psas/lv3.0-recovery/README.md

# lv3_recovery
Recovery system design and analysis.
