psas/lv3.0-recovery/LV3.1/RecoveryBoard/Recovery Board Review 1-12-2020 Notes.docx

- Drogue is nose coming off, main deploy main parachute
- Schematic symbol should always be rectangle to match the data sheet.
  - Change to more readable symbol
- Change capacitor to EU symbol (two plates), and change size
  - 0603 are big enough to use with tweezers
  - 0805 big enough for 10 uF
- Change 0603 for resistors as well. 2A at the most due to the P = I^2 *R
- Changed to double up leads for the battery to have two positives and two negatives.
- Absolute maximum input voltage for voltage divider into STM32F0 analog calculation.
- Change N-Channel MOSFET to the ground to achieve a positive GS difference
- Add connection called armed from outside world need new 7 pin.
- PullUp ~ACOK to 3.3V to check if charger is on umbilical power.
- Flip Diode Symbol in the optoisolator
- For a power supply, add a bypass cap at around 100nF for each power pin
- Add button and add ACOK.
