psas/lv3.0-recovery/Useful_Misc/Recovery_Patch.pdf

12/27/2018 | recoveryPatch.svg

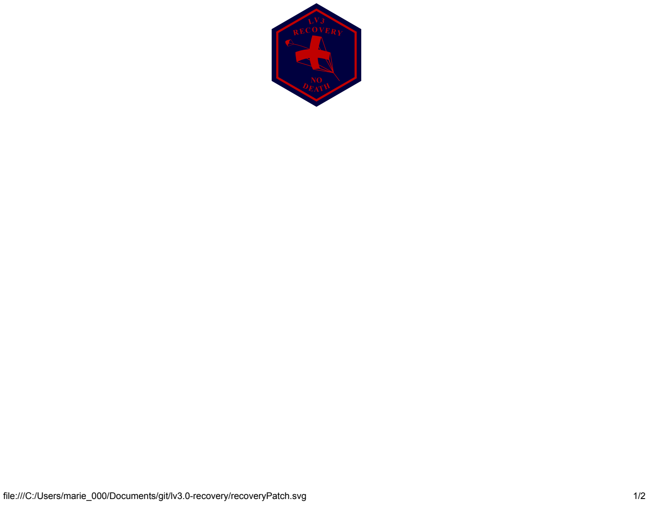
[picture p16: figure]
file:///C:/Users/marie_000/Documents/git/lv3.0-recovery/recoveryPatch.svg; LV3 RECOVERY; NO DEATH
