psas/lv3.0-recovery/Control_System/bldc-tool/res/refresh.png

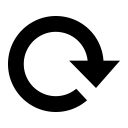
Control_System/bldc-tool/res/refresh.png
