psas/lv3.0-recovery/Initial_Designs/attachment_plate_design.jpg

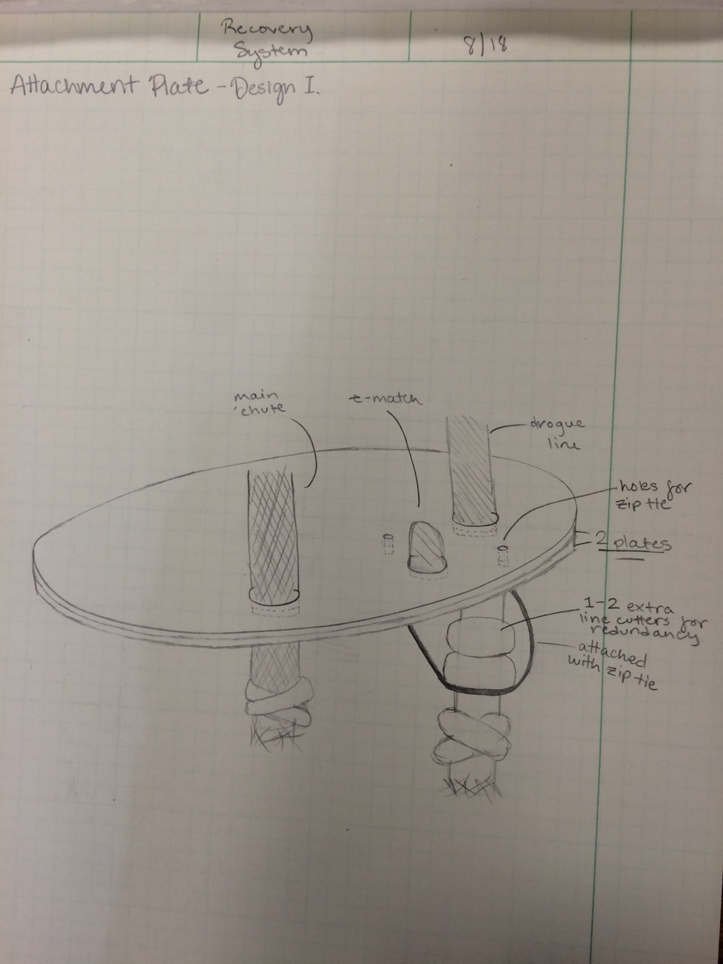
Initial_Designs/attachment_plate_design.jpg
