psas/lv3.0-recovery/Initial_Designs/initial_idea_given_info.jpg

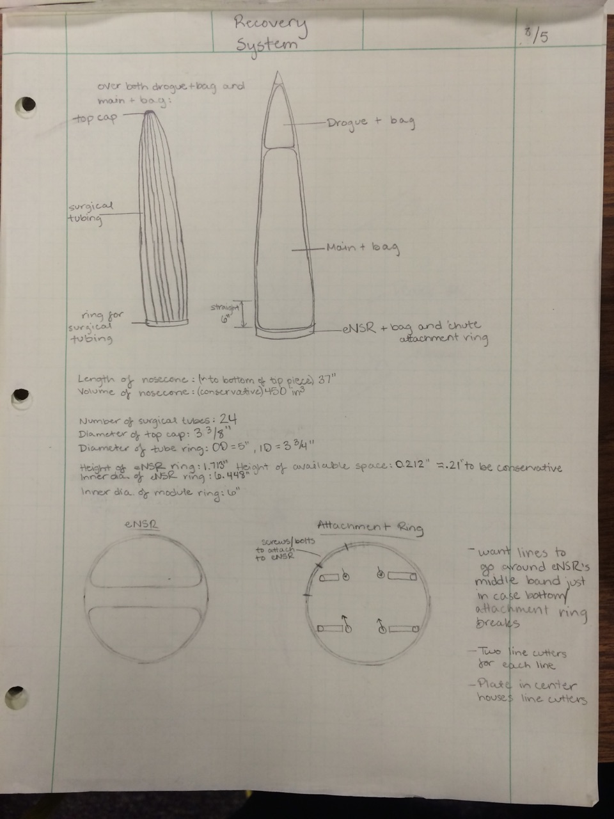
Initial_Designs/initial_idea_given_info.jpg
