psas/lv3.0-recovery/Initial_Designs/main_900.jpg

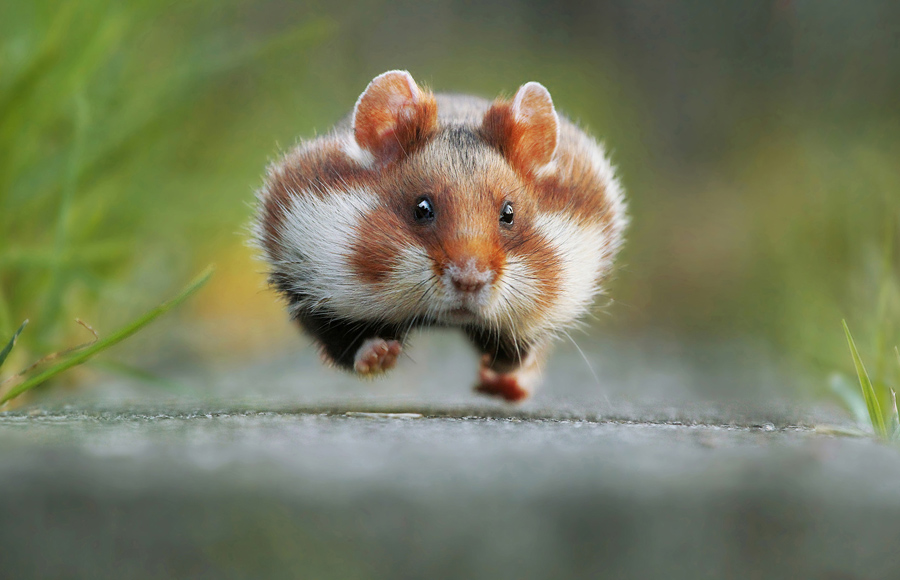
Initial_Designs/main_900.jpg
