psas/lv3.0-recovery/Line_Cutters/LV2c_Line_Cutters/LV2cLineCutters/PlugLineCutter-v2c.png

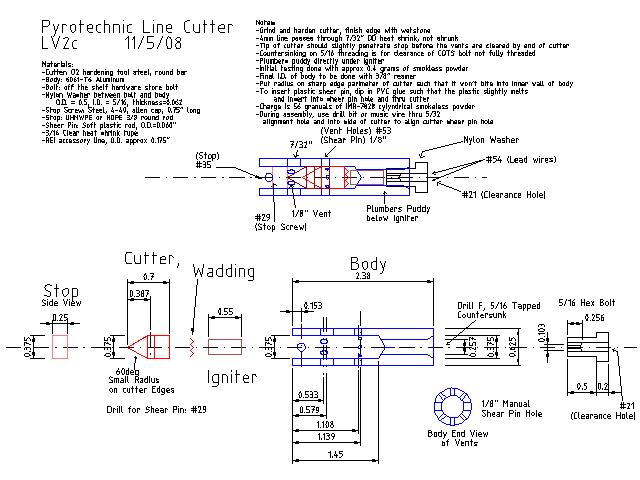
Line_Cutters/LV2c_Line_Cutters/LV2cLineCutters/PlugLineCutter-v2c.png
