psas/lv3.0-recovery/LV3.1/cad/Brainstorming/MH_Concepts/DCR_Concept1/Socket Wrench Plunger.png

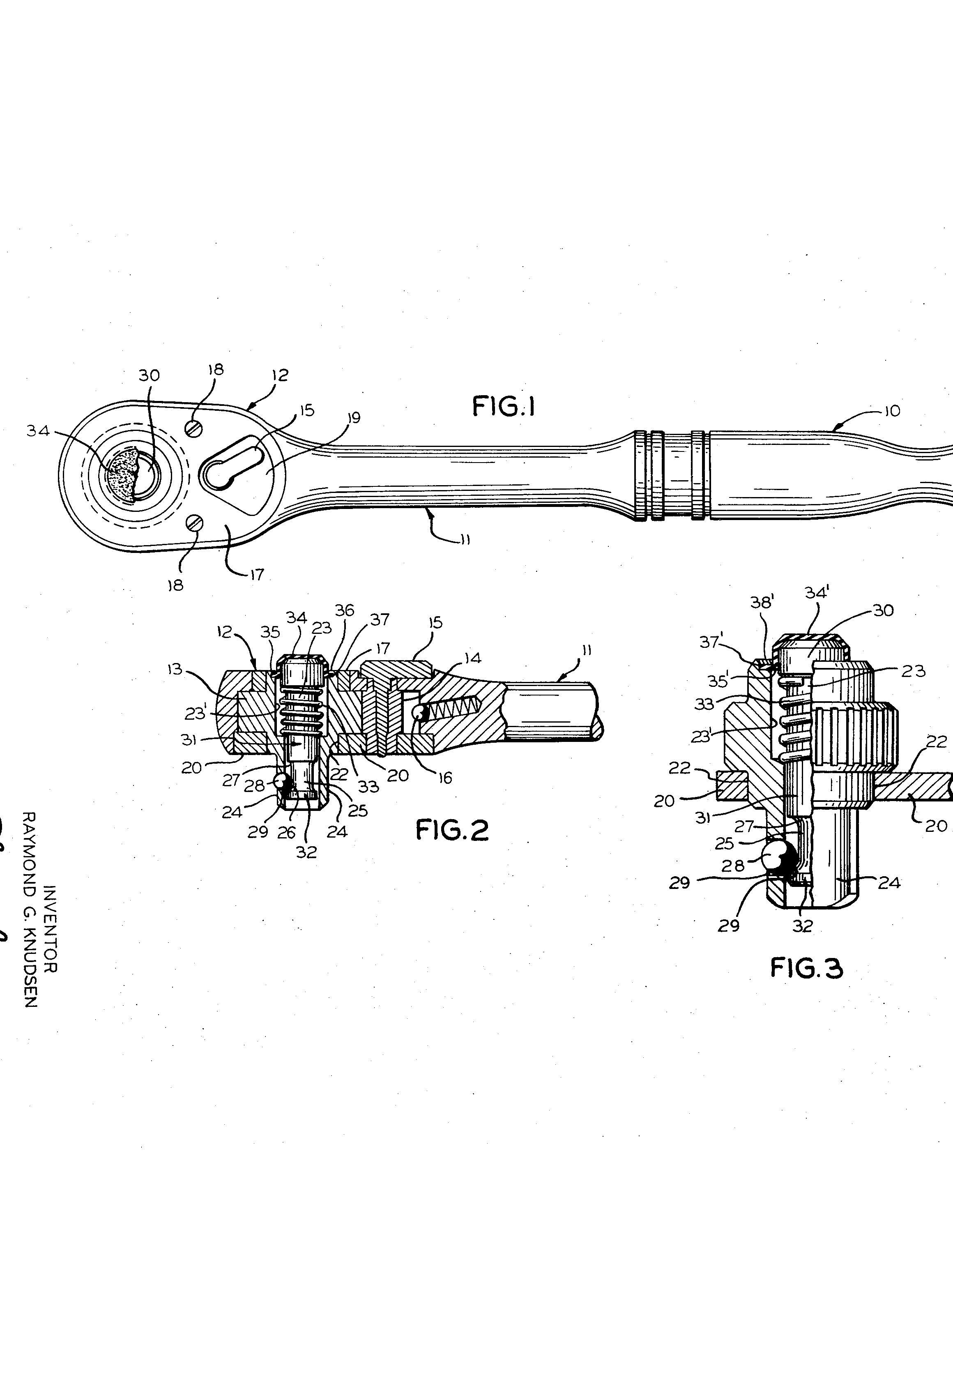
LV3.1/cad/Brainstorming/MH_Concepts/DCR_Concept1/Socket Wrench Plunger.png
