psas/lv3.0-recovery/LV3.1/DCR/Properties_tubular_webbing.png

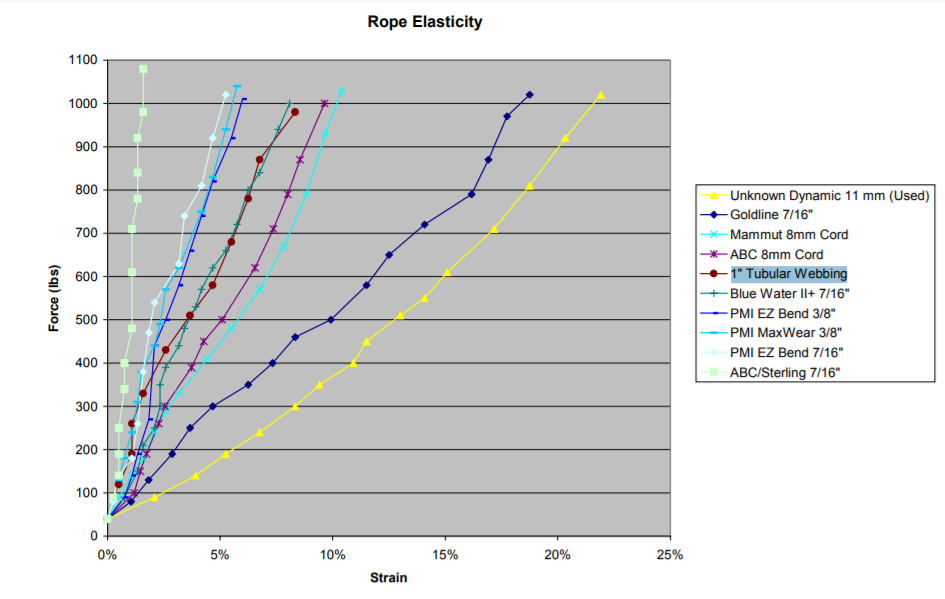
LV3.1/DCR/Properties_tubular_webbing.png
