psas/lv3.0-recovery/LV3.1/RecoveryBoard/eagle/RecoveryBoardRev1.0.png

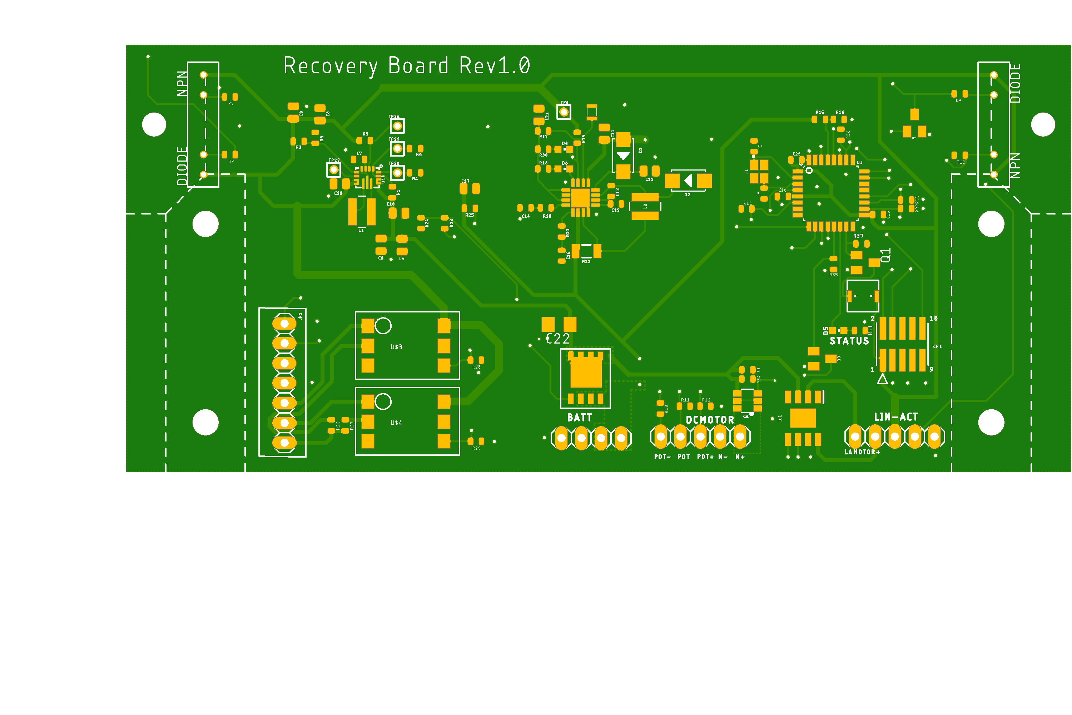
LV3.1/RecoveryBoard/eagle/RecoveryBoardRev1.0.png
