psas/lv3.0-recovery/LV3.1/RecoveryBoard/FirmWare/Recovery Board State Diagram-01.jpg

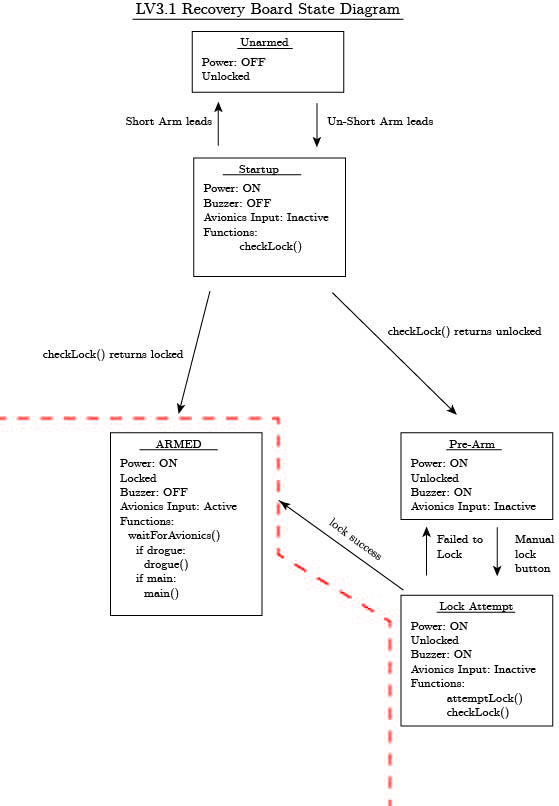
LV3.1/RecoveryBoard/FirmWare/Recovery Board State Diagram-01.jpg
