psas/lv3.0-recovery/Useful_Misc/PSAS_nosecone_volume_conservative.JPG

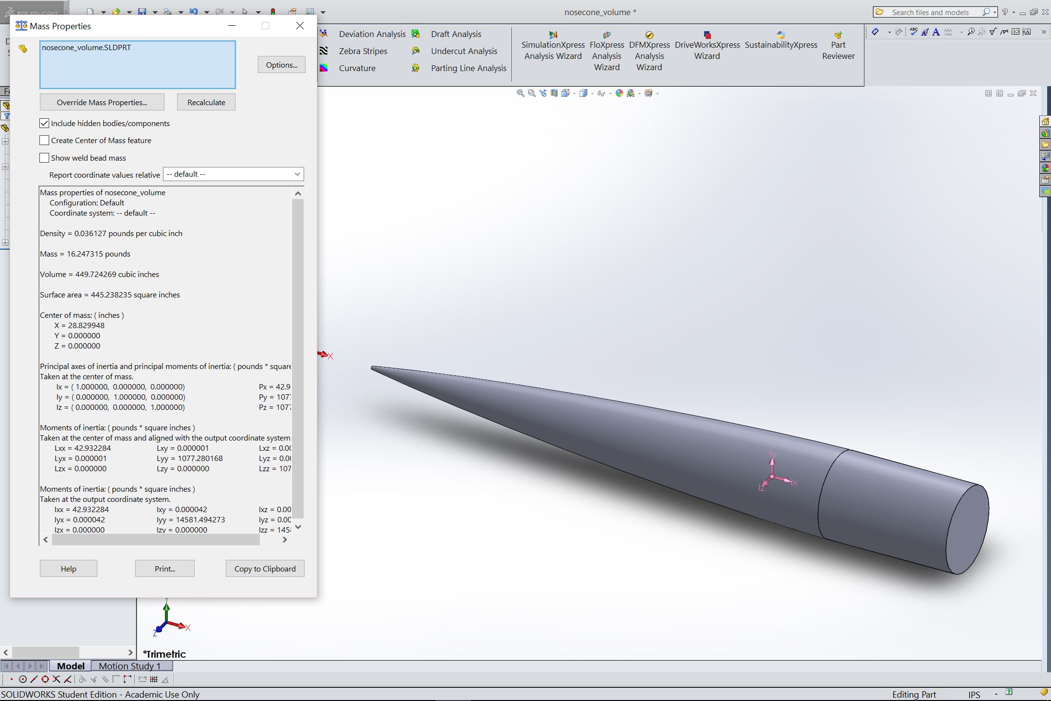
Useful_Misc/PSAS_nosecone_volume_conservative.JPG
