psas/lv3.0-recovery/LV3.1/RecoveryBoard/RecoveryBoard-BOM.xlsx

Qty | Value | Device | Package | Parts | Description | DIS | DPN | MFR | MPN
1 | 1.5uH | IHLP2020CZER1R5M11 | IHLP2020CZER1R5M11 | L1 |  | Digi-Key | 541-1235-1-ND | Vishay Dale | IHLP2020CZER1R5M11
1 |  | PINHD-1X3 | 1X03 | JP3 | PIN HEADER
1 |  | PINHD-1X4 | 1X04 | JP1 | PIN HEADER
1 |  | PINHD-1X7 | 1X07 | JP2 | PIN HEADER
1 | 1.69k | R-US_0603-C-NOSILK | .0603-C-NOSILK | R13 | RESISTOR, American symbol | Digi-Key | P1.69KHCT-ND | Panasonic | ERJ-3EKF1691V
1 | 100k | R-US_0603-C-NOSILK | .0603-C-NOSILK | R5 | RESISTOR, American symbol | Digi-Key | YAG1235CT-ND | Yageo | RT0603BRD07100KL
1 | 100m | R-US_1206-C | 1206-C | R22 | RESISTOR, American symbol | Digi-Key | CSR1206FTR100CT-ND | StackPole Electronics Inc | CSR1206FTR100
1 | 100n | C-EU0603-C-NOSILK | .0603-C-NOSILK | C7 | CAPACITOR, European symbol | Digi-Key | 1276-1258-6-ND | Samsung | CL10F104ZO8NNNC
1 | 100n | C-EU0603-C-NOSILK | .0603-C-NOSILK | C22 | CAPACITOR, European symbol | Digi-Key | 1276-1258-6-ND | Samsung | CL10F104ZO8NNNC
1 | 10u | C-EU0805-C-NOSILK | .0805-C-NOSILK | C5 | CAPACITOR, European symbol | Digi-Key | 399-4925-6-ND | KEMET | C0805C106K8PACTU
1 | 150k | R-US_0603-C-NOSILK | .0603-C-NOSILK | R3 | RESISTOR, American symbol | Digi-Key | A129714CT-ND | TE Connectivity Passive Product | CRGCQ0603F150K
1 | 2.2n | C-EU0603-C-NOSILK | .0603-C-NOSILK | C16 | CAPACITOR, European symbol | Digi-Key | 399-17586-1-ND | KEMET | C0603C222K5RAC7411
1 | 2.4k | R-US_0603-C-NOSILK | .0603-C-NOSILK | R20 | RESISTOR, American symbol | Digi-Key | P20013CT-ND | Panasonic | ERJ-PB3B2401V
1 | 22u | C-EU0805-C-NOSILK | .0805-C-NOSILK | C8 | CAPACITOR, European symbol | Digi-Key | 399-4696-2-ND | KEMET | C0805C226M9PACTU
1 | 22uF | C-EU0805-C-NOSILK | .0805-C-NOSILK | C17 | CAPACITOR, European symbol | Digi-Key | 399-4696-2-ND | KEMET | C0805C226M9PACTU
1 | 26.4k | R-US_0603-C-NOSILK | .0603-C-NOSILK | R15 | RESISTOR, American symbol | Digi-Key | 311-2092-1-ND | Yageo | RT0603DRE0726K4L
1 | 3.3k | R-US_0603-C-NOSILK | .0603-C-NOSILK | R14 | RESISTOR, American symbol | Digi-Key | A130094CT-ND | TE Connectivity Passive Product | CRGCQ0603J3K3
1 | 4.7uH | IHLP2020BZER4R7M11 | IHLP2020BZER4R7M11 | L2 |  | Digi-Key | 541-1222-1-ND | Vishay Dale | IHLP2020BZER4R7M11
1 | 470k | R-US_0805-C-NOSILK | .0805-C-NOSILK | R2 | RESISTOR, American symbol | Digi-Key | RHM470KBUCT-ND | Rohm SemiConductor | LTR10EZPJ474
1 | 750 | R-US_0603-C-NOSILK | .0603-C-NOSILK | R21 | RESISTOR, American symbol | Digi-Key | RHM750DCT-ND | Rohm SemiConductor | ESR03EZPJ751
1 | BD62120AEFJ-E2 | BD62120AEFJ-E2 | SOIC127P600X100-9N | U2 | ROHM BD62120AEFJ-E2 Motor Driver IC 8-Pin, HTSOP-J | Digi-Key | BD62120AEFJ-E2CT-ND | Rohm SemiConductor | BD62120AEFJ-E2
1 | ECS-160-10-36Q-ES-TR | ECS-160-10-36Q-ES-TR | XTAL_ECS-160-10-36Q-ES-TR | Y1 | The ECX-2236Q is a miniature SMD Crystal with a 2.5 x 2.0 mm | Digi-Key | XC2181CT-ND | ECS Inc. | ECS-160-10-36Q-ES-TR
1 | FTSH-105-XX-X-DV-K | FTSH-105-XX-X-DV-K | CON10_2X5_DUK_FTSH | CM1 | JTAG Connector | Digi-Key | SAM13164CT-ND | Samtec Inc. | FTSH-105-01-L-DV-K-P-TR
1 | MOSFET-PCH-SOT23-6 | MOSFET-PCH-SOT23-6 | SOT23-6 | Q6 | P channel MOSFET in an SOT23-6 | Digi-Key | 497-15521-2-ND | STMicroelectronics | STT4P3LLH6
1 | MP26123DR-LF-Z | MP26123DR-LF-Z | MP26123DR-LF-Z | U$5 | LiPo Charger | Digi-Key | 1589-1609-1-ND | Monolithic Power Systems Inc. | MP26123DR-LF-Z
1 | NHQ103B375T10 | NHQ103B375T10 | NHQ103B375T10 | U$6 | Thermistor | Digi-Key | 235-1109-1-ND | Amphenol Advanced Sensors | NHQ103B375T10
1 | SI7465DP | SI7465DP | SI7465DP | U$8 | Power MOSFET PCh | Digi-Key | SI7465DP-T1-E3CT-ND | Vishay Siliconix | SI7465DP-T1-E3
1 | SML-D12U1WT86 | LEDCHIPLED_0603 | CHIPLED_0603 | D5 | LED | Digi-key | SML-D12U1WT86CT-ND | Rohm SemiConductor | SML-D12U1WT86
1 | SMT-0440-S-R | SMT-0440-S-R | SMT-0440-S-R | U$7 | Buzzer | Digi-Key | 668-1488-1-ND | PUI Audio Inc. | SMT-0440-S-R
1 | STM32F042K6 | STM32F042K6 | QFP32-7X7 | U1 | MCU | Digi-Key | 497-14647-ND | STMicroelectronics | STM32F042K6T6
1 | TPS63070 | TPS63070X | TPS63070X | U10 | TPS63070 2-V to 16-V Buck-Boost Converter With 3.6-A Switch Current | Digi-Key | 296-TPS630702RNMTCT-ND | Texas Instruments | TPS630702RNMT
2 |  | PINHD-1X5 | 1X05 | J1, J2 | PIN HEADER
2 | 1N4007 | DIODE-SCHOTTKY-(DO-214AC) | DO-214AC | D1, D2 | 304010013 | Digi-Key | S1M-FDITR-ND | Diodes Incorporated | S1M-13-F
2 | 20p | C-EU0603-C-NOSILK | .0603-C-NOSILK | C3, C4 | CAPACITOR, European symbol | Digi-Key | 399-8033-2-ND | KEMET | C0805C200J5GACTU
2 | 22u | C-EU0805-C-NOSILK | .0805-C-NOSILK | C9, C28 | CAPACITOR, European symbol | Digi-Key | 399-4696-2-ND | KEMET | C0805C226M9PACTU
2 | 442 | R-US_0603-C-NOSILK | .0603-C-NOSILK | R8, R9 | RESISTOR, American symbol | Digi-Key | 311-442HRCT-ND | Yageo | RC0603FR-07442RL
2 | 51.1 | R-US_0603-C-NOSILK | .0603-C-NOSILK | R26, R27 | RESISTOR, American symbol | Digi-Key | 311-51.1HRTR-ND | Yageo | RC0603FR-0751R1L
2 | BPR-301 | BPR-301 | BPR-301 | Q4, Q5 | Phototransistors | Digi-Key | BPR-301-ND | American Bright Optoelectronics Corporation | BPR-301
2 | H11F1SR2M | H11F1SR2M | H11F1SR2M | U$3, U$4 | OptoIsolators | Digi-Key | H11F1SR2MCT-ND | ON Semiconductor | H11F1SR2M
1 | NP | R-US_0603-C-NOSILK | .0603-C-NOSILK | R6 | RESISTOR, American symbol
2 | SML-D12U1WT86 | LEDCHIPLED_0603 | CHIPLED_0603 | D3, D6 | LED | Digi-Key | SML-D12U1WT86CT-ND | Rohm SemiConductor | SML-D12U1WT86
3 | 10k | R-US_0603-C-NOSILK | .0603-C-NOSILK | R1, R4, R16 | RESISTOR, American symbol | Digi-Key | 311-10KGRCT-ND | Yageo | RC0603JR-0710KL
3 | BSS123 | BSS123 | SOT23 | Q1, Q2, Q3 | N-CHANNEL MOS FET | Digi-Key | BSS123NCT-ND | ON Semiconductor | BSS123
5 | 10u | C-EU0805-C-NOSILK | .0805-C-NOSILK | C6, C10, C11, C12, C21 | CAPACITOR, European symbol | Digi-Key | 399-4925-6-ND | KEMET | C0805C106K8PACTU
7 | 100n | C-EU0603-C-NOSILK | .0603-C-NOSILK | C1, C13, C14, C15, C18, C19, C20 | CAPACITOR, European symbol | Digi-Key | 1276-1258-6-ND | Samsung | CL10F104ZO8NNNC
7 | 1k | R-US_0603-C-NOSILK | .0603-C-NOSILK | R11, R12, R18, R23, R25, R30, R31 | RESISTOR, American symbol | Digi-Key | 311-1.0KGRCT-ND | Yageo | RC0603JR-071KL
9 | TEST-POINT | TEST-POINT | 2MM-TEST-POINT | TP1, TP2, TP3, TP4, TP6, TP26, TP27, TP28, TP29 | Test Points
13 | 10k | R-US_0603-C-NOSILK | .0603-C-NOSILK | R7, R10, R17, R19, R24, R28, R29, R32, R33, R34, R35, R36, R37 | RESISTOR, American symbol | Digi-Key | 311-10KGRCT-ND | Yageo | RC0603JR-0710KL
 | REVISIONS | REV DESCRIPTION
