psas/lv3.0-recovery/LV3.1/cad/AssemblyV3.2/keeper_assy_V3.SLDASM

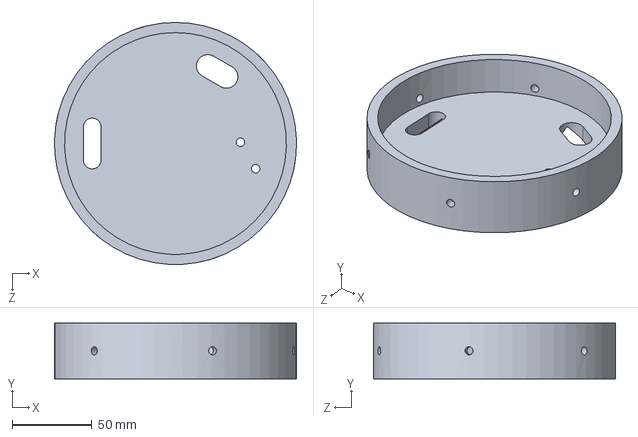
[picture p27: CAD file, 2019-12-07]
LV3.1/cad/AssemblyV3.2/keeper_assy_V3.SLDASM
151.3 x 34.9 x 151.4 mm
