psas/lv3.0-recovery/LV3.1/cad/Base_11_mockup/nose.SLDASM

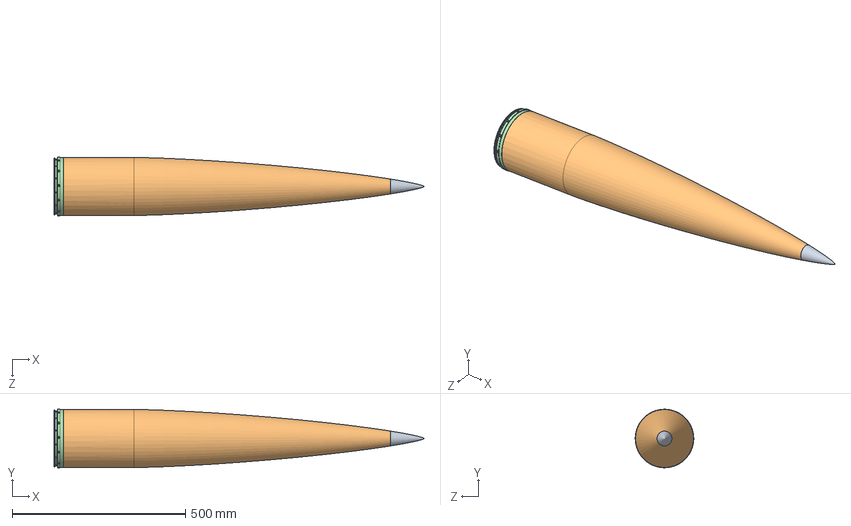
[picture p28: CAD file, 2019-04-27]
LV3.1/cad/Base_11_mockup/nose.SLDASM
1067.2 x 168.9 x 168.9 mm
von_karmon_nose_tip2
noseconeShell
nosePlug2
moduleRing
