psas/lv3.0-recovery/LV3.1/cad/Brainstorming/GG_Concept1/Assem1.SLDASM

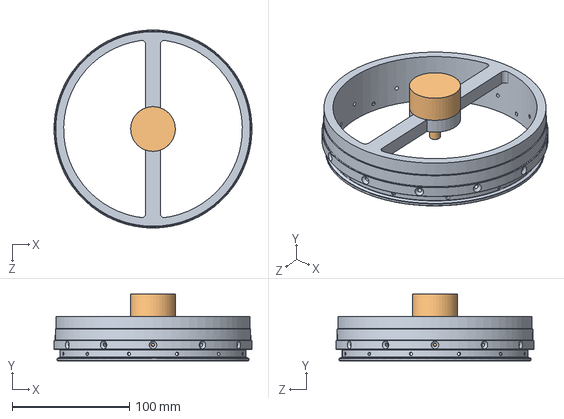
[picture p29: CAD file, 2019-02-19]
LV3.1/cad/Brainstorming/GG_Concept1/Assem1.SLDASM
168.9 x 56.7 x 168.9 mm
Concept_Upper
pretend_motor
