psas/lv3.0-recovery/LV3.1/cad/Brainstorming/GG_Concept2/Concept_Assem_2.SLDASM

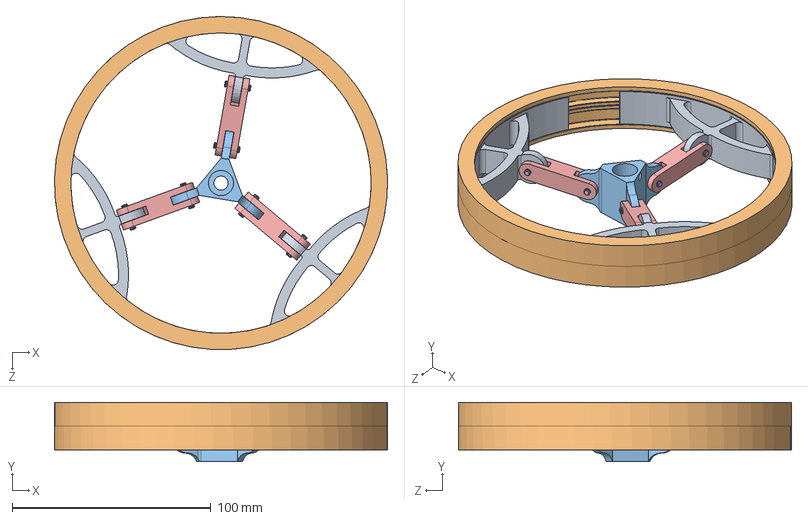
[picture p30: CAD file, 2019-02-19]
LV3.1/cad/Brainstorming/GG_Concept2/Concept_Assem_2.SLDASM
167.6 x 29.9 x 167.6 mm
Clamp_Ring_Concept x 3
Ring_Concept x 2
Carriage
Bearing_RMA x 6
Linkage x 3
Dowell_Pin_1 x 6
