psas/lv3.0-recovery/LV3.1/cad/Brainstorming/GW_Concepts/proto_assemb.SLDASM

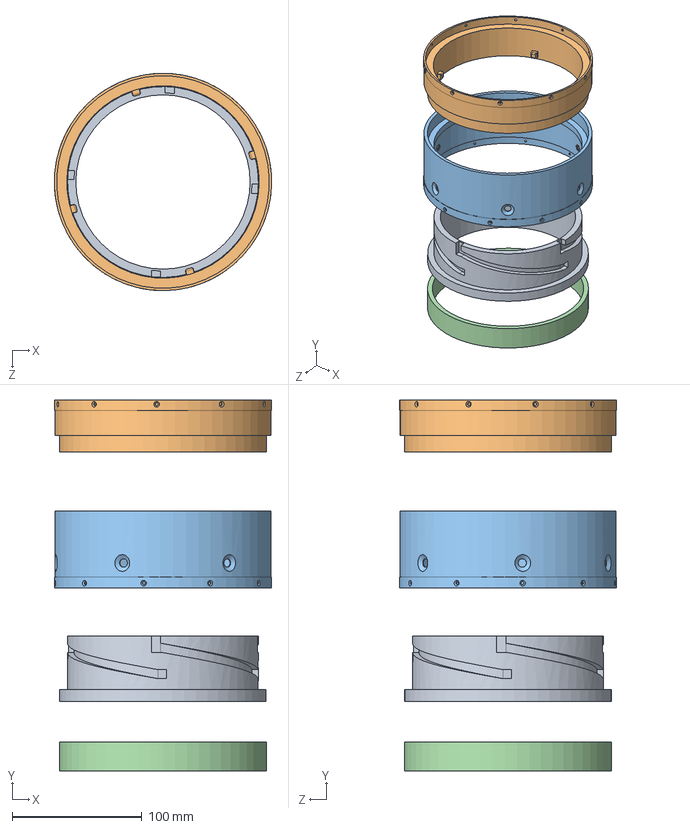
[picture p31: CAD file, 2019-04-04]
LV3.1/cad/Brainstorming/GW_Concepts/proto_assemb.SLDASM
167.6 x 286.1 x 167.6 mm
twist_coupling
Bottom_ring
Top_ring
kepper ring
