psas/lv3.0-recovery/LV3.1/cad/Brainstorming/ST_CAP/ST_CAP_ASSEMBLY.SLDASM

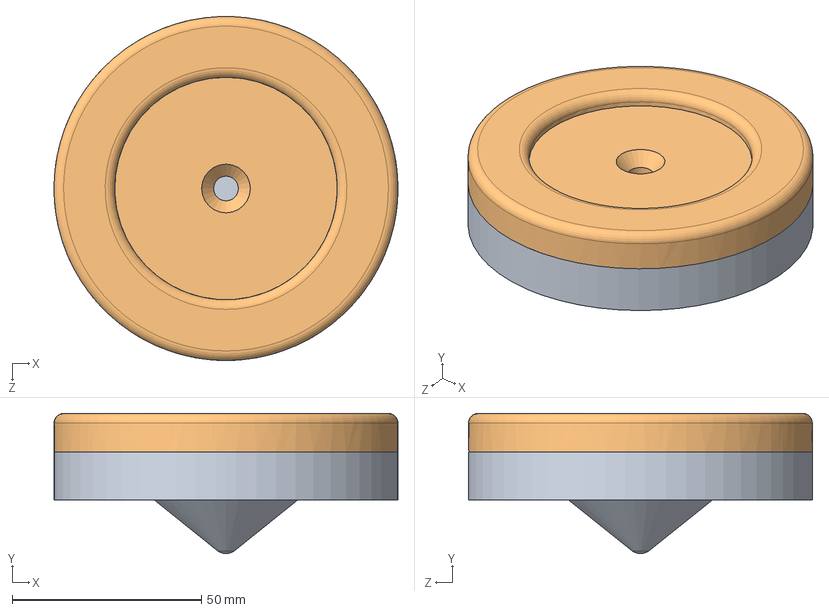
[picture p32: CAD file, 2019-05-19]
LV3.1/cad/Brainstorming/ST_CAP/ST_CAP_ASSEMBLY.SLDASM
90.9 x 37.0 x 90.9 mm
ST_Bottom
ST_Cap
