psas/lv3.0-recovery/LV3.1/cad/Parachute_Cups/ERS_Parachute_System/Cylinder_Chute_Main^ERS_v3.0.SLDPRT

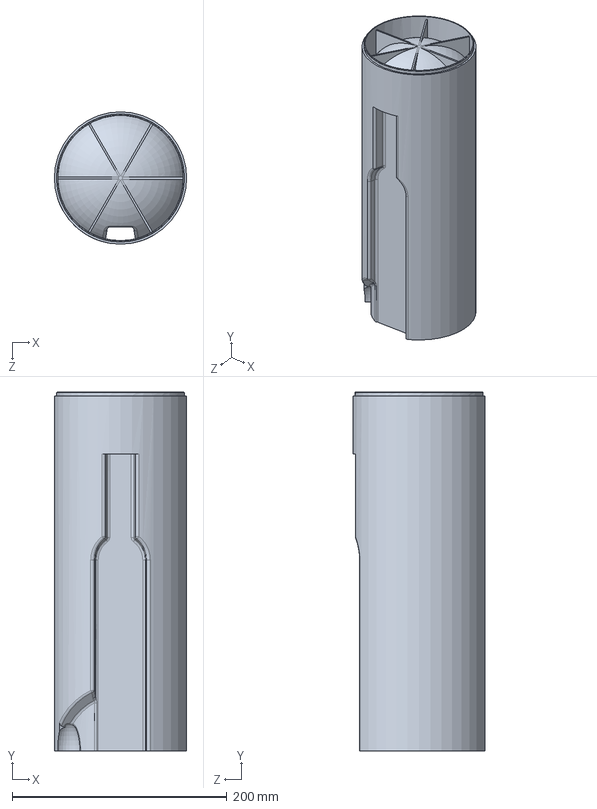
[picture p33: CAD file, 2019-08-06]
LV3.1/cad/Parachute_Cups/ERS_Parachute_System/Cylinder_Chute_Main^ERS_v3.0.SLDPRT
123.2 x 334.0 x 123.2 mm
