psas/lv3.0-recovery/LV3.1/cad/AssemblyV3.2/Assem3.2rev1.SLDASM

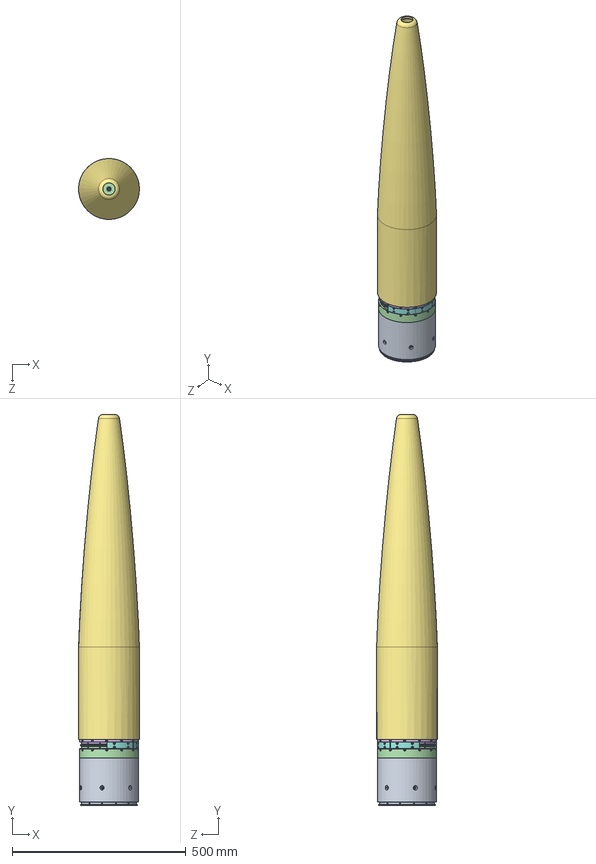
[picture p34: CAD file, 2019-12-07]
LV3.1/cad/AssemblyV3.2/Assem3.2rev1.SLDASM
175.3 x 1124.8 x 175.1 mm
keeper_ring_V3
clampArc x 3
battery
H3860S_NO3_Ring
H3880S_NO4_Ring
webbing_small_V1
yellow_cord_V1.1
nylon_loop_V1
webbing_grommet_V1
grommet_V1
yellow_cord_guide x 2
H3840B_NO2_Ring
yellow_cord_short
yellow_twist
MotorHousingClamshellrev1
MotorHousingMain_rev1
BLDC_Gear_Motor_100rpm
PIZZA_v4.2
twist_coupling_V4_skirt_teeth
pcb
sensor x 2
2662N400_PLASTIC GEAR - 20 DEGREE PRESSURE ANGLE
