psas/lv3.0-recovery/LV3.1/cad/Base_11_mockup/Current_NCSR.SLDASM

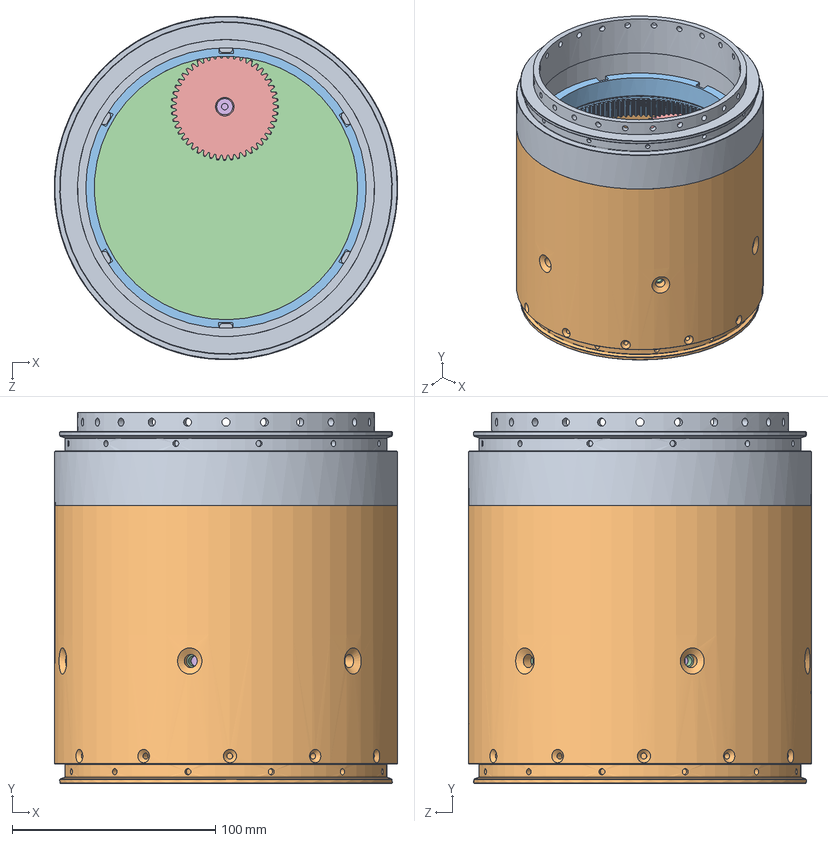
[picture p35: CAD file, 2019-04-05]
LV3.1/cad/Base_11_mockup/Current_NCSR.SLDASM
168.9 x 182.5 x 168.9 mm
Bottom_ring
Top_ring
twist_coupling
kepper ring
7880K450_HT-LOAD MTL GEAR--20 DEG PRESSURE ANGLE
Motor1_small
