psas/lv3.0-recovery/LV3.1/cad/Brainstorming/GG_Concept1/Concept_Ring.SLDASM

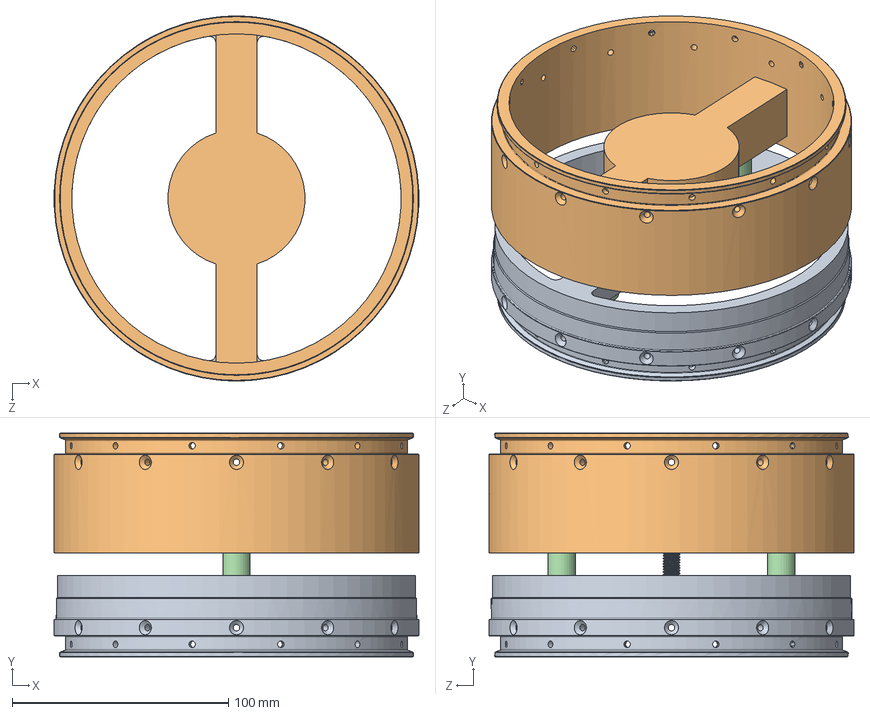
[picture p36: CAD file, 2019-02-19]
LV3.1/cad/Brainstorming/GG_Concept1/Concept_Ring.SLDASM
168.9 x 103.5 x 168.9 mm
Concept_Upper
Concept_Lower
pretend_motor
Alignment_Pins x 2
