psas/lv3.0-recovery/LV3.1/cad/Brainstorming/GG_WIP/Upper_Ring_Carriage_Clamps.SLDASM

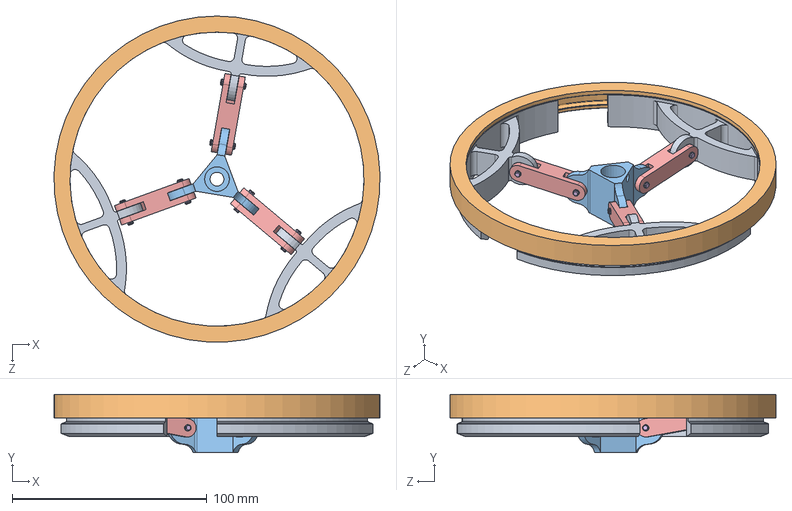
[picture p37: CAD file, 2019-02-19]
LV3.1/cad/Brainstorming/GG_WIP/Upper_Ring_Carriage_Clamps.SLDASM
167.6 x 29.9 x 167.5 mm
Clamp_Ring_Concept x 3
Ring_Concept
Carriage
Bearing_RMA x 6
Linkage x 3
Dowell_Pin_1 x 6
