psas/lv3.0-recovery/LV3.1/cad/Brainstorming/MH_Concepts/DCR_Concept2/Thesis1_assy.SLDASM

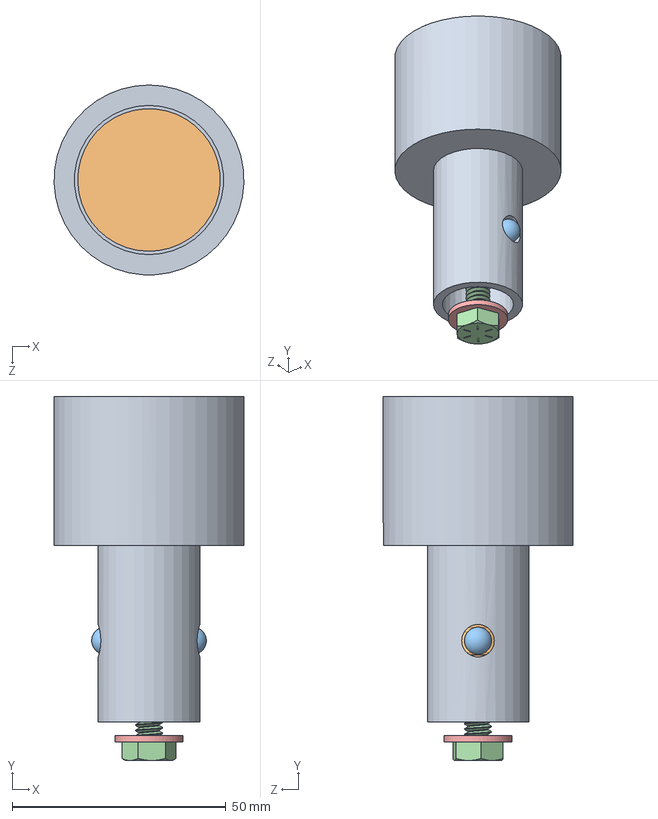
[picture p38: CAD file, 2019-02-26]
LV3.1/cad/Brainstorming/MH_Concepts/DCR_Concept2/Thesis1_assy.SLDASM
44.4 x 85.2 x 44.5 mm
Thesis1_housing
Thesis1_plunger
ball_bearing_.25 x 2
92620A540_HIGH-STRENGTH GRADE 8 STEEL CAP SCREW
92141A029_TYPE 18-8 STAINLESS STEEL FLAT WASHER
