psas/lv3.0-recovery/LV3.1/cad/Brainstorming/MH_Concepts/SMA_Protos/Proto1.SLDASM

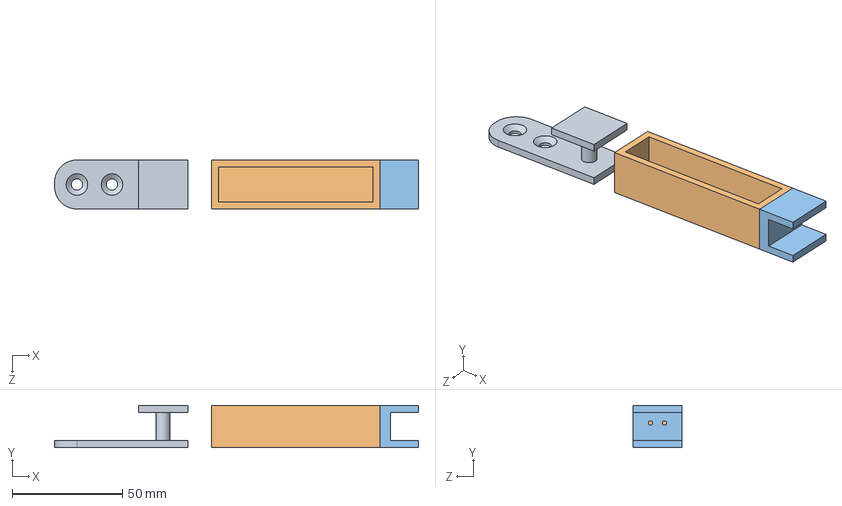
[picture p39: CAD file, 2019-02-19]
LV3.1/cad/Brainstorming/MH_Concepts/SMA_Protos/Proto1.SLDASM
164.8 x 19.1 x 22.2 mm
Proto1_anchor
Proto1_base
Proto1_clip
