psas/lv3.0-recovery/LV3.1/cad/circuitboard/pcbassy.SLDASM

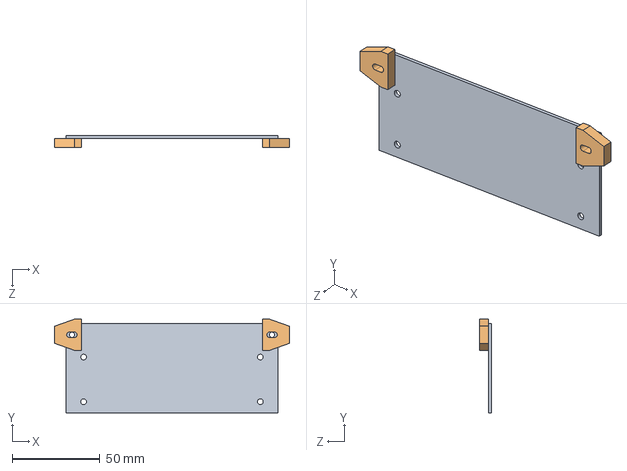
[picture p40: CAD file, 2019-12-07]
LV3.1/cad/circuitboard/pcbassy.SLDASM
133.7 x 53.4 x 6.60 mm
pcb
sensor x 2
