psas/lv3.0-recovery/LV3.1/cad/for3dprinting/STEPfiles/MotorHousingMain.STEP

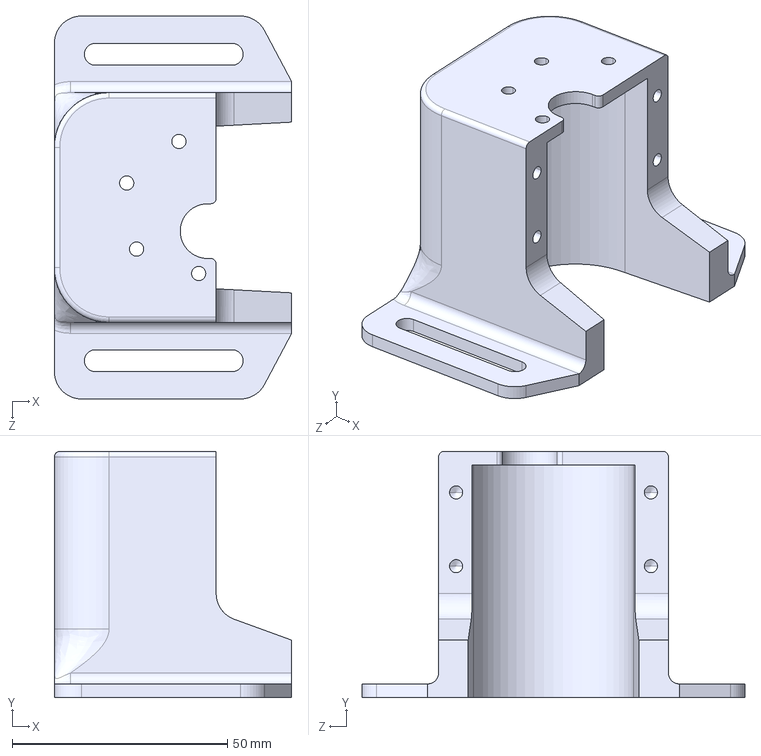
[picture p41: CAD file, 2019-11-19]
LV3.1/cad/for3dprinting/STEPfiles/MotorHousingMain.STEP
55.1 x 57.1 x 88.9 mm
