psas/lv3.0-recovery/LV3.1/cad/Brainstorming/GG_WIP/Complete_Assembly.SLDASM

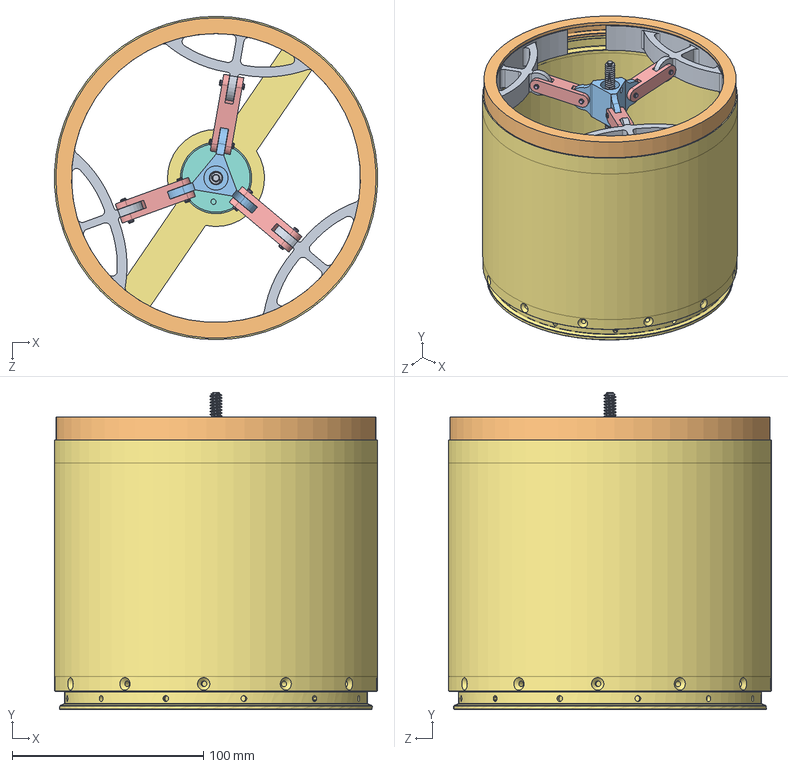
[picture p42: CAD file, 2019-02-19]
LV3.1/cad/Brainstorming/GG_WIP/Complete_Assembly.SLDASM
169.0 x 166.0 x 169.2 mm
Clamp_Ring_Concept x 3
Carriage
Bearing_RMA x 6
Linkage x 3
Dowell_Pin_1 x 6
Lower_Ring
Motor1_small
ACME_Screw
0.125_0.5_Coupler
97705A142 x 2
