psas/lv3.0-recovery/LV3.1/cad/Brainstorming/GW_Concepts/proto for capstone.SLDASM

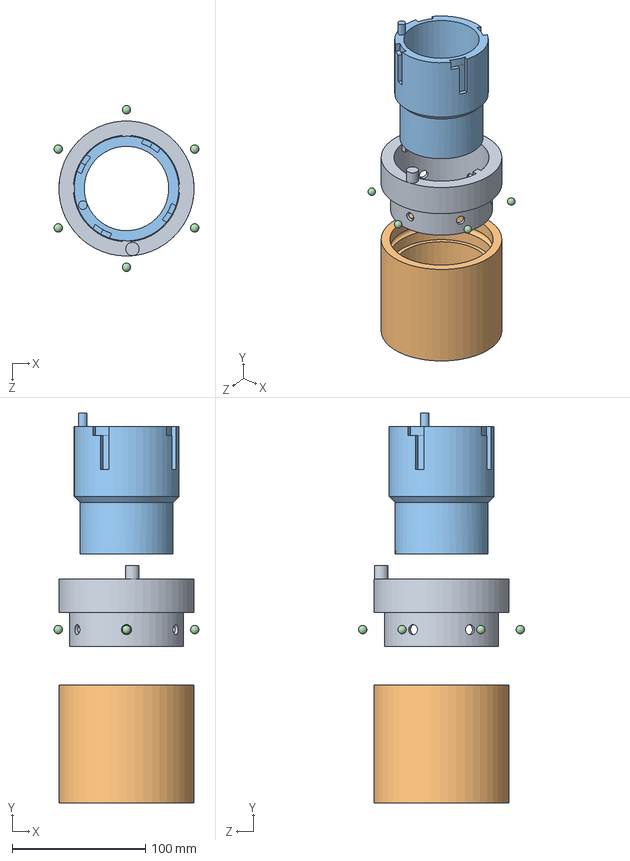
[picture p43: CAD file, 2019-04-04]
LV3.1/cad/Brainstorming/GW_Concepts/proto for capstone.SLDASM
109.0 x 293.2 x 124.8 mm
inner ring Rocket Shute deployment
outer ring rocket shute deployment
keeper ring2
ball baring x 6
