psas/lv3.0-recovery/LV3.1/cad/Brainstorming/MH_Concepts/DCR_Concept1/Thesis0_assy.SLDASM

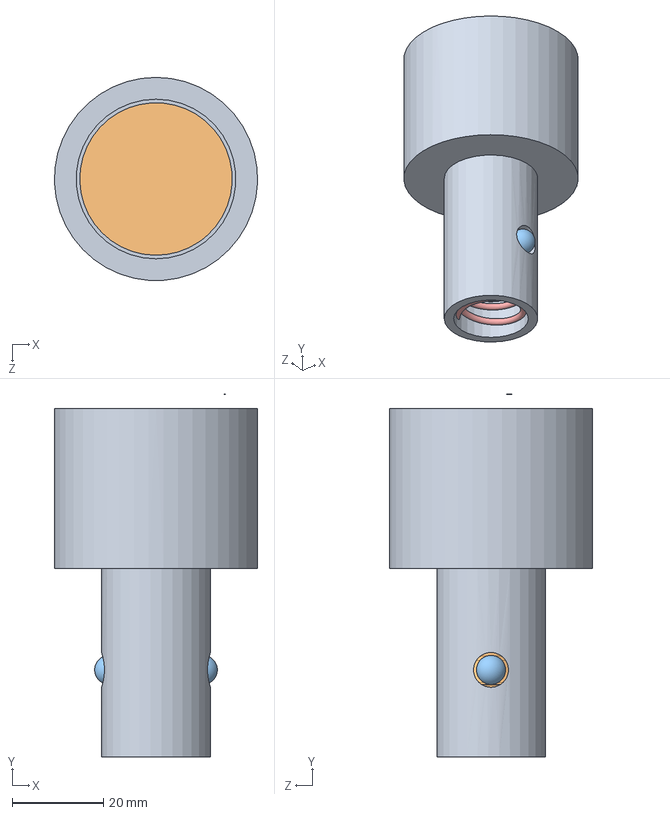
[picture p44: CAD file, 2019-03-17]
LV3.1/cad/Brainstorming/MH_Concepts/DCR_Concept1/Thesis0_assy.SLDASM
44.4 x 79.4 x 44.5 mm
Thesis1_housing
Thesis1_plunger
ball_bearing_.25 x 2
9657K528_COMPRESSION SPRING
9434K154_MUSIC-WIRE STEEL COMPRESSION SPRINGS
