psas/lv3.0-recovery/LV3.1/cad/NCR_V3/NCS_V3.SLDASM

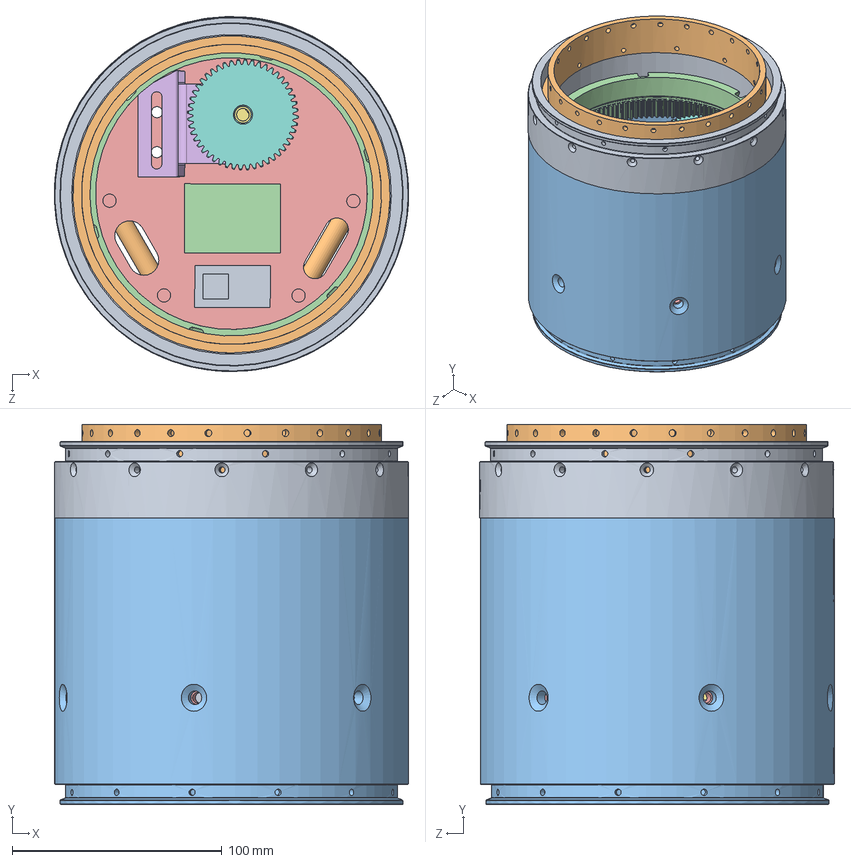
[picture p45: CAD file, 2019-05-19]
LV3.1/cad/NCR_V3/NCS_V3.SLDASM
168.9 x 181.2 x 169.3 mm
upper_ring_V3
lower_ring_V3
twist_coupling_V3
keeper_ring_V3
motor_bracket_sheetmetal_V3
BLDC_Gear_Motor_100rpm
7880K450_HT-LOAD MTL GEAR--20 DEG PRESSURE ANGLE
Linear_actuator
anchor_rod x 2
battery
electronics
pan cross head_ai x 4
