psas/lv3.0-recovery/LV3.1/cad/Parachute_Cups/ERS_Parachute_System/Assem_Parachute_Cups.SLDASM

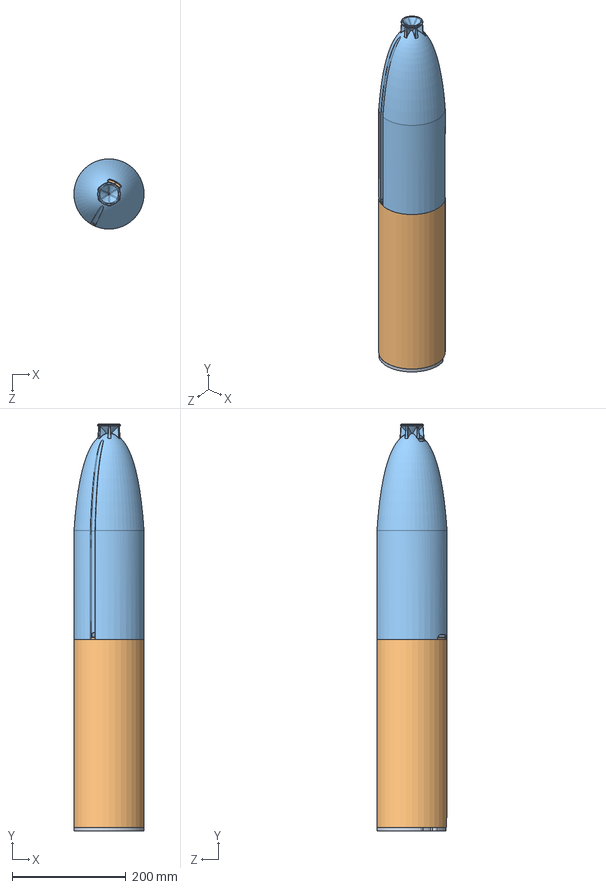
[picture p46: CAD file, 2019-08-06]
LV3.1/cad/Parachute_Cups/ERS_Parachute_System/Assem_Parachute_Cups.SLDASM
123.2 x 714.4 x 123.2 mm
PIZZA_v4.0
Cylinder_Chute_Main^ERS_v3.0
Cup_Chute_Drogue^ERS_v3.0
