psas/lv3.0-recovery/LV3.1/cad/AssemblyV3.2/Assem3.2.SLDASM

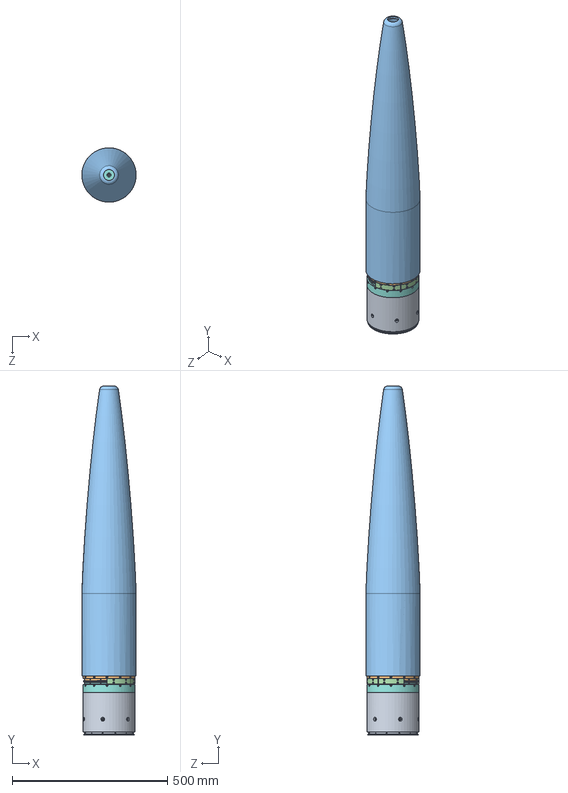
[picture p47: CAD file, 2019-12-06]
LV3.1/cad/AssemblyV3.2/Assem3.2.SLDASM
175.3 x 1124.8 x 175.1 mm
keeper_ring_V3
motor_bracket_sheetmetal_V3
BLDC_Gear_Motor_100rpm
7880K450_HT-LOAD MTL GEAR--20 DEG PRESSURE ANGLE
Linear_actuator
upper_ring_V3
clampArc x 3
battery
LinAct_Bracket_Back
LinAct_Bracket_Front
H3860S_NO3_Ring
H3880S_NO4_Ring
webbing_small_V1
yellow_cord_V1.1
nylon_loop_V1
webbing_grommet_V1
grommet_V1
yellow_cord_guide x 2
H3840B_NO2_Ring
ShockCordMain
yellow_cord_short
yellow_twist
