psas/lv3.0-recovery/LV3.1/cad/Base_11_mockup/Base11_NCSR.SLDASM

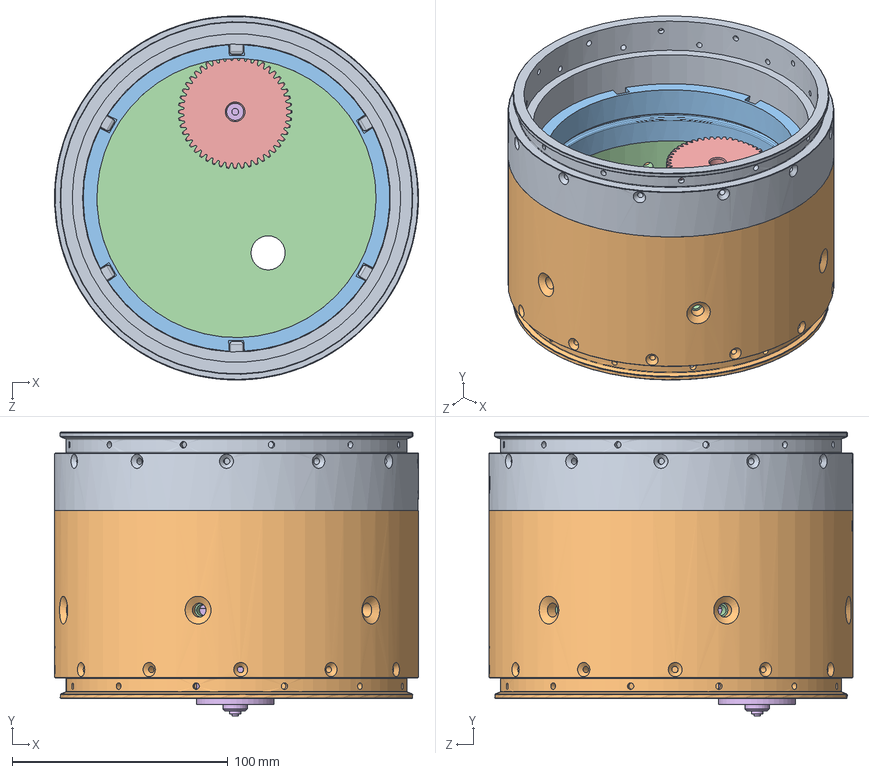
[picture p48: CAD file, 2019-04-05]
LV3.1/cad/Base_11_mockup/Base11_NCSR.SLDASM
168.9 x 131.6 x 168.9 mm
Bottom_ring
Top_ring
twist_coupling
kepper ring - Base 11
7880K450_HT-LOAD MTL GEAR--20 DEG PRESSURE ANGLE
Motor1_small
