psas/lv3.0-recovery/LV3.1/cad/Brainstorming/MH_Concepts/DCR_Concept5/Thesis4_assy.1.SLDASM

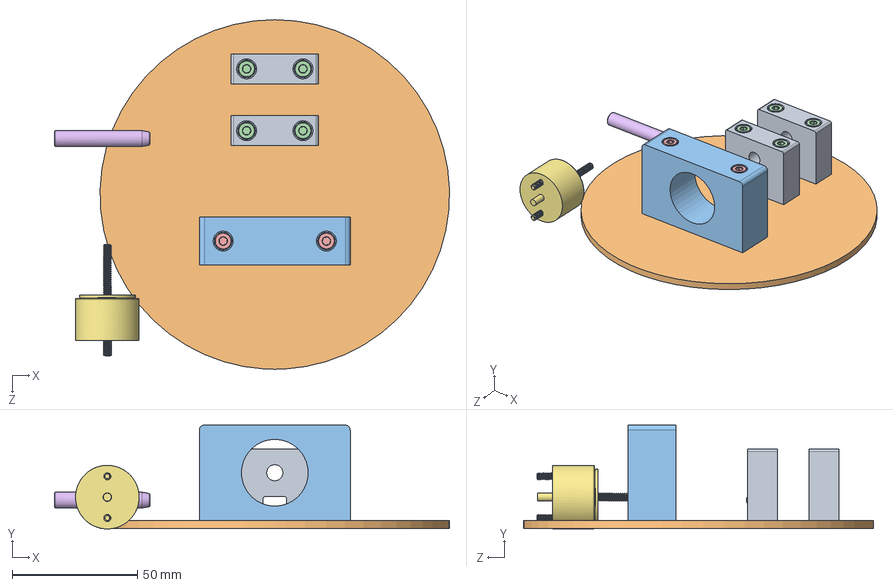
[picture p49: CAD file, 2019-02-26]
LV3.1/cad/Brainstorming/MH_Concepts/DCR_Concept5/Thesis4_assy.1.SLDASM
157.8 x 41.5 x 139.7 mm
Thesis4_pin_block.1 x 2
Thesis4_base_plate
Thesis4_solenoid_housing.1
91292A122_TYPE 18-8 SS SOCKET HEAD CAP SCREW x 4
91292A130_TYPE 18-8 SS SOCKET HEAD CAP SCREW x 2
97175A318_STANDARD PULL-OUT DOWEL PIN
6873K110_COMPACT LINEAR SOLENOID
