psas/lv3.0-recovery/LV3.1/cad/Brainstorming/GG_WIP/Lower_Ring_REF_Assem.SLDASM

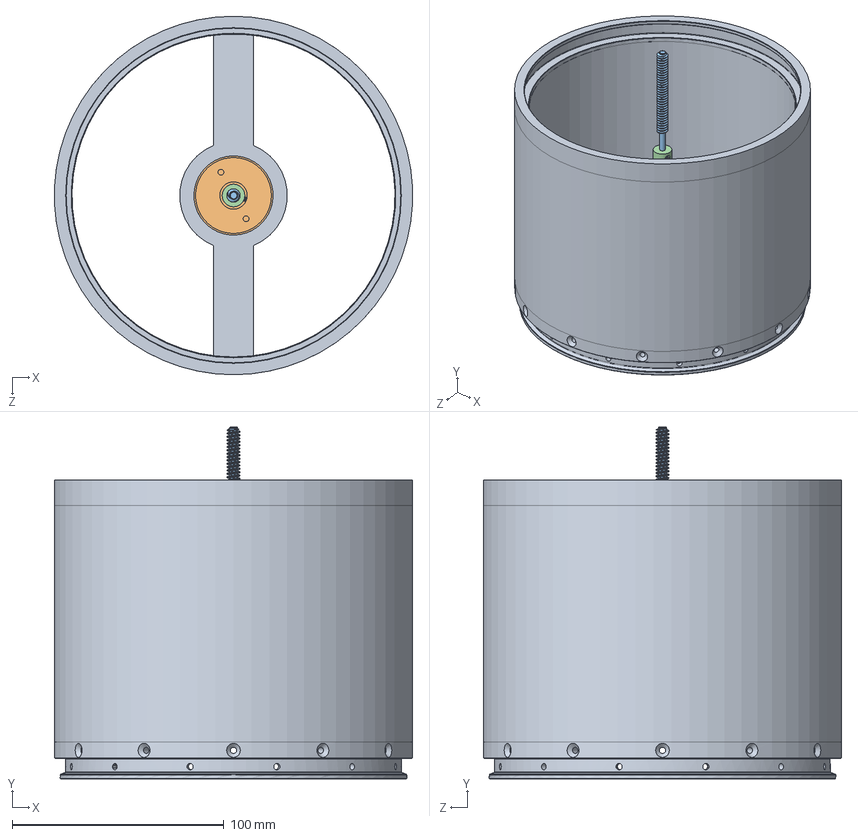
[picture p50: CAD file, 2019-02-19]
LV3.1/cad/Brainstorming/GG_WIP/Lower_Ring_REF_Assem.SLDASM
168.9 x 166.0 x 169.2 mm
Lower_Ring
Motor1_small
ACME_Screw
0.125_0.5_Coupler
97705A142 x 2
