psas/lv3.0-recovery/LV3.1/cad/Brainstorming/MH_Concepts/DCR_Concept3/Thesis2_assy.SLDASM

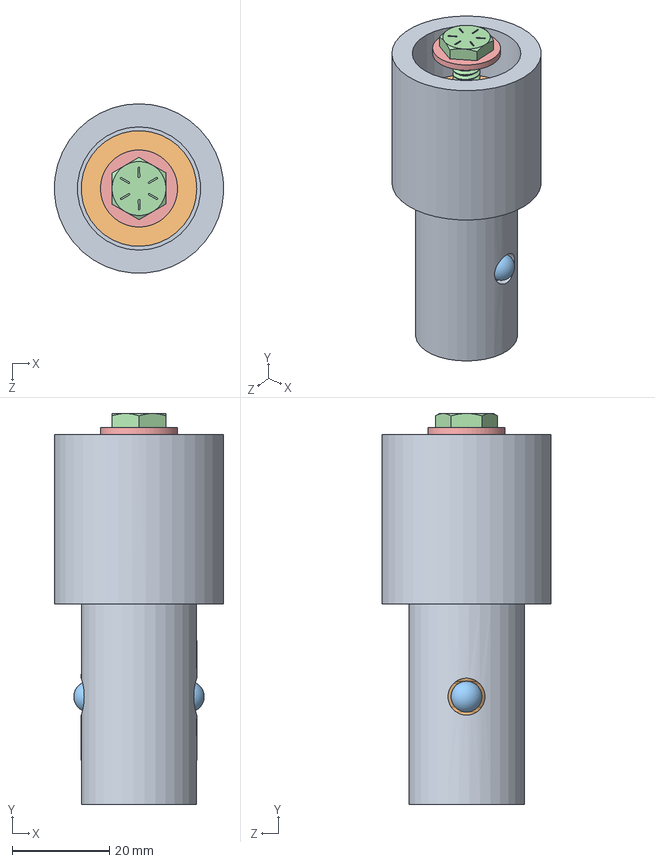
[picture p51: CAD file, 2019-02-26]
LV3.1/cad/Brainstorming/MH_Concepts/DCR_Concept3/Thesis2_assy.SLDASM
34.9 x 80.6 x 34.9 mm
Thesis2_housing
Thesis2_plunger
ball_bearing_.25 x 2
92620A540_HIGH-STRENGTH GRADE 8 STEEL CAP SCREW
92141A029_TYPE 18-8 STAINLESS STEEL FLAT WASHER
