psas/lv3.0-recovery/LV3.1/cad/for3dprinting/MotorHousingMain_rev1.SLDPRT

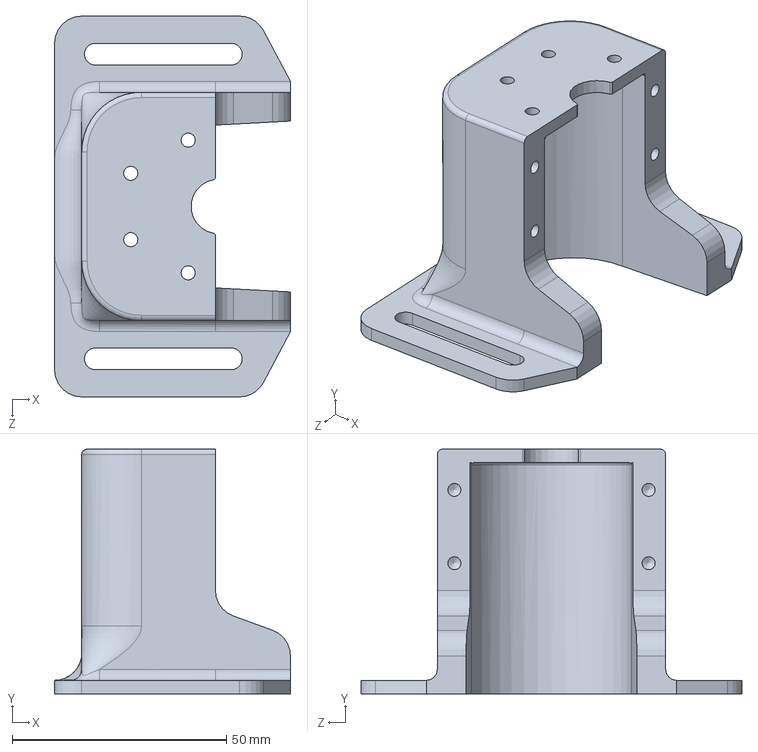
[picture p52: CAD file, 2019-12-06]
LV3.1/cad/for3dprinting/MotorHousingMain_rev1.SLDPRT
55.1 x 57.1 x 88.9 mm
