psas/lv3.0-recovery/LV3.1/cad/Parachute_Cups/Cylinder_Chute_Main^eNSR_v2.2.SLDPRT

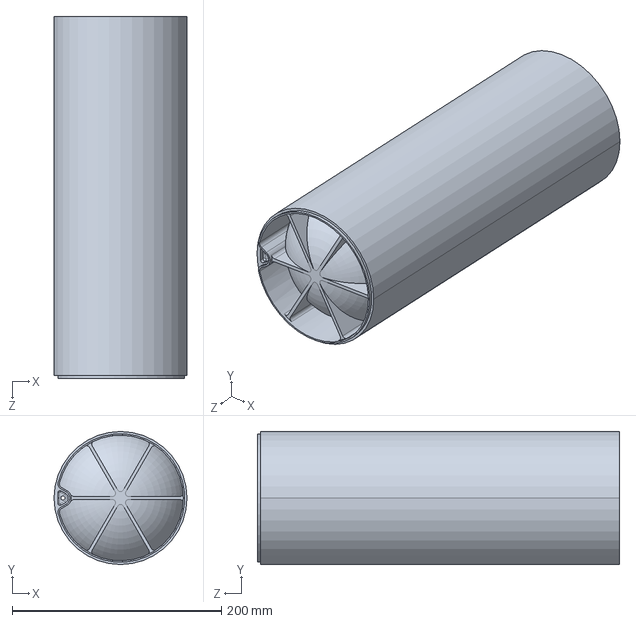
[picture p53: CAD file, 2019-02-19]
LV3.1/cad/Parachute_Cups/Cylinder_Chute_Main^eNSR_v2.2.SLDPRT
127.0 x 127.0 x 345.9 mm
