psas/lv3.0-recovery/LV3.1/cad/Brainstorming/MH_Concepts/DCR_Concept5/Thesis4_assy.SLDASM

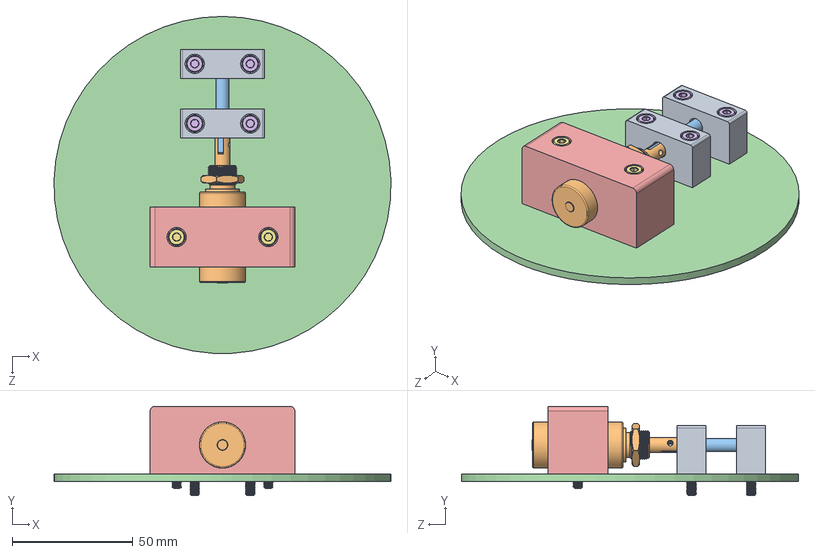
[picture p54: CAD file, 2019-02-26]
LV3.1/cad/Brainstorming/MH_Concepts/DCR_Concept5/Thesis4_assy.SLDASM
139.6 x 37.0 x 139.7 mm
Thesis4_pin_block x 2
69905K110_SEALED LINEAR SOLENOID
98381A035_pin_modified
Thesis4_base_plate
Thesis4_solenoid_housing
91292A122_TYPE 18-8 SS SOCKET HEAD CAP SCREW x 4
91292A130_TYPE 18-8 SS SOCKET HEAD CAP SCREW x 2
