psas/lv3.0-recovery/LV3.1/Nose_cone/Nose_cone_whole.SLDPRT

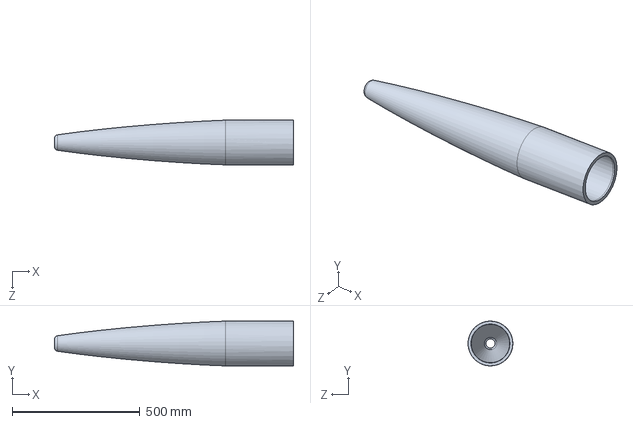
[picture p55: CAD file, 2019-02-26]
LV3.1/Nose_cone/Nose_cone_whole.SLDPRT
934.4 x 175.3 x 175.0 mm
