psas/lv3.0-recovery/LV3.1/cad/Base_11_mockup/main_chute.SLDPRT

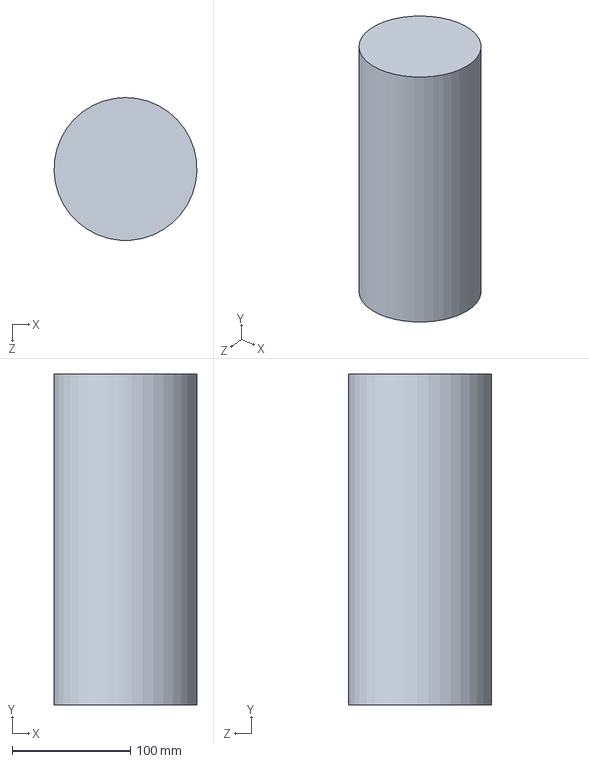
[picture p56: CAD file, 2019-04-02]
LV3.1/cad/Base_11_mockup/main_chute.SLDPRT
120.6 x 279.4 x 120.7 mm
