psas/lv3.0-recovery/LV3.1/cad/Brainstorming/GG_Full_Mockup/keeper_assy_V3.SLDASM

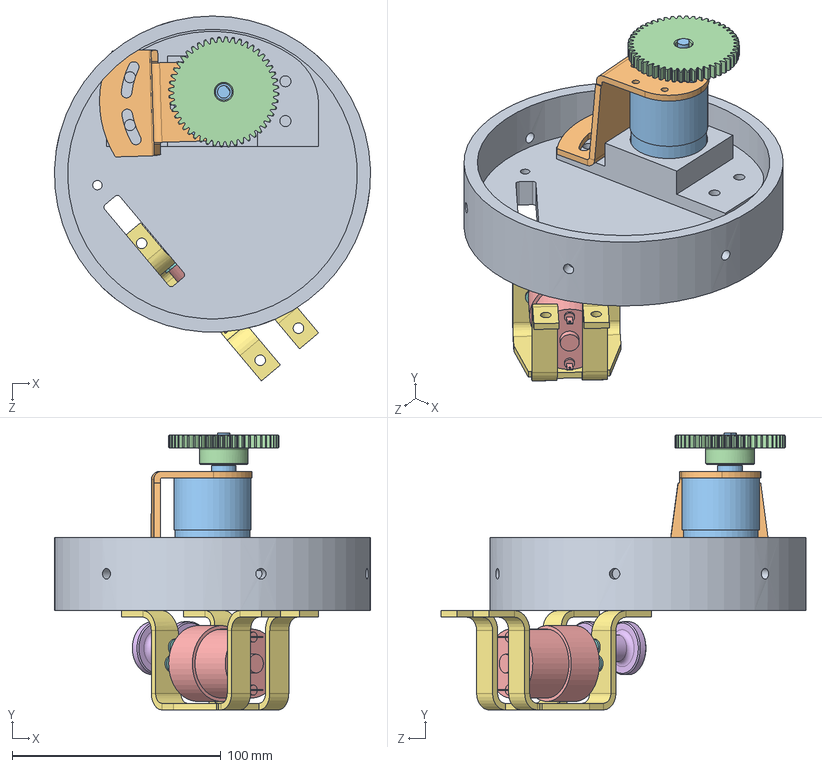
[picture p57: CAD file, 2019-04-28]
LV3.1/cad/Brainstorming/GG_Full_Mockup/keeper_assy_V3.SLDASM
151.3 x 132.6 x 174.7 mm
keeper_ring_V3
motor_bracket_sheetmetal_V3
BLDC_Gear_Motor_100rpm
7880K450_HT-LOAD MTL GEAR--20 DEG PRESSURE ANGLE
ROB-12310
spindle_small
motor_brkt
95610A330_NYLON FLAT WASHER x 4
motor_housing
