psas/lv3.0-recovery/LV3.1/cad/for3dprinting/Motor Housing Assembly.SLDASM

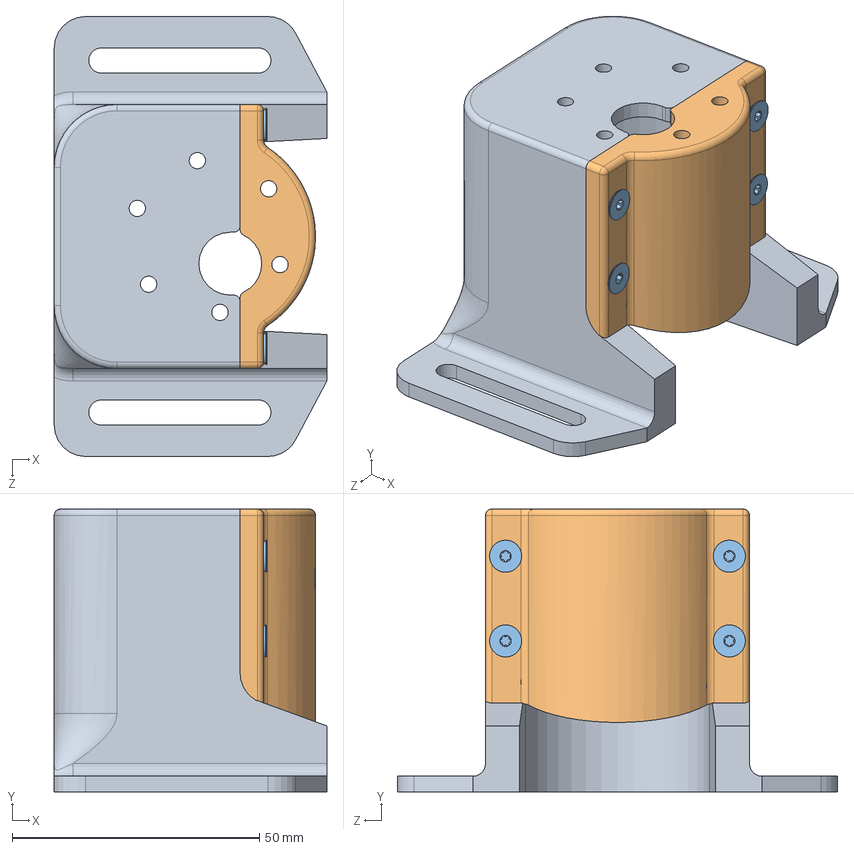
[picture p58: CAD file, 2019-11-19]
LV3.1/cad/for3dprinting/Motor Housing Assembly.SLDASM
55.1 x 57.2 x 88.9 mm
MotorHousingMain
MotorHousingClamshell
94414A108_ALLOY STL TORX DRIVE FLAT-HEAD SCKT CAP SCREW x 4
