psas/lv3.0-recovery/LV3.1/cad/AssemblyV3.2/grommet_assy.SLDASM

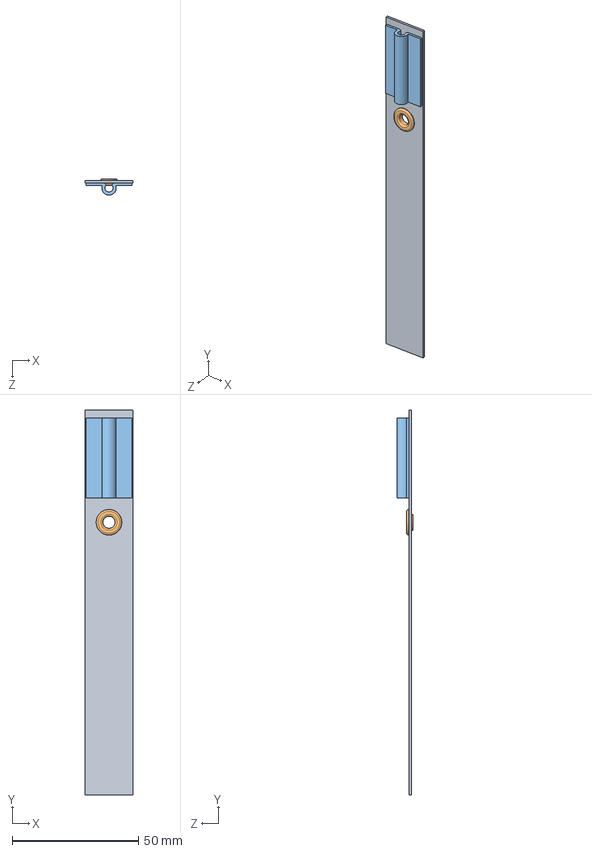
[picture p59: CAD file, 2019-12-06]
LV3.1/cad/AssemblyV3.2/grommet_assy.SLDASM
19.1 x 152.4 x 6.48 mm
webbing_grommet_V1
grommet_V1
yellow_cord_guide
