psas/lv3.0-recovery/LV3.1/cad/Brainstorming/MH_Concepts/DCR_Concept1/Thesis3_assy.SLDASM

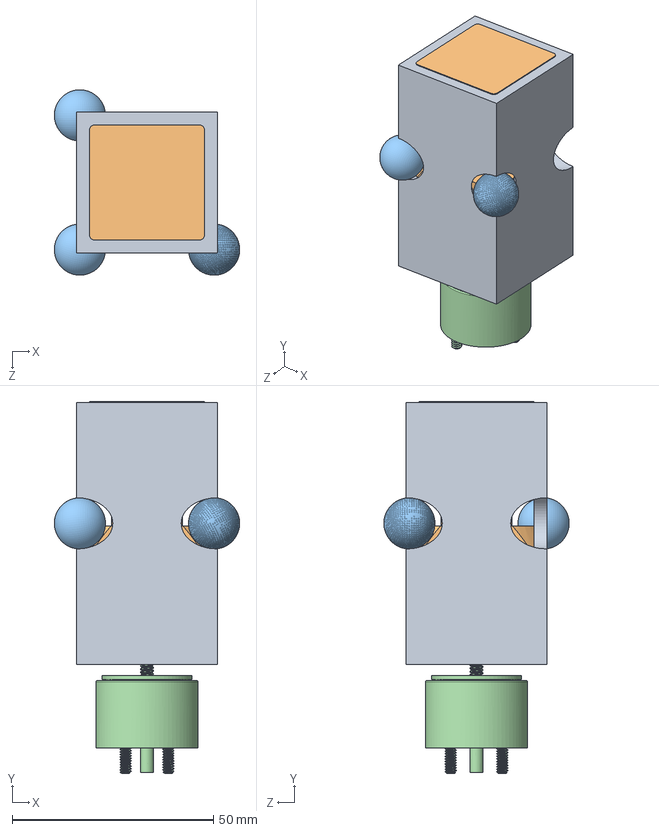
[picture p60: CAD file, 2019-02-26]
LV3.1/cad/Brainstorming/MH_Concepts/DCR_Concept1/Thesis3_assy.SLDASM
46.0 x 92.3 x 46.0 mm
Thesis3_housing
Thesis3_plunger
ball_bearing_.5 x 4
6873K110_COMPACT LINEAR SOLENOID
