psas/lv3.0-recovery/LV3.1/cad/NCR_V3/keeper_assy_V3.SLDASM

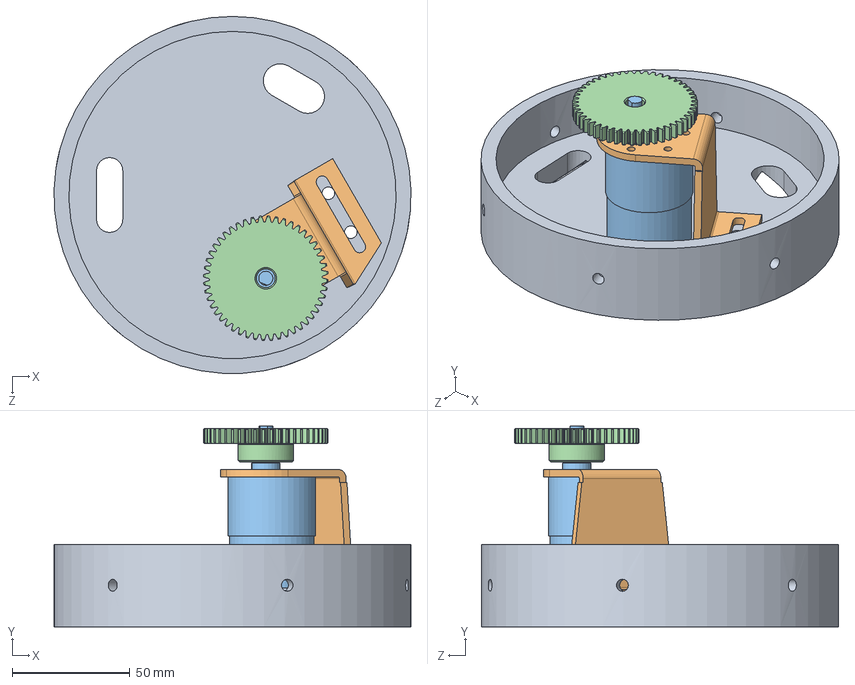
[picture p61: CAD file, 2019-05-19]
LV3.1/cad/NCR_V3/keeper_assy_V3.SLDASM
151.3 x 85.0 x 151.4 mm
keeper_ring_V3
motor_bracket_sheetmetal_V3
BLDC_Gear_Motor_100rpm
7880K450_HT-LOAD MTL GEAR--20 DEG PRESSURE ANGLE
