psas/lv3.0-recovery/LV3.1/cad/Sys_architecture.SLDASM

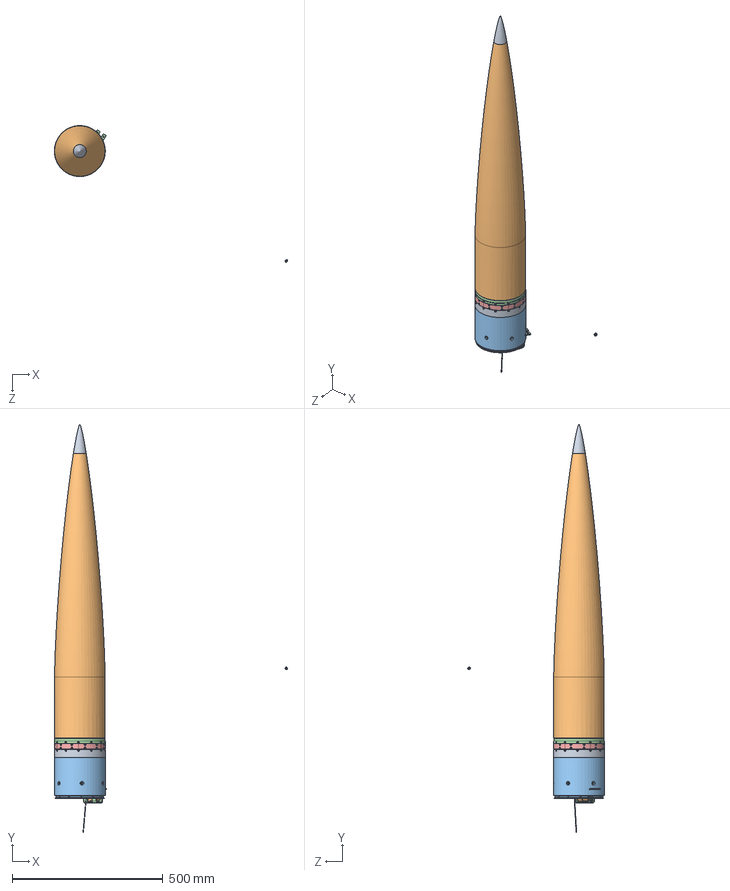
[picture p62: CAD file, 2019-04-16]
LV3.1/cad/Sys_architecture.SLDASM
773.4 x 1352.5 x 453.5 mm
twist_coupling_V3
keeper_ring_V3
motor_bracket_sheetmetal_V3
BLDC_Gear_Motor_100rpm
7880K450_HT-LOAD MTL GEAR--20 DEG PRESSURE ANGLE
motor_housing
ROB-12310
spindle_small
motor_brkt
95610A330_NYLON FLAT WASHER x 4
No.3_ring
No.4_ring
No.10_ring
Webbing_mid
Webbing_main
Webbing_top
grommet
yellow_cord
grommet_webbing
nylon_loop.1
main_chute_webbing
von_karmon_nose_tip2
noseconeShell
nosePlug2
moduleRing
clampArc x 6
Cup_Chute_Drogue^eNSR_v2.2
Cylinder_Chute_Main^eNSR_v2.2
8891T790_316 STAINLESS STEEL EYEBOLT
pizza_table.2
