psas/lv3.0-recovery/LV3.1/cad/Brainstorming/GW_Concepts/full_size_proto.SLDASM

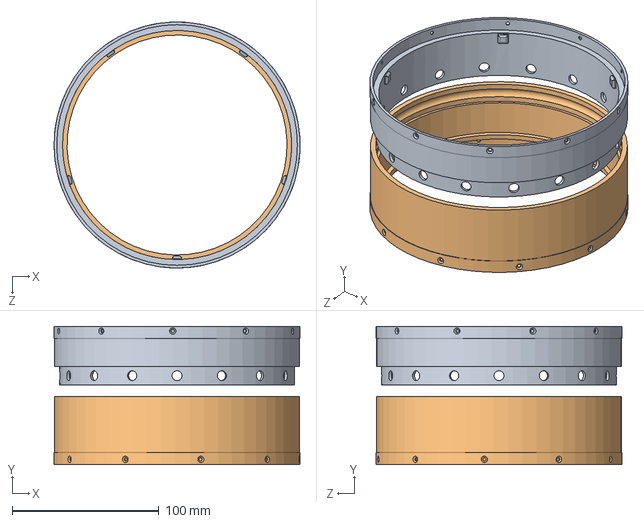
[picture p63: CAD file, 2019-04-04]
LV3.1/cad/Brainstorming/GW_Concepts/full_size_proto.SLDASM
167.6 x 94.3 x 167.6 mm
inner_ring_rsd2
outer_ring_rsd2
