psas/lv3.0-recovery/LV3.1/cad/Base_11_mockup/main_chute_webbing.SLDPRT

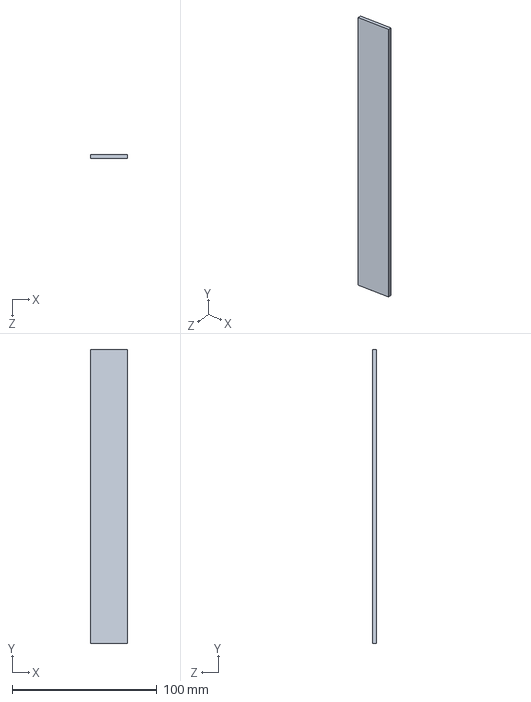
[picture p64: CAD file, 2019-03-17]
LV3.1/cad/Base_11_mockup/main_chute_webbing.SLDPRT
25.4 x 203.2 x 2.54 mm
