psas/lv3.0-recovery/LV3.1/cad/NCR_V3/upper_ring_assy.SLDASM

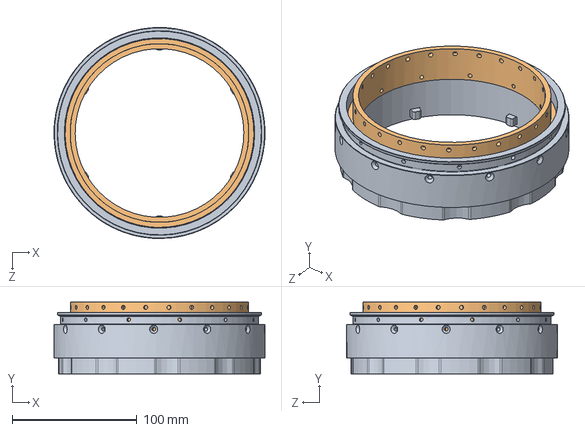
[picture p65: CAD file, 2019-04-27]
LV3.1/cad/NCR_V3/upper_ring_assy.SLDASM
168.9 x 57.2 x 168.9 mm
upper_ring_V3
tube_ring_V3
