psas/lv3.0-recovery/LV3.1/cad/DCR_V2/DCR_V1/webbing_main_V1.SLDPRT

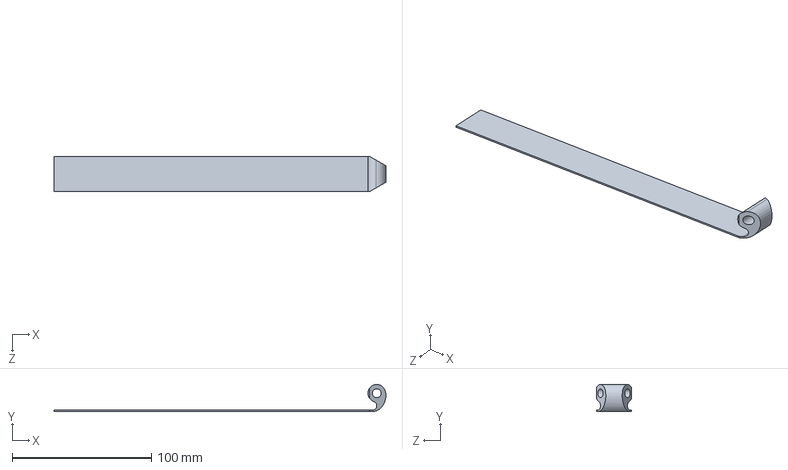
[picture p66: CAD file, 2019-04-27]
LV3.1/cad/DCR_V2/DCR_V1/webbing_main_V1.SLDPRT
238.4 x 19.5 x 25.4 mm
