psas/lv3.0-recovery/LV3.1/cad/Brainstorming/GG_Full_Mockup/motor_assy.SLDASM

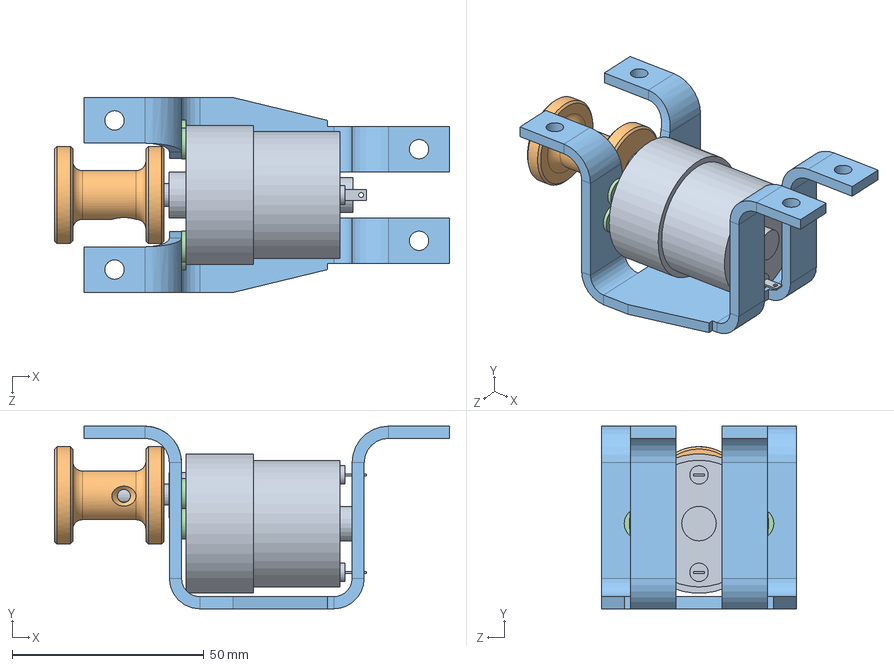
[picture p67: CAD file, 2019-04-28]
LV3.1/cad/Brainstorming/GG_Full_Mockup/motor_assy.SLDASM
103.0 x 47.6 x 50.8 mm
ROB-12310
spindle_small
motor_brkt
95610A330_NYLON FLAT WASHER x 4
