psas/lv3.0-recovery/LV3.1/cad/Brainstorming/GG_Full_Mockup/ST_CAP_ASSEM.SLDASM

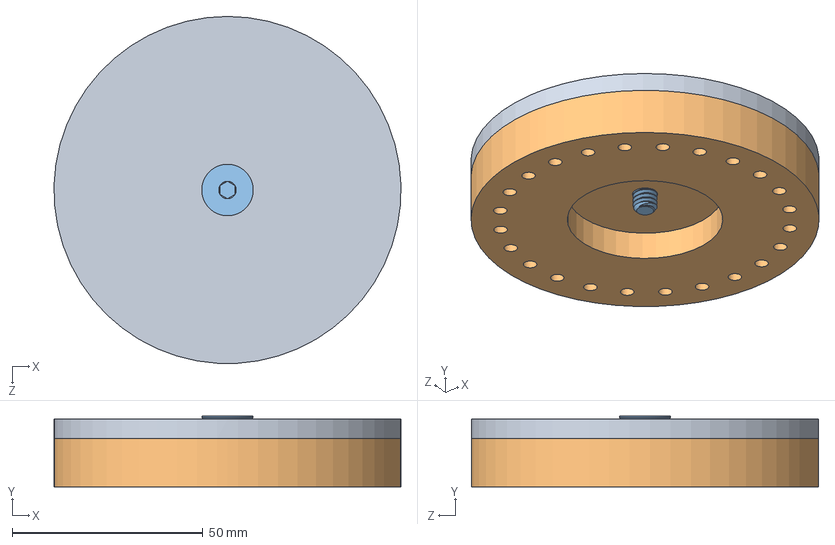
[picture p68: CAD file, 2019-04-28]
LV3.1/cad/Brainstorming/GG_Full_Mockup/ST_CAP_ASSEM.SLDASM
90.9 x 18.5 x 90.9 mm
ST_Cap
ST_Bottom
91263A556_ZINC-PLATED ALLOY STEEL FLAT-HEAD CAP SCREW
