psas/lv3.0-recovery/LV3.1/cad/Brainstorming/MH_Concepts/DCR_Concept1/Proto_spring_assy.SLDASM

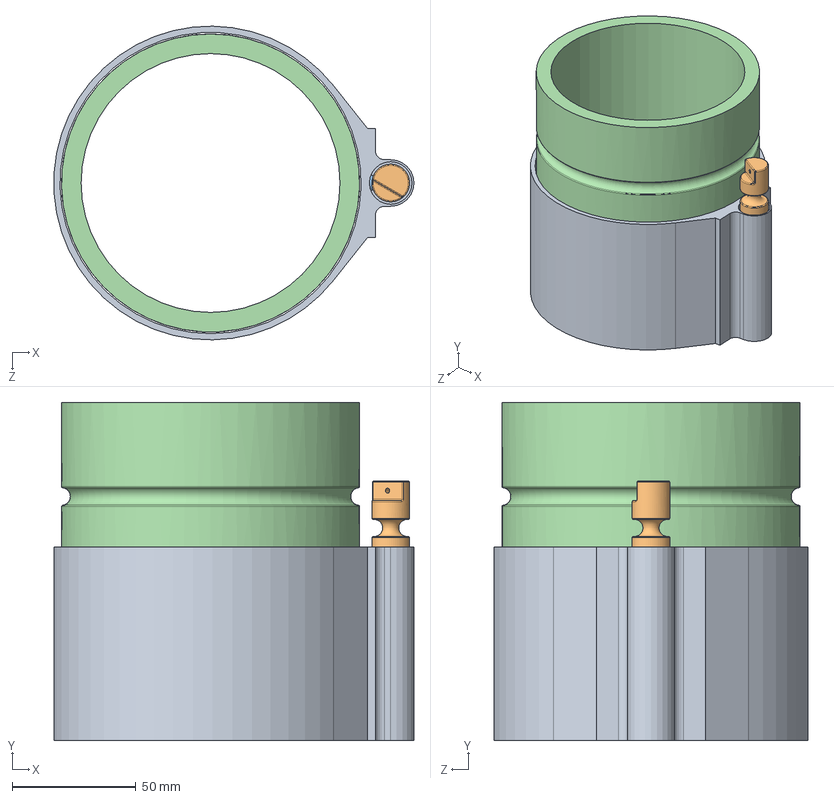
[picture p69: CAD file, 2019-02-19]
LV3.1/cad/Brainstorming/MH_Concepts/DCR_Concept1/Proto_spring_assy.SLDASM
145.7 x 136.9 x 127.0 mm
Proto_spring_chamber
Proto_spring_plunger
ball_bearing_.25
Proto_spring_inring
