psas/lv3.0-recovery/LV3.1/cad/Brainstorming/MH_Concepts/DCR_Concept1/Proto_spring_tube_ring.SLDASM

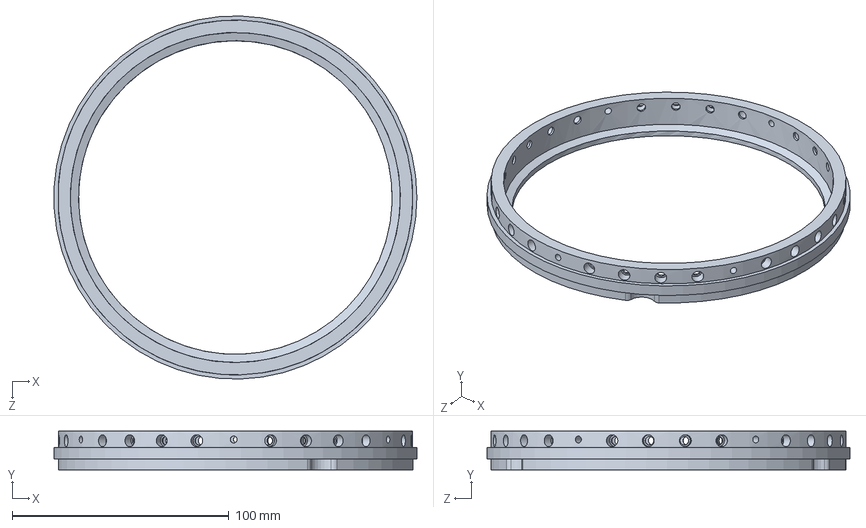
[picture p70: CAD file, 2019-02-19]
LV3.1/cad/Brainstorming/MH_Concepts/DCR_Concept1/Proto_spring_tube_ring.SLDASM
167.5 x 17.8 x 167.6 mm
