psas/lv3.0-recovery/LV3.1/cad/AssemblyV3.2/ShockCordMain.SLDPRT

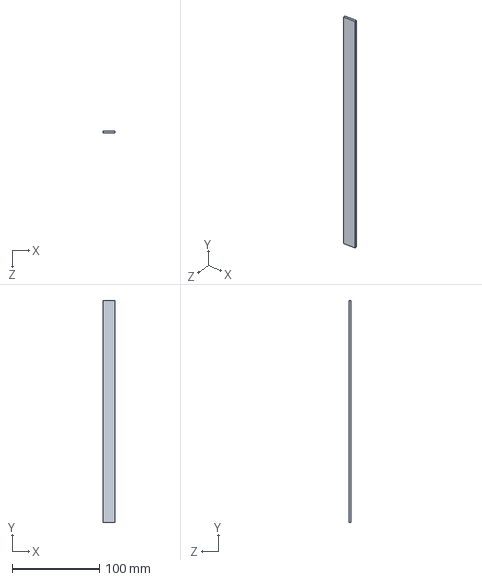
[picture p71: CAD file, 2019-12-06]
LV3.1/cad/AssemblyV3.2/ShockCordMain.SLDPRT
14.3 x 254.0 x 2.54 mm
