psas/lv3.0-recovery/LV3.1/cad/AssemblyV3.2/motorassy.SLDASM

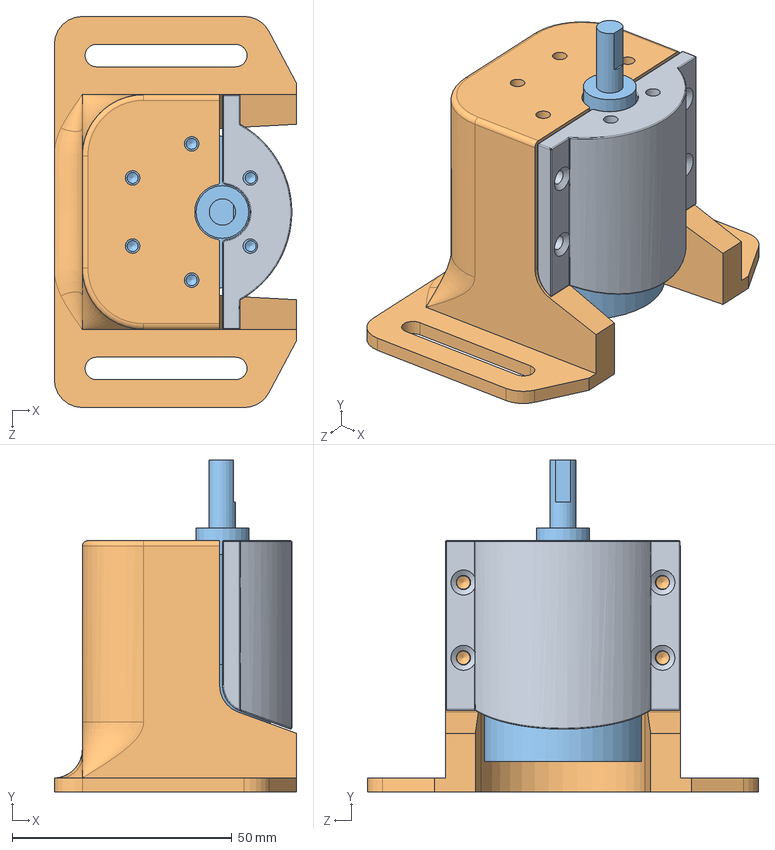
[picture p72: CAD file, 2019-12-06]
LV3.1/cad/AssemblyV3.2/motorassy.SLDASM
55.1 x 75.5 x 88.9 mm
MotorHousingClamshellrev1
MotorHousingMain_rev1
BLDC_Gear_Motor_100rpm
