psas/lv3.0-recovery/LV3.1/cad/AssemblyV3.2/3-ring_assy_V1.SLDASM

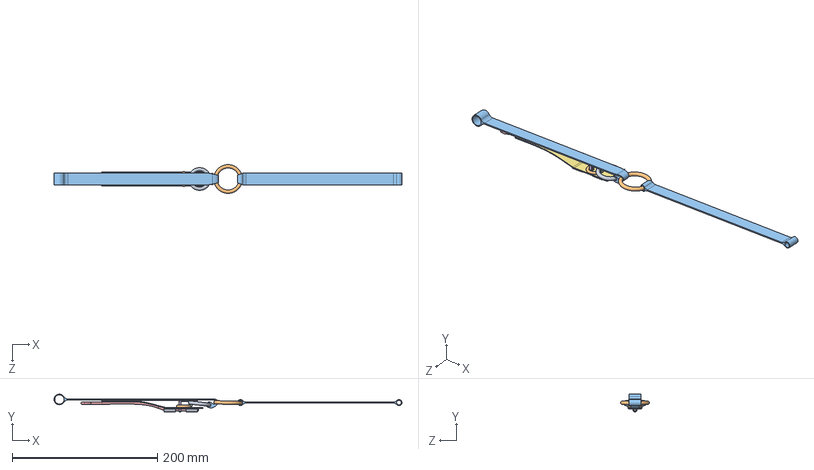
[picture p73: CAD file, 2019-12-06]
LV3.1/cad/AssemblyV3.2/3-ring_assy_V1.SLDASM
479.5 x 24.5 x 39.7 mm
H3860S_NO3_Ring
H3880S_NO4_Ring
webbing_base_V1
webbing_small_V1
yellow_cord_V1.1
nylon_loop_V1
webbing_grommet_V1
grommet_V1
yellow_cord_guide x 2
H3840B_NO2_Ring
webbing_top_V1
