psas/lv3.0-recovery/LV3.1/cad/AssemblyV3.2/Cylinder_Chute_Main^ERS_v1.0.SLDPRT

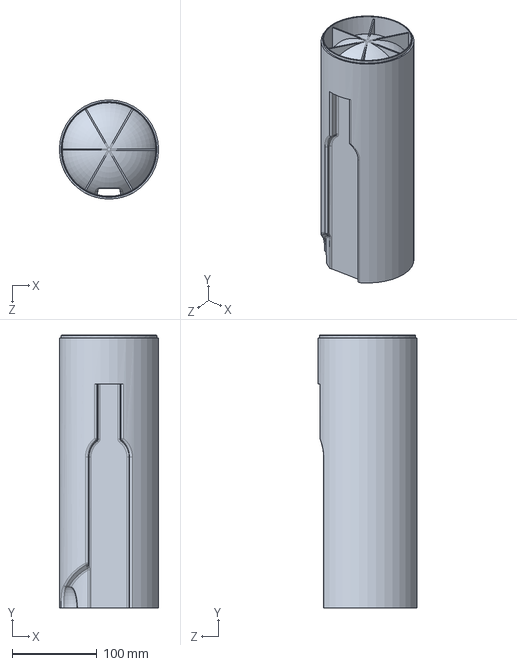
[picture p74: CAD file, 2019-06-13]
LV3.1/cad/AssemblyV3.2/Cylinder_Chute_Main^ERS_v1.0.SLDPRT
116.8 x 321.3 x 116.8 mm
