psas/lv3.0-recovery/eNSR_Cap/eNSR_cap.3.STEP

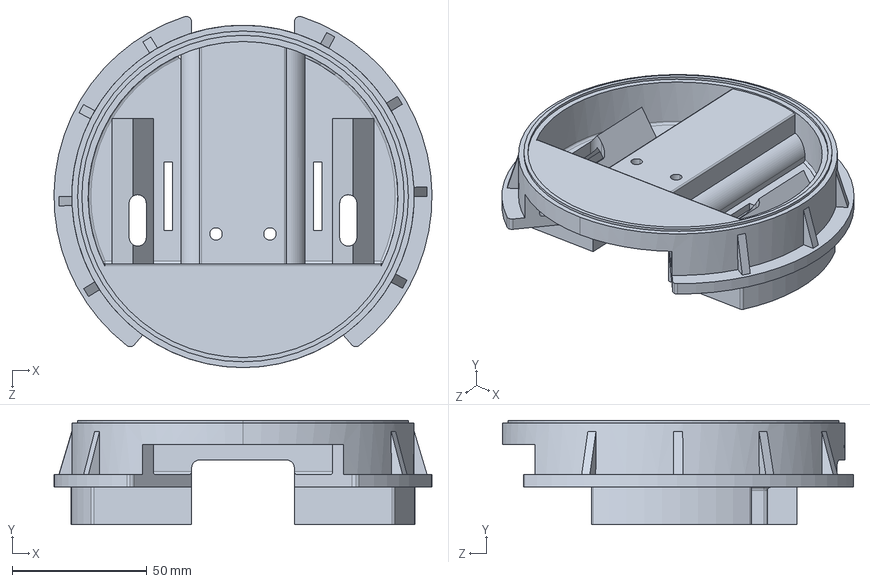
[picture p75: CAD file, 2018-12-27]
eNSR_Cap/eNSR_cap.3.STEP
140.2 x 38.7 x 130.3 mm
