psas/lv3.0-recovery/Initial_Designs/Ring_lv3.0-recovery.STEP

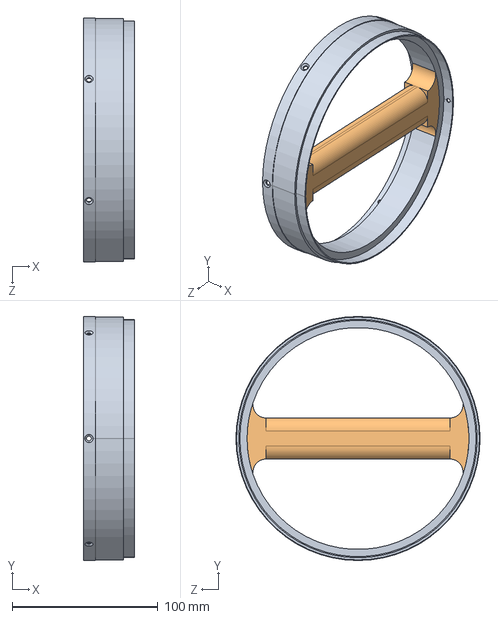
[picture p76: CAD file, 2016-09-07]
Initial_Designs/Ring_lv3.0-recovery.STEP
35.1 x 167.6 x 167.6 mm
