psas/lv3.0-recovery/Line_Cutters/Line_Cutter.SLDPRT

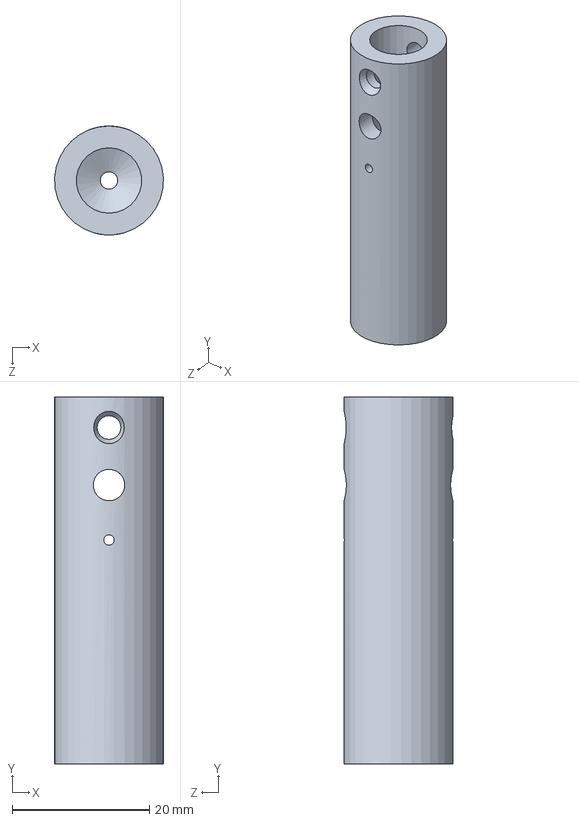
[picture p77: CAD file, 2017-06-17]
Line_Cutters/Line_Cutter.SLDPRT
15.9 x 53.5 x 15.9 mm
