psas/lv3.0-recovery/Line_Cutters/LV2c_Line_Cutters/LV2cLineCutters/LineCutterSheildPlate_Lv2c.dxf

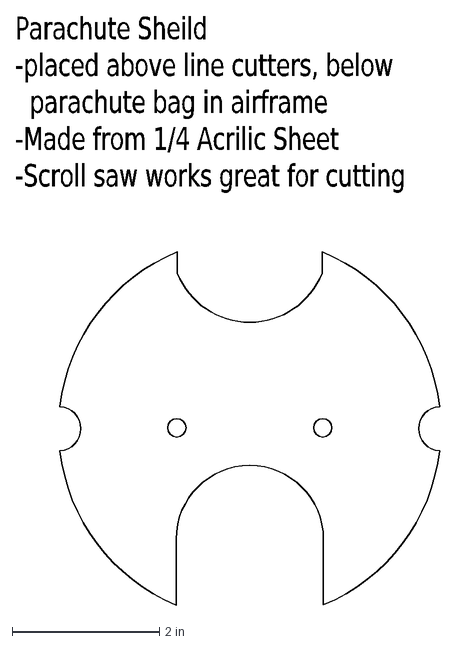
[picture p78: CAD file, 2018-12-27]
Line_Cutters/LV2c_Line_Cutters/LV2cLineCutters/LineCutterSheildPlate_Lv2c.dxf
Parachute\~Sheild -placed\~above\~line\~cutters,\~below \~\~parachute\~bag\~in\~airframe -Made\~from\~1/4\~Acrilic\~Sheet -Scroll\~saw\~works\~great\~for\~cutti
