psas/lv3.0-recovery/LV3.1/cad/Brainstorming/GG_WIP/Motor1_small.SLDPRT

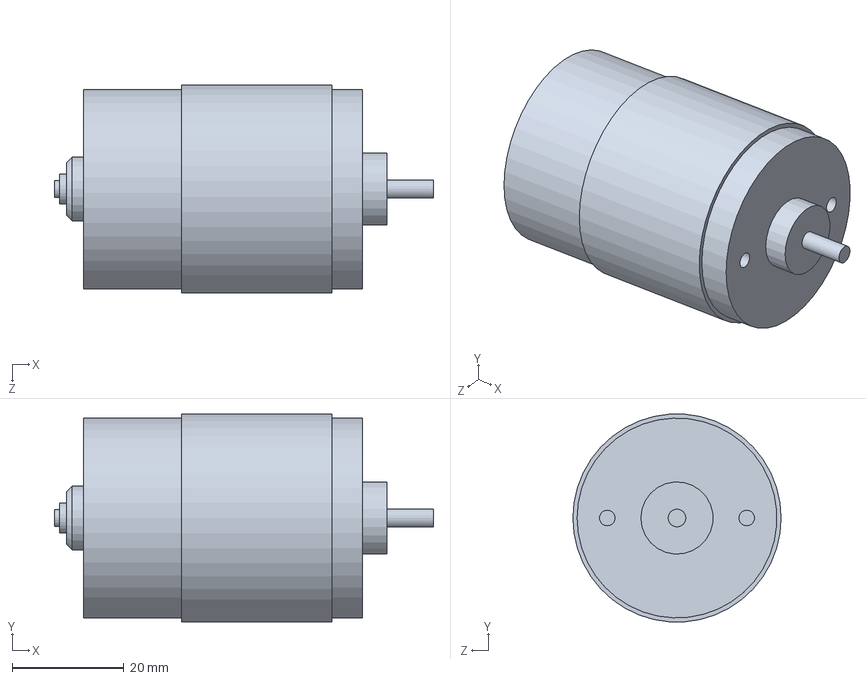
[picture p79: CAD file, 2019-03-18]
LV3.1/cad/Brainstorming/GG_WIP/Motor1_small.SLDPRT
67.9 x 37.2 x 37.3 mm
