psas/lv3.0-recovery/LV3.1/cad/Brainstorming/MH_Concepts/DCR_Concept1/products/12147/source_solidworks/ROB-12147.SLDPRT

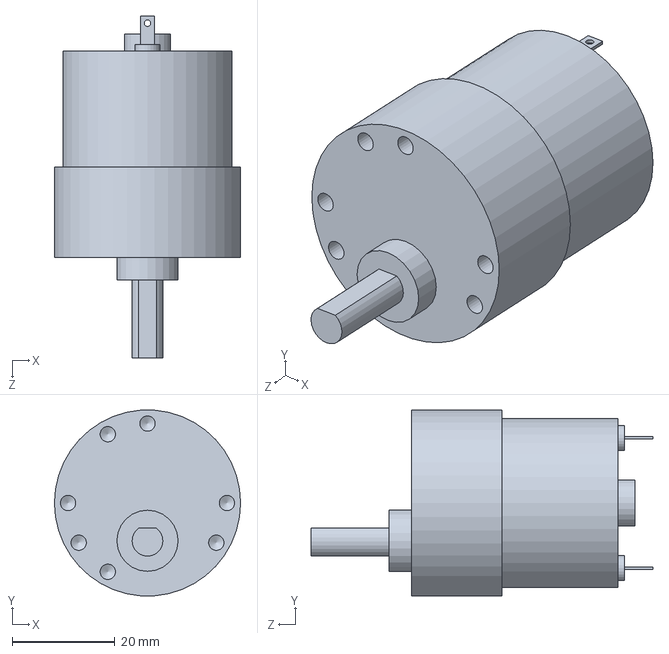
[picture p80: CAD file, 2019-02-27]
LV3.1/cad/Brainstorming/MH_Concepts/DCR_Concept1/products/12147/source_solidworks/ROB-12147.SLDPRT
36.3 x 36.2 x 66.7 mm
