psas/lv3.0-recovery/LV3.1/cad/Brainstorming/MH_Concepts/DCR_Concept2/Thesis1_housing.STEP

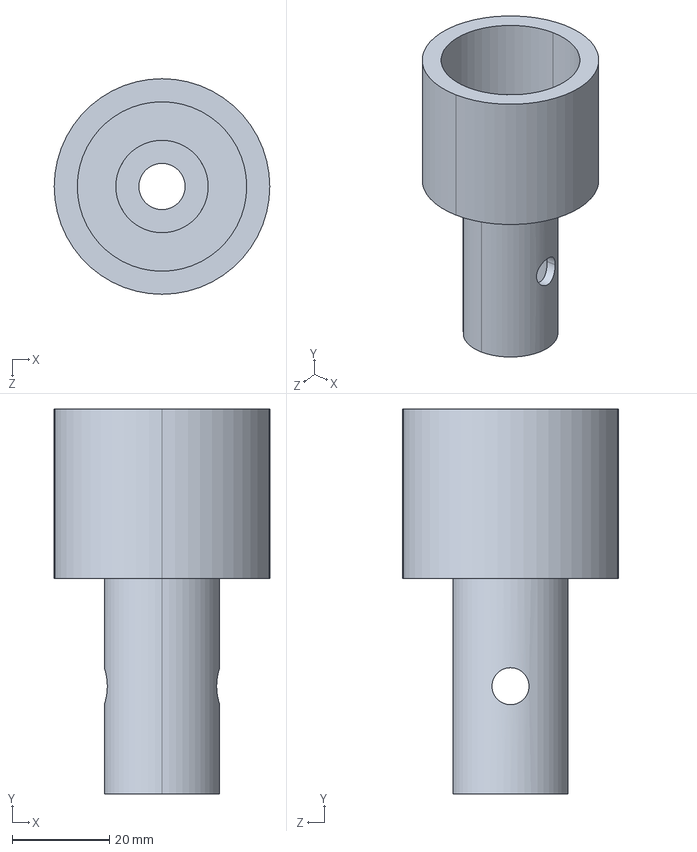
[picture p81: CAD file, 2019-12-06]
LV3.1/cad/Brainstorming/MH_Concepts/DCR_Concept2/Thesis1_housing.STEP
44.4 x 79.4 x 44.4 mm
