psas/lv3.0-recovery/LV3.1/cad/Brainstorming/MH_Concepts/DCR_Concept3/Thesis2_plungerFEall.IGS

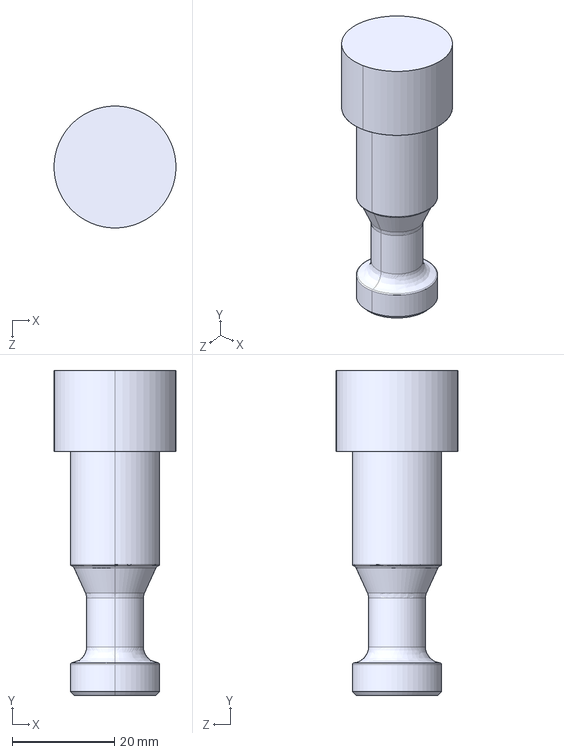
[picture p82: CAD file, 2019-12-06]
LV3.1/cad/Brainstorming/MH_Concepts/DCR_Concept3/Thesis2_plungerFEall.IGS
23.8 x 63.5 x 23.8 mm
