psas/lv3.0-recovery/LV3.1/cad/Brainstorming/MH_Concepts/DCR_Concept5/Thesis4_pin_block.1.SLDPRT

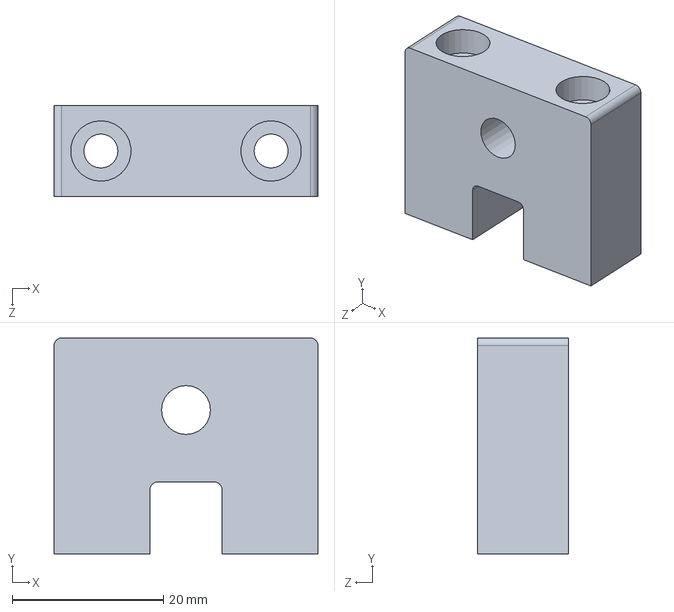
[picture p83: CAD file, 2019-02-26]
LV3.1/cad/Brainstorming/MH_Concepts/DCR_Concept5/Thesis4_pin_block.1.SLDPRT
34.9 x 28.6 x 12.0 mm
