psas/lv3.0-recovery/LV3.1/cad/Brainstorming/MH_Concepts/SMA_Protos/Proto1_clip.SLDPRT

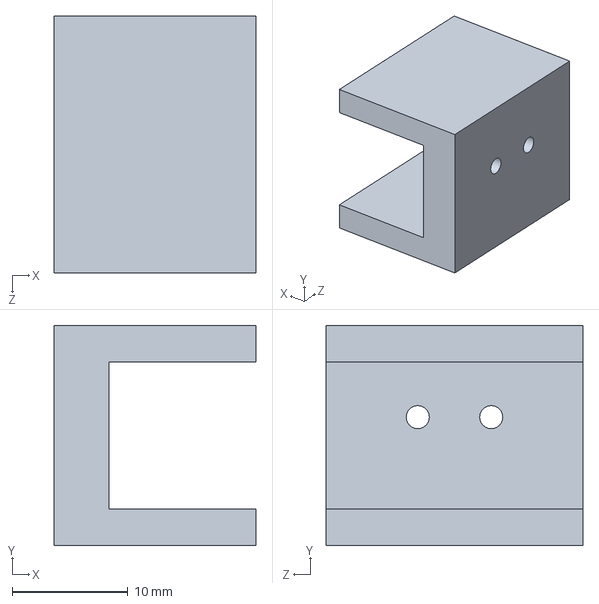
[picture p84: CAD file, 2019-02-19]
LV3.1/cad/Brainstorming/MH_Concepts/SMA_Protos/Proto1_clip.SLDPRT
17.5 x 19.1 x 22.2 mm
