psas/lv3.0-recovery/LV3.1/cad/Brainstorming/ST_Cap.SLDPRT

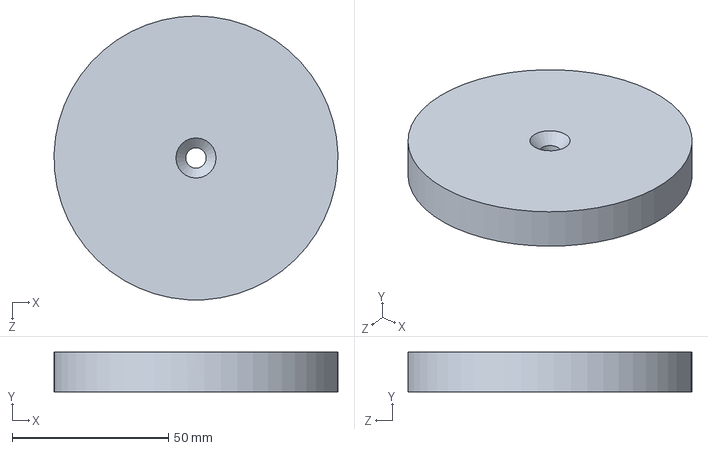
[picture p85: CAD file, 2019-04-28]
LV3.1/cad/Brainstorming/ST_Cap.SLDPRT
90.9 x 12.7 x 90.9 mm
