psas/lv3.0-recovery/LV3.1/cad/circuitboard/erspcb.DXF

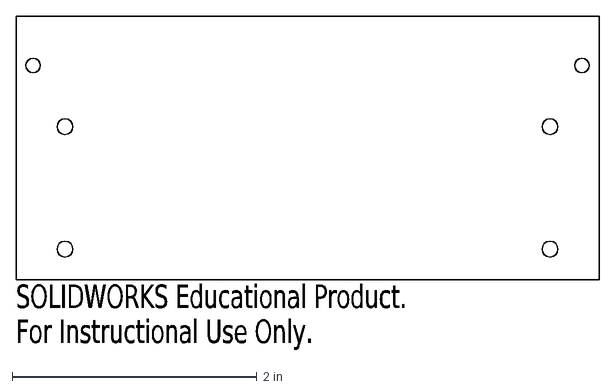
[picture p86: CAD file, 2020-01-15]
LV3.1/cad/circuitboard/erspcb.DXF
SOLIDWORKS Educational Product.
For Instructional Use Only.
