psas/lv3.0-recovery/LV3.1/cad/for3dprinting/LinAct_Bracket_Back_rev1.SLDPRT

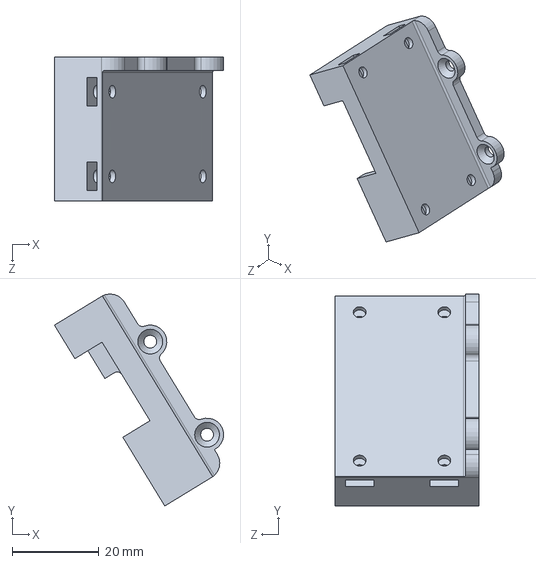
[picture p87: CAD file, 2019-12-07]
LV3.1/cad/for3dprinting/LinAct_Bracket_Back_rev1.SLDPRT
38.9 x 48.7 x 33.0 mm
