psas/lv3.0-recovery/LV3.1/cad/for3dprinting/STEPfiles/PIZZA_v4.1.STEP

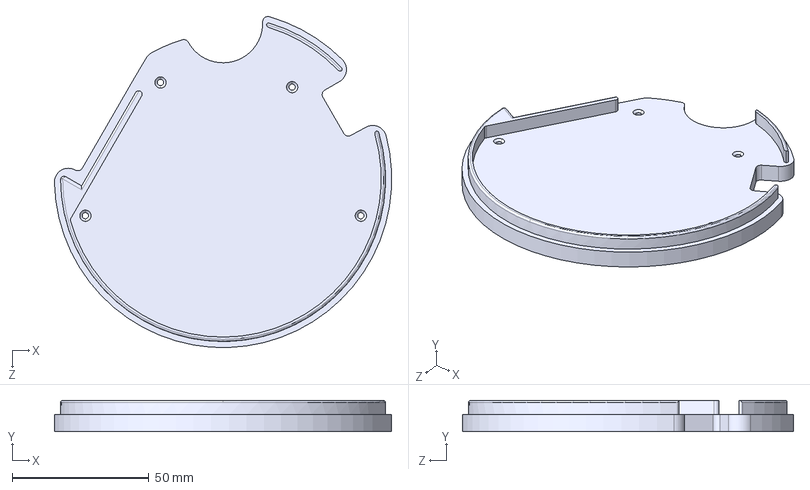
[picture p88: CAD file, 2019-11-19]
LV3.1/cad/for3dprinting/STEPfiles/PIZZA_v4.1.STEP
123.1 x 11.4 x 120.9 mm
