psas/lv3.0-recovery/LV3.1/cad/formachining/MotorGear-rev2.SLDPRT

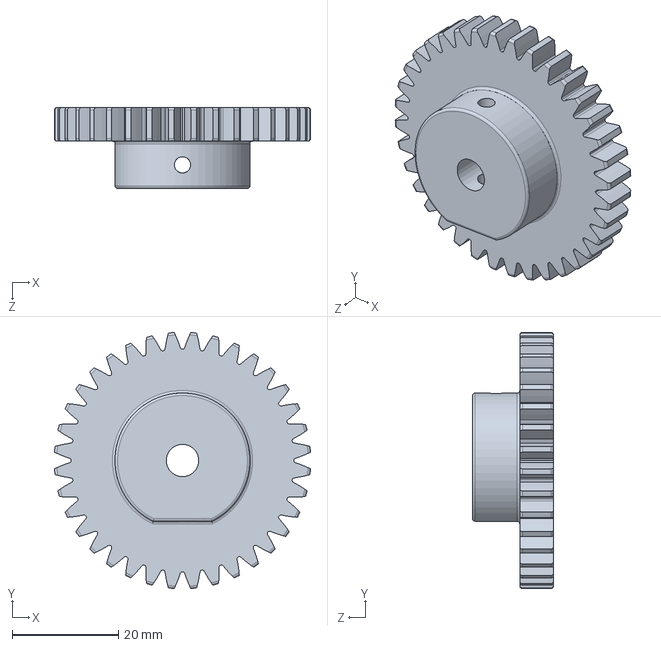
[picture p89: CAD file, 2019-12-06]
LV3.1/cad/formachining/MotorGear-rev2.SLDPRT
48.2 x 48.2 x 15.2 mm
