psas/lv3.0-recovery/LV3.1/cad/NCR_V3/electronics.SLDPRT

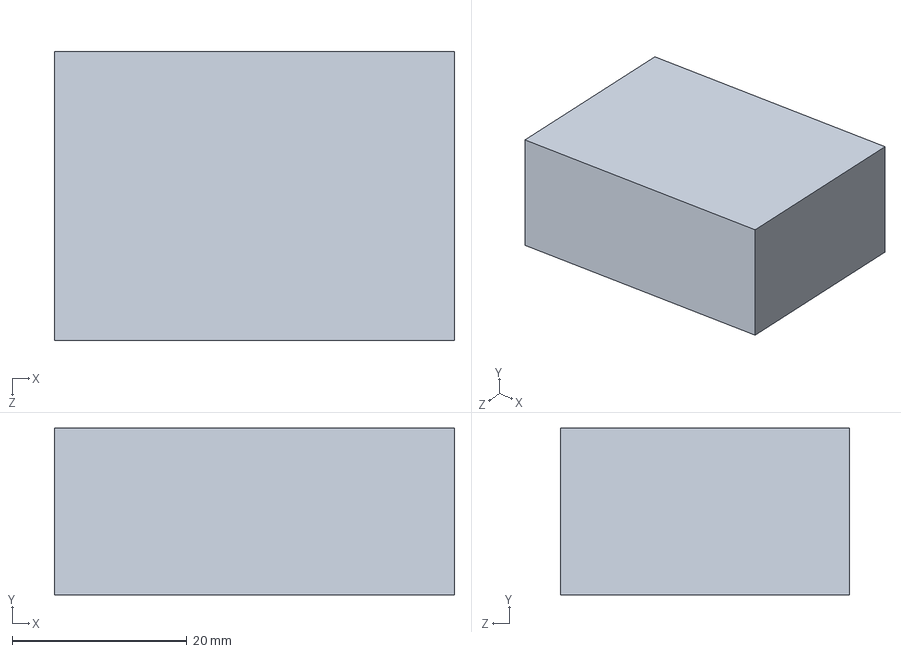
[picture p90: CAD file, 2019-05-19]
LV3.1/cad/NCR_V3/electronics.SLDPRT
45.7 x 19.1 x 33.0 mm
