psas/lv3.0-recovery/LV3.1/cad/Parachute_Cups/pizza_table.2.SLDPRT

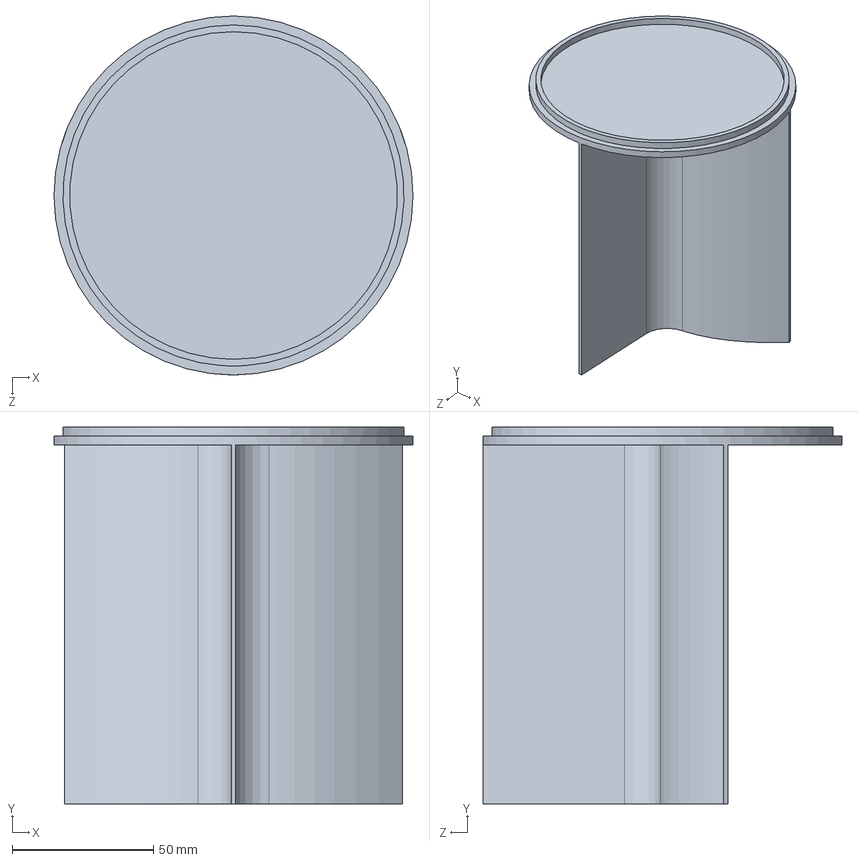
[picture p91: CAD file, 2019-04-16]
LV3.1/cad/Parachute_Cups/pizza_table.2.SLDPRT
127.0 x 133.4 x 127.0 mm
