psas/lv3.0-recovery/LV3.1/cad/twist_coupling_V4.STEP

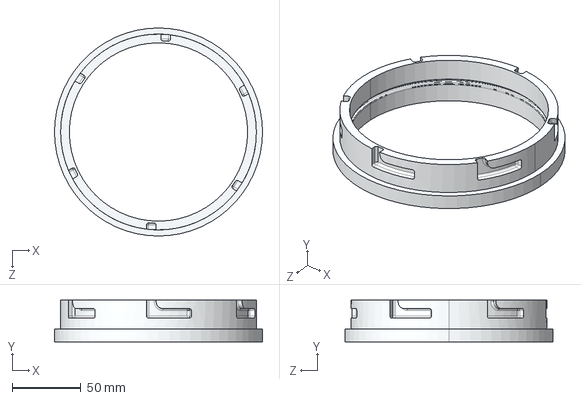
[picture p92: CAD file, 2019-12-06]
LV3.1/cad/twist_coupling_V4.STEP
151.1 x 30.5 x 151.1 mm
