psas/lv3.0-recovery/LV3.1/Current_Ring/Bottom_ring_2.SLDPRT

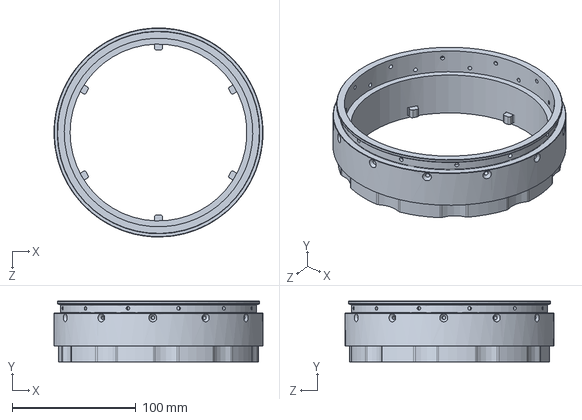
[picture p93: CAD file, 2019-04-05]
LV3.1/Current_Ring/Bottom_ring_2.SLDPRT
168.9 x 49.1 x 168.9 mm
