psas/lv3.0-recovery/LV3.1/Nose_cone/Nose_cone_top.1.SLDPRT

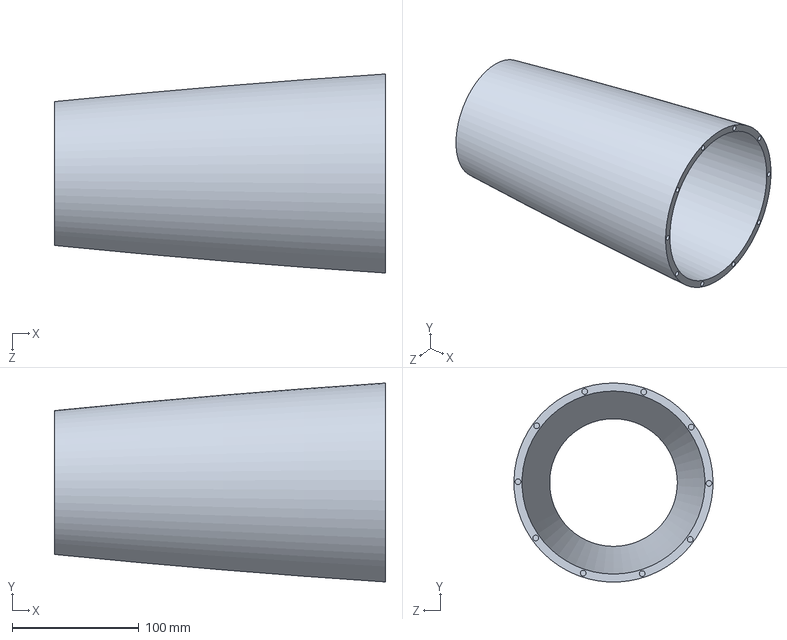
[picture p94: CAD file, 2019-02-26]
LV3.1/Nose_cone/Nose_cone_top.1.SLDPRT
261.3 x 157.1 x 157.1 mm
