psas/lv3.0-recovery/LV3.1/prototype_cad_lv3.1/GW_Concept2/Top_ring.STEP

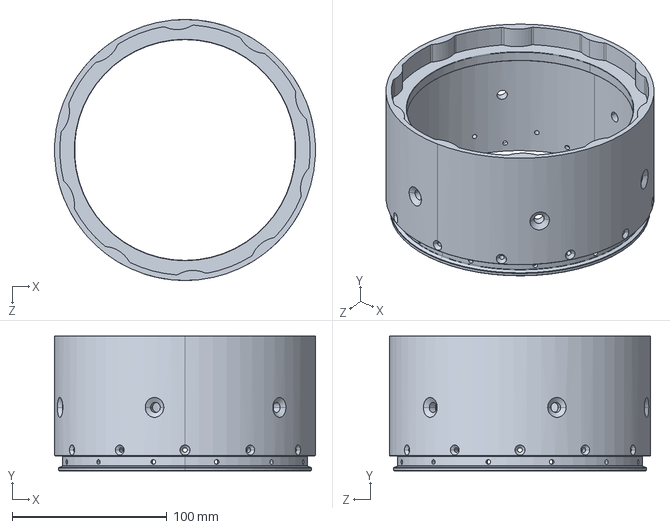
[picture p95: CAD file, 2019-04-04]
LV3.1/prototype_cad_lv3.1/GW_Concept2/Top_ring.STEP
168.9 x 87.2 x 168.9 mm
