psas/lv3.0-recovery/Spring_Ring/Spring_Ring_r7.stp

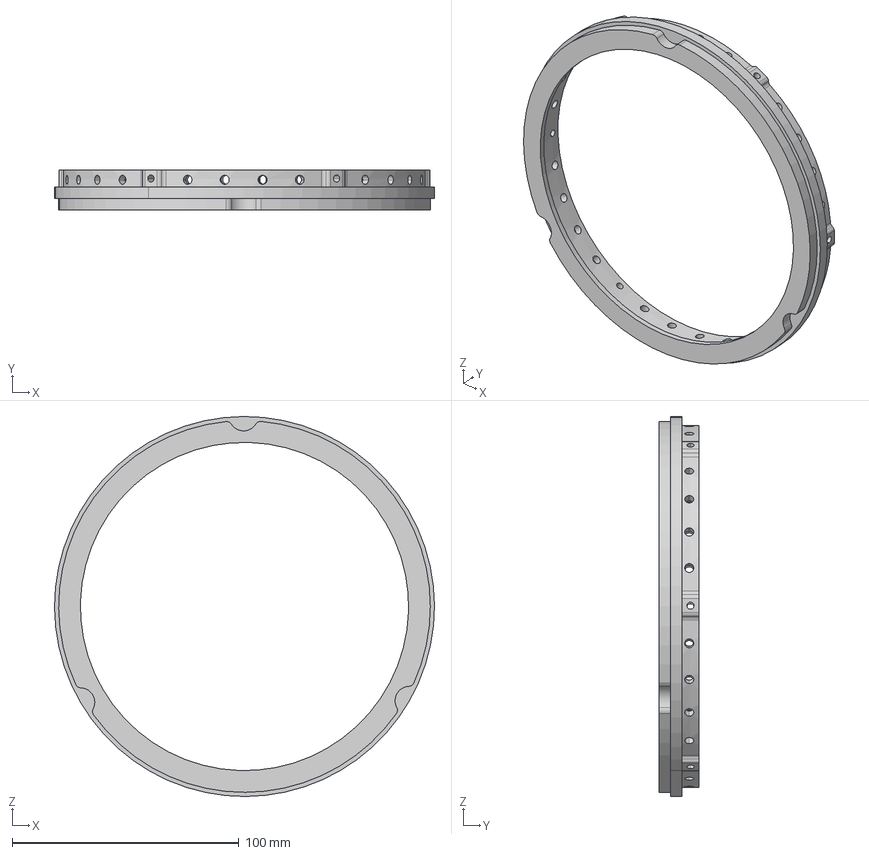
[picture p96: CAD file, 2018-12-27]
Spring_Ring/Spring_Ring_r7.stp
167.6 x 17.8 x 167.6 mm
