psas/lv3.0-recovery/Line_Cutters/LV2c_Line_Cutters/LV2cLineCutters/PlugLineCutter-v2c.dxf

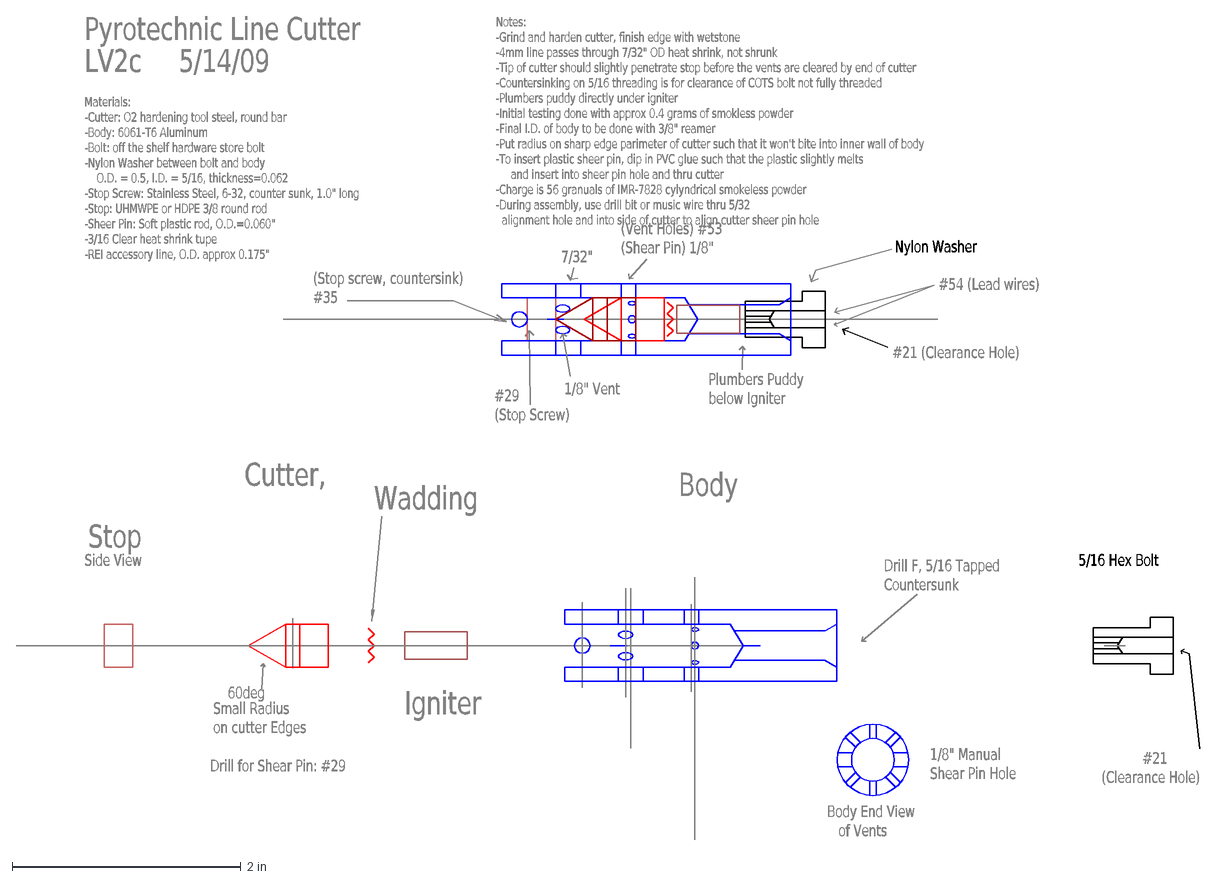
[picture p97: CAD file, 2018-12-27]
Line_Cutters/LV2c_Line_Cutters/LV2cLineCutters/PlugLineCutter-v2c.dxf
Pyrotechnic\~Line\~Cutter
\~\~\~\~\~\~\~\~\~\~\~#21 (Clearance\~Hole)
Stop
Wadding
Igniter
5/16\~Hex\~Bolt
Drill\~F,\~5/16\~Tapped Countersunk
Side\~View
Body\~End\~View\~ \~\~\~of\~Vents
60deg
Nylon\~Washer
Plumbers\~Puddy below\~Igniter
#29 (Stop\~Screw)
#21\~(Clearance\~Hole)
#54\~(Lead\~wires)
7/32"
Notes: -Grind\~and\~harden\~cutter,\~finish\~edge\~with\~wetstone -4mm\~line\~passes\~through\~7/32"\~OD\~heat\~shrink,\~not\~shrunk -Tip\~of\~cutter\~should\~s
Small\~Radius on\~cutter\~Edges
Cutter,
Body
1/8"\~Manual Shear\~Pin\~Hole
(Vent\~Holes)\~#53 (Shear\~Pin)\~1/8"
1/8"\~Vent
Drill\~for\~Shear\~Pin:\~#29
(Stop\~screw,\~countersink) #35
Materials: -Cutter:\~O2\~hardening\~tool\~steel,\~round\~bar -Body:\~6061-T6\~Aluminum -Bolt:\~off\~the\~shelf\~hardware\~store\~bolt -Nylon\~Washer\~between\~b
LV2c\~\~\~\~\~5/14/09
