psas/lv3.0-recovery/LV3.1/cad/Brainstorming/GG_Full_Mockup/BLDC_Gear_Motor_100rpm.SLDPRT

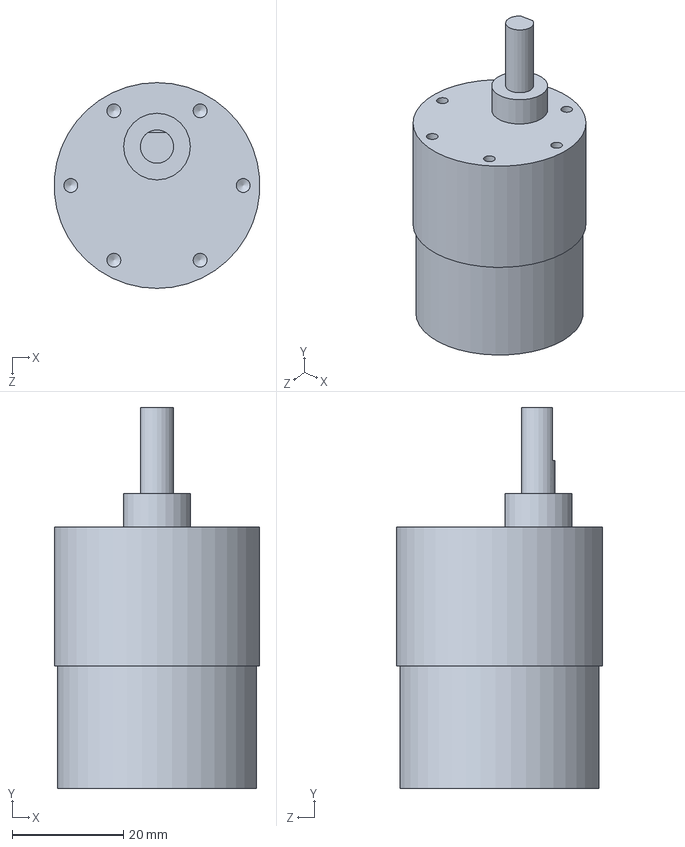
[picture p98: CAD file, 2019-04-28]
LV3.1/cad/Brainstorming/GG_Full_Mockup/BLDC_Gear_Motor_100rpm.SLDPRT
36.9 x 68.5 x 37.0 mm
