psas/lv3.0-recovery/LV3.1/cad/Brainstorming/GW_Concepts/keeper ring2.SLDPRT

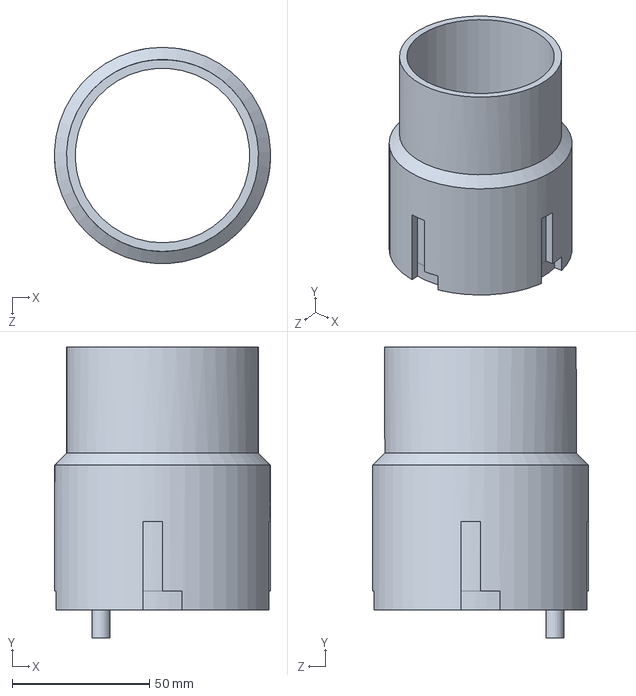
[picture p99: CAD file, 2019-04-04]
LV3.1/cad/Brainstorming/GW_Concepts/keeper ring2.SLDPRT
78.7 x 105.9 x 78.7 mm
