psas/lv3.0-recovery/LV3.1/cad/Brainstorming/MH_Concepts/DCR_Concept5/Thesis4_base_plate.SLDPRT

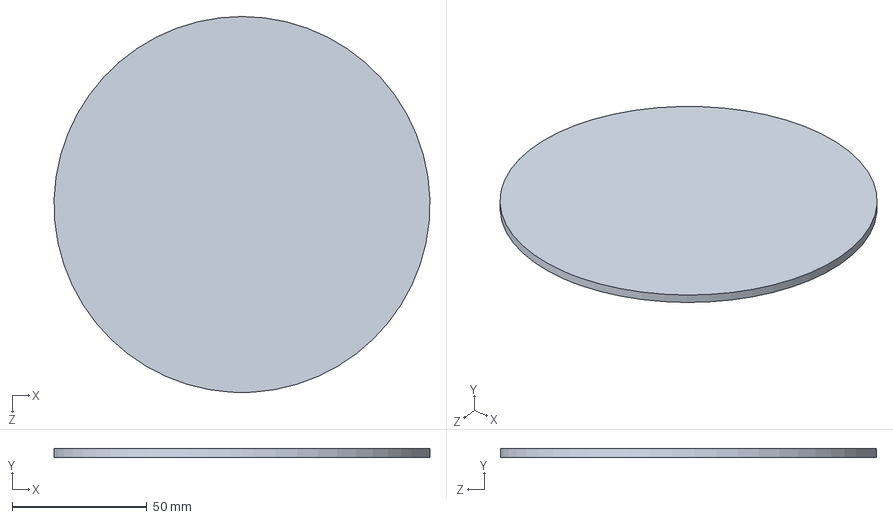
[picture p100: CAD file, 2019-02-26]
LV3.1/cad/Brainstorming/MH_Concepts/DCR_Concept5/Thesis4_base_plate.SLDPRT
139.6 x 3.17 x 139.7 mm
