psas/lv3.0-recovery/LV3.1/cad/Brainstorming/ST_CAP/ST_Cap.SLDPRT

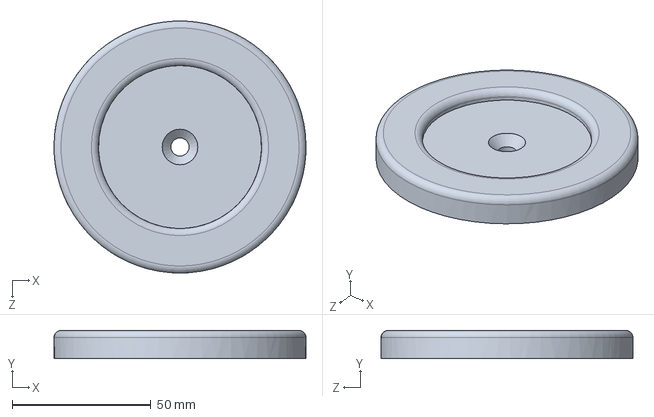
[picture p102: CAD file, 2019-05-19]
LV3.1/cad/Brainstorming/ST_CAP/ST_Cap.SLDPRT
90.9 x 10.2 x 90.9 mm
