psas/lv3.0-recovery/LV3.1/cad/for3dprinting/LinAct_Bracket_Front_rev1.SLDPRT

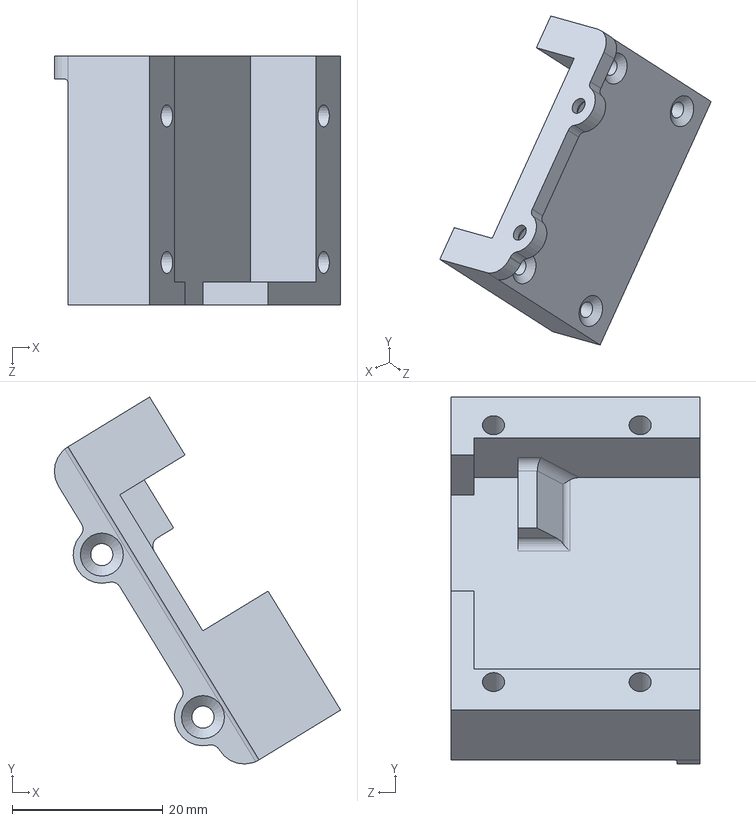
[picture p103: CAD file, 2019-12-07]
LV3.1/cad/for3dprinting/LinAct_Bracket_Front_rev1.SLDPRT
38.0 x 48.7 x 33.0 mm
