psas/lv3.0-recovery/LV3.1/cad/NCR_V3/Linear_actuator.SLDPRT

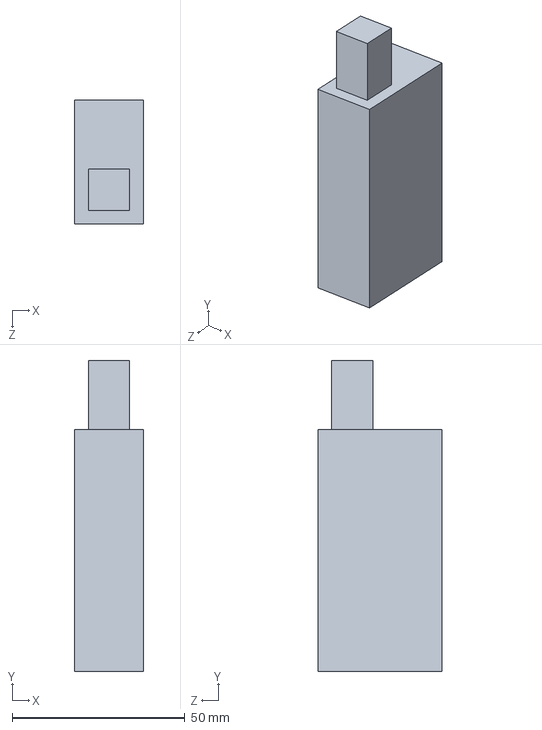
[picture p104: CAD file, 2019-05-19]
LV3.1/cad/NCR_V3/Linear_actuator.SLDPRT
20.0 x 90.0 x 36.0 mm
