psas/lv3.0-recovery/LV3.1/cad/Parachute_Cups/ERS_Parachute_System/Cup_Chute_Drogue^ERS_v3.0.SLDPRT

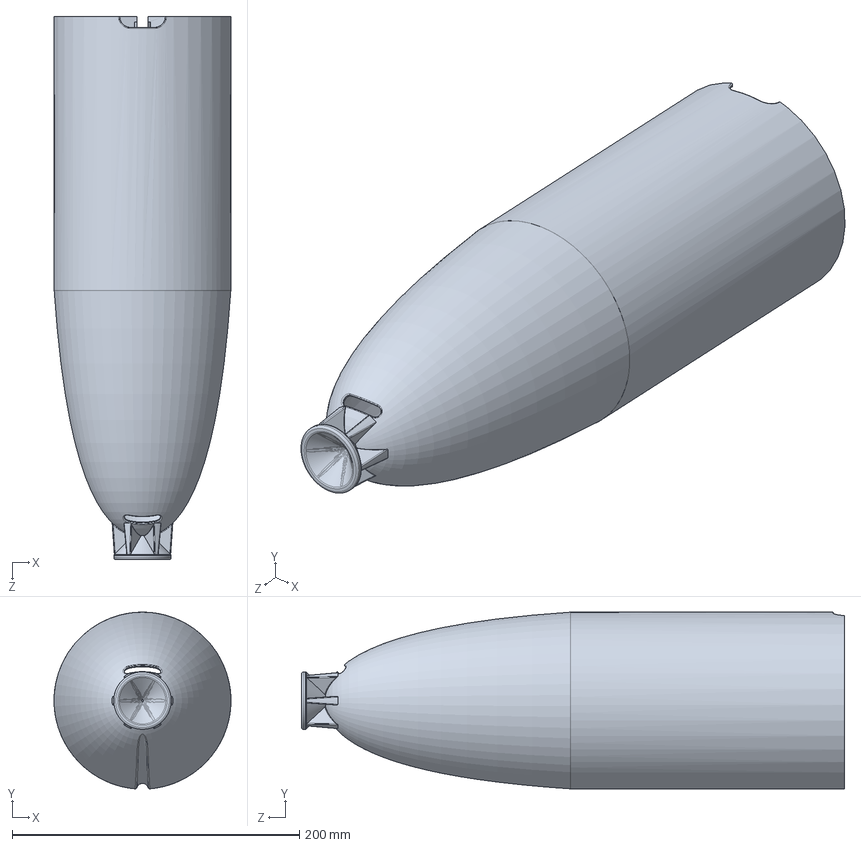
[picture p105: CAD file, 2019-08-06]
LV3.1/cad/Parachute_Cups/ERS_Parachute_System/Cup_Chute_Drogue^ERS_v3.0.SLDPRT
123.1 x 123.0 x 377.8 mm
