psas/lv3.0-recovery/LV3.1/cad/Parachute_Cups/pizza_table.1.SLDPRT

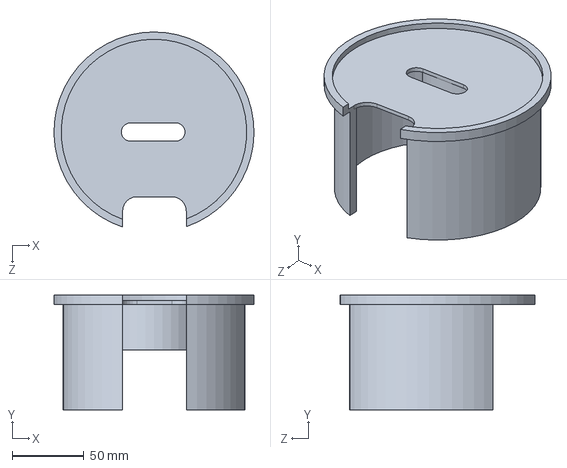
[picture p106: CAD file, 2019-04-16]
LV3.1/cad/Parachute_Cups/pizza_table.1.SLDPRT
139.7 x 80.0 x 136.2 mm
