psas/lv3.0-recovery/LV3.1/cad/twist_coupling_V3_skirt.SLDPRT

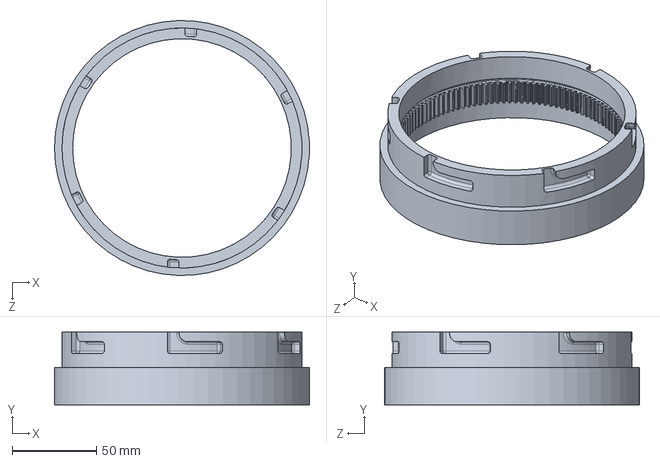
[picture p107: CAD file, 2019-11-09]
LV3.1/cad/twist_coupling_V3_skirt.SLDPRT
151.1 x 43.2 x 151.1 mm
