psas/lv3.0-recovery/LV3.1/Current_Ring/Bottom_ring.SLDPRT

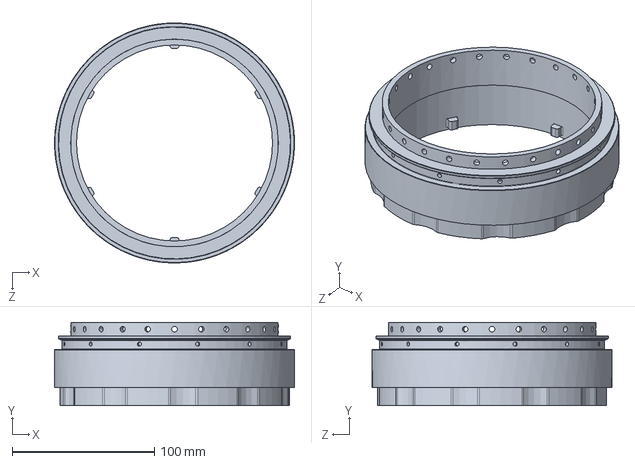
[picture p108: CAD file, 2019-04-05]
LV3.1/Current_Ring/Bottom_ring.SLDPRT
168.9 x 58.6 x 168.9 mm
