psas/lv3.0-recovery/LV3.1/Nose_cone/Nose_cone_top.SLDPRT

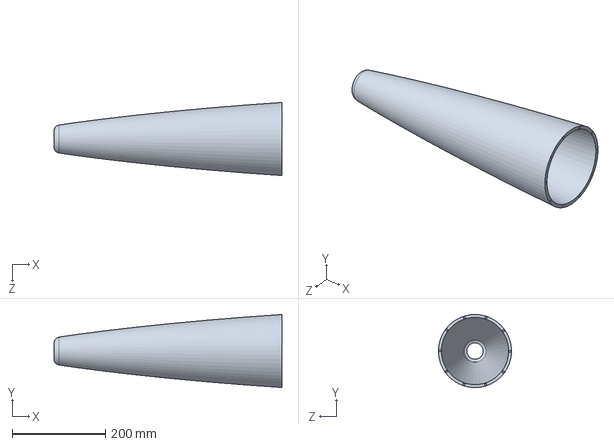
[picture p109: CAD file, 2019-02-26]
LV3.1/Nose_cone/Nose_cone_top.SLDPRT
489.9 x 157.0 x 157.1 mm
