psas/lv3.0-recovery/LV3.1/cad/Brainstorming/GG_Concept1/Concept_Upper.SLDPRT

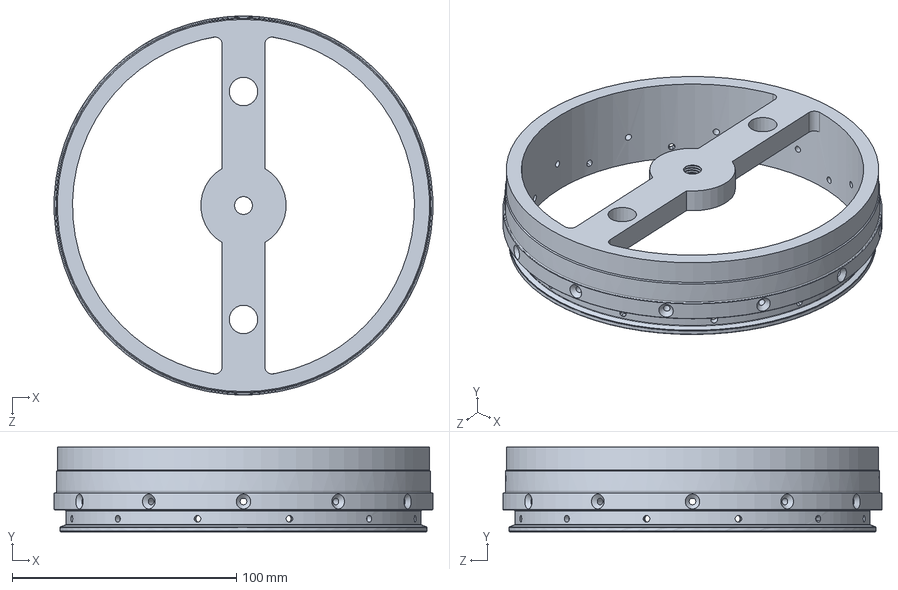
[picture p110: CAD file, 2019-02-19]
LV3.1/cad/Brainstorming/GG_Concept1/Concept_Upper.SLDPRT
168.9 x 37.7 x 168.9 mm
