psas/lv3.0-recovery/LV3.1/cad/Brainstorming/GG_Concept2/Linkage.sldprt

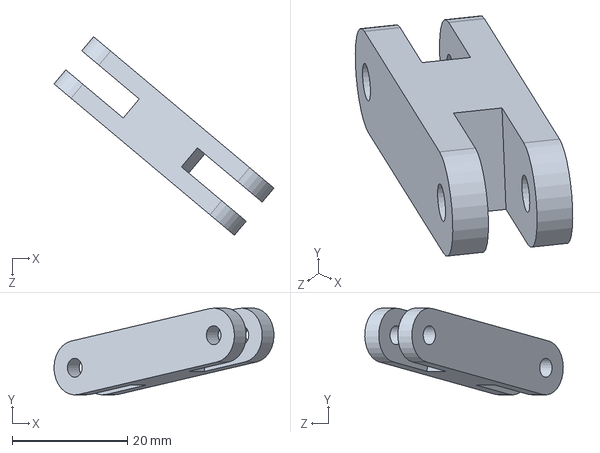
[picture p111: CAD file, 2019-02-19]
LV3.1/cad/Brainstorming/GG_Concept2/Linkage.sldprt
38.1 x 15.0 x 34.4 mm
