psas/lv3.0-recovery/LV3.1/cad/Brainstorming/GG_Full_Mockup/clampArc.SLDPRT

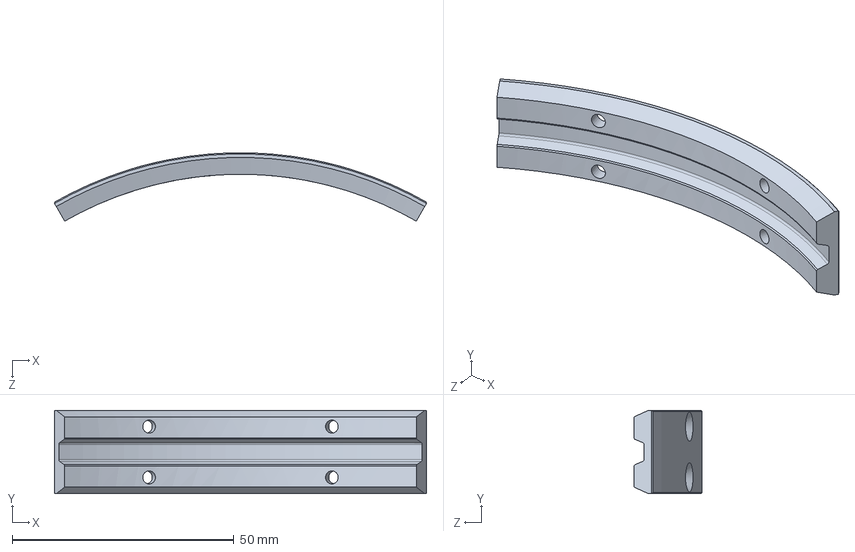
[picture p112: CAD file, 2019-04-28]
LV3.1/cad/Brainstorming/GG_Full_Mockup/clampArc.SLDPRT
83.9 x 18.8 x 15.4 mm
