psas/lv3.0-recovery/LV3.1/cad/Brainstorming/MH_Concepts/DCR_Concept2/Thesis1_plunger.SLDPRT

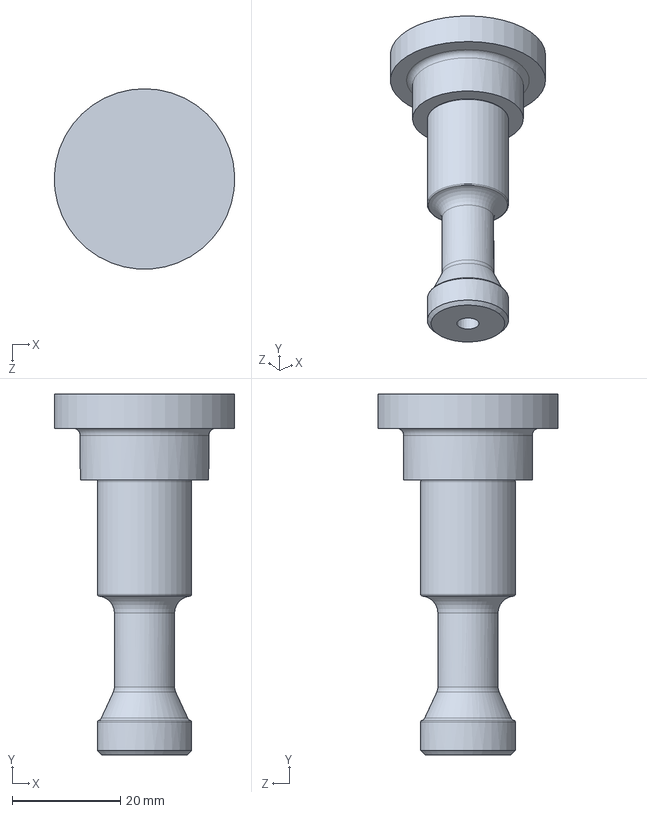
[picture p113: CAD file, 2019-02-26]
LV3.1/cad/Brainstorming/MH_Concepts/DCR_Concept2/Thesis1_plunger.SLDPRT
33.3 x 66.7 x 33.3 mm
