psas/lv3.0-recovery/LV3.1/cad/Brainstorming/MH_Concepts/DCR_Concept5/Thesis4_solenoid_housing.SLDPRT

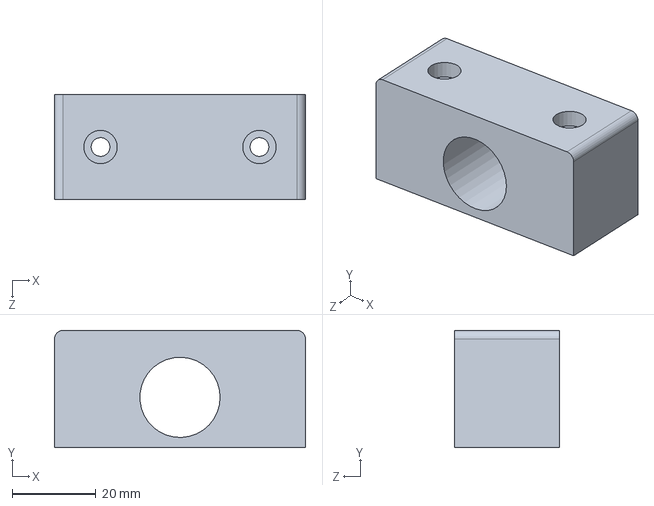
[picture p114: CAD file, 2019-02-26]
LV3.1/cad/Brainstorming/MH_Concepts/DCR_Concept5/Thesis4_solenoid_housing.SLDPRT
60.0 x 28.0 x 25.0 mm
