psas/lv3.0-recovery/LV3.1/cad/Brainstorming/MH_Concepts/SMA_Protos/Proto1_base.SLDPRT

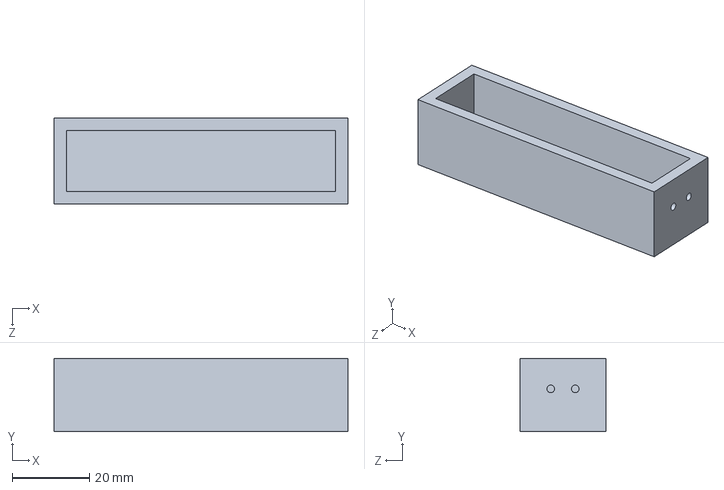
[picture p115: CAD file, 2019-02-19]
LV3.1/cad/Brainstorming/MH_Concepts/SMA_Protos/Proto1_base.SLDPRT
76.2 x 19.1 x 22.2 mm
