psas/lv3.0-recovery/LV3.1/cad/Brainstorming/ST_CAP/ST_Bottom.SLDPRT

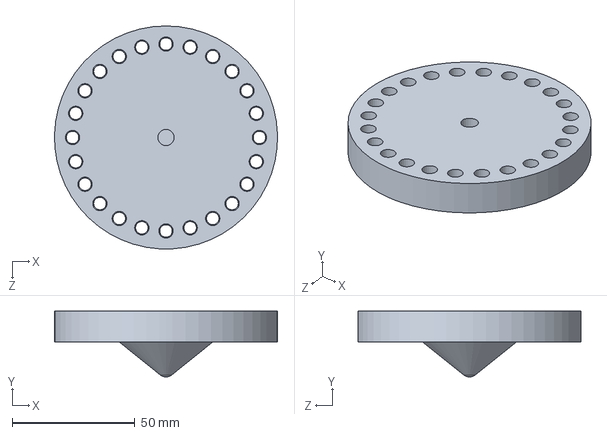
[picture p116: CAD file, 2019-05-19]
LV3.1/cad/Brainstorming/ST_CAP/ST_Bottom.SLDPRT
90.9 x 26.9 x 90.9 mm
