psas/lv3.0-recovery/LV3.1/cad/circuitboard/pcb.SLDPRT

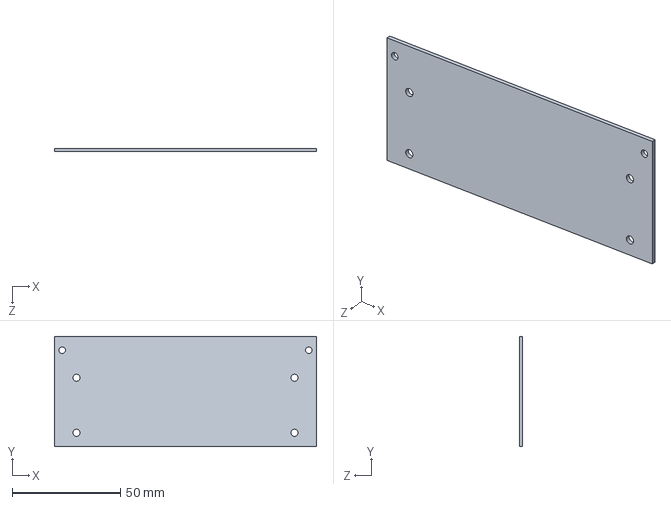
[picture p117: CAD file, 2019-12-06]
LV3.1/cad/circuitboard/pcb.SLDPRT
120.9 x 50.8 x 1.60 mm
