psas/lv3.0-recovery/LV3.1/cad/for3dprinting/PIZZA_v4.2.SLDPRT

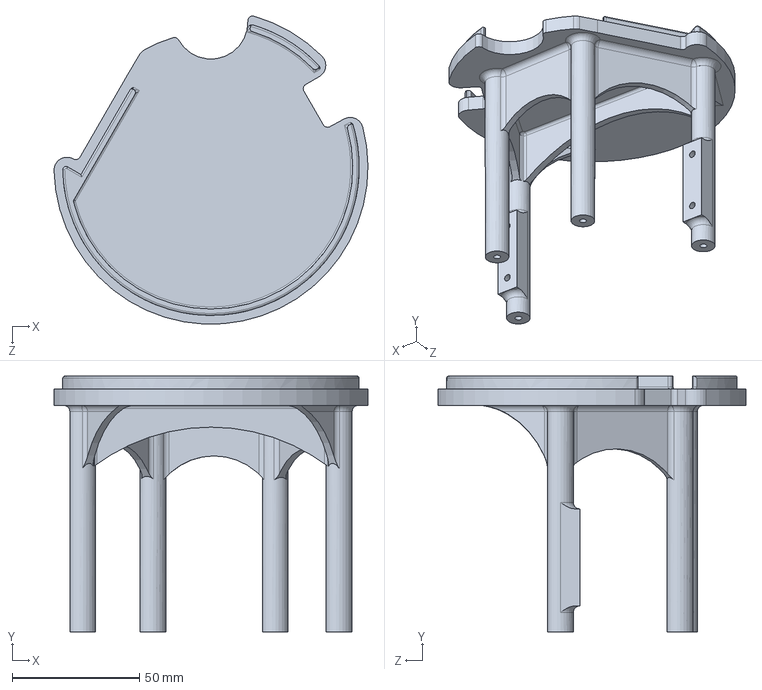
[picture p118: CAD file, 2019-12-06]
LV3.1/cad/for3dprinting/PIZZA_v4.2.SLDPRT
123.2 x 100.3 x 120.8 mm
