psas/lv3.0-recovery/LV3.1/cad/for3dprinting/STEPfiles/spacerRing.STEP

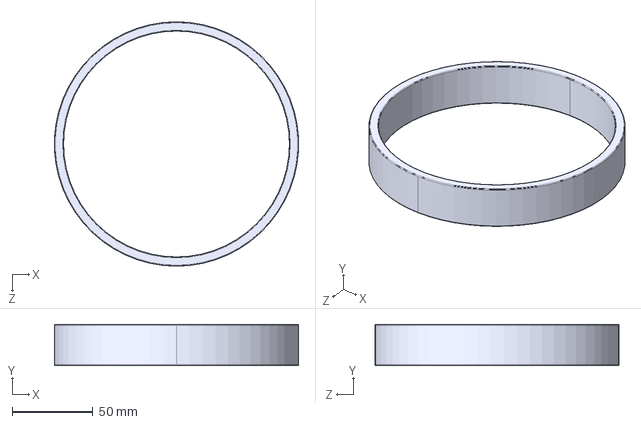
[picture p119: CAD file, 2019-11-19]
LV3.1/cad/for3dprinting/STEPfiles/spacerRing.STEP
150.9 x 25.4 x 151.1 mm
