psas/lv3.0-recovery/LV3.1/cad/Parachute_Cups/pizza_table.SLDPRT

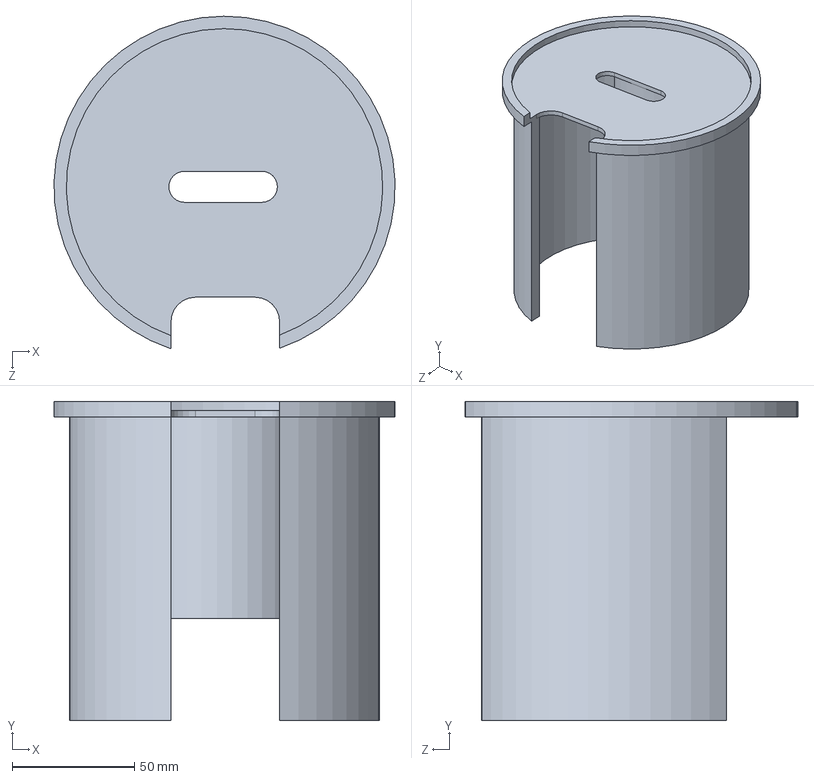
[picture p120: CAD file, 2019-04-12]
LV3.1/cad/Parachute_Cups/pizza_table.SLDPRT
139.6 x 130.8 x 136.2 mm
