psas/lv3.0-recovery/LV3.1/Nose_cone/Nose_cone_bot.SLDPRT

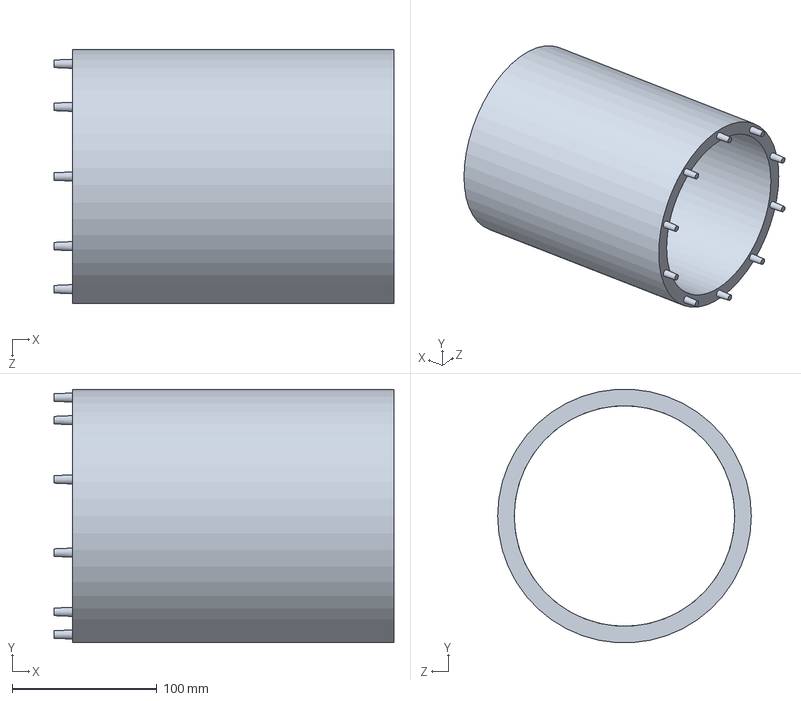
[picture p121: CAD file, 2019-02-26]
LV3.1/Nose_cone/Nose_cone_bot.SLDPRT
234.9 x 174.9 x 175.3 mm
