psas/lv3.0-recovery/LV3.1/cad/Brainstorming/GG_Concept1/pretend_motor.SLDPRT

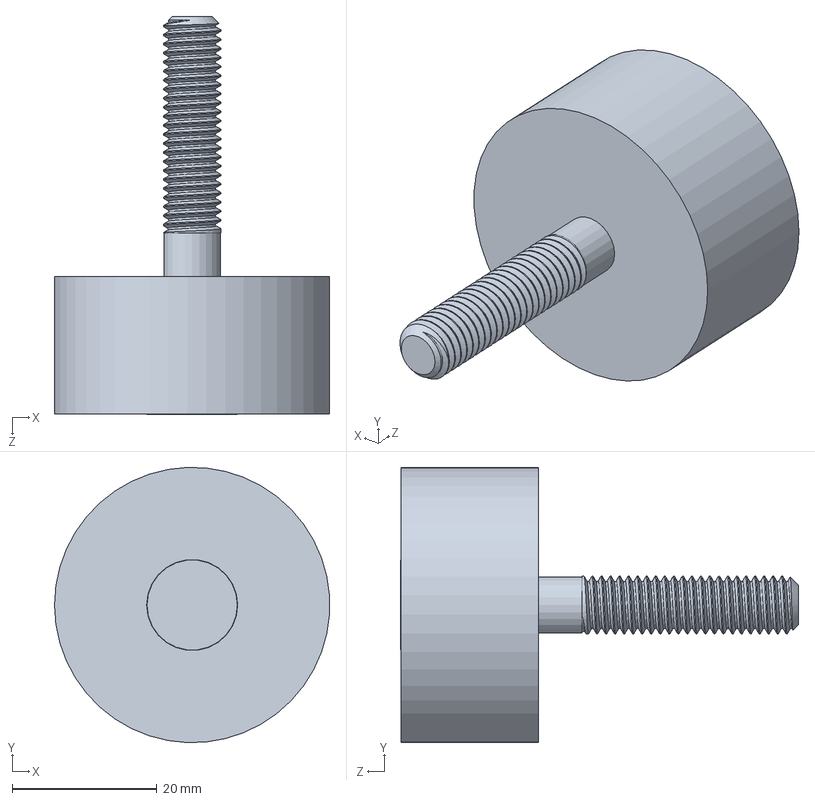
[picture p122: CAD file, 2019-02-19]
LV3.1/cad/Brainstorming/GG_Concept1/pretend_motor.SLDPRT
38.1 x 38.1 x 55.1 mm
