psas/lv3.0-recovery/LV3.1/cad/Brainstorming/GG_Concept2/Ring_Concept.SLDPRT

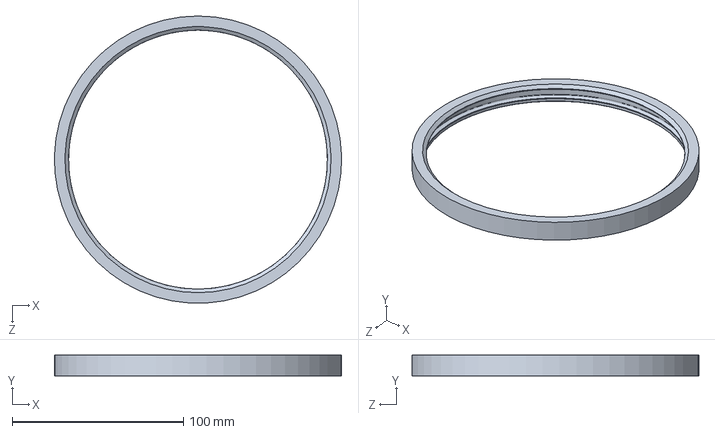
[picture p123: CAD file, 2019-02-19]
LV3.1/cad/Brainstorming/GG_Concept2/Ring_Concept.SLDPRT
167.6 x 12.0 x 167.5 mm
