psas/lv3.0-recovery/LV3.1/cad/Brainstorming/GG_Full_Mockup/nosePlug2.sldprt

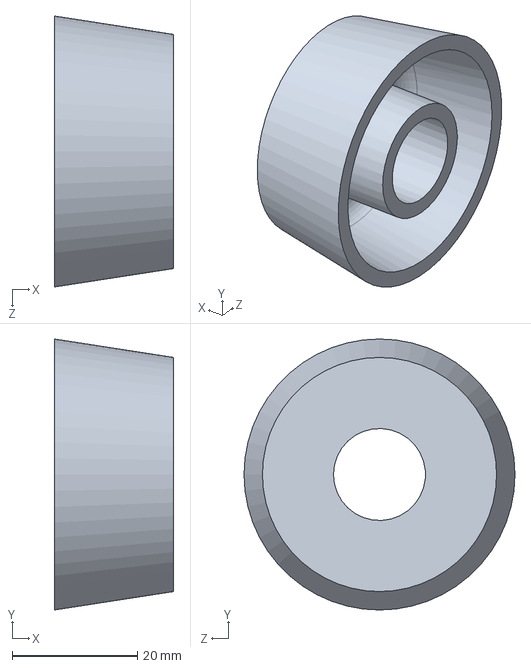
[picture p124: CAD file, 2019-04-28]
LV3.1/cad/Brainstorming/GG_Full_Mockup/nosePlug2.sldprt
19.1 x 43.3 x 43.3 mm
