psas/lv3.0-recovery/LV3.1/cad/Brainstorming/GG_WIP/Lower_Ring.SLDPRT

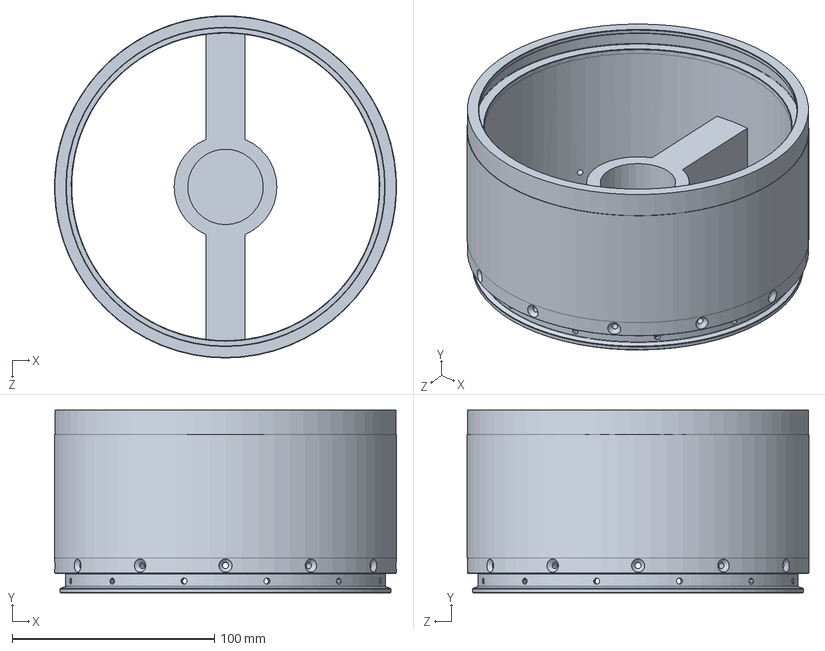
[picture p125: CAD file, 2019-02-19]
LV3.1/cad/Brainstorming/GG_WIP/Lower_Ring.SLDPRT
169.1 x 90.3 x 169.1 mm
