psas/lv3.0-recovery/LV3.1/cad/Brainstorming/GW_Concepts/inner ring Rocket Shute deployment.SLDPRT

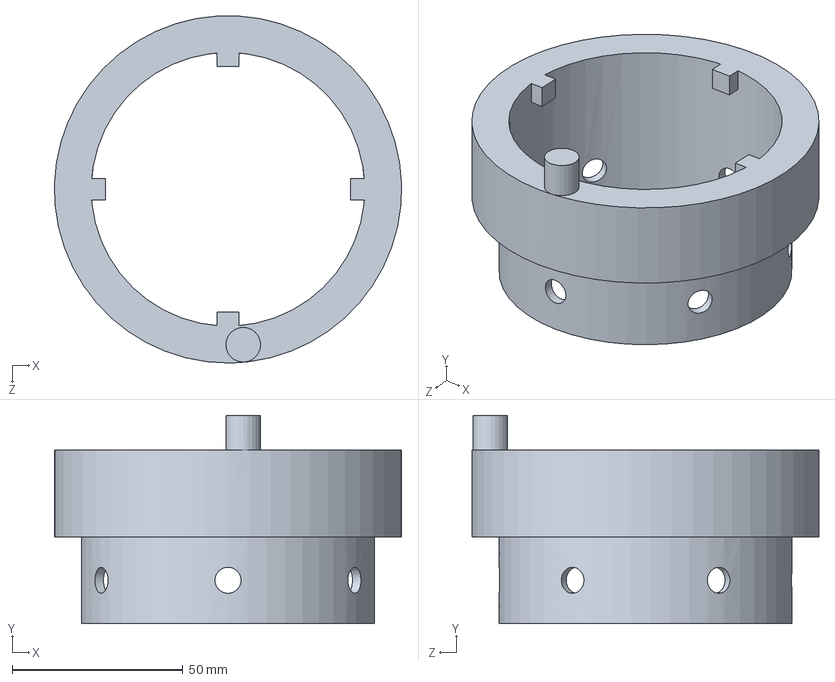
[picture p126: CAD file, 2019-04-04]
LV3.1/cad/Brainstorming/GW_Concepts/inner ring Rocket Shute deployment.SLDPRT
101.6 x 61.0 x 101.5 mm
