psas/lv3.0-recovery/LV3.1/cad/Brainstorming/MH_Concepts/DCR_Concept2/Thesis1_sleeve.SLDPRT

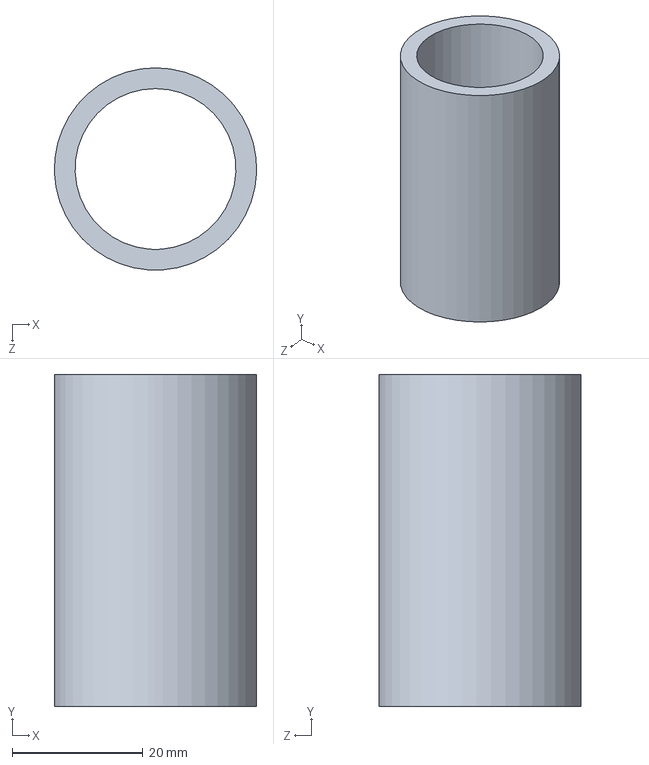
[picture p127: CAD file, 2019-02-19]
LV3.1/cad/Brainstorming/MH_Concepts/DCR_Concept2/Thesis1_sleeve.SLDPRT
30.9 x 50.8 x 31.0 mm
