psas/lv3.0-recovery/LV3.1/cad/circuitboard/sensor.SLDPRT

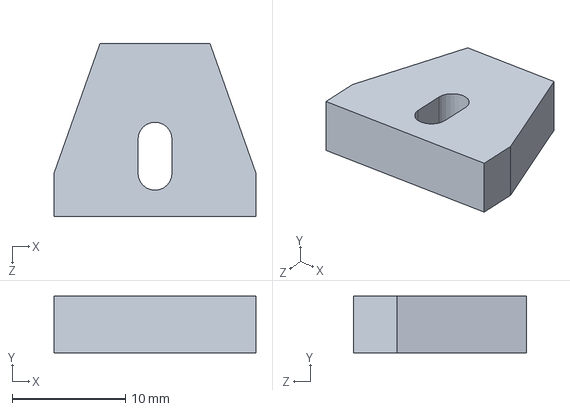
[picture p129: CAD file, 2019-12-06]
LV3.1/cad/circuitboard/sensor.SLDPRT
17.8 x 5.00 x 15.2 mm
