psas/lv3.0-recovery/LV3.1/cad/for3dprinting/MotorHousingClamshellrev1.SLDPRT

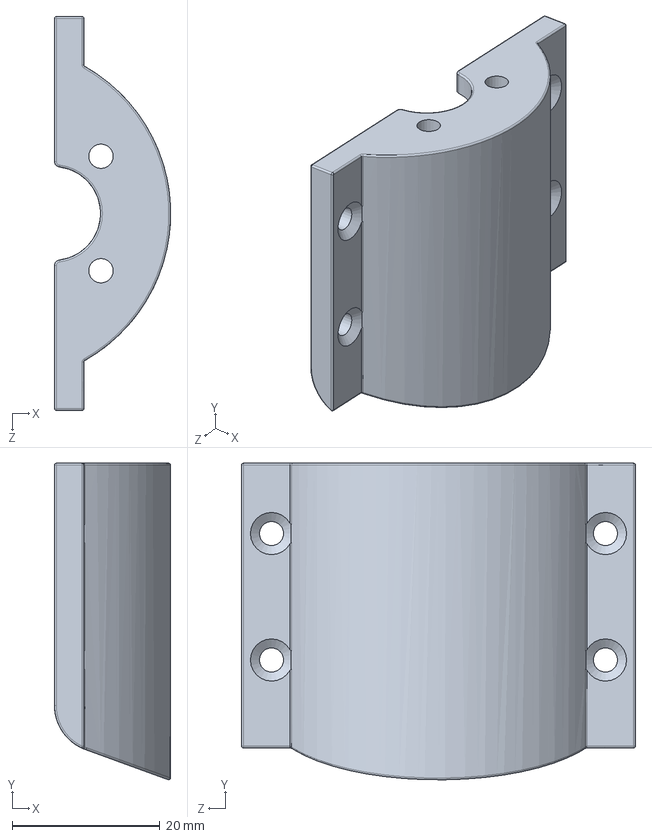
[picture p130: CAD file, 2019-12-06]
LV3.1/cad/for3dprinting/MotorHousingClamshellrev1.SLDPRT
15.7 x 42.9 x 53.3 mm
