psas/lv3.0-recovery/LV3.1/cad/for3dprinting/STEPfiles/MotorHousingClamshell.STEP

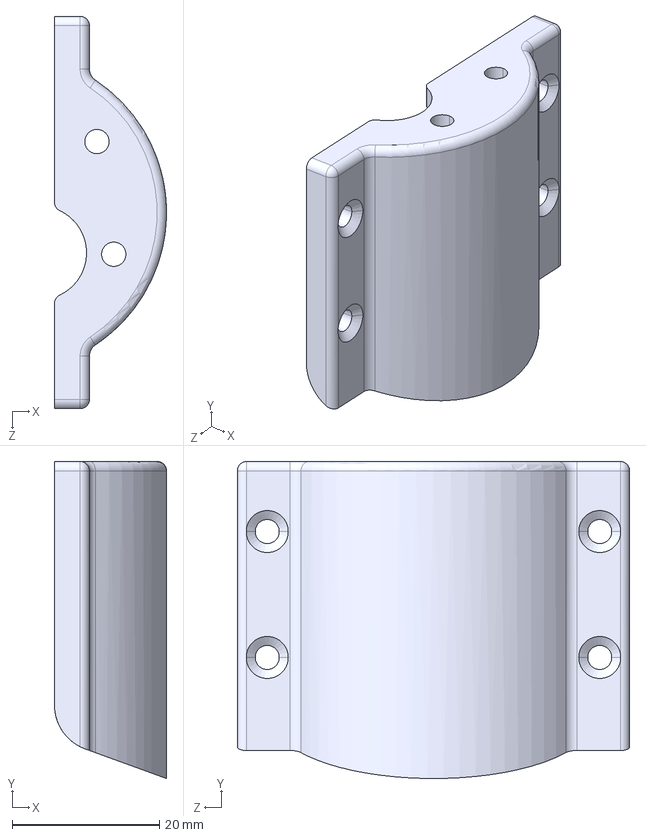
[picture p131: CAD file, 2019-11-19]
LV3.1/cad/for3dprinting/STEPfiles/MotorHousingClamshell.STEP
15.2 x 43.1 x 53.3 mm
