psas/lv3.0-recovery/LV3.1/cad/formachining/standoff_withmount.STEP

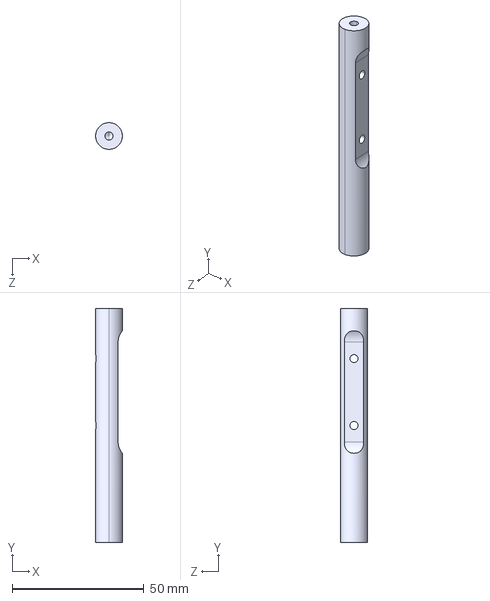
[picture p132: CAD file, 2019-11-11]
LV3.1/cad/formachining/standoff_withmount.STEP
10.2 x 88.9 x 10.2 mm
