psas/lv3.0-recovery/LV3.1/cad/NCR_V3/motor_bracket_sheetmetal_V3.SLDPRT

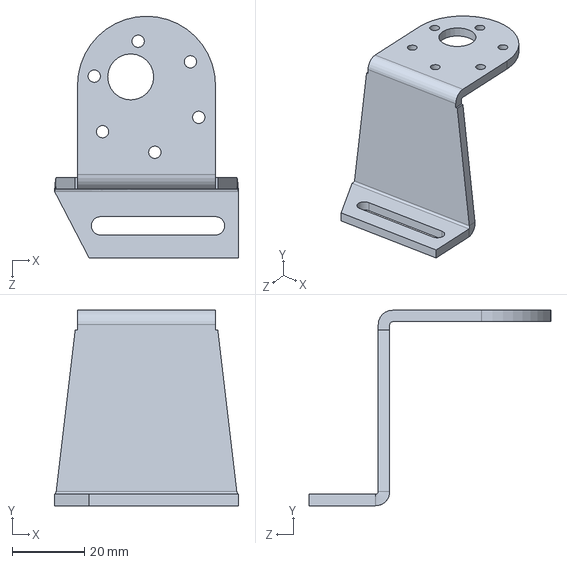
[picture p133: CAD file, 2019-05-19]
LV3.1/cad/NCR_V3/motor_bracket_sheetmetal_V3.SLDPRT
50.8 x 54.0 x 66.7 mm
