psas/lv3.0-recovery/LV3.1/cad/Parachute_Cups/Cup_Chute_Drogue^eNSR_v2.2.SLDPRT

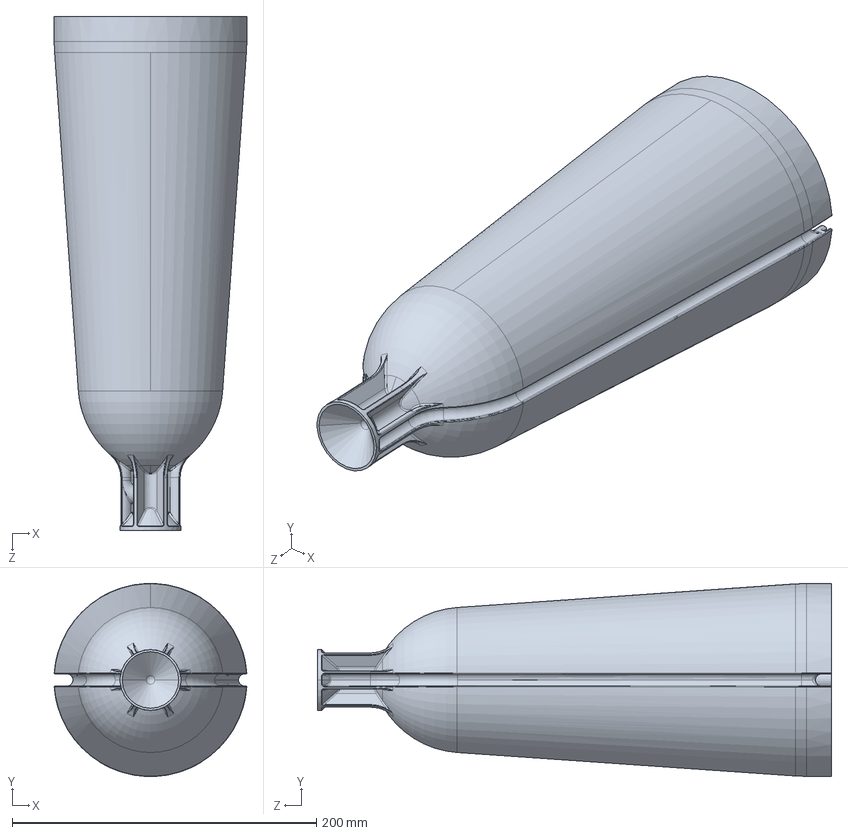
[picture p134: CAD file, 2019-04-02]
LV3.1/cad/Parachute_Cups/Cup_Chute_Drogue^eNSR_v2.2.SLDPRT
126.7 x 127.0 x 338.0 mm
