psas/lv3.0-recovery/LV3.1/Nose_cone/Nose_cone_mid.SLDPRT

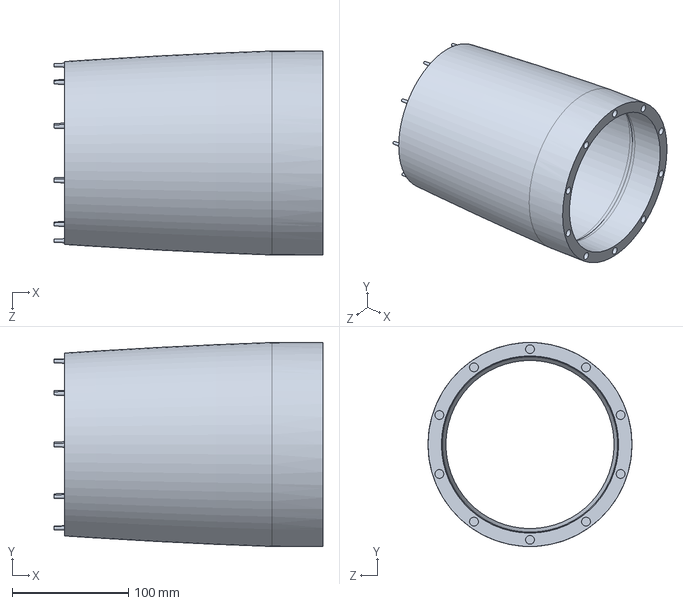
[picture p135: CAD file, 2019-02-26]
LV3.1/Nose_cone/Nose_cone_mid.SLDPRT
231.1 x 175.3 x 175.3 mm
