psas/lv3.0-recovery/LV3.1/cad/AssemblyV3.2/PIZZA_v3.0_split.SLDPRT

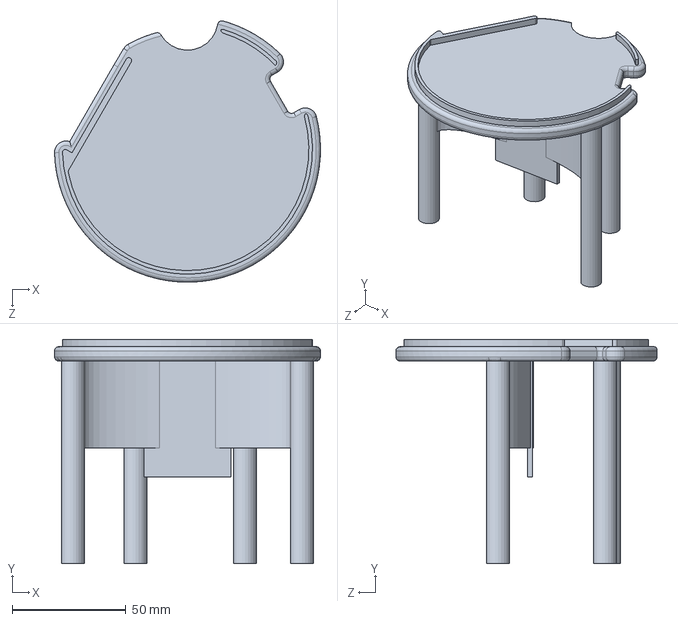
[picture p136: CAD file, 2019-12-06]
LV3.1/cad/AssemblyV3.2/PIZZA_v3.0_split.SLDPRT
116.8 x 98.4 x 114.8 mm
