psas/lv3.0-recovery/LV3.1/cad/Base_11_mockup/kepper ring - Base 11.SLDPRT

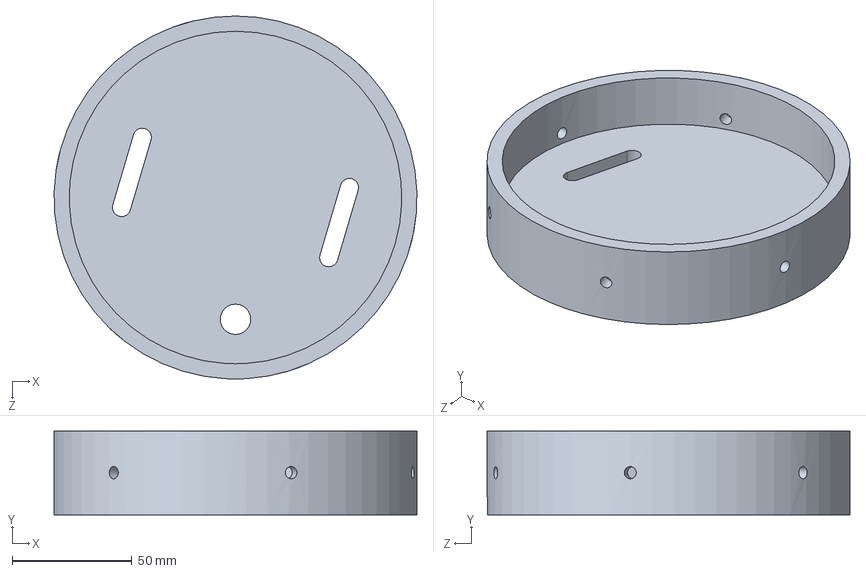
[picture p137: CAD file, 2019-04-02]
LV3.1/cad/Base_11_mockup/kepper ring - Base 11.SLDPRT
151.3 x 34.9 x 151.4 mm
