psas/lv3.0-recovery/LV3.1/cad/Brainstorming/GG_Concept1/Concept_Lower.SLDPRT

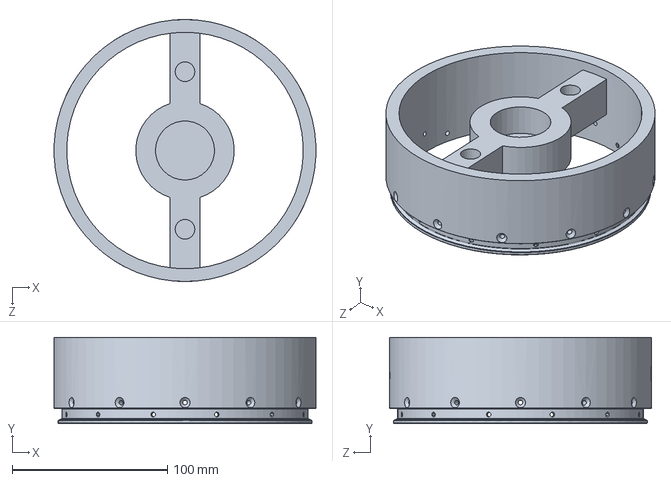
[picture p138: CAD file, 2019-02-19]
LV3.1/cad/Brainstorming/GG_Concept1/Concept_Lower.SLDPRT
168.9 x 55.5 x 168.9 mm
