psas/lv3.0-recovery/LV3.1/cad/Brainstorming/GG_Concept2/Carriage.SLDPRT

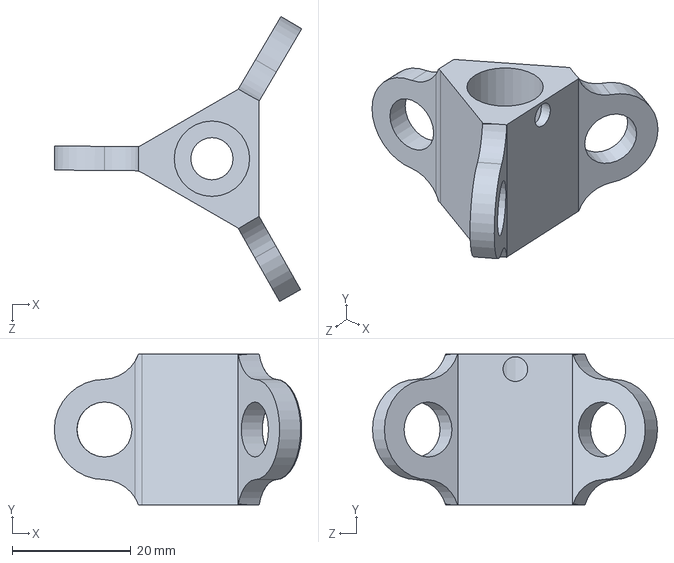
[picture p139: CAD file, 2019-02-19]
LV3.1/cad/Brainstorming/GG_Concept2/Carriage.SLDPRT
41.7 x 25.4 x 48.0 mm
