psas/lv3.0-recovery/LV3.1/cad/Brainstorming/GW_Concepts/ball baring.SLDPRT

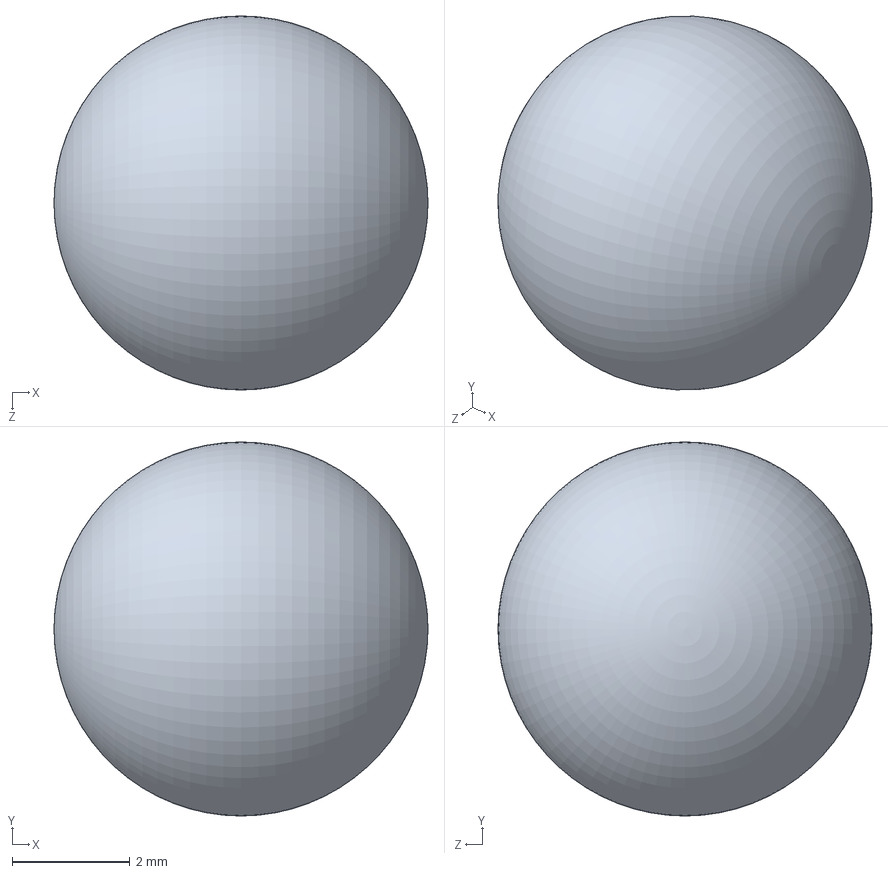
[picture p140: CAD file, 2019-04-04]
LV3.1/cad/Brainstorming/GW_Concepts/ball baring.SLDPRT
6.35 x 6.35 x 6.35 mm
