psas/lv3.0-recovery/LV3.1/cad/Brainstorming/MH_Concepts/DCR_Concept2/Thesis1_plunger_small.SLDPRT

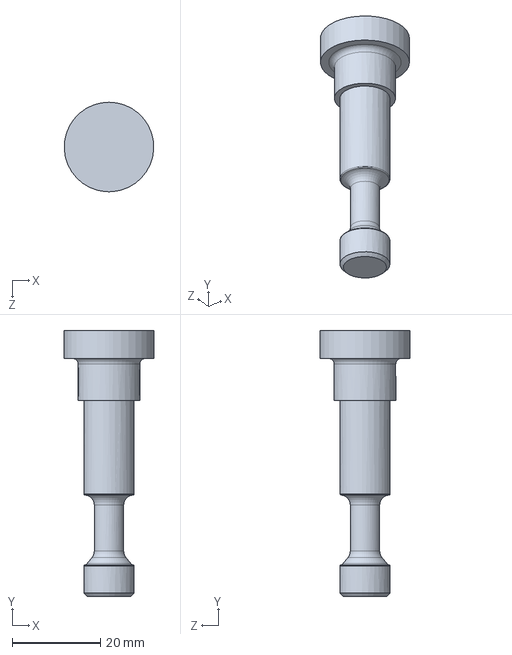
[picture p141: CAD file, 2019-02-19]
LV3.1/cad/Brainstorming/MH_Concepts/DCR_Concept2/Thesis1_plunger_small.SLDPRT
20.3 x 60.3 x 20.3 mm
