psas/lv3.0-recovery/LV3.1/cad/Brainstorming/MH_Concepts/DCR_Concept5/Thesis4_pin_block.SLDPRT

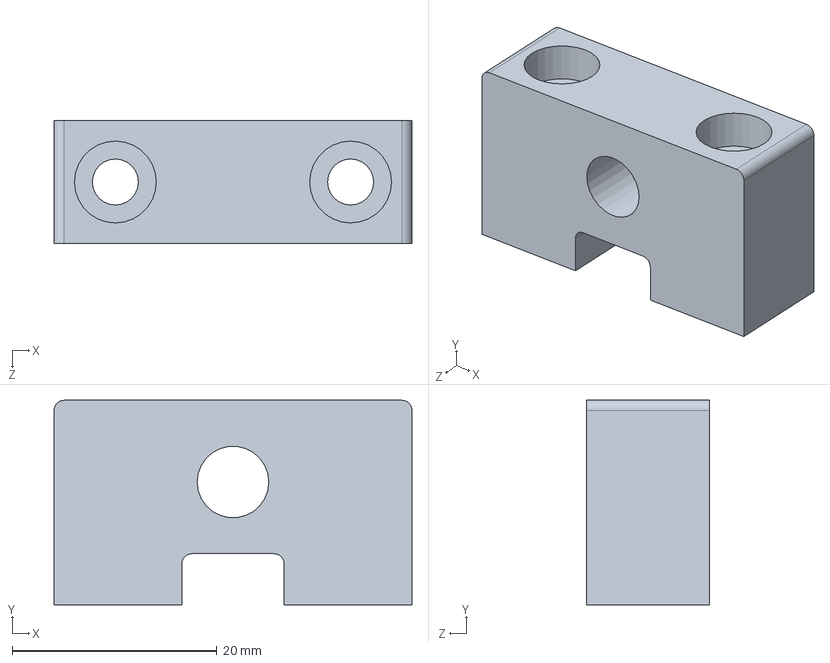
[picture p142: CAD file, 2019-02-26]
LV3.1/cad/Brainstorming/MH_Concepts/DCR_Concept5/Thesis4_pin_block.SLDPRT
35.0 x 20.0 x 12.0 mm
