psas/lv3.0-recovery/LV3.1/cad/formachining/twist_coupling_V4_skirt.STEP

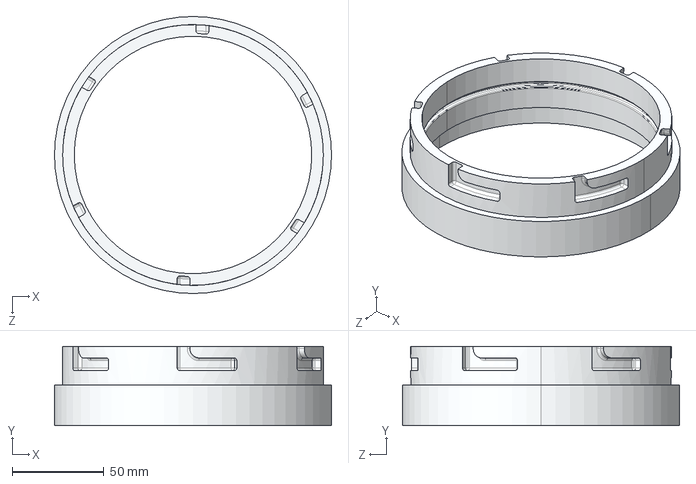
[picture p143: CAD file, 2019-11-11]
LV3.1/cad/formachining/twist_coupling_V4_skirt.STEP
151.1 x 43.2 x 151.1 mm
