psas/lv3.0-recovery/LV3.1/cad/NCR_V3/anchor_rod.SLDPRT

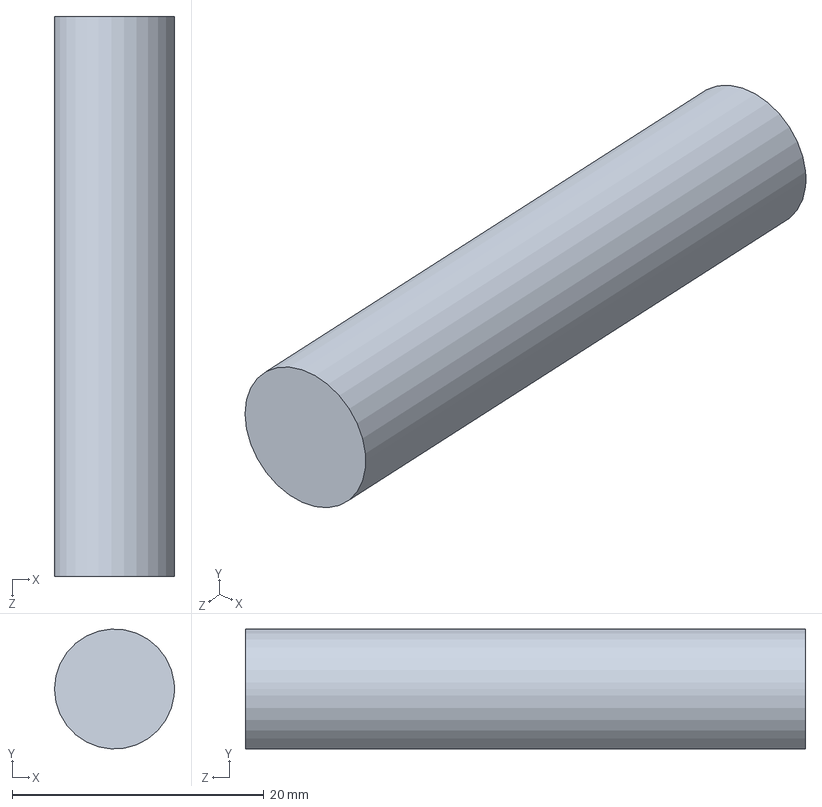
[picture p144: CAD file, 2019-05-19]
LV3.1/cad/NCR_V3/anchor_rod.SLDPRT
9.53 x 9.51 x 44.5 mm
