psas/lv3.0-recovery/LV3.1/Nose_cone/Nose_cone_top.2.SLDPRT

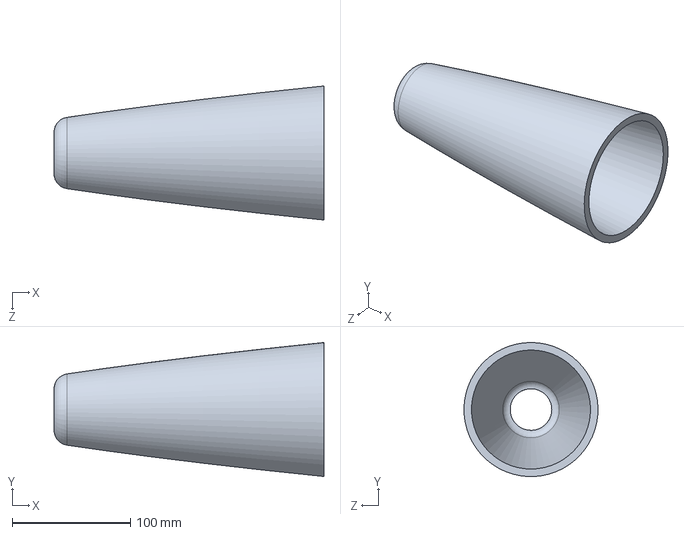
[picture p145: CAD file, 2019-02-26]
LV3.1/Nose_cone/Nose_cone_top.2.SLDPRT
228.6 x 113.5 x 113.5 mm
