psas/lv3.0-recovery/LV3.1/cad/AssemblyV3.2/keeper_ring_V3.SLDPRT

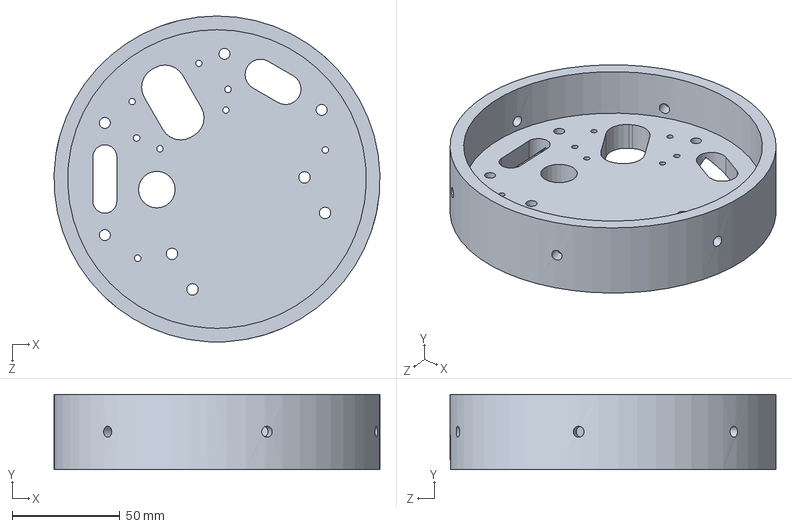
[picture p146: CAD file, 2019-12-06]
LV3.1/cad/AssemblyV3.2/keeper_ring_V3.SLDPRT
151.3 x 34.9 x 151.4 mm
