psas/lv3.0-recovery/LV3.1/cad/Base_11_mockup/drogue_chute.SLDPRT

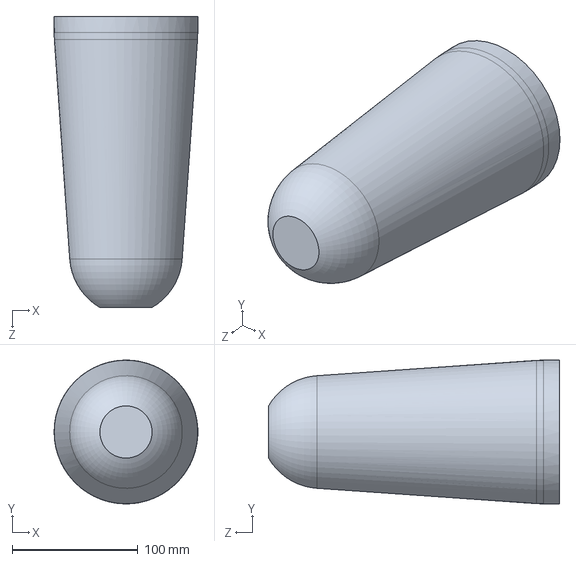
[picture p147: CAD file, 2019-04-02]
LV3.1/cad/Base_11_mockup/drogue_chute.SLDPRT
114.3 x 114.3 x 231.3 mm
