psas/lv3.0-recovery/LV3.1/cad/Brainstorming/GG_Concept1/Alignment_Pins.SLDPRT

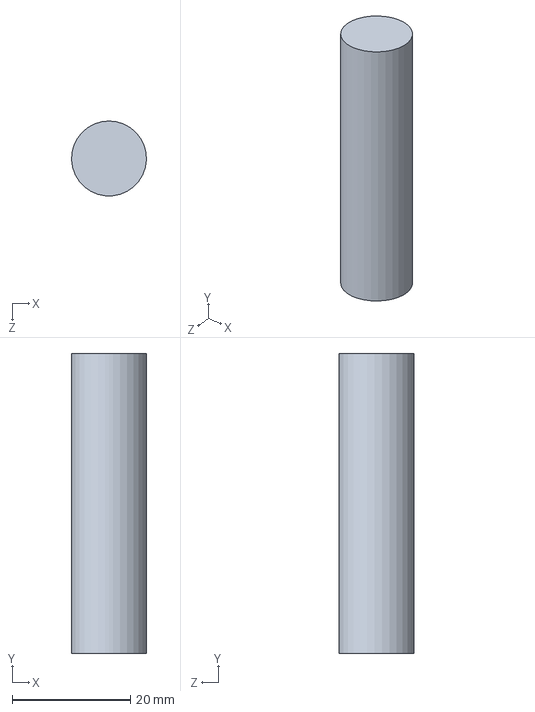
[picture p148: CAD file, 2019-02-19]
LV3.1/cad/Brainstorming/GG_Concept1/Alignment_Pins.SLDPRT
12.7 x 50.8 x 12.7 mm
