psas/lv3.0-recovery/LV3.1/cad/Brainstorming/GG_Concept2/Clamp_Ring_Concept.SLDPRT

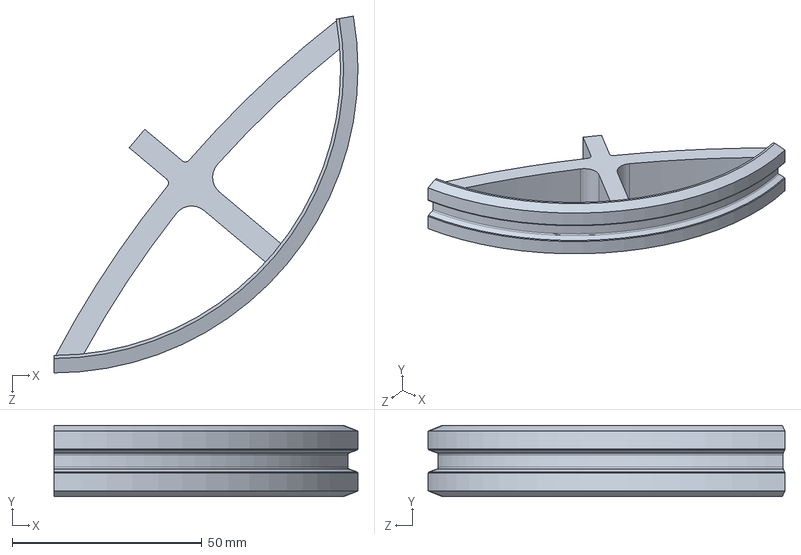
[picture p149: CAD file, 2019-02-19]
LV3.1/cad/Brainstorming/GG_Concept2/Clamp_Ring_Concept.SLDPRT
80.1 x 18.8 x 94.0 mm
