psas/lv3.0-recovery/LV3.1/cad/Brainstorming/GW_Concepts/inner_ring_rsd2.SLDPRT

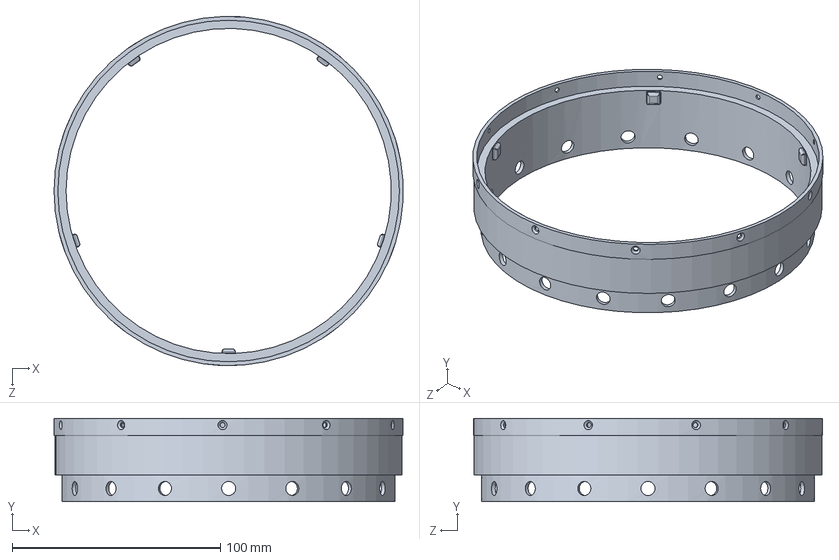
[picture p150: CAD file, 2019-04-04]
LV3.1/cad/Brainstorming/GW_Concepts/inner_ring_rsd2.SLDPRT
167.5 x 40.0 x 167.6 mm
