psas/lv3.0-recovery/LV3.1/cad/Brainstorming/MH_Concepts/DCR_Concept1/Thesis3_plunger.SLDPRT

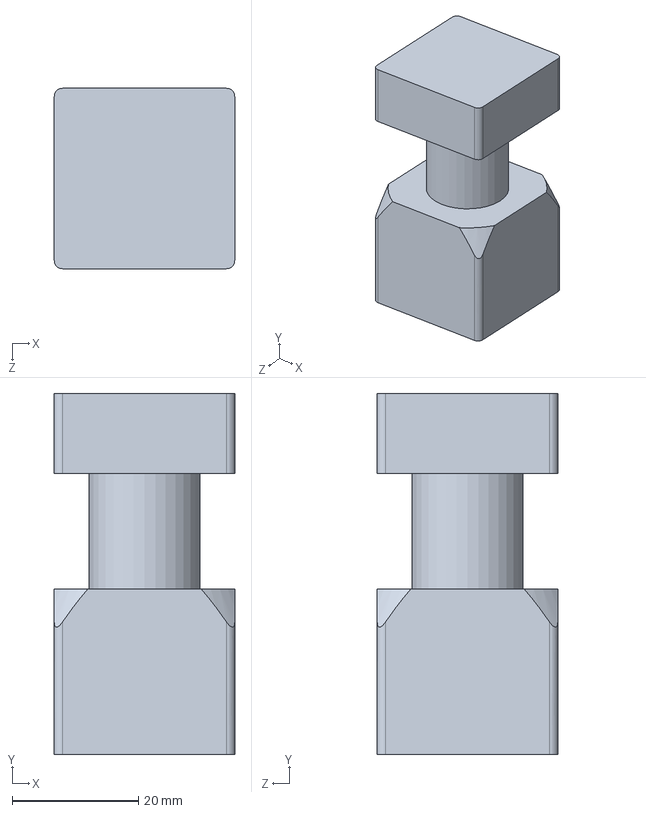
[picture p151: CAD file, 2019-02-26]
LV3.1/cad/Brainstorming/MH_Concepts/DCR_Concept1/Thesis3_plunger.SLDPRT
28.6 x 57.1 x 28.6 mm
