psas/lv3.0-recovery/LV3.1/cad/Brainstorming/MH_Concepts/DCR_Concept2/Thesis1_socket.SLDPRT

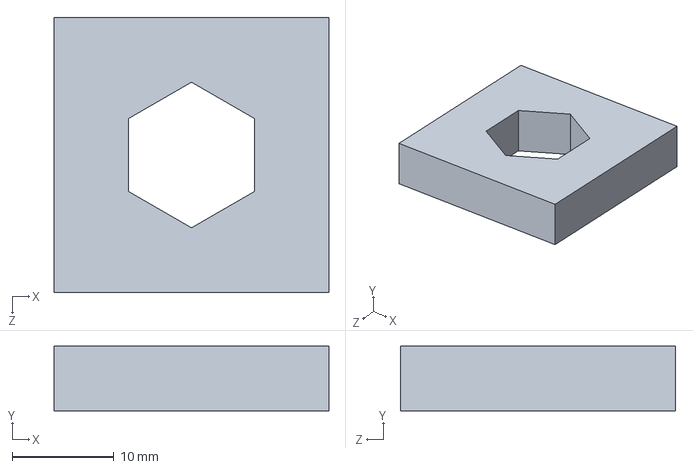
[picture p152: CAD file, 2019-02-19]
LV3.1/cad/Brainstorming/MH_Concepts/DCR_Concept2/Thesis1_socket.SLDPRT
27.0 x 6.35 x 27.0 mm
