psas/lv3.0-recovery/LV3.1/cad/Brainstorming/MH_Concepts/DCR_Concept3/Thesis2_housing.SLDPRT

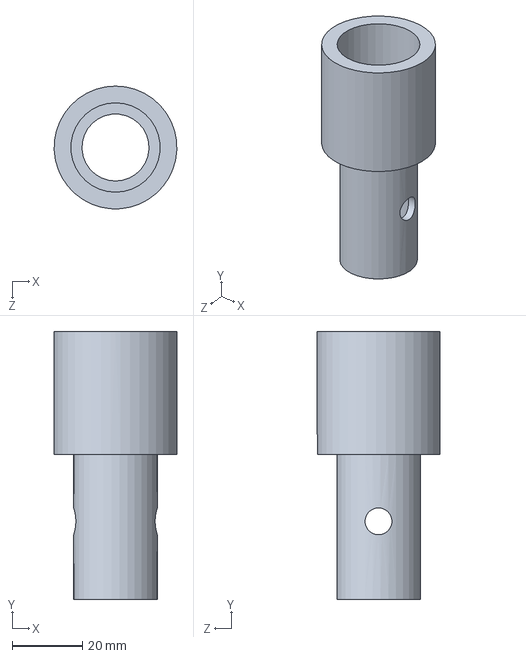
[picture p153: CAD file, 2019-02-19]
LV3.1/cad/Brainstorming/MH_Concepts/DCR_Concept3/Thesis2_housing.SLDPRT
34.9 x 76.2 x 34.9 mm
