psas/lv3.0-recovery/LV3.1/cad/NCR_V3/battery.SLDPRT

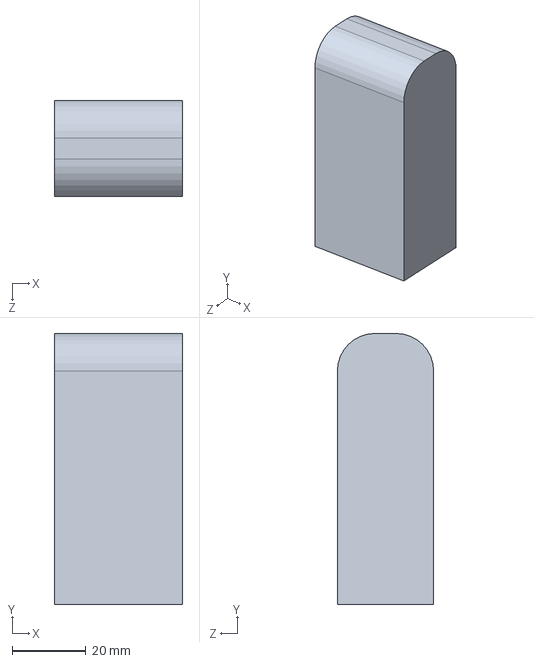
[picture p154: CAD file, 2019-05-19]
LV3.1/cad/NCR_V3/battery.SLDPRT
34.8 x 73.7 x 26.2 mm
