psas/lv3.0-recovery/LV3.1/cad/AssemblyV3.2/grommet_V1.SLDPRT

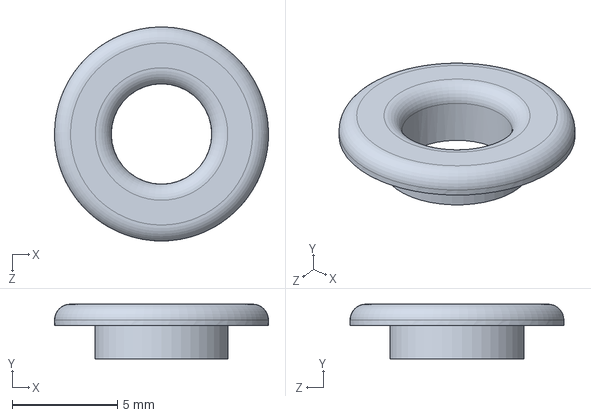
[picture p155: CAD file, 2019-12-06]
LV3.1/cad/AssemblyV3.2/grommet_V1.SLDPRT
10.2 x 2.60 x 10.2 mm
