psas/lv3.0-recovery/LV3.1/cad/Brainstorming/GG_Concept2/Dowell_Pin_1.SLDPRT

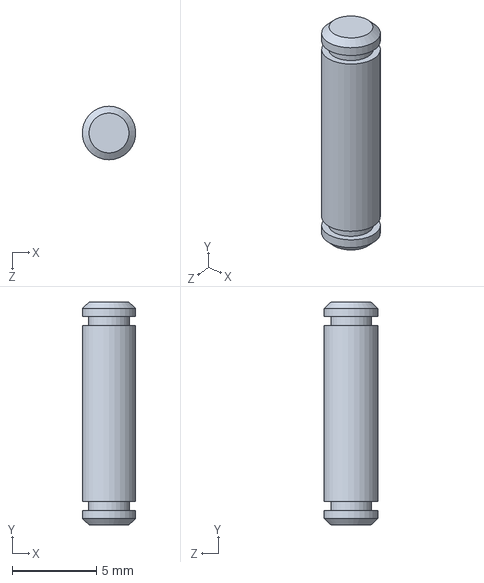
[picture p156: CAD file, 2019-02-19]
LV3.1/cad/Brainstorming/GG_Concept2/Dowell_Pin_1.SLDPRT
3.16 x 13.2 x 3.17 mm
