psas/lv3.0-recovery/LV3.1/cad/Brainstorming/GW_Concepts/outer_ring_rsd2.SLDPRT

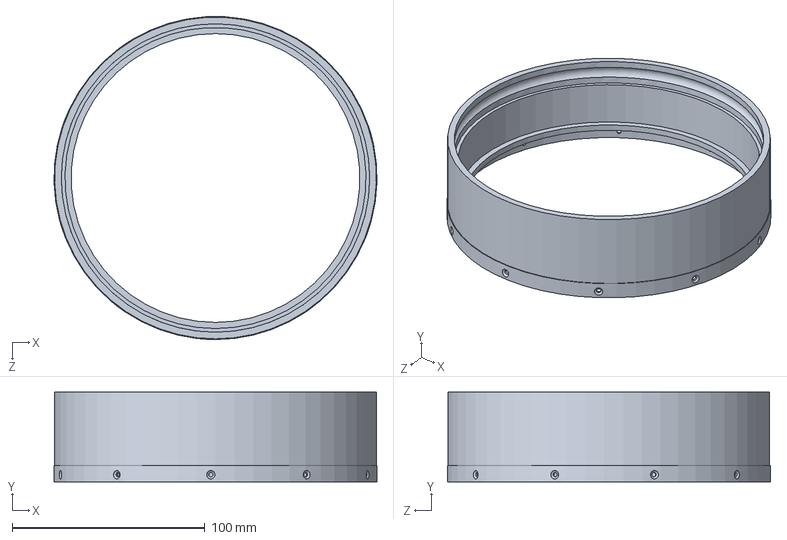
[picture p157: CAD file, 2019-04-04]
LV3.1/cad/Brainstorming/GW_Concepts/outer_ring_rsd2.SLDPRT
167.6 x 46.5 x 167.6 mm
