psas/lv3.0-recovery/(list of files, cad)

Other CAD files:
LV3.1/cad/AssemblyV3.2/Nose_cone_whole.SLDPRT
LV3.1/cad/Brainstorming/GG_Full_Mockup/upper_ring_assy.SLDASM
LV3.1/cad/Brainstorming/GG_Full_Mockup/nose.SLDASM
LV3.1/cad/Brainstorming/GG_Full_Mockup/Cylinder_Chute_Main^eNSR_v2.2.SLDPRT
LV3.1/cad/Brainstorming/GG_Concept2/Ring_Coupling_Geo.SLDPRT
LV3.1/cad/Brainstorming/MH_Concepts/DCR_Concept3/Thesis2_plungerFEwire.IGS
LV3.1/prototype_cad_lv3.1/GW_Concept2/Bottom_ring.STEP
LV3.1/cad/AssemblyV3.2/ST_Cap.SLDPRT
LV3.1/cad/Base_11_mockup/Top_ring.SLDPRT
LV3.1/cad/Brainstorming/MH_Concepts/DCR_Concept3/Thesis2_plungerFE203.STEP
LV3.1/cad/Brainstorming/ST_Top.SLDPRT
LV3.1/Current_Ring/Bottom_ring_1.SLDPRT
LV3.1/cad/Brainstorming/MH_Concepts/DCR_Concept3/Thesis2_plungerFE.STEP
LV3.1/cad/Brainstorming/GG_Full_Mockup/ST_Cap.SLDPRT
LV3.1/cad/for3dprinting/STEPfiles/LinAct_Bracket_Front.STEP
LV3.1/cad/Brainstorming/GG_Full_Mockup/ST_Bottom.SLDPRT
LV3.1/cad/for3dprinting/STEPfiles/standoff_withmount.STEP
LV3.1/cad/formachining/twist_coupling_V4_skirt_teeth.SLDPRT
LV3.1/cad/Brainstorming/MH_Concepts/DCR_Concept3/Thesis2_plunger.SLDPRT
Initial_Designs/Ring_lv3.0-recovery.SLDPRT
Initial_Designs/Ring_lv3.0-recovery_drw.SLDDRW
LV3.1/Current_Ring/Bottom_ring.SLDDRW
LV3.1/Current_Ring/Old/Bottom_ring.SLDPRT
LV3.1/Current_Ring/Top_ring.SLDDRW
LV3.1/Nose_cone/Nose_cone_bot.STL
LV3.1/Nose_cone/Nose_cone_mid.STL
LV3.1/Nose_cone/Nose_cone_top.1.STL
LV3.1/Nose_cone/Nose_cone_top.2.STL
LV3.1/Nose_cone/Nose_cone_top.STL
LV3.1/Nose_cone/Nose_cone_whole.STL
LV3.1/cad/2949T380_316 SS HOIST RING FOR LIFTING.SLDPRT
LV3.1/cad/2994T410_FORGED STL HOIST RING FOR LIFTING.SLDPRT
LV3.1/cad/2994T630_FORGED STL HOIST RING FOR LIFTING.SLDPRT
LV3.1/cad/3014T510_STEEL EYEBOLT WITH SHOULDER - FOR LIFTING.SLDPRT
LV3.1/cad/3014T520_STEEL EYEBOLT WITH SHOULDER - FOR LIFTING.SLDPRT
LV3.1/cad/3026T110_SHACKLE HOIST RING FOR LIFTING.SLDPRT
LV3.1/cad/7691T250_NYLON-COATED EYEBOLT.SLDPRT
LV3.1/cad/7880K450_HT-LOAD MTL GEAR--20 DEG PRESSURE ANGLE.STL
LV3.1/cad/8891T790_316 STAINLESS STEEL EYEBOLT.SLDPRT
LV3.1/cad/94895A827_ZINC YELLOW-CHROMATE PLATED STEEL HEX NUT.SLDPRT
LV3.1/cad/AssemblyV3.2/7880K450_HT-LOAD MTL GEAR--20 DEG PRESSURE ANGLE.SLDPRT
LV3.1/cad/AssemblyV3.2/BLDC_Gear_Motor_100rpm.SLDPRT
LV3.1/cad/AssemblyV3.2/Cup_Chute_Drogue^ERS_v0.2.SLDPRT
LV3.1/cad/AssemblyV3.2/Cup_Chute_Drogue^ERS_v1.0.SLDPRT
LV3.1/cad/AssemblyV3.2/Cup_Chute_Drogue^ERS_v1.0.STL
LV3.1/cad/AssemblyV3.2/Cylinder_Chute_Main^ERS_v0.3.SLDPRT
LV3.1/cad/AssemblyV3.2/Cylinder_Chute_Main^ERS_v1.0.STL
LV3.1/cad/AssemblyV3.2/H3840B_NO2_Ring.SLDPRT
LV3.1/cad/AssemblyV3.2/H3860S_NO3_Ring.SLDPRT
LV3.1/cad/AssemblyV3.2/H3880S_NO4_Ring.SLDPRT
LV3.1/cad/AssemblyV3.2/LinAct_Bracket_Back.SLDPRT
LV3.1/cad/AssemblyV3.2/LinAct_Bracket_Front.SLDPRT
LV3.1/cad/AssemblyV3.2/Linear_actuator.SLDPRT
LV3.1/cad/AssemblyV3.2/PIZZA_v3.0.SLDPRT
LV3.1/cad/AssemblyV3.2/PIZZA_v3.1.SLDPRT
LV3.1/cad/AssemblyV3.2/PIZZA_v3.1.STL
LV3.1/cad/AssemblyV3.2/PIZZA_v4.0.SLDPRT
LV3.1/cad/AssemblyV3.2/PIZZA_v4.0.STL
LV3.1/cad/AssemblyV3.2/PIZZA_v4.1.SLDPRT
LV3.1/cad/AssemblyV3.2/ST_Bottom.SLDPRT
LV3.1/cad/AssemblyV3.2/battery.SLDPRT
LV3.1/cad/AssemblyV3.2/clampArc.SLDPRT
LV3.1/cad/AssemblyV3.2/lower_ring_V3.SLDPRT
LV3.1/cad/AssemblyV3.2/moduleRing_flat.SLDPRT
LV3.1/cad/AssemblyV3.2/motor_bracket_sheetmetal_V3.SLDPRT
LV3.1/cad/AssemblyV3.2/nylon_loop_V1.SLDPRT
LV3.1/cad/AssemblyV3.2/spacerRing.SLDPRT
LV3.1/cad/AssemblyV3.2/tube_ring_V3.SLDPRT
LV3.1/cad/AssemblyV3.2/twist_coupling_V3.SLDPRT
LV3.1/cad/AssemblyV3.2/upper_ring_V3.SLDPRT
LV3.1/cad/AssemblyV3.2/webbing_base_V1.SLDPRT
LV3.1/cad/AssemblyV3.2/webbing_base_V2.SLDPRT
LV3.1/cad/AssemblyV3.2/webbing_grommet_V1.SLDPRT
LV3.1/cad/AssemblyV3.2/webbing_small_V1.SLDPRT
LV3.1/cad/AssemblyV3.2/webbing_top_V1.SLDPRT
LV3.1/cad/AssemblyV3.2/yellow_cord_V1.1.SLDPRT
LV3.1/cad/AssemblyV3.2/yellow_cord_guide.SLDPRT
LV3.1/cad/AssemblyV3.2/yellow_cord_short.SLDPRT
LV3.1/cad/AssemblyV3.2/yellow_twist.SLDPRT
LV3.1/cad/Base_11_mockup/7880K450_HT-LOAD MTL GEAR--20 DEG PRESSURE ANGLE.SLDPRT
LV3.1/cad/Base_11_mockup/Bottom_ring.SLDPRT
LV3.1/cad/Base_11_mockup/Motor1_small.SLDPRT
LV3.1/cad/Base_11_mockup/ST_Ring.SLDPRT
LV3.1/cad/Base_11_mockup/anchor_plate.SLDPRT
LV3.1/cad/Base_11_mockup/kepper ring.SLDPRT
LV3.1/cad/Base_11_mockup/twist_coupling.SLDPRT
LV3.1/cad/Brainstorming/GG_Concept2/Bearing_RMA.SLDPRT
LV3.1/cad/Brainstorming/GG_Full_Mockup/4-40x0.3125_82degCSK_flatHex_91253A107_ALLOY STEEL FLAT-HEAD SOCKET CAP SCREW.SLDPRT
LV3.1/cad/Brainstorming/GG_Full_Mockup/7880K450_HT-LOAD MTL GEAR--20 DEG PRESSURE ANGLE.SLDPRT
LV3.1/cad/Brainstorming/GG_Full_Mockup/90585A358_TYPE 316 SS FLAT-HEAD SOCKET CAP SCREW.SLDPRT
LV3.1/cad/Brainstorming/GG_Full_Mockup/91253A112_ALLOY STEEL FLAT-HEAD SOCKET CAP SCREW.SLDPRT
LV3.1/cad/Brainstorming/GG_Full_Mockup/91263A556_ZINC-PLATED ALLOY STEEL FLAT-HEAD CAP SCREW.SLDPRT
LV3.1/cad/Brainstorming/GG_Full_Mockup/95610A330_NYLON FLAT WASHER.SLDPRT
LV3.1/cad/Brainstorming/GG_Full_Mockup/Cup_Chute_Drogue^eNSR_v2.2.SLDPRT
LV3.1/cad/Brainstorming/GG_Full_Mockup/ROB-12310.SLDPRT
LV3.1/cad/Brainstorming/GG_Full_Mockup/keeper_ring_V3.SLDPRT
LV3.1/cad/Brainstorming/GG_Full_Mockup/lower_ring_V3.SLDPRT
LV3.1/cad/Brainstorming/GG_Full_Mockup/moduleRing.SLDPRT
LV3.1/cad/Brainstorming/GG_Full_Mockup/motor_bracket_sheetmetal_V3.SLDPRT
LV3.1/cad/Brainstorming/GG_Full_Mockup/motor_brkt.SLDPRT
LV3.1/cad/Brainstorming/GG_Full_Mockup/motor_housing.SLDPRT
LV3.1/cad/Brainstorming/GG_Full_Mockup/noseconeShell.SLDPRT
LV3.1/cad/Brainstorming/GG_Full_Mockup/spindle_small.SLDPRT
LV3.1/cad/Brainstorming/GG_Full_Mockup/tube_ring_V3.SLDPRT
LV3.1/cad/Brainstorming/GG_Full_Mockup/twist_coupling_V3.SLDPRT
LV3.1/cad/Brainstorming/GG_Full_Mockup/upper_ring_V3.SLDPRT
LV3.1/cad/Brainstorming/GG_Full_Mockup/von_karmon_nose_tip2.SLDPRT
LV3.1/cad/Brainstorming/GW_Concepts/outer ring rocket shute deployment.SLDPRT
LV3.1/cad/Brainstorming/MH_Concepts/DCR_Concept1/6873K110_COMPACT LINEAR SOLENOID.SLDPRT
LV3.1/cad/Brainstorming/MH_Concepts/DCR_Concept1/6873K310_COMPACT LINEAR SOLENOID.SLDPRT
LV3.1/cad/Brainstorming/MH_Concepts/DCR_Concept1/6873K610_COMPACT LINEAR SOLENOID.SLDPRT
LV3.1/cad/Brainstorming/MH_Concepts/DCR_Concept1/69905K110_SEALED LINEAR SOLENOID.SLDPRT
LV3.1/cad/Brainstorming/MH_Concepts/DCR_Concept1/91292A122_TYPE 18-8 SS SOCKET HEAD CAP SCREW.SLDPRT
LV3.1/cad/Brainstorming/MH_Concepts/DCR_Concept1/91292A130_TYPE 18-8 SS SOCKET HEAD CAP SCREW.SLDPRT
LV3.1/cad/Brainstorming/MH_Concepts/DCR_Concept1/91595A476_METRIC ALLOY STEEL DOWEL PIN.SLDPRT
LV3.1/cad/Brainstorming/MH_Concepts/DCR_Concept1/92141A029_TYPE 18-8 STAINLESS STEEL FLAT WASHER.SLDPRT
LV3.1/cad/Brainstorming/MH_Concepts/DCR_Concept1/92620A540_HIGH-STRENGTH GRADE 8 STEEL CAP SCREW.SLDPRT
LV3.1/cad/Brainstorming/MH_Concepts/DCR_Concept1/92620A542_HIGH-STRENGTH GRADE 8 STEEL CAP SCREW.SLDPRT
LV3.1/cad/Brainstorming/MH_Concepts/DCR_Concept1/92620A544_HIGH-STRENGTH GRADE 8 STEEL CAP SCREW.SLDPRT
LV3.1/cad/Brainstorming/MH_Concepts/DCR_Concept1/94165A219_18-8 STAINLESS STEEL THREAD-LOCKING INSERT.SLDPRT
LV3.1/cad/Brainstorming/MH_Concepts/DCR_Concept1/9434K154_MUSIC-WIRE STEEL COMPRESSION SPRINGS.SLDPRT
LV3.1/cad/Brainstorming/MH_Concepts/DCR_Concept1/9657K319_STEEL COMPRESSION SPRING.SLDPRT
LV3.1/cad/Brainstorming/MH_Concepts/DCR_Concept1/9657K486_COMPRESSION SPRING.SLDPRT
LV3.1/cad/Brainstorming/MH_Concepts/DCR_Concept1/9657K528_COMPRESSION SPRING.SLDPRT
LV3.1/cad/Brainstorming/MH_Concepts/DCR_Concept1/97175A318_STANDARD PULL-OUT DOWEL PIN.SLDPRT
LV3.1/cad/Brainstorming/MH_Concepts/DCR_Concept1/98381A035_ALLOY STEEL DOWEL PIN.SLDPRT
LV3.1/cad/Brainstorming/MH_Concepts/DCR_Concept1/98381A035_pin_modified.SLDPRT
LV3.1/cad/Brainstorming/MH_Concepts/DCR_Concept1/Proto_spring_chamber.SLDPRT
LV3.1/cad/Brainstorming/MH_Concepts/DCR_Concept1/Proto_spring_chambersq.SLDPRT
LV3.1/cad/Brainstorming/MH_Concepts/DCR_Concept1/Proto_spring_inring.SLDPRT
LV3.1/cad/Brainstorming/MH_Concepts/DCR_Concept1/Proto_spring_plunger.SLDPRT
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
