psas/lv3.0-recovery/Initial_Designs/step_by_step.jpg

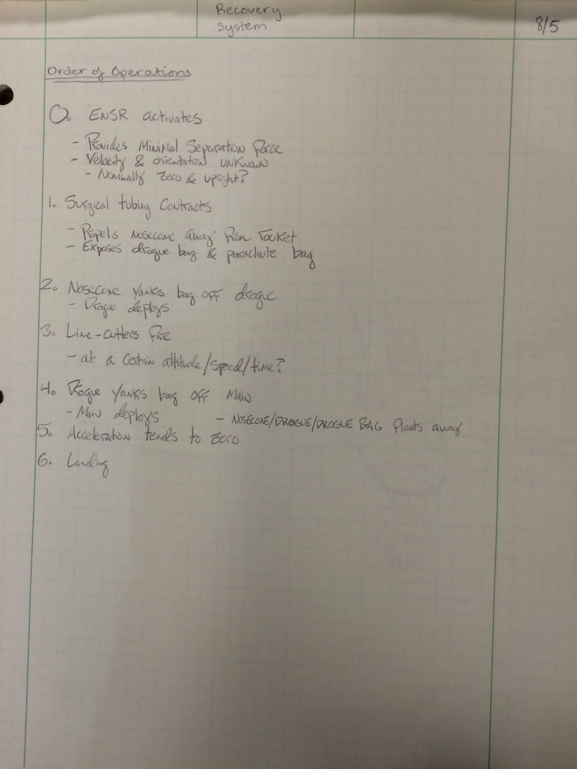
Initial_Designs/step_by_step.jpg
