psas/lv3.0-recovery/Useful_Misc/drop_test_sample_data/data_A.csv

 | x | y | norm | theta | v_plane | v_w | deg_w | latitude | longitude
0 | 36.43644910172194 | 138.05789300249916 | 142.7851415359171 | 1.3127585775741208 | 24.976228821701245 | 6.2529428578224815 | 56.4819220033001 | 0.00037863695173966626 | 0.00014136788147741687
1 | -166.80435198560374 | -106.42124876095468 | 197.8615021402046 | -2.573699285722333 | 27.326851797008267 | 1.942734271786152 | 56.00741792682799 | -0.0002918704346041786 | -0.0006471755190958978
2 | -113.0088896978422 | -192.17250986885836 | 222.93784492552075 | -2.102389857095092 | 29.263619829105874 | 0.8812372863465221 | 42.42270124005587 | -0.0005270514547370955 | -0.00043845730631155377
3 | 104.37526144899137 | 74.10717490734197 | 128.00808011720463 | 0.6174106007914756 | 23.730179448796 | 6.138360963773255 | 52.803977100546966 | 0.00020324600208440312 | 0.00040496014165656153
4 | 19.297436488940022 | 188.77613968988345 | 189.75990612154894 | 1.4689262642873298 | 24.580679039096708 | 5.784077851081844 | 56.785874700791375 | 0.0005177365852748817 | 7.487111893835806e-05
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
