psas/lv3.0-recovery/Useful_Misc/drop_test_sample_data/data_B.csv

 | x | y | norm | theta | v_plane | v_w | deg_w | latitude | longitude
0 | -309.9486961550173 | -369.0674132690954 | 481.95326514646257 | -2.269348225926559 | 25.29305680974618 | 3.621356968383993 | 25.402951618005627 | -0.0010122026152037849 | -0.0012025538059374631
1 | -257.9454799754215 | -314.13599702100066 | 406.46930420897553 | -2.2582873552192657 | 25.407893752564654 | 4.793615966365738 | 65.49298269375365 | -0.0008615479619233318 | -0.001000789235498733
2 | -273.326371211334 | -344.0133614069599 | 439.3773981739065 | -2.242188421666114 | 24.20219543164863 | 5.128924307655421 | 52.9513318883862 | -0.0009434894860990636 | -0.0010604647544601227
3 | -202.64162013994846 | -336.38396254788717 | 392.70573776348306 | -2.112987217440149 | 21.132903690738328 | 10.386271374973505 | 47.56521116465948 | -0.0009225651313607721 | -0.000786218669617346
4 | -324.3041342701623 | -346.7734923464291 | 474.78945491539554 | -2.3227244917973837 | 25.53745830675814 | 3.2857597353336705 | 50.676220066746254 | -0.0009510594087061257 | -0.0012582507227350528
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
