psas/lv3.0-recovery/Useful_Misc/drop_test_sample_data/data_C.csv

 | x | y | norm | theta | v_plane | v_w | deg_w | latitude | longitude
0 | 875.2985835215752 | 1035.5627793983833 | 1355.9269450785985 | 0.8690724687505081 | 19.865901453776846 | 6.673029837244353 | 49.58941997082184 | 0.002840129786127928 | 0.0033960253938900204
1 | 526.1643672016389 | 285.2105598638241 | 598.4931117151953 | 0.4967237303053015 | 27.11444097291473 | 3.510668522011767 | 35.676462117955595 | 0.0007822171890516036 | 0.0020414377288122216
2 | 1247.6766994852837 | 1679.1797020769757 | 2091.9707498686043 | 0.9317725716897816 | 20.84649613768996 | 9.820452483724932 | 52.18008352311424 | 0.004605310641717802 | 0.004840795854792412
3 | 275.37368388941354 | 660.5722324278458 | 715.6719500116899 | 1.1758307562449248 | 28.30674352524456 | 3.9683034186668 | 66.05092631231963 | 0.0018116824112752335 | 0.0010684080163080036
4 | 1183.0698837178318 | 1507.10788153418 | 1915.9928278421526 | 0.9052729077081578 | 24.992724658687457 | 9.070810559620815 | 52.93245672772119 | 0.004133387246440144 | 0.004590131234632847
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
