psas/lv3.0-recovery/Useful_Misc/drop_test_sample_data/succ_data.csv

 | x | y | norm | theta | v_plane | v_w | deg_w | latitude | longitude
0 | 132.50542681402754 | 1175.995636552257 | 1183.4371235199258 | 1.4585944554193069 | 22.584118981513285 | 9.309918816104927 | 77.31566919109974 | 0.0032252803037870104 | 0.000514100905405591
1 | 261.21254739046606 | 422.18513164274435 | 496.459746902423 | 1.0167288648373498 | 23.49029628036748 | 5.134438936149073 | 58.86318382277398 | 0.0011578830289125498 | 0.0010134649602330328
2 | 661.6044901869102 | 1494.7488122485383 | 1634.6236610161673 | 1.154097221043098 | 18.98320057337339 | 12.523038040313878 | 64.40345737994703 | 0.004099491319022434 | 0.002566924809071196
3 | -31.759721585427975 | -18.629806190695646 | 36.82050507375994 | -2.611094824036527 | 31.290521133144836 | 2.0336127373981125 | 41.296399004879405 | -5.109402203768292e-05 | -0.00012322288992294692
4 | 400.67430348848393 | 463.4635290181186 | 612.6486270334001 | 0.8579318153499143 | 23.138014584813902 | 5.739232949106907 | 50.01454892153532 | 0.0012710929745012995 | 0.0015545553653835524
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
