psas/lv3.0-recovery/Line_Cutters/LV2c_Line_Cutters/LV2cLineCutters/lineCutterTesting1.jpg

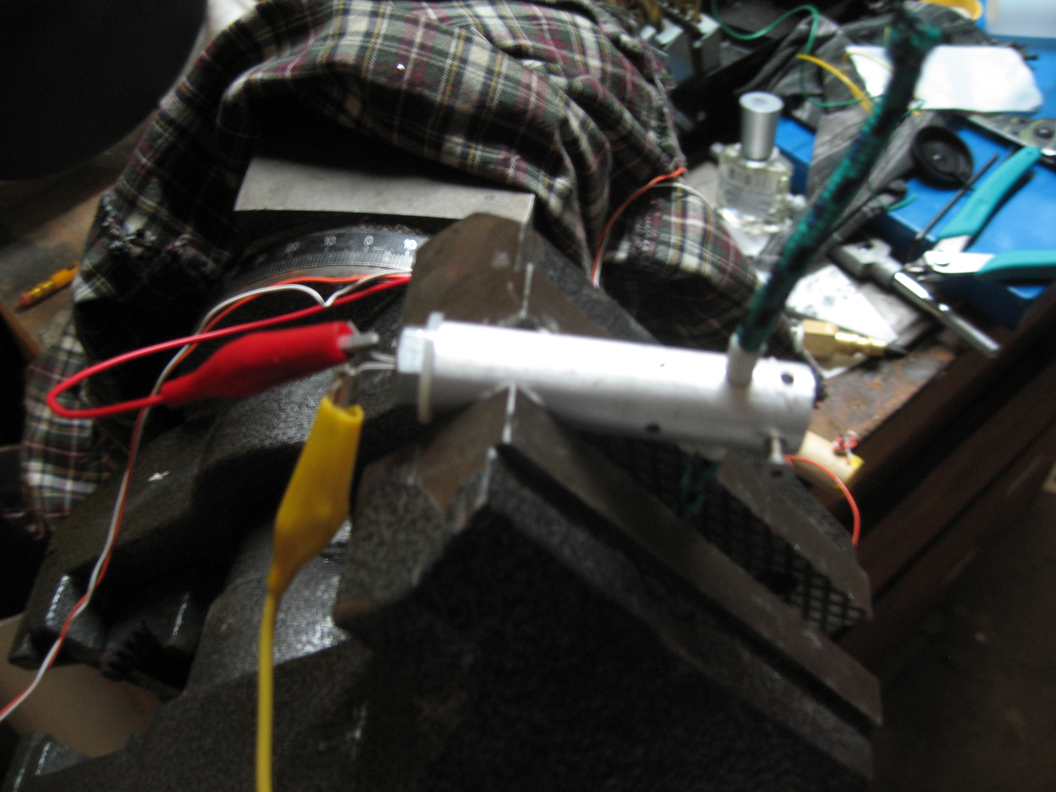
Line_Cutters/LV2c_Line_Cutters/LV2cLineCutters/lineCutterTesting1.jpg
