psas/lv3.0-recovery/(threads)

Thread 2 (2016-09-22):

Manufacturing: attachment ring

hmarie2, 2016-09-22:
This needs to be manufactured

Joedang, 2017-11-15:
Does this still need to be machined, or can we close this issue? (I would assume this is the thing that attaches to the nosecone.)

Joedang, 2020-01-27:
I'm preeeeety sure this isn't relevant any more. Closing.

Closed 2020-01-27.
