psas/lv3.0-recovery/LV3.1/cad/lower_ring_V3.pdf

5.63 | .50

.25

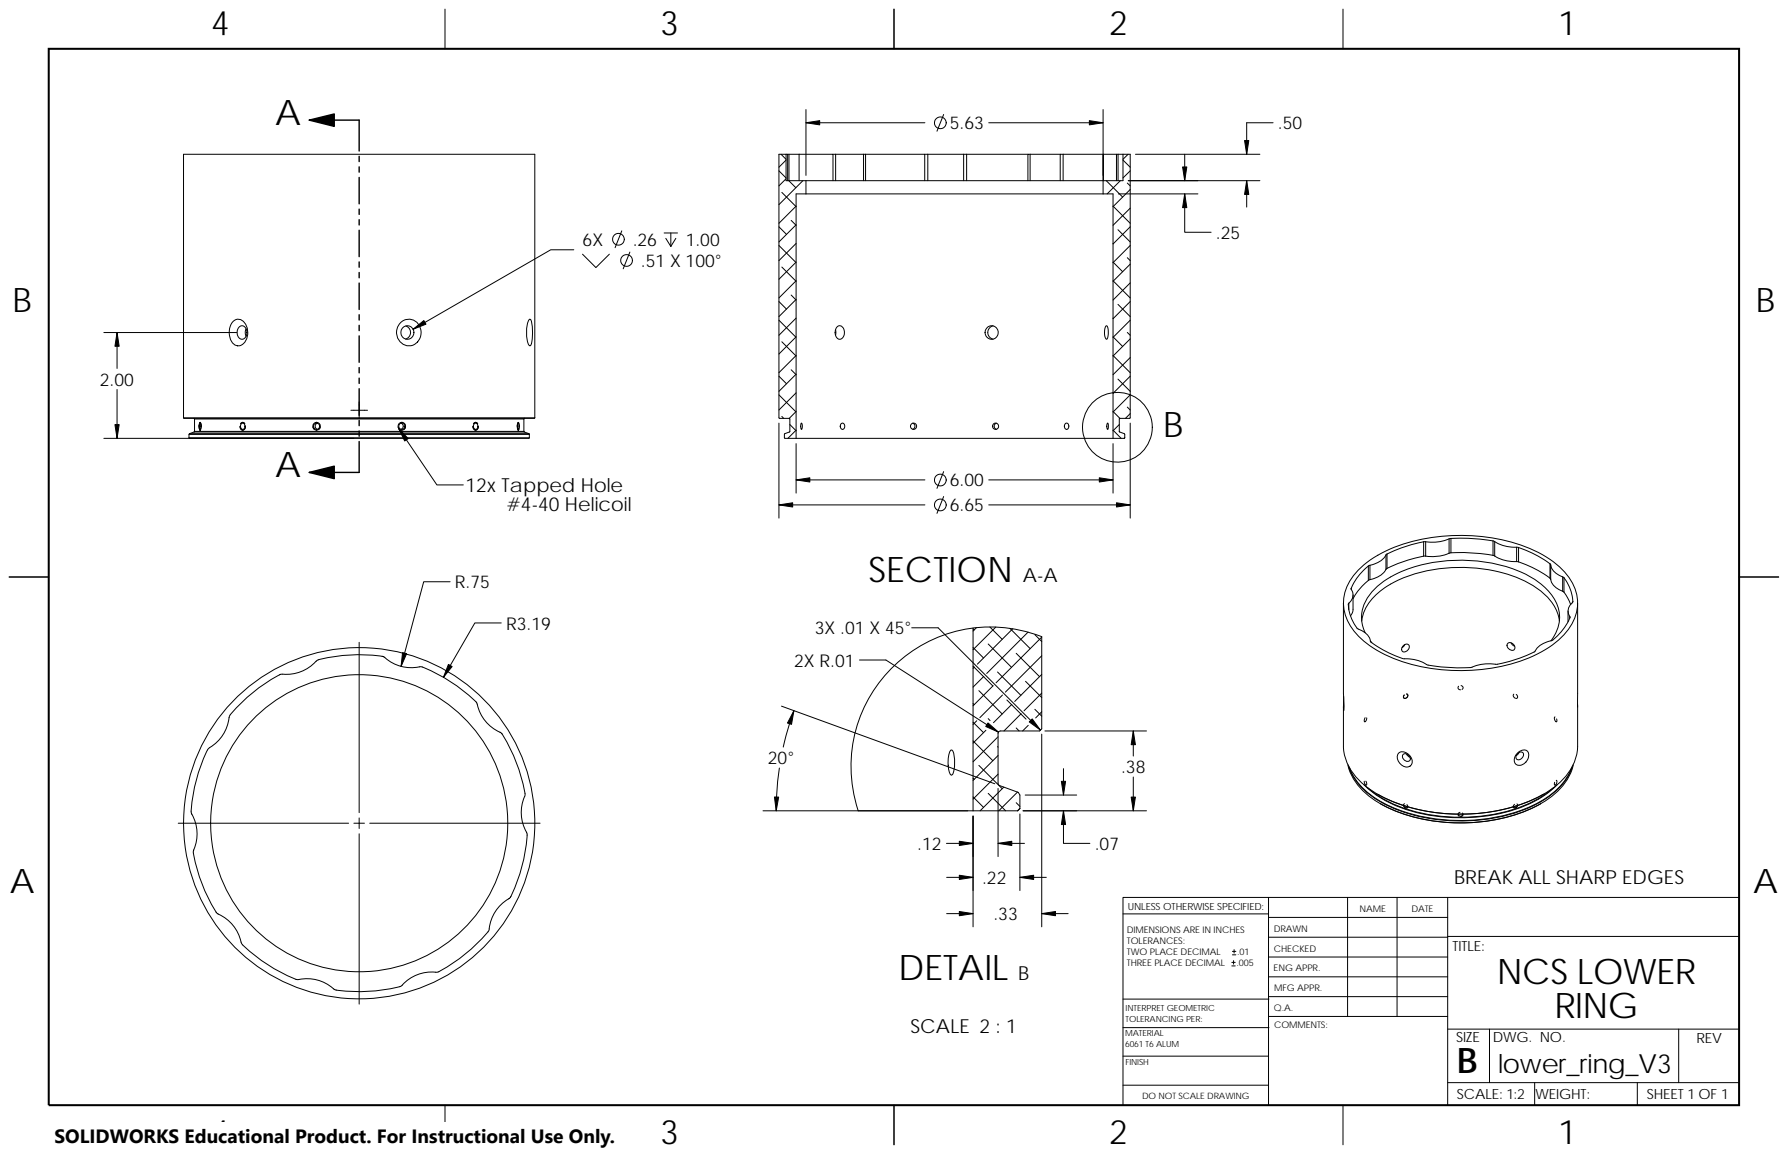
[picture p180: page 1]
SECTION A-A; DETAIL B; SCALE 2 : 1; 12x Tapped Hole #4-40 Helicoil; SHEET 1 OF 1; INTERPRET GEOMETRIC; MATERIAL; TOLERANCING PER:; 6061 T6 ALUM; RING; lower_ring_V3; REV; DO NOT SCALE DRAWING; SCALE: 1:2; WEIGHT:; DWG. NO.; SIZE; TITLE:; NAME; DATE; COMMENTS:; DRAWN; NCS LOWER; FINISH; TWO PLACE DECIMAL

BREAK ALL SHARP EDGES

UNLESS OTHERWISE SPECIFIED:

DIMENSIONS ARE IN INCHES
TOLERANCES:
THREE PLACE DECIMAL .005

CHECKED
ENG APPR.
MFG APPR.
Q.A.

SOLIDWORKS Educational Product. For Instructional Use Only.
