psas/lv3.0-recovery/LV3.1/cad/NCS_V3.pdf

1

2

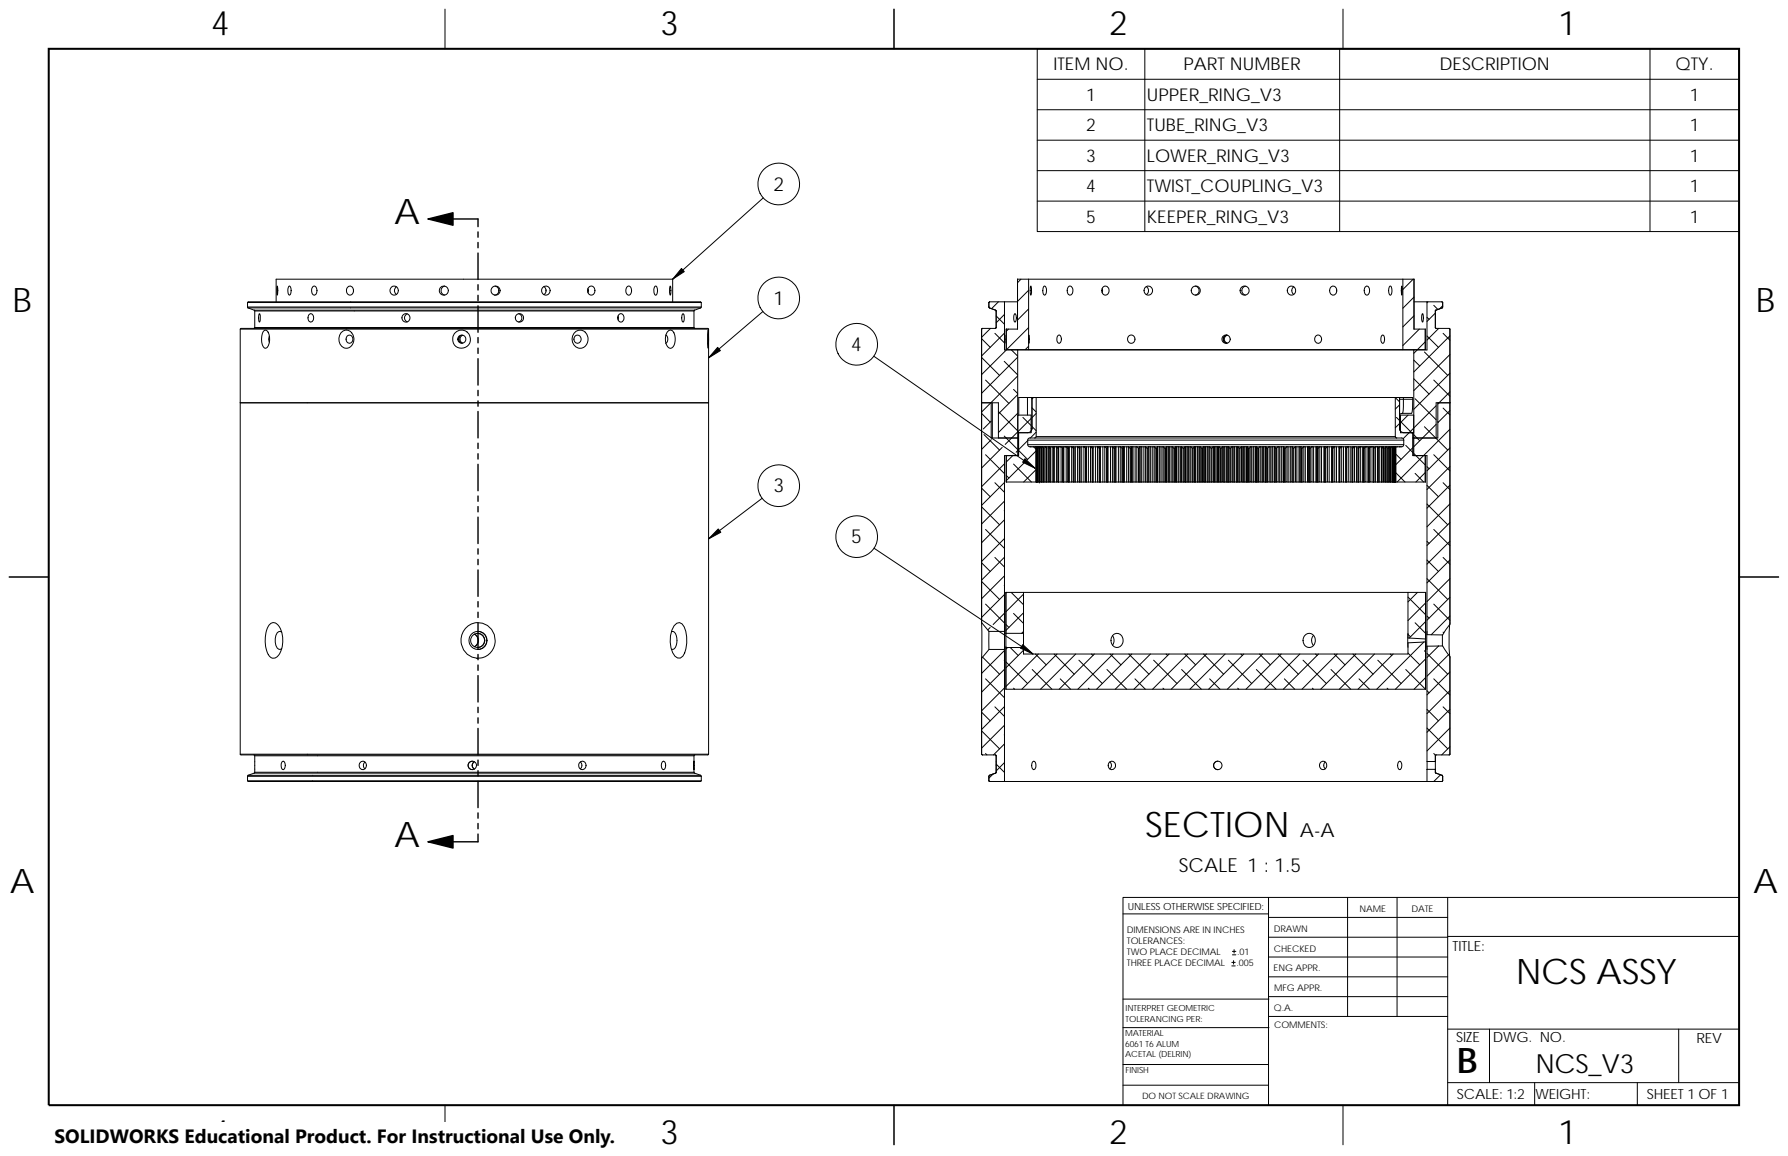
[picture p181: page 1]
SCALE 1 : 1.5; SECTION A-A; ITEM NO.; PART NUMBER; DESCRIPTION; QTY.; UPPER_RING_V3; TUBE_RING_V3; LOWER_RING_V3; TWIST_COUPLING_V3; KEEPER_RING_V3; DWG. NO.; TITLE:; DATE; COMMENTS:; SHEET 1 OF 1; FINISH; MATERIAL; SCALE: 1:2; SIZE; NCS ASSY; NAME; WEIGHT: 1; NCS_V3; 6061 T6 ALUM; REV; ACETAL (DELRIN); INTERPRET GEOMETRIC TOLERANCING PER:; TWO PLACE DECIMAL

UNLESS OTHERWISE SPECIFIED:

DIMENSIONS ARE IN INCHES
TOLERANCES:
THREE PLACE DECIMAL .005

DRAWN
CHECKED
ENG APPR.
MFG APPR.
Q.A.

DO NOT SCALE DRAWING

SOLIDWORKS Educational Product. For Instructional Use Only.
