psas/lv3.0-recovery/LV3.1/cad/tube_ring_V3.pdf

1

B | B

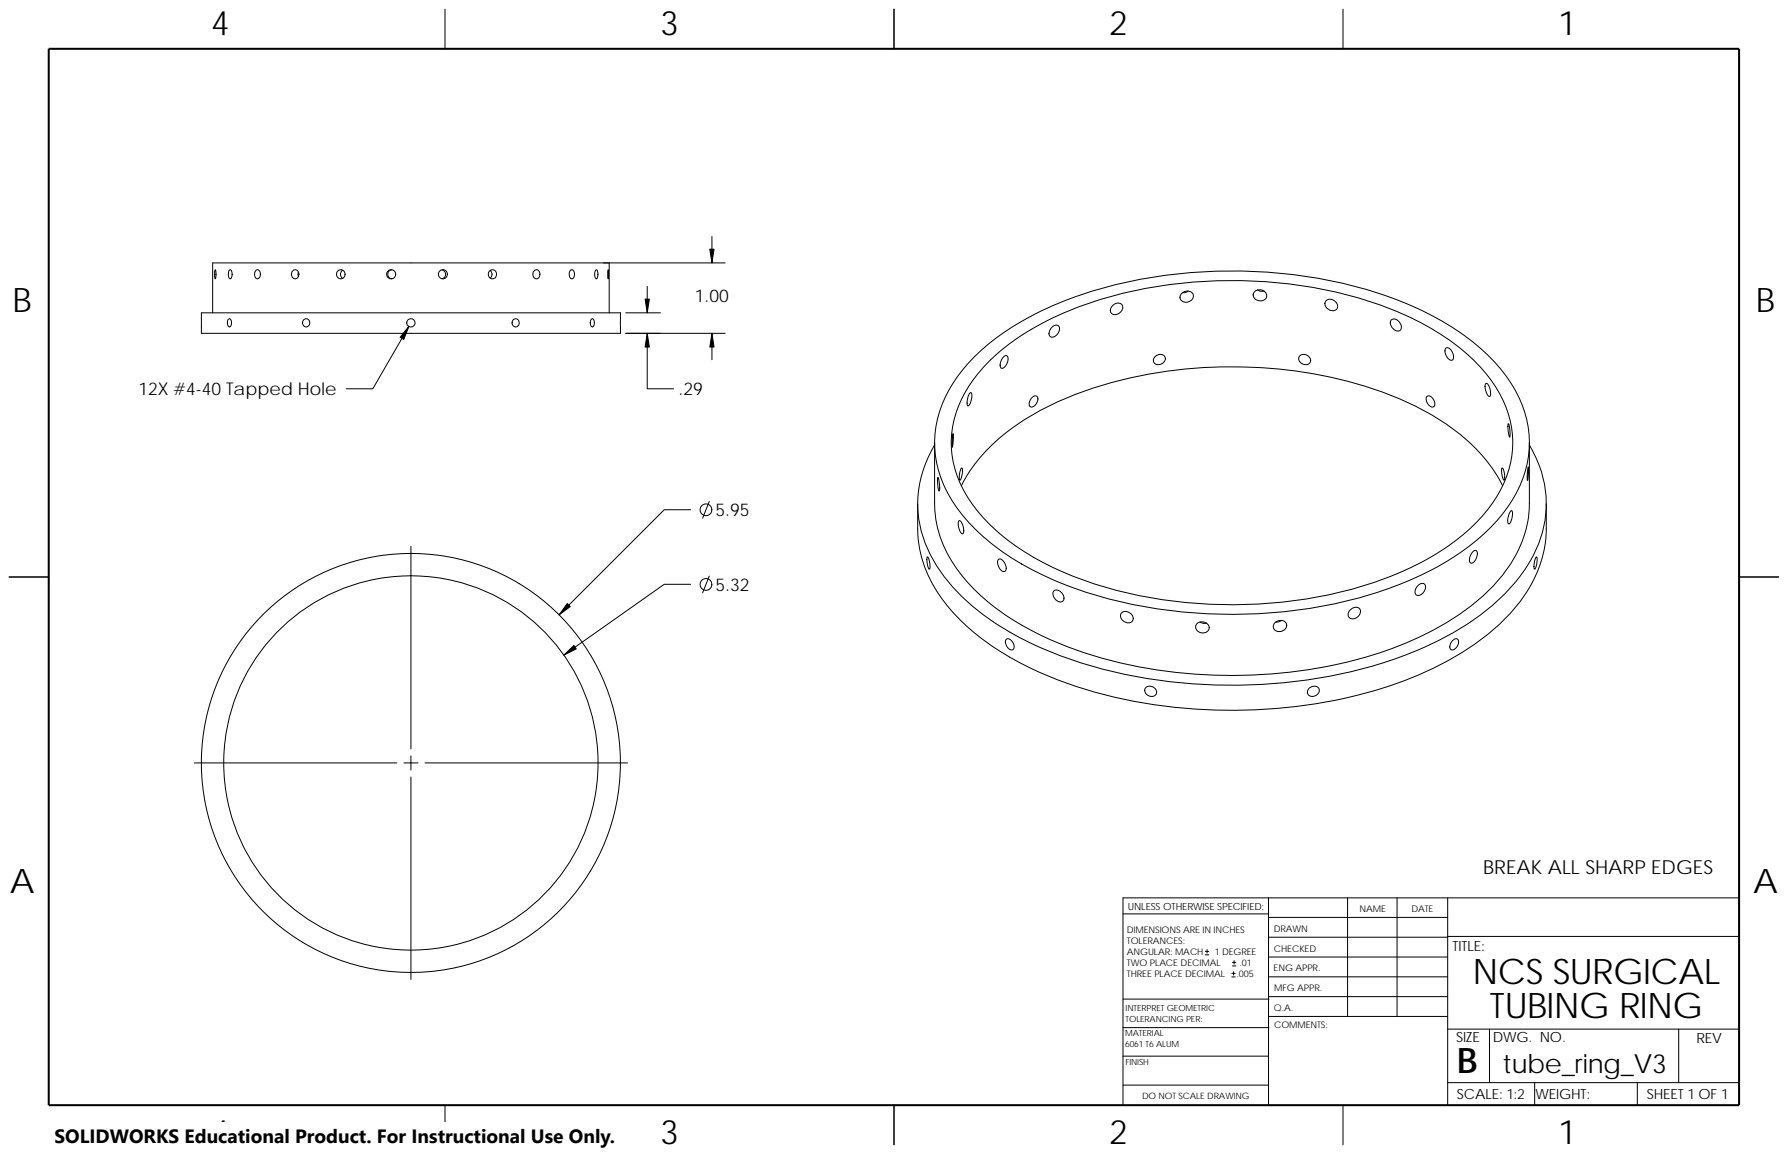
[picture p182: page 1]
6061 T6 ALUM; SCALE: 1:2; FINISH; MATERIAL; DO NOT SCALE DRAWING; SHEET 1 OF 1; DWG. NO.; WEIGHT:; REV; B tube_ring_V3; SIZE; COMMENTS:; 12X #4-40 Tapped Hole

BREAK ALL SHARP EDGES

UNLESS OTHERWISE SPECIFIED: | | NAME | DATE
CHECKED | | | TITLE: NCS SURGICAL TUBING RING

DIMENSIONS ARE IN INCHES TOLERANCES: ANGULAR: MACH 1 DEGREE TWO PLACE DECIMAL .01 THREE PLACE DECIMAL .005 INTERPRET GEOMETRIC | DRAWN

ENG APPR.
MFG APPR.

TOLERANCING PER: | Q.A.

SOLIDWORKS Educational Product. For Instructional Use Only.
