psas/lv3.0-recovery/LV3.1/cad/upper_ring_V3.pdf

B | B

4

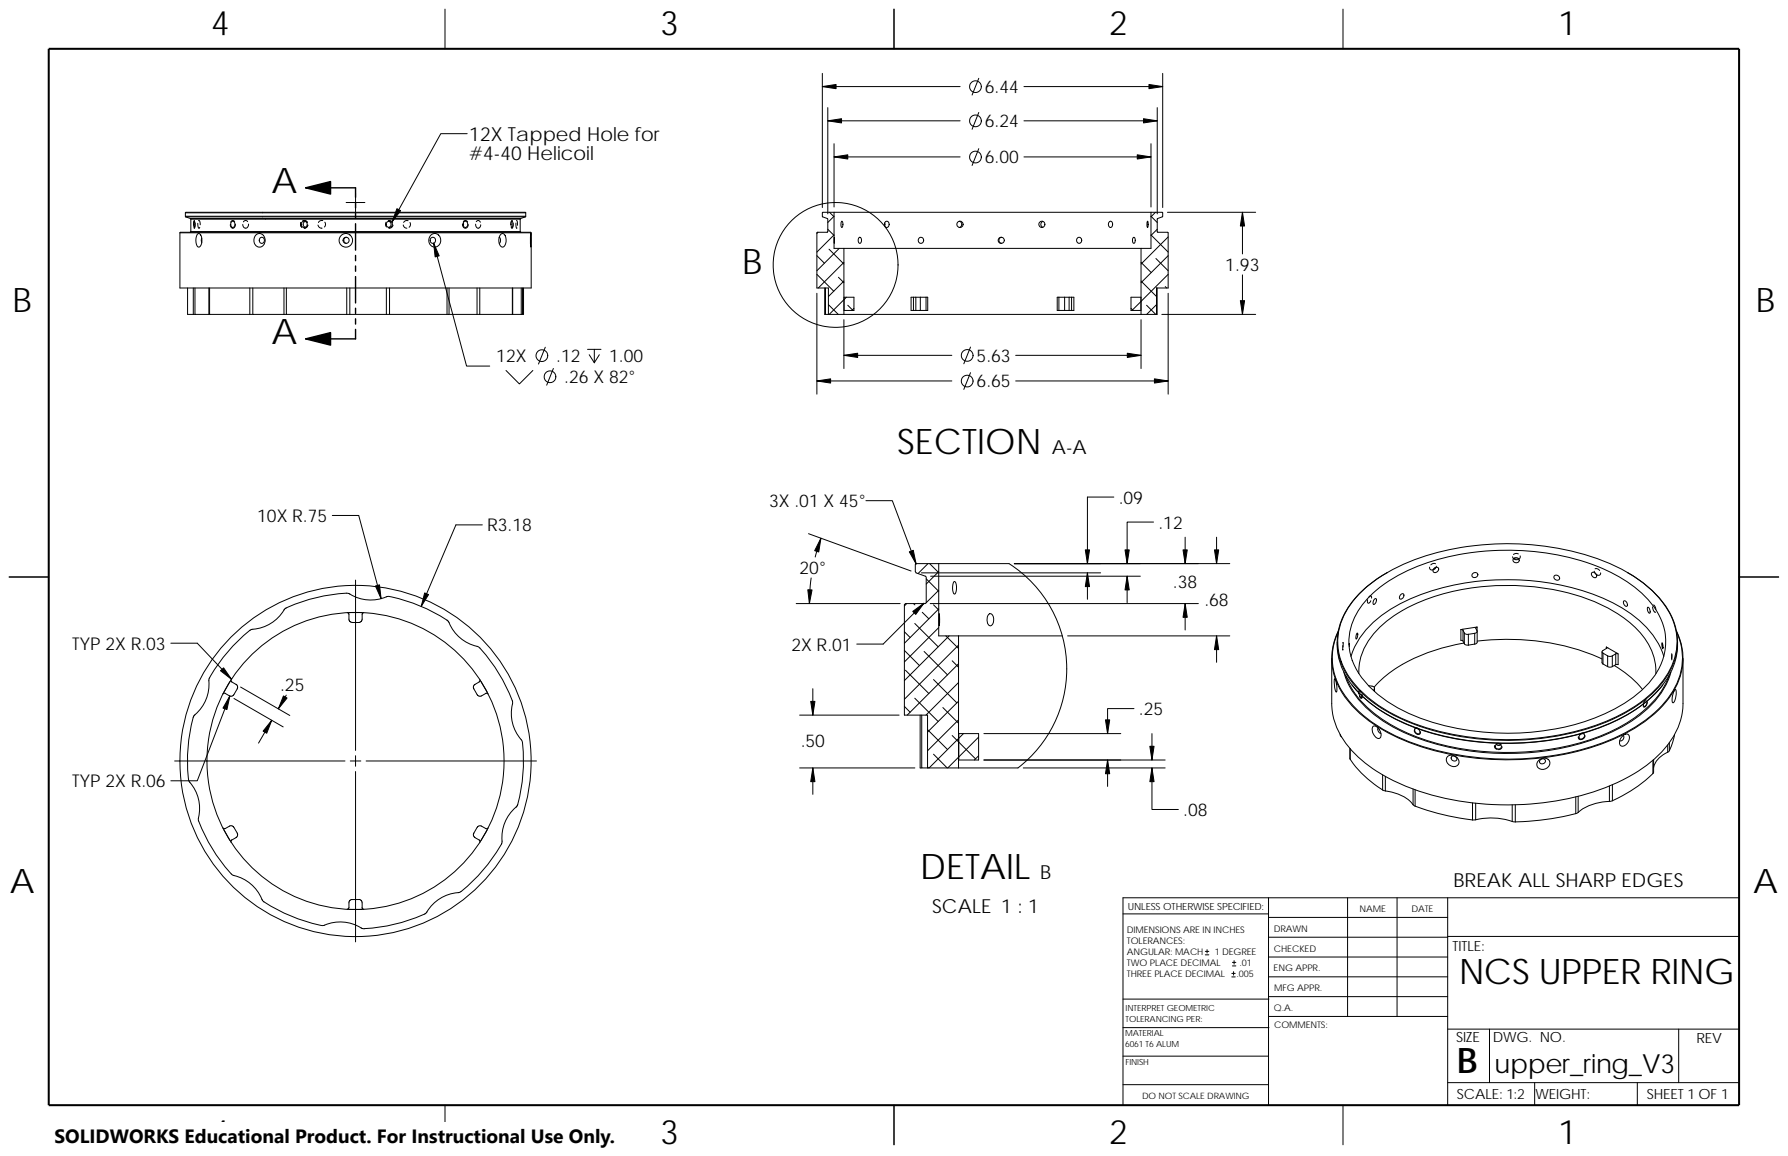
[picture p183: page 1]
WEIGHT:; REV; SHEET 1 OF 1; 6061 T6 ALUM; SCALE: 1:2; upper_ring_V3; DWG. NO.; SIZE; COMMENTS:; FINISH; MATERIAL; TYP 2X R.03; TYP 2X R.06; SECTION A-A; DETAIL B; SCALE 1 : 1

12X Tapped Hole for
#4-40 Helicoil

BREAK ALL SHARP EDGES

UNLESS OTHERWISE SPECIFIED: | | NAME | DATE

DIMENSIONS ARE IN INCHES TOLERANCES: ANGULAR: MACH 1 DEGREE TWO PLACE DECIMAL .01 THREE PLACE DECIMAL .005 | DRAWN

CHECKED | | | TITLE: NCS UPPER RING

ENG APPR.
MFG APPR.

INTERPRET GEOMETRIC TOLERANCING PER: | Q.A.

DO NOT SCALE DRAWING

SOLIDWORKS Educational Product. For Instructional Use Only.
