psas/lv3.0-recovery/LV3.1/Current_Ring/Bottom_ring.pdf

4

3

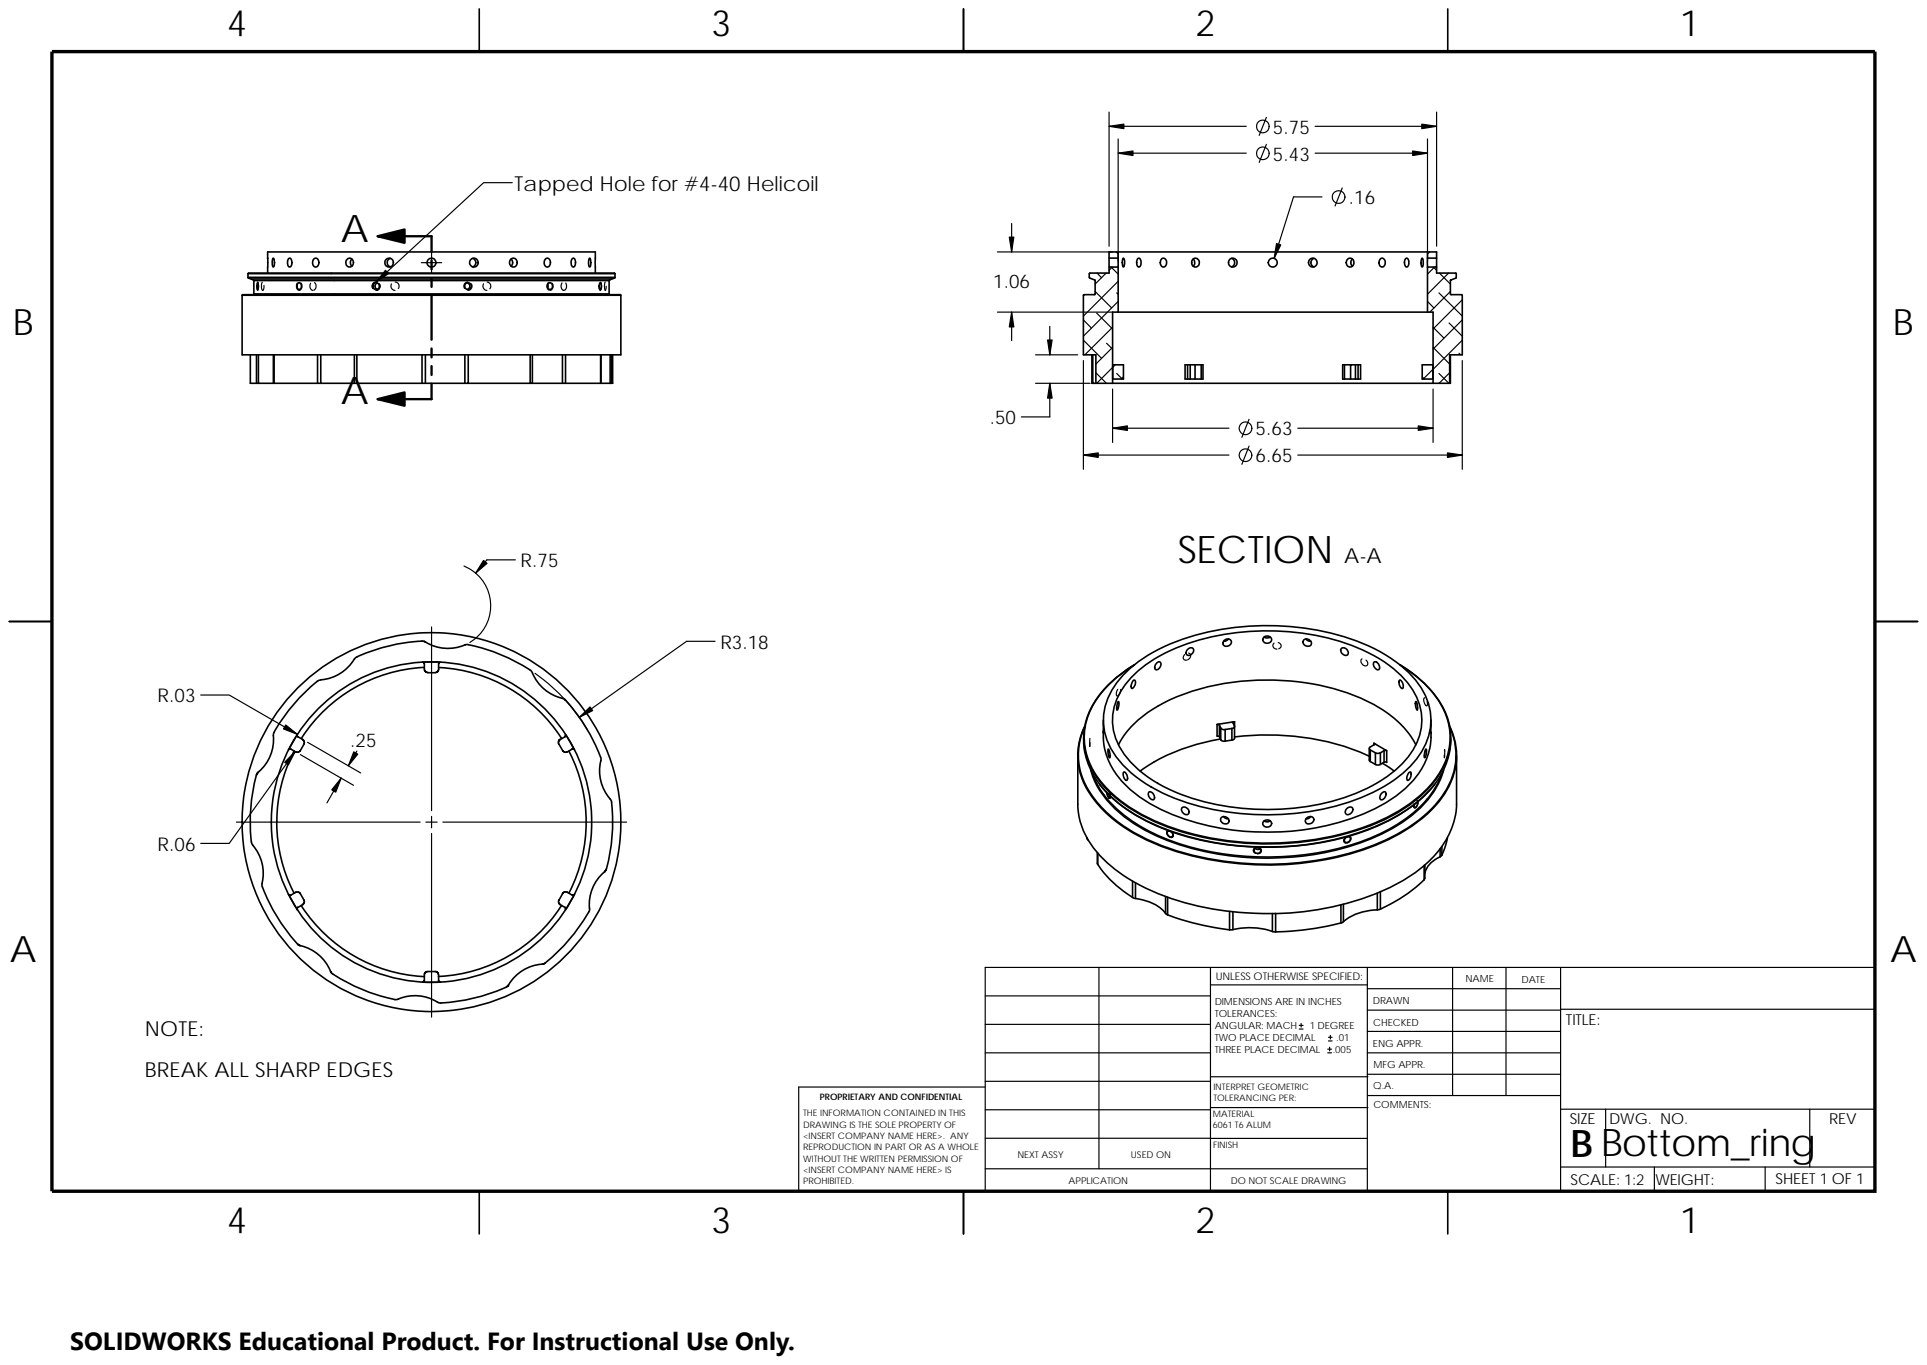
[picture p184: page 1]
REV; Bottom_ring; SCALE: 1:2; WEIGHT:; SHEET 1 OF 1; DWG. NO.; SIZE; TITLE:; NAME; DATE; COMMENTS:; FINISH; 6061 T6 ALUM; NEXT ASSY; MATERIAL; USED ON; APPLICATION; SECTION A-A

Tapped Hole for #4-40 Helicoil

UNLESS OTHERWISE SPECIFIED:

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

NOTE:
BREAK ALL SHARP EDGES

ENG APPR.
MFG APPR.

PROPRIETARY AND CONFIDENTIAL
THE INFORMATION CONTAINED IN THIS
DRAWING IS THE SOLE PROPERTY OF
<INSERT COMPANY NAME HERE>. ANY
REPRODUCTION IN PART OR AS A WHOLE
WITHOUT THE WRITTEN PERMISSION OF
<INSERT COMPANY NAME HERE> IS
PROHIBITED.

INTERPRET GEOMETRIC TOLERANCING PER: | Q.A.

DO NOT SCALE DRAWING

SOLIDWORKS Educational Product. For Instructional Use Only.
