psas/lv3.0-recovery/LV3.1/Current_Ring/Top_ring.pdf

4

3

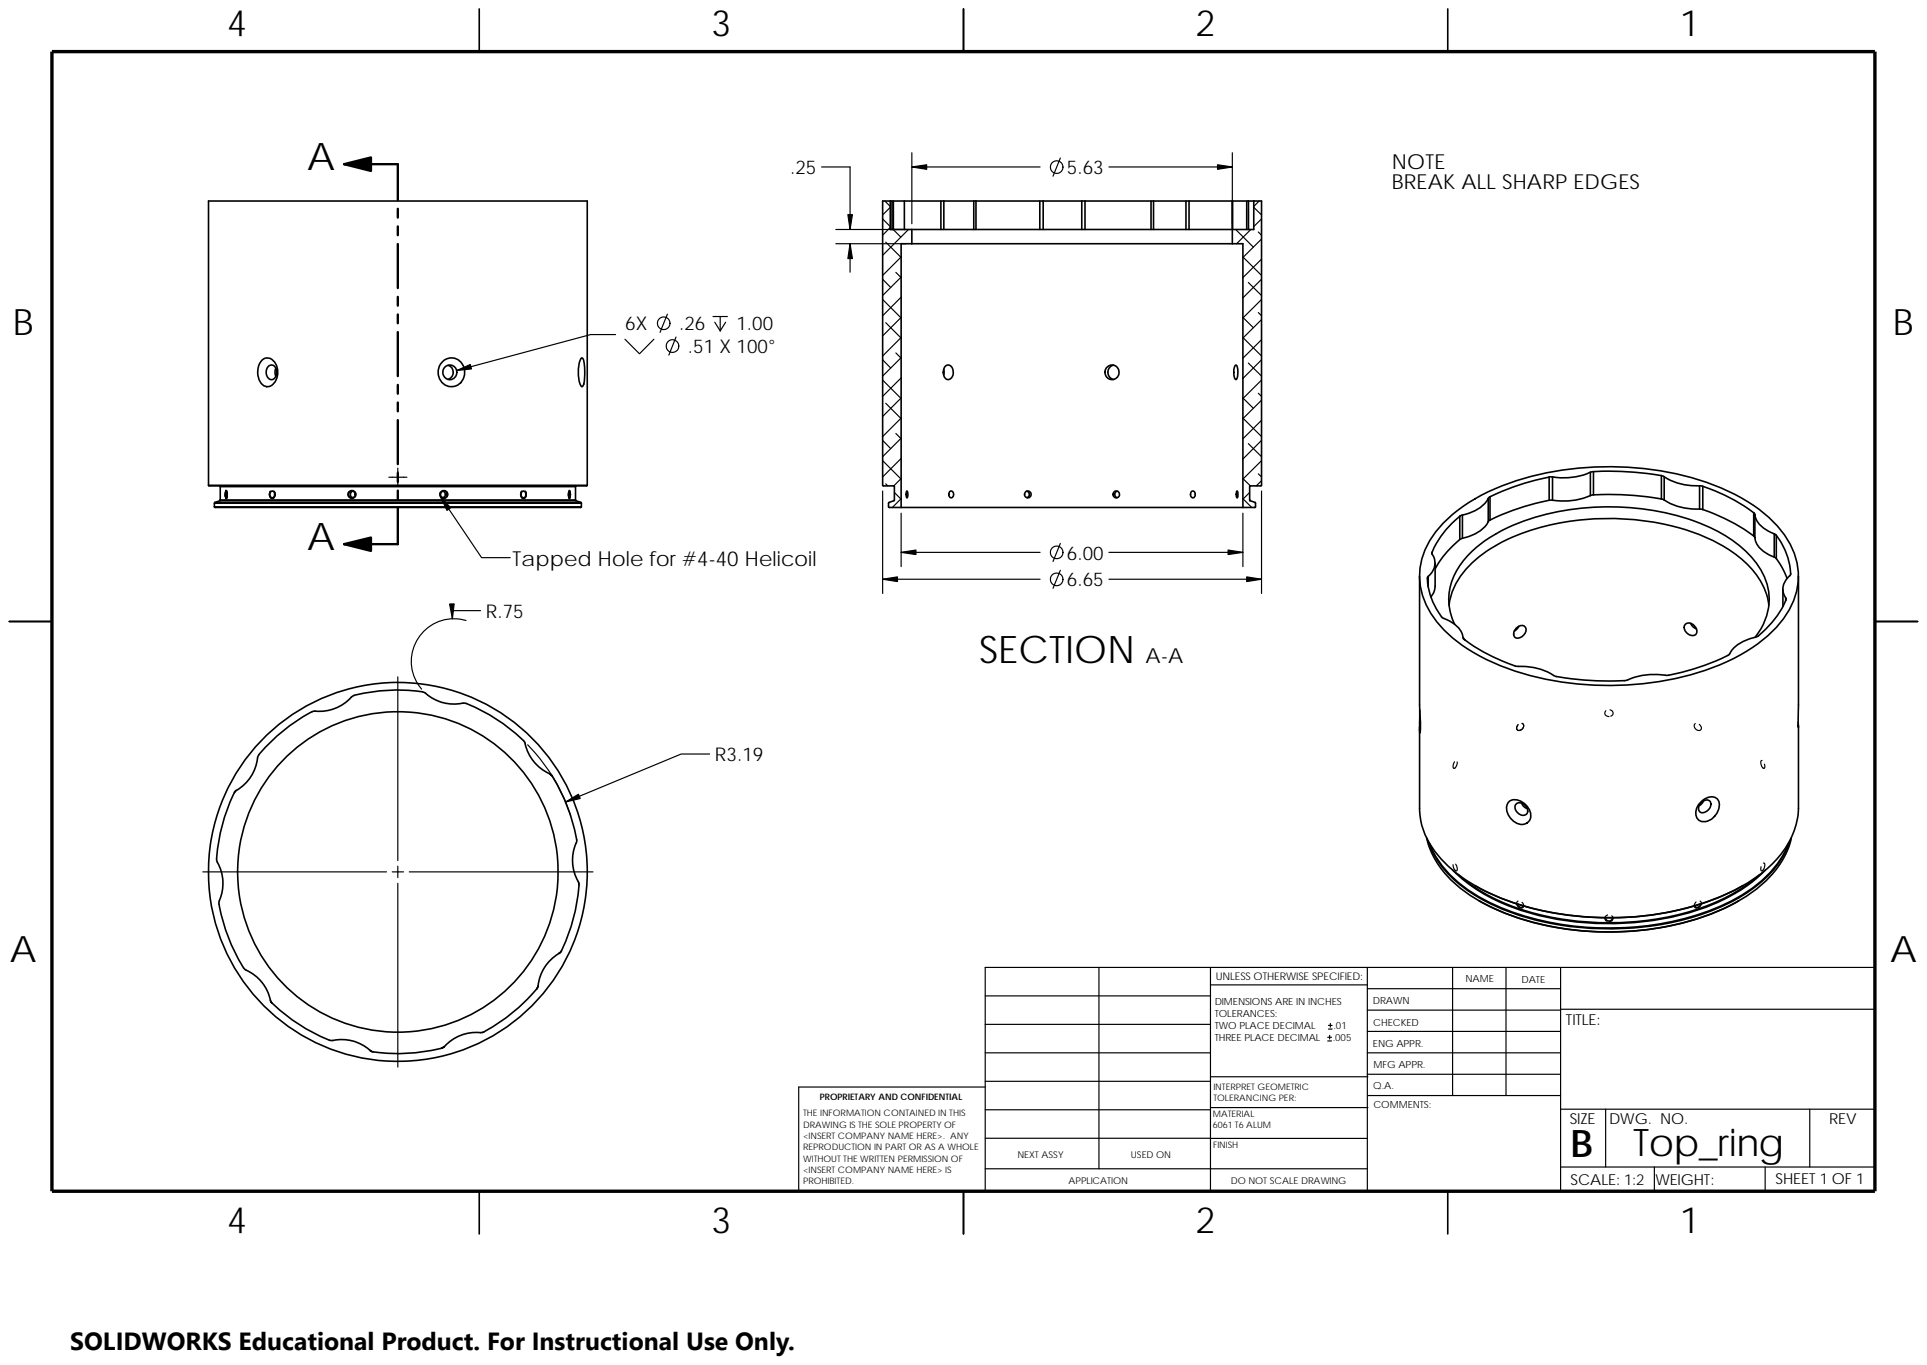
[picture p185: page 1]
COMMENTS:; SECTION A-A

NOTE
BREAK ALL SHARP EDGES

Tapped Hole for #4-40 Helicoil

UNLESS OTHERWISE SPECIFIED: | | NAME | DATE

DIMENSIONS ARE IN INCHES TOLERANCES: TWO PLACE DECIMAL .01 THREE PLACE DECIMAL .005 | DRAWN

CHECKED | | | TITLE:

ENG APPR.
MFG APPR.

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

INTERPRET GEOMETRIC TOLERANCING PER: | Q.A.

MATERIAL 6061 T6 ALUM | | SIZE B | DWG. NO. Top_ring | REV

NEXT ASSY | USED ON | FINISH
APPLICATION | DO NOT SCALE DRAWING | | SCALE: 1:2 | WEIGHT: | SHEET 1 OF 1

SOLIDWORKS Educational Product. For Instructional Use Only.
