psas/lv3.0-recovery/LV3.1/cad/formachining/twist_coupling_V4_skirt.PDF

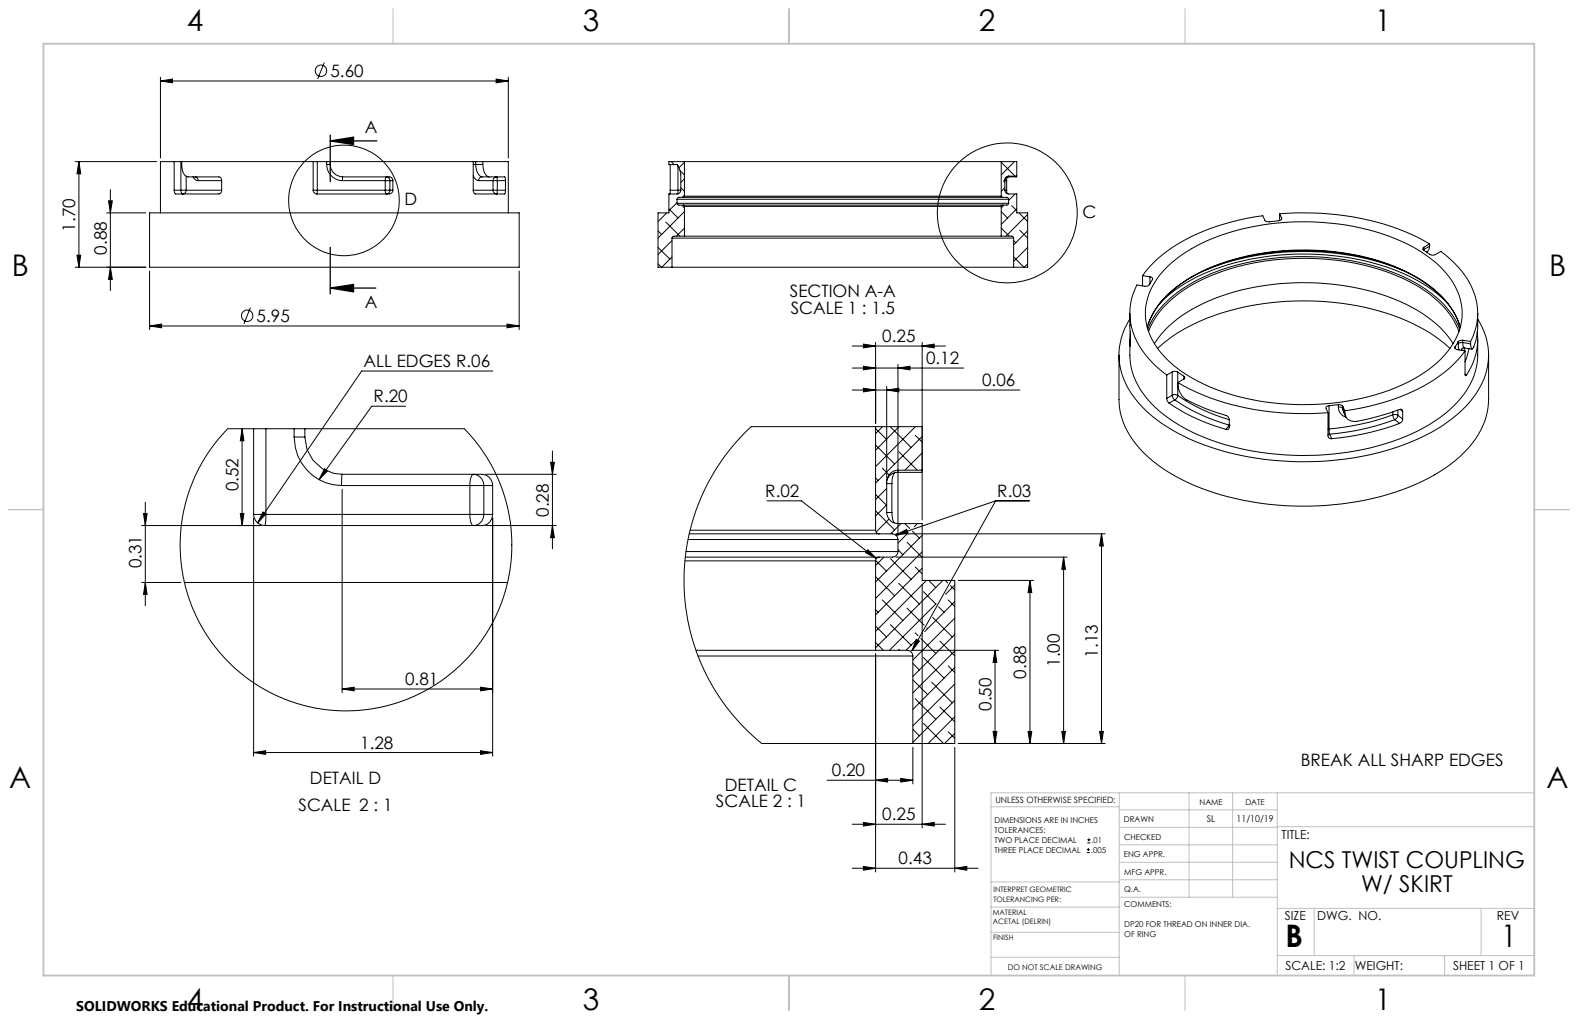
[picture p186: page 1]
DETAIL D SCALE 2 : 1; ALL EDGES R.06; SECTION A-A SCALE 1 : 1.5; DETAIL C SCALE 2 : 1; DO NOT SCALE DRAWING; SHEET 1 OF 1; SCALE: 1:2; WEIGHT:; DWG. NO.; REV; ACETAL (DELRIN)

BREAK ALL SHARP EDGES

UNLESS OTHERWISE SPECIFIED: | | NAME | DATE
DIMENSIONS ARE IN INCHES TOLERANCES: TWO PLACE DECIMAL .01 THREE PLACE DECIMAL .005 | DRAWN | SL | 11/10/19

CHECKED | | | TITLE: NCS TWIST COUPLING W/ SKIRT

ENG APPR.
MFG APPR.

INTERPRET GEOMETRIC TOLERANCING PER: | Q.A.

COMMENTS:
DP20 FOR THREAD ON INNER DIA.
OF RING

SOLIDWORKS Educational Product. For Instructional Use Only.
