psas/lv3.0-recovery/Initial_Designs/Recover_sys_diagram.pdf

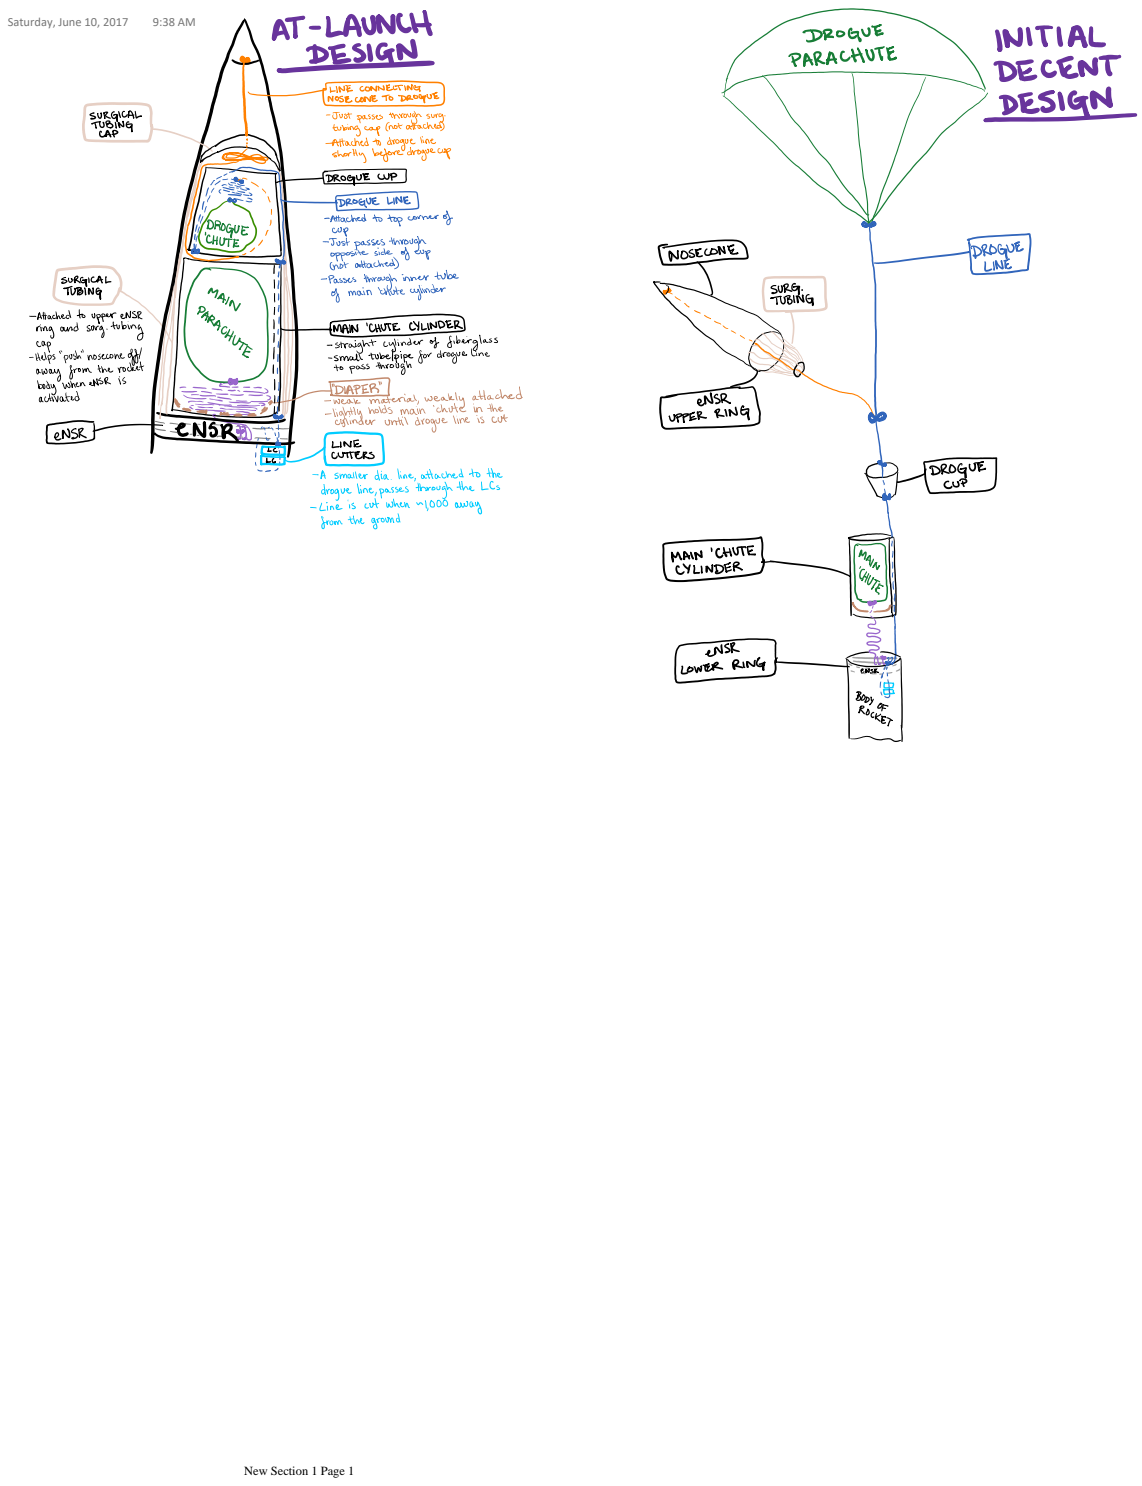
[picture p187: page 1]
Saturday, June 10, 2017

New Section 1 Page 1
