psas/lv3.0-recovery/LV3.1/cad/keeper_ring_V3.pdf

B | B

4

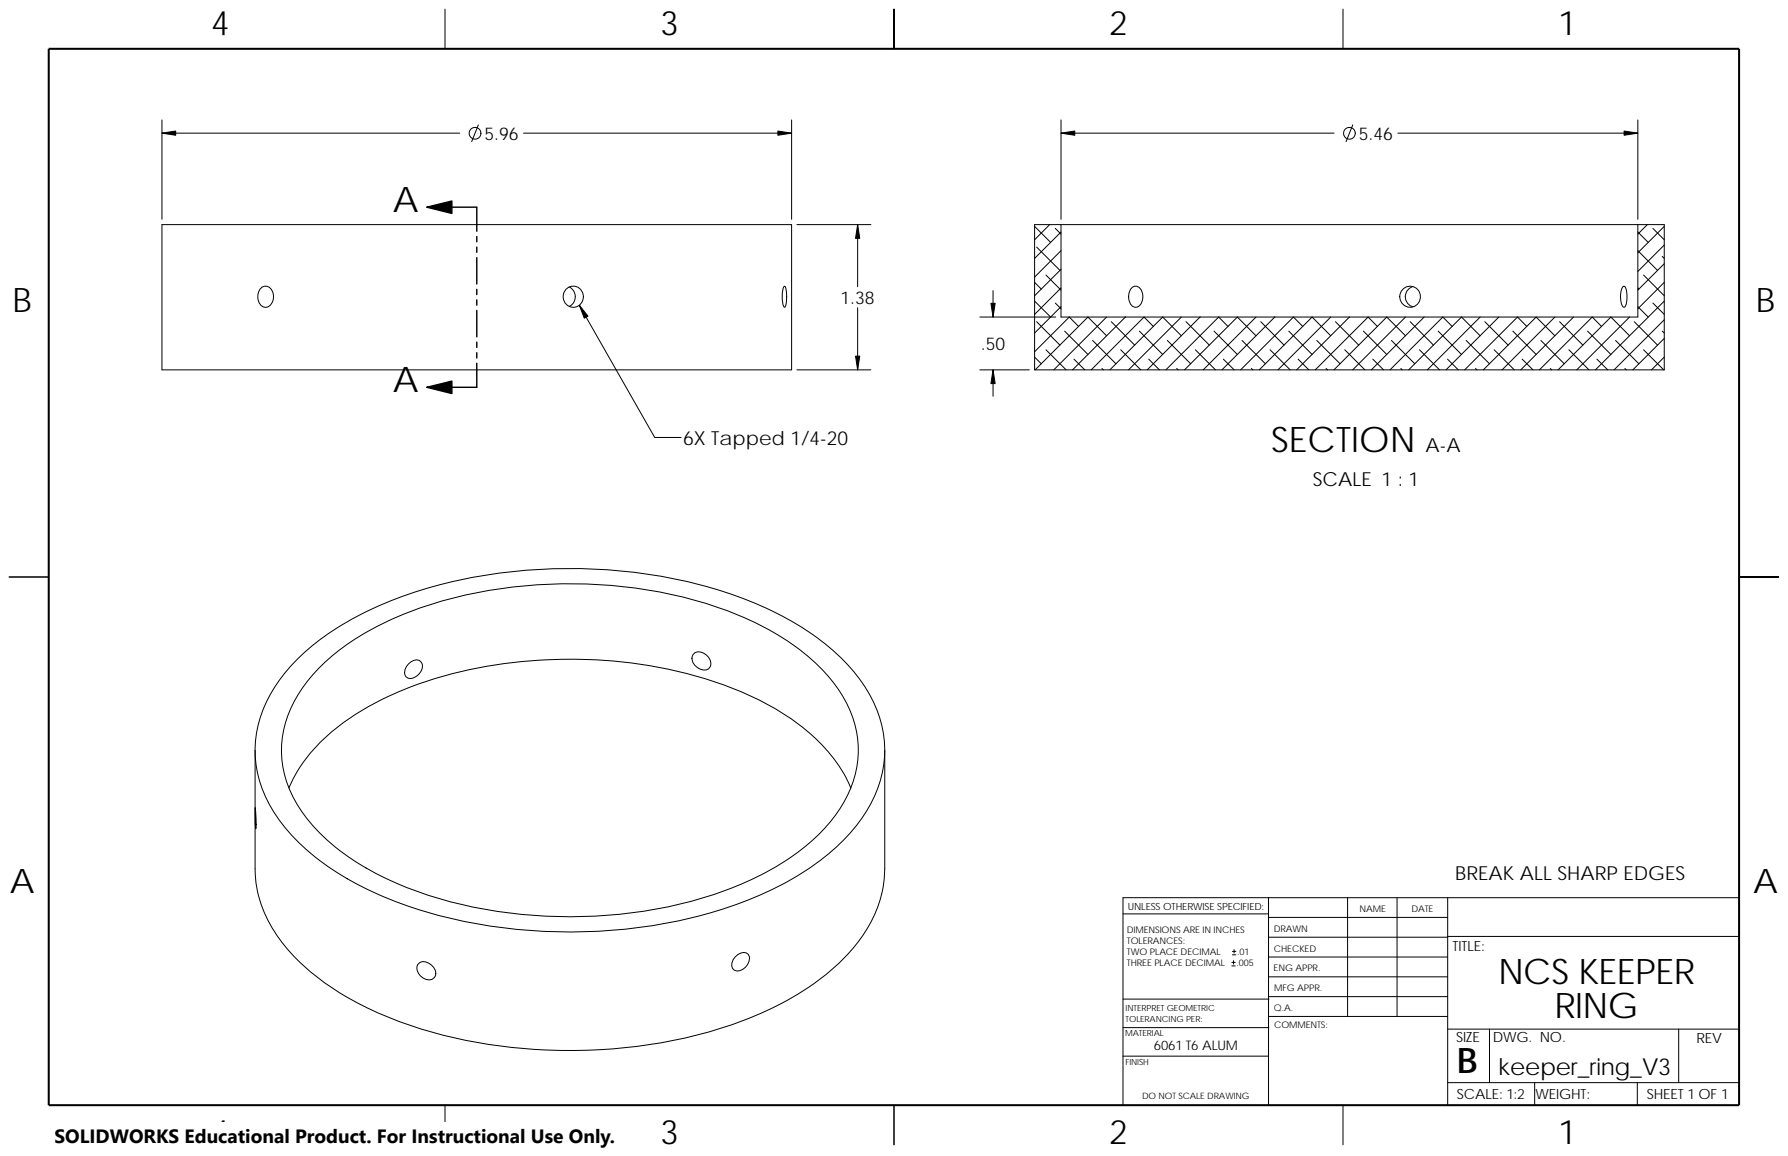
[picture p188: page 1]
DWG. NO.; MATERIAL keeper_ring_V3 FINISH; DO NOT SCALE DRAWING; SHEET 1 OF 1; WEIGHT:; REV; SCALE: 1:2; SIZE; COMMENTS:; 6061 T6 ALUM; 6X Tapped 1/4-20; SECTION A-A; SCALE 1 : 1

BREAK ALL SHARP EDGES

UNLESS OTHERWISE SPECIFIED: | | NAME | DATE

DIMENSIONS ARE IN INCHES TOLERANCES: TWO PLACE DECIMAL .01 THREE PLACE DECIMAL .005 | DRAWN

CHECKED | | | TITLE: NCS KEEPER RING

ENG APPR.
MFG APPR.

INTERPRET GEOMETRIC TOLERANCING PER: | Q.A.

SOLIDWORKS Educational Product. For Instructional Use Only.
