psas/lv3.0-recovery/LV3.1/cad/twist_coupling_V3.pdf

B

B | B

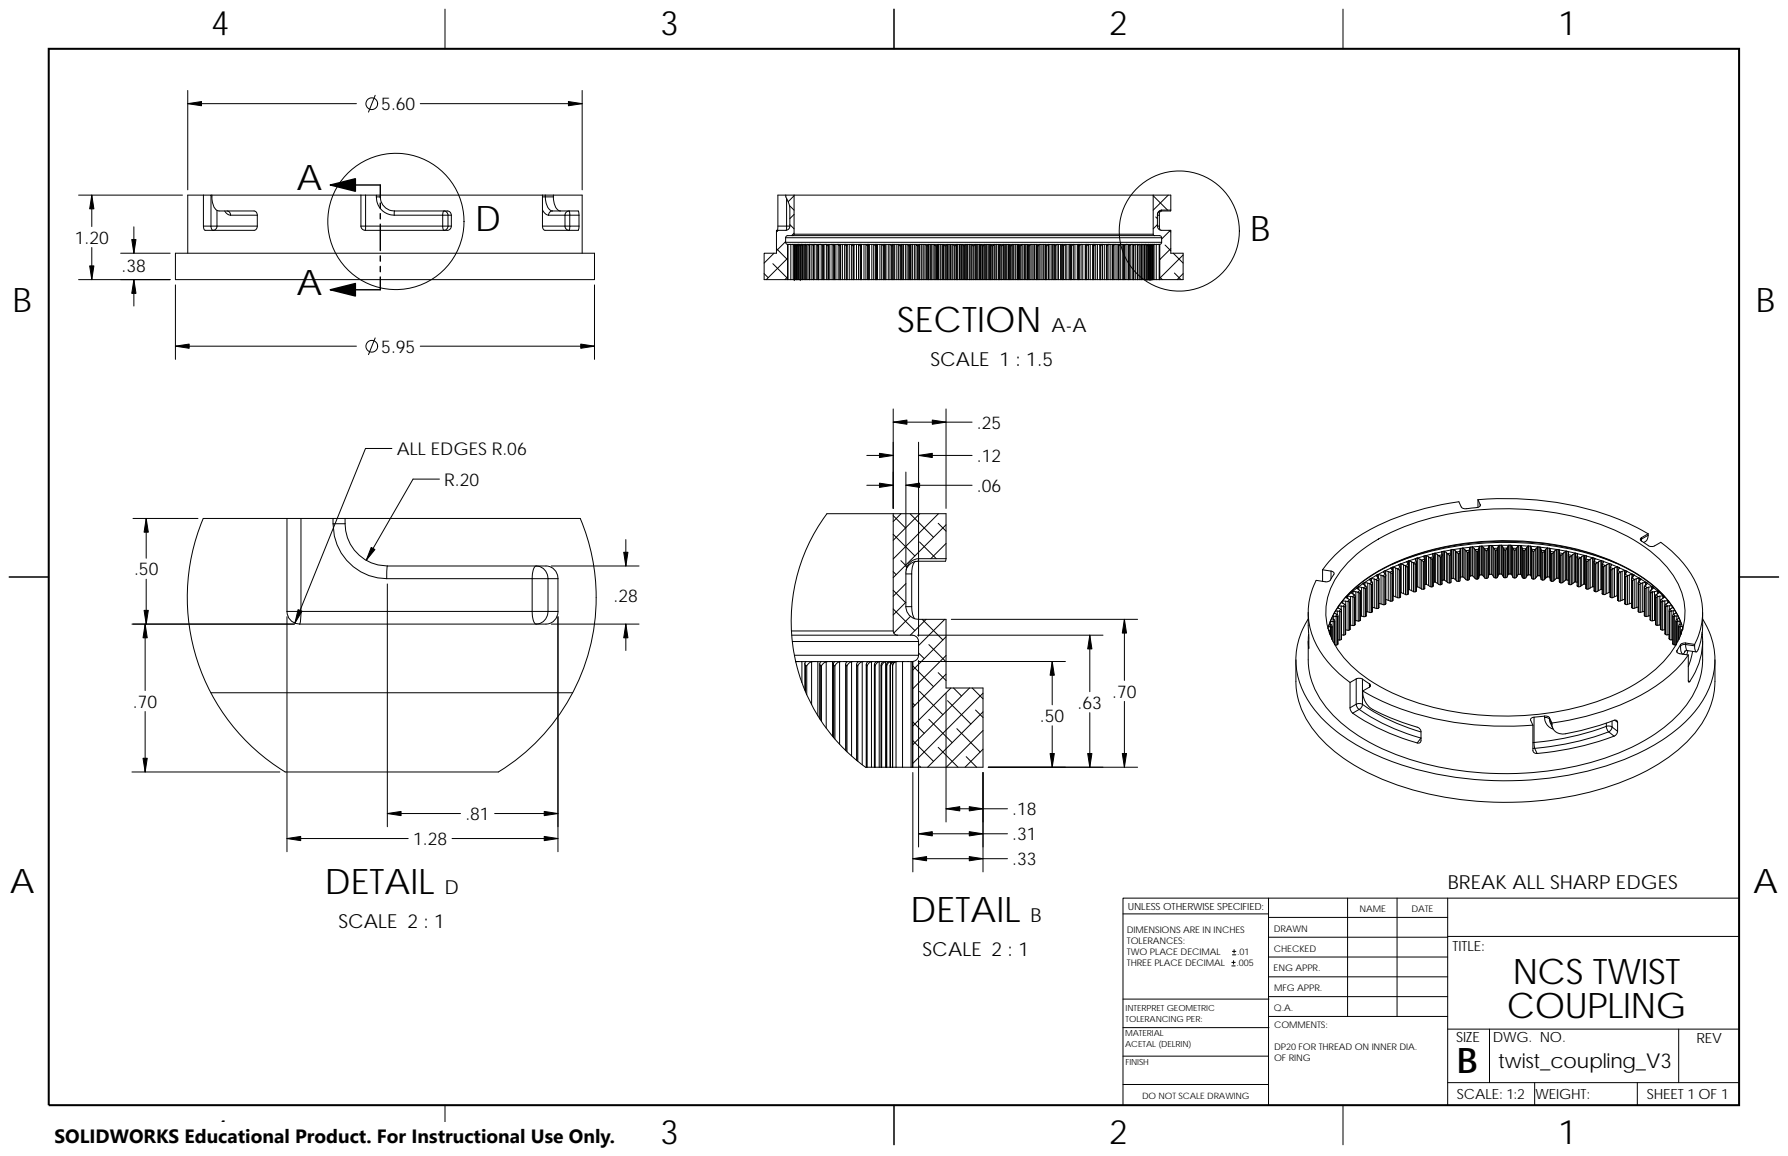
[picture p189: page 1]
SECTION A-A; SCALE; twist_coupling_V3; SHEET 1 OF 1; COMMENTS:; WEIGHT:; COUPLING; REV; SCALE: 1:2; NAME; DATE; DWG. NO.; SIZE; TITLE:; OF RING; NCS TWIST; DIMENSIONS ARE IN INCHES; DRAWN; TWO PLACE DECIMAL; BREAK ALL SHARP EDGES; DETAIL B; SCALE 2 : 1; DETAIL D; ALL EDGES R.06

UNLESS OTHERWISE SPECIFIED:

TOLERANCES:
THREE PLACE DECIMAL .005

CHECKED
ENG APPR.
MFG APPR.
Q.A.

INTERPRET GEOMETRIC
TOLERANCING PER:
MATERIAL
DP20 FOR THREAD ON INNER DIA. ACETAL (DELRIN)
FINISH

DO NOT SCALE DRAWING

SOLIDWORKS Educational Product. For Instructional Use Only.
