psas/lv3.0-recovery/LV3.1/RecoveryBoard/eagle/RecoveryBoard.brd

## EAGLE design LV3.1/RecoveryBoard/eagle/RecoveryBoard.brd (2020-01-25)

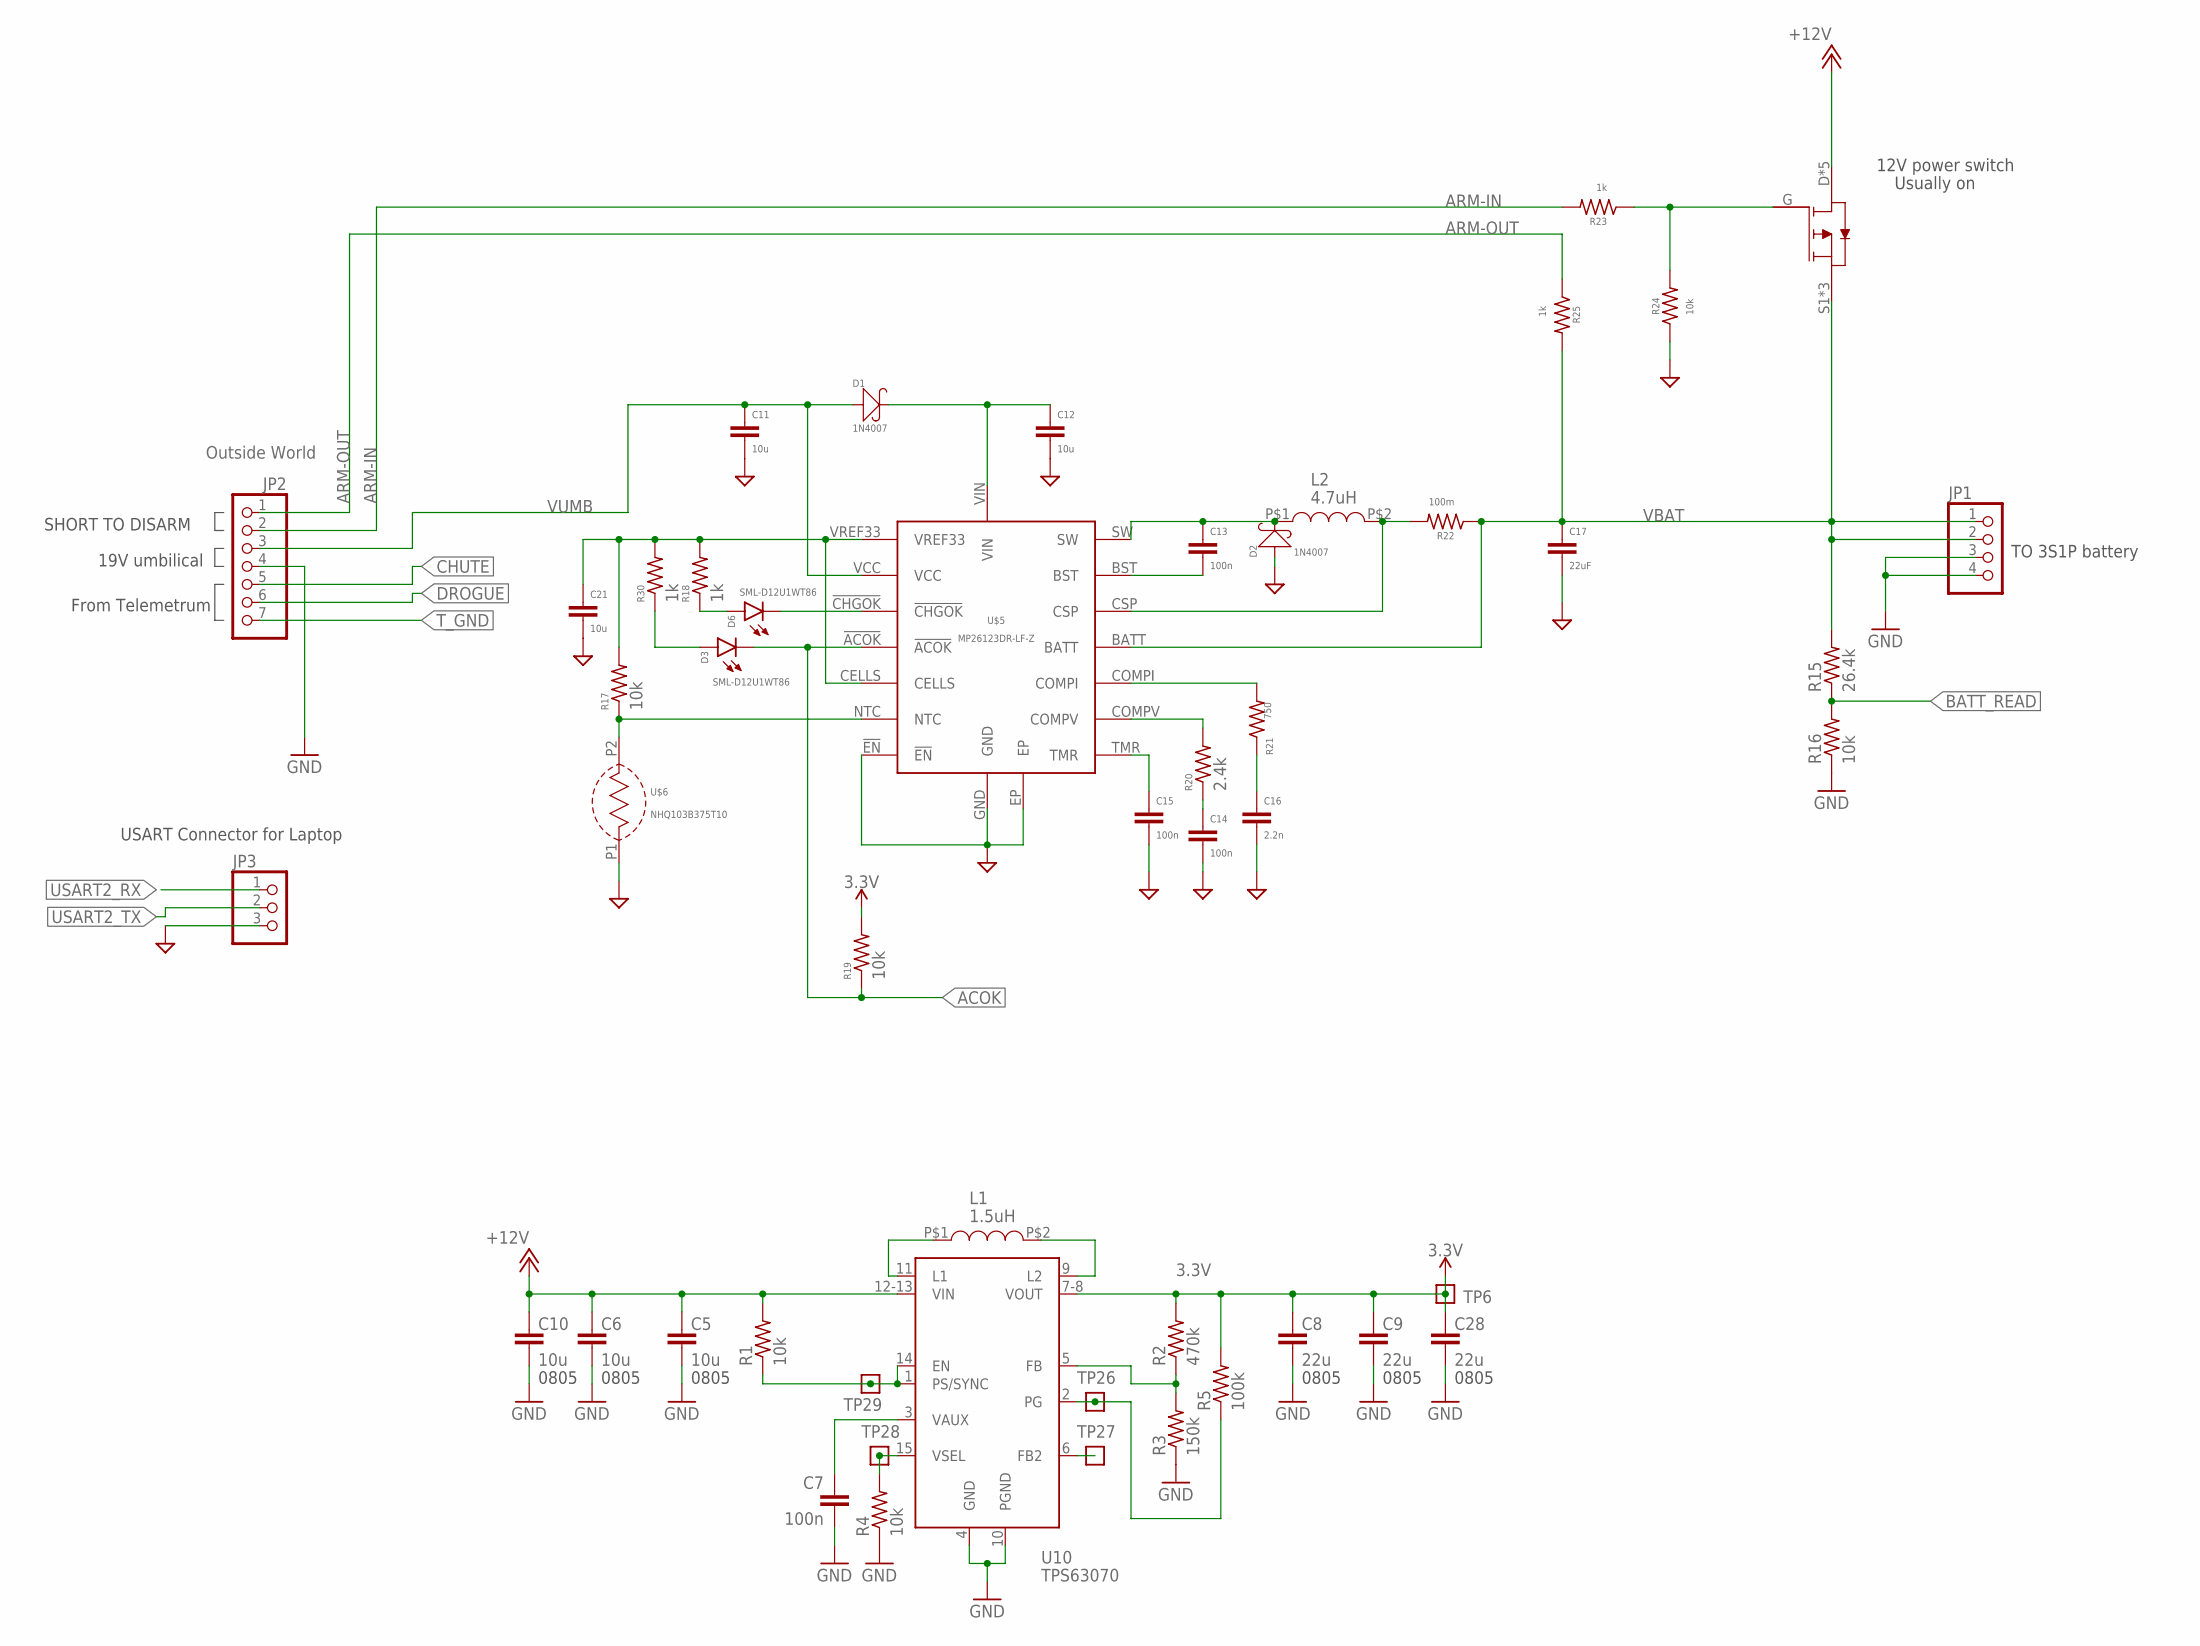
[picture p190: schematic RecoveryBoard.sch, sheet 1, Power]

Parts:
C5: 10u; .0805-C-NOSILK; MPN CL05B104KO5NNNC
C6, C10, C11, C12, C21: 10u; .0805-C-NOSILK
C7: 100n; .0603-C-NOSILK; MPN CL05B104KO5NNNC
C8: 22u; .0805-C-NOSILK; MPN CL05B104KO5NNNC
C9, C28: 22u; .0805-C-NOSILK
C13, C14, C15: 100n; .0603-C-NOSILK
C16: 2.2n; .0603-C-NOSILK
C17: 22uF; .0805-C-NOSILK
D1, D2: 1N4007; DO-214AC
D3, D6: SML-D12U1WT86; CHIPLED_0603; MPN SML-D12U1WT86
JP1: PINHD-1X4; 1X04
JP2: PINHD-1X7; 1X07
JP3: PINHD-1X3; 1X03
L1: 1.5uH; IHLP2020CZER1R5M11
L2: 4.7uH; IHLP2020BZER4R7M11
R1, R4, R16: 10k; .0603-C-NOSILK; MPN RC1005F6653CS
R2: 470k; .0805-A-NOSILK; MPN RC1005F6653CS
R3: 150k; .0603-C-NOSILK; MPN RC1005F6653CS
R5: 100k; .0805-A-NOSILK; MPN RC1005F6653CS
R15: 26.4k; .0603-C-NOSILK; MPN RC1005F6653CS
R17, R19, R24: 10k; .0603-C-NOSILK
R18, R23, R25, R30: 1k; .0603-C-NOSILK
R20: 2.4k; .0603-C-NOSILK
R21: 750; .0603-C-NOSILK
R22: 100m; 1206-C
TP6, TP26, TP27, TP28, TP29: TEST-POINT; 2MM-TEST-POINT
U10: TPS63070; TPS63070X
U$5: MP26123DR-LF-Z
U$6: NHQ103B375T10
U$8: SI7465DP

Connections:
3.3V: C8.1, C9.1, C28.1, R2.2, R5.2, R19.2, TP6.1, U10.7-8 (VOUT); also elsewhere on the board
!BEN: C12.1, D1.2 (-), U$5.VIN
+12V: C5.1, C6.1, C10.1, R1.2, U10.12-13 (VIN), U$8.D, U$8.D1 (D), U$8.D2 (D), U$8.D3 (D), U$8.D4 (D); also elsewhere on the board
ACOK: D3.C, R19.1, U$5.!ACOK; also elsewhere on the board
ARM-IN: JP2.2, R23.2
ARM-OUT: JP2.1, R25.1
BATT_READ: R15.1, R16.2; also elsewhere on the board
CHUTE: JP2.5; also elsewhere on the board
DROGUE: JP2.6; also elsewhere on the board
GND: C5.2, C6.2, C7.2, C8.2, C9.2, C10.2, C11.2, C12.2, C14.2, C15.2, C16.2, C17.2, C21.2, C28.2, D2.1 (+), JP1.3, JP1.4, JP2.4, JP3.3, R3.1, R4.1, R16.1, R24.1, U10.4 (GND), U10.10 (PGND), U$5.!EN, U$5.EP, U$5.GND, U$6.P1; also elsewhere on the board
unnamed: C13.1, D2.2 (-), L2.P$1, U$5.SW
unnamed: C13.2, U$5.BST
unnamed: C21.1, R17.2, R18.2, R30.2, U$5.CELLS, U$5.VREF33
unnamed: D6.C, U$5.!CHGOK
unnamed: D3.A, R30.1
unnamed: R23.1, R24.2, U$8.G
unnamed: D6.A, R18.1
unnamed: R20.2, U$5.COMPV
unnamed: C15.1, U$5.TMR
unnamed: R17.1, U$5.NTC, U$6.P2
unnamed: R21.2, U$5.COMPI
unnamed: C16.1, R21.1
unnamed: L2.P$2, R22.2, U$5.CSP
unnamed: C14.1, R20.1
TPS-EN: R1.1, TP29.1, U10.1 (PS/SYNC), U10.14 (EN)
TPS-FB: R2.1, R3.2, U10.5 (FB)
TPS-FB2: TP27.1, U10.6 (FB2)
TPS-L1: L1.P$1, U10.11 (L1)
TPS-L2: L1.P$2, U10.9 (L2)
TPS-PG: R5.1, TP26.1, U10.2 (PG)
TPS-VAUX: C7.1, U10.3 (VAUX)
TPS-VSEL: R4.2, TP28.1, U10.15 (VSEL)
T_GND: JP2.7; also elsewhere on the board
USART2_RX: JP3.1; also elsewhere on the board
USART2_TX: JP3.2; also elsewhere on the board
VBAT: C17.1, JP1.1, JP1.2, R15.2, R22.1, R25.2, U$5.BATT, U$8.S1 (S), U$8.S2 (S), U$8.S3 (S)
VUMB: C11.1, D1.1 (+), JP2.3, U$5.VCC

Notes on the sheet:
0805
Outside World
TO 3S1P battery
SHORT TO DISARM
19V umbilical
12V power switch
Usually on
From Telemetrum
USART Connector for Laptop

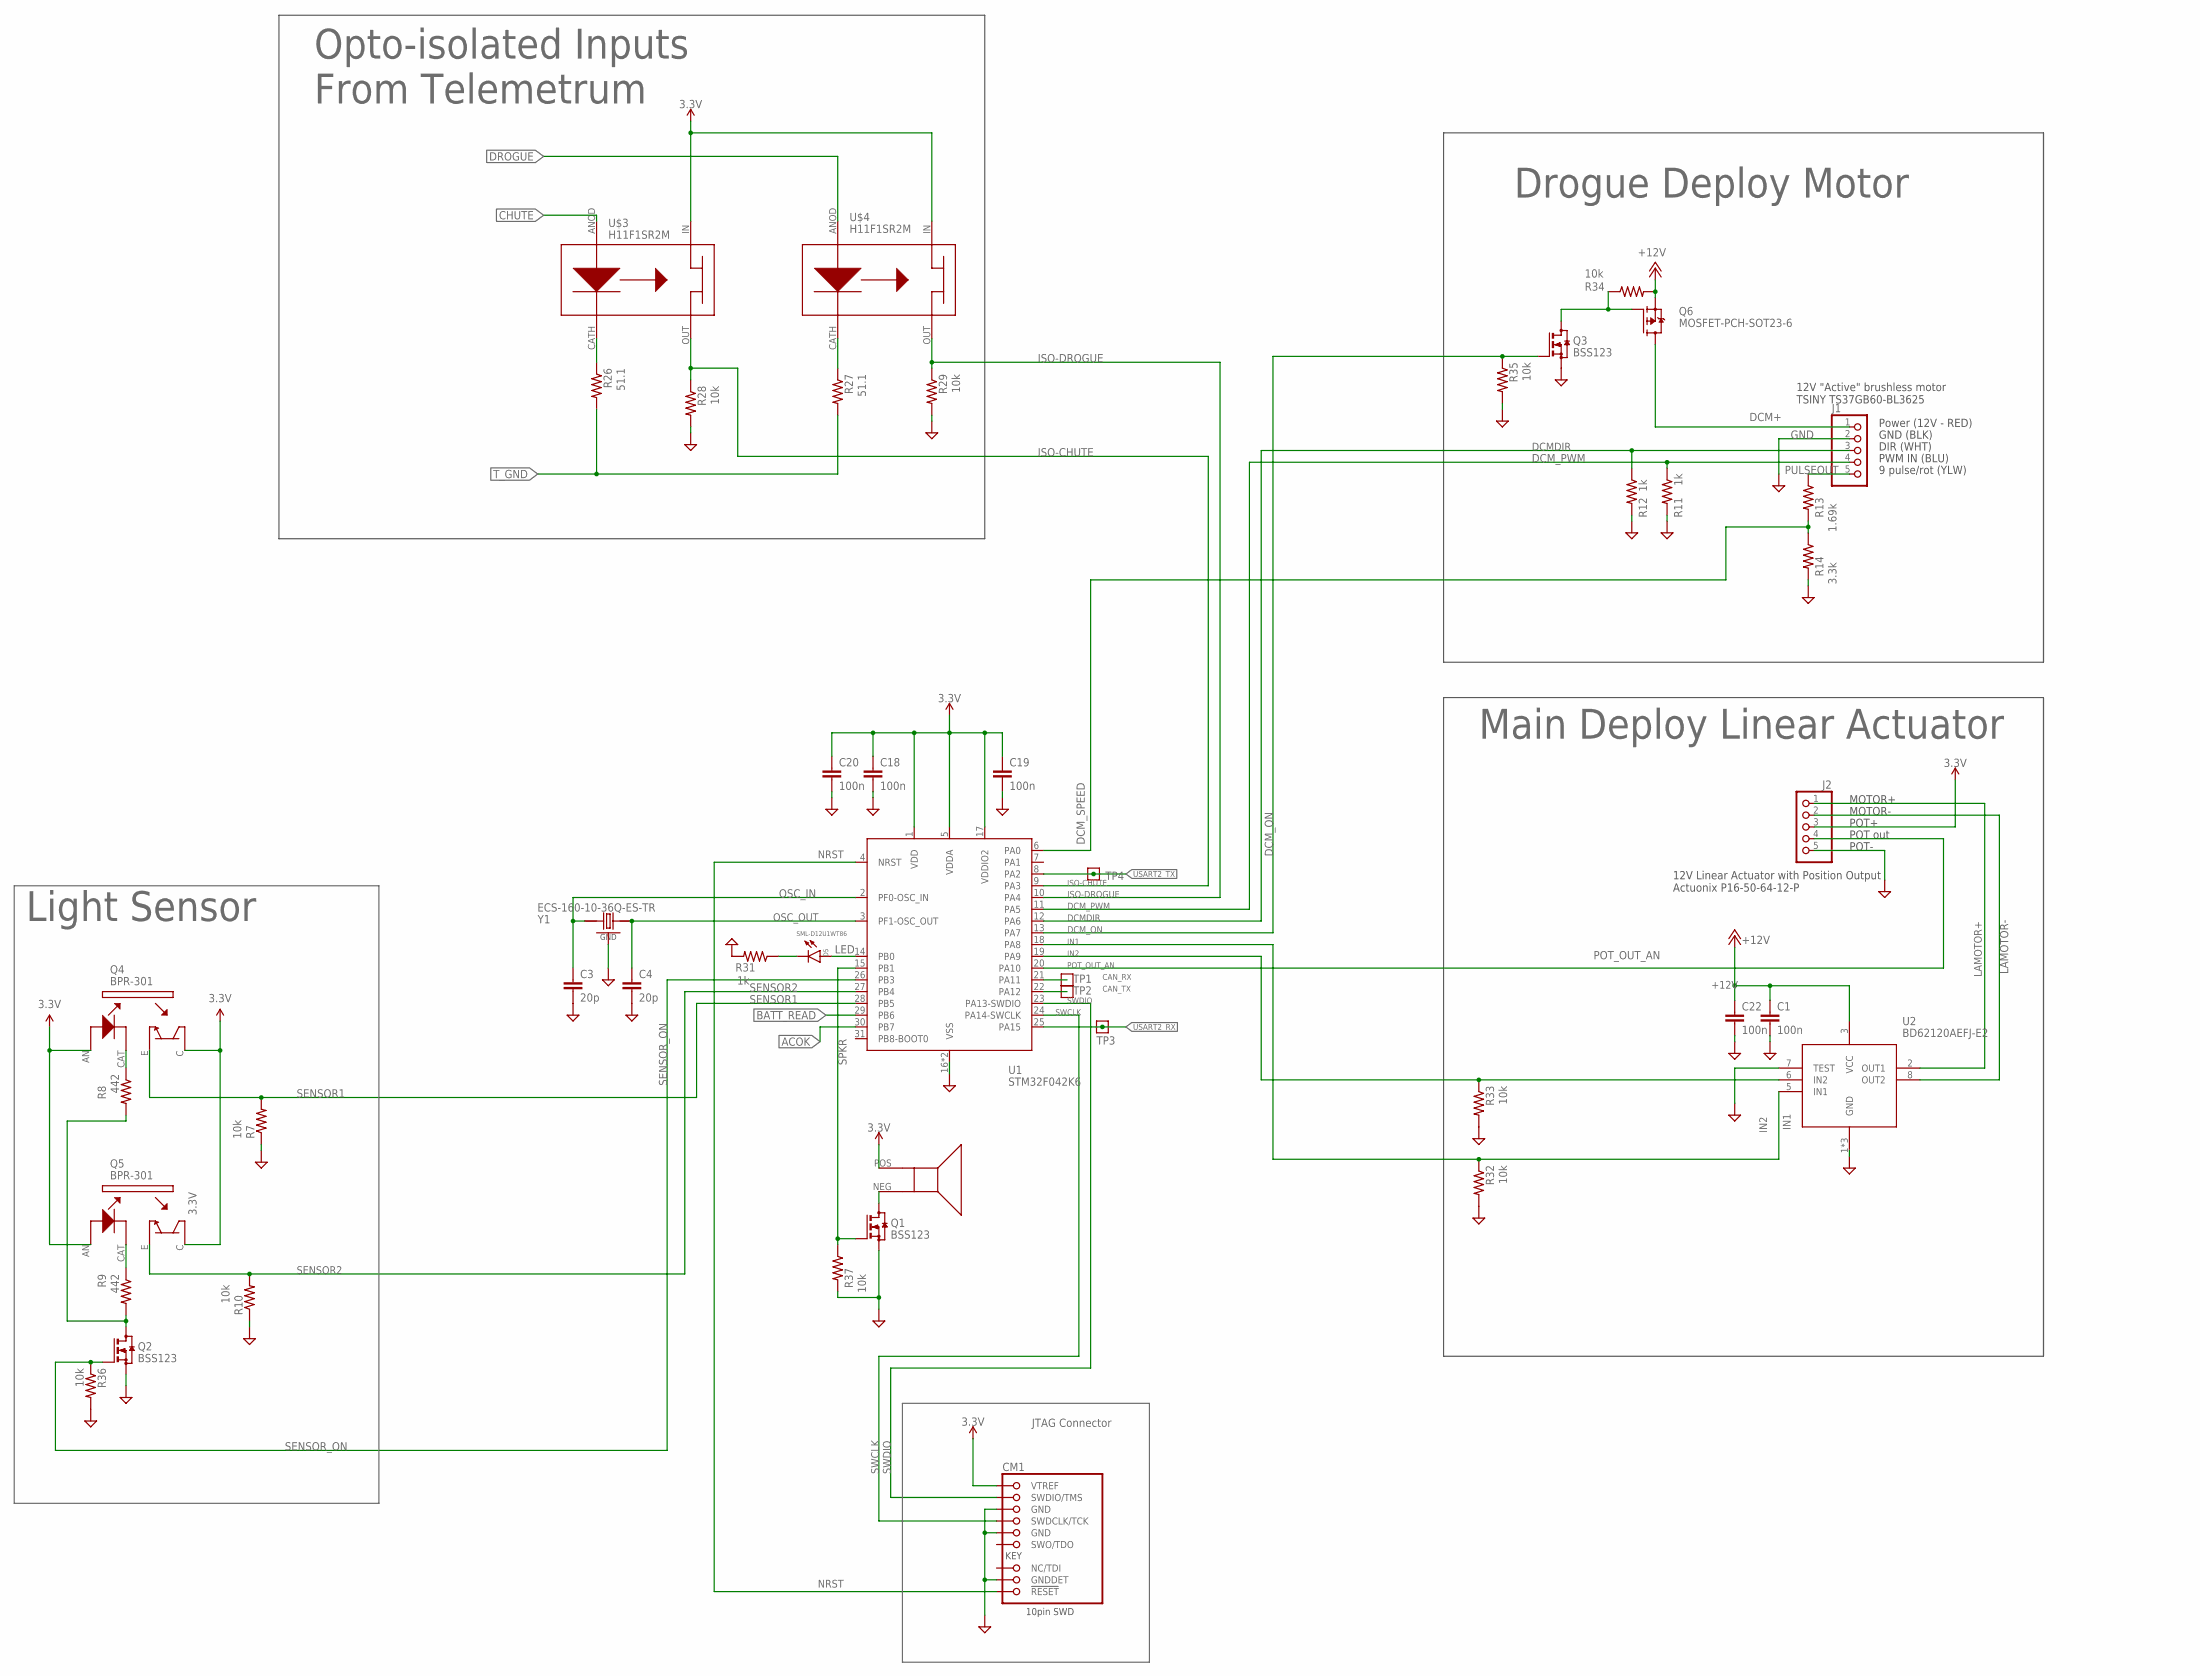
[picture p191: schematic RecoveryBoard.sch, sheet 2, Microcontroller]

Parts:
C1, C18, C19, C20: 100n; .0603-C-NOSILK
C3, C4: 20p; .0603-C-NOSILK
C22: 100n; C1206
CM1: FTSH-105-XX-X-DV-K; CON10_2X5_DUK_FTSH
D5: SML-D12U1WT86; CHIPLED_0603; MPN SML-D12U1WT86
J1, J2: PINHD-1X5; 1X05
Q1, Q2, Q3: BSS123; SOT23
Q4, Q5: BPR-301
Q6: MOSFET-PCH-SOT23-6; SOT23-6
R7, R10, R28, R29, R32, R33, R34, R35, R36, R37: 10k; .0603-C-NOSILK
R8, R9: 442; .0603-C-NOSILK
R11, R12, R31: 1k; .0603-C-NOSILK
R13: 1.69k; .0603-C-NOSILK
R14: 3.3k; .0603-C-NOSILK
R26, R27: 51.1; .0603-C-NOSILK
TP1, TP2, TP3, TP4: TEST-POINT; 2MM-TEST-POINT
U1: STM32F042K6; QFP32-7X7
U2: BD62120AEFJ-E2; SOIC127P600X100-9N
U$3, U$4: H11F1SR2M
U$7: SMT-0440-S-R
Y1: ECS-160-10-36Q-ES-TR; XTAL_ECS-160-10-36Q-ES-TR

Connections:
3.3V: C18.1, C19.1, C20.1, CM1.1 (VTREF), J2.3, Q4.AN (ANOD), Q4.C (COLL), Q5.AN (ANOD), Q5.C (COLL), U1.1 (VDD), U1.5 (VDDA), U1.17 (VDDIO2), U$3.IN, U$4.IN, U$7.POS; also elsewhere on the board
+12V: C1.1, C22.1, Q6.4 (S), R34.2, U2.3 (VCC); also elsewhere on the board
ACOK: U1.30 (PB7); also elsewhere on the board
BATT_READ: U1.29 (PB6); also elsewhere on the board
CAN_RX: TP1.1, U1.21 (PA11)
CAN_TX: TP2.1, U1.22 (PA12)
CHUTE: U$3.ANOD; also elsewhere on the board
DCM+: J1.1, Q6.1 (D), Q6.2 (D), Q6.5 (D), Q6.6 (D)
DCMDIR: J1.3, R12.1, U1.12 (PA6)
DCM_ON: Q3.1 (G), R35.1, U1.13 (PA7)
DCM_PWM: J1.4, R11.1, U1.11 (PA5)
DCM_SPEED: R13.2, R14.1, U1.6 (PA0)
DROGUE: U$4.ANOD; also elsewhere on the board
GND: C1.2, C3.2, C4.2, C18.2, C19.2, C20.2, C22.2, CM1.3 (GND), CM1.5 (GND), CM1.9 (GNDDET), J1.2, J2.5, Q1.2 (S), Q2.2 (S), Q3.2 (S), R7.1, R10.1, R11.2, R12.2, R14.2, R28.2, R29.2, R31.2, R32.2, R33.2, R35.2, R36.2, R37.2, U1.16 (VSS), U1.32 (VSS), U2.1 (GND), U2.4 (GND), U2.9 (GND), Y1.GND, Y1.GND2 (GND); also elsewhere on the board
IN1: R32.1, U1.18 (PA8), U2.5 (IN1)
IN2: R33.1, U1.19 (PA9), U2.6 (IN2)
ISO-CHUTE: R28.1, U1.9 (PA3), U$3.OUT
ISO-DROGUE: R29.1, U1.10 (PA4), U$4.OUT
LAMOTOR+: J2.1, U2.2 (OUT1)
LAMOTOR-: J2.2, U2.8 (OUT2)
LED: D5.A, U1.14 (PB0)
unnamed: Q1.3 (D), U$7.NEG
unnamed: Q4.CAT (CATH), R8.1
unnamed: D5.C, R31.1
unnamed: Q5.CAT (CATH), R9.1
unnamed: Q3.3 (D), Q6.3 (G), R34.1
unnamed: R26.1, U$3.CATH (CAT)
unnamed: R27.1, U$4.CATH (CAT)
unnamed: Q2.3 (D), R8.2, R9.2
NRST: CM1.10 (!RESET), U1.4 (NRST)
OSC_IN: C3.1, U1.2 (PF0-OSC_IN), Y1.IN/OUT
OSC_OUT: C4.1, U1.3 (PF1-OSC_OUT), Y1.OUT/IN
POT_OUT_AN: J2.4, U1.20 (PA10)
PULSEOUT: J1.5, R13.1
SENSOR1: Q4.E (EMIT), R7.2, U1.28 (PB5)
SENSOR2: Q5.E (EMIT), R10.2, U1.27 (PB4)
SENSOR_ON: Q2.1 (G), R36.1, U1.26 (PB3)
SPKR: Q1.1 (G), R37.1, U1.15 (PB1)
SWCLK: CM1.4 (SWDCLK/TCK), U1.24 (PA14-SWCLK)
SWDIO: CM1.2 (SWDIO/TMS), U1.23 (PA13-SWDIO)
T_GND: R26.2, R27.2; also elsewhere on the board
USART2_RX: TP3.1, U1.25 (PA15); also elsewhere on the board
USART2_TX: TP4.1, U1.8 (PA2); also elsewhere on the board

Notes on the sheet:
Light Sensor
JTAG Connector
12V Linear Actuator with Position Output Actuonix P16-50-64-12-P
12V "Active" brushless motor TSINY TS37GB60-BL3625
MOTOR+
MOTOR-
POT+
POT out
POT-
Power (12V - RED)
GND (BLK)
DIR (WHT)
PWM IN (BLU)
9 pulse/rot (YLW)
Opto-isolated Inputs From Telemetrum
Drogue Deploy Motor
Main Deploy Linear Actuator

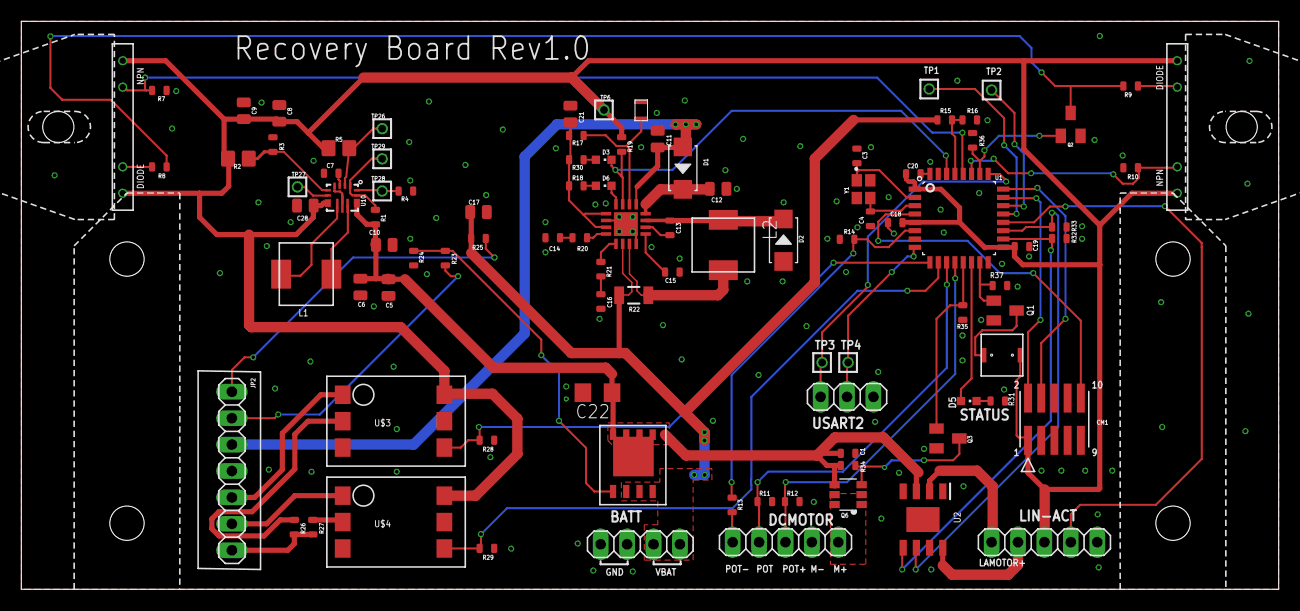
[picture p192: board RecoveryBoard.brd from above]

Board: 2 copper layers, 120.9 x 54.6 mm, 96 parts (0 on the bottom side), 70 nets.
