psas/lv3.0-recovery/Control_System/bldc-tool/ui_mainwindow.h

/********************************************************************************
** Form generated from reading UI file 'mainwindow.ui'
**
** Created by: Qt User Interface Compiler version 5.5.1
**
** WARNING! All changes made in this file will be lost when recompiling UI file!
********************************************************************************/

#ifndef UI_MAINWINDOW_H
#define UI_MAINWINDOW_H

#include <QtCore/QVariant>
#include <QtWidgets/QAction>
#include <QtWidgets/QApplication>
#include <QtWidgets/QButtonGroup>
#include <QtWidgets/QCheckBox>
#include <QtWidgets/QComboBox>
#include <QtWidgets/QDoubleSpinBox>
#include <QtWidgets/QGridLayout>
#include <QtWidgets/QGroupBox>
#include <QtWidgets/QHBoxLayout>
#include <QtWidgets/QHeaderView>
#include <QtWidgets/QLCDNumber>
#include <QtWidgets/QLabel>
#include <QtWidgets/QLineEdit>
#include <QtWidgets/QMainWindow>
#include <QtWidgets/QProgressBar>
#include <QtWidgets/QPushButton>
#include <QtWidgets/QRadioButton>
#include <QtWidgets/QSlider>
#include <QtWidgets/QSpacerItem>
#include <QtWidgets/QSpinBox>
#include <QtWidgets/QSplitter>
#include <QtWidgets/QStatusBar>
#include <QtWidgets/QTabWidget>
#include <QtWidgets/QTextBrowser>
#include <QtWidgets/QToolBox>
#include <QtWidgets/QVBoxLayout>
#include <QtWidgets/QWidget>
#include "mrichtextedit.h"
#include "qcustomplot.h"
#include "rtdatawidget.h"

QT_BEGIN_NAMESPACE

class Ui_MainWindow
{
public:
    QWidget *centralWidget;
    QHBoxLayout *horizontalLayout;
    QVBoxLayout *verticalLayout_6;
    QTabWidget *tabWidget;
    QWidget *tab_11;
    QVBoxLayout *verticalLayout_31;
    QTabWidget *tabWidget_4;
    QWidget *tab_12;
    QVBoxLayout *verticalLayout_24;
    QGroupBox *groupBox_29;
    QHBoxLayout *horizontalLayout_34;
    QRadioButton *mcconfTypeBldcButton;
    QRadioButton *mcconfTypeDcButton;
    QRadioButton *mcconfTypeFocButton;
    QSpacerItem *horizontalSpacer_15;
    QGridLayout *gridLayout_24;
    QGroupBox *groupBox_8;
    QHBoxLayout *horizontalLayout_18;
    QGridLayout *gridLayout_9;
    QLabel *label_19;
    QLabel *label_20;
    QDoubleSpinBox *mcconfLimCurrentInMinBox;
    QLabel *label_18;
    QLabel *label_17;
    QDoubleSpinBox *mcconfLimCurrentAbsMaxBox;
    QDoubleSpinBox *mcconfLimCurrentMinBox;
    QDoubleSpinBox *mcconfLimCurrentInMaxBox;
    QLabel *label_16;
    QDoubleSpinBox *mcconfLimCurrentMaxBox;
    QCheckBox *mcconfLimCurrentSlowAbsMaxBox;
    QGroupBox *groupBox_9;
    QHBoxLayout *horizontalLayout_19;
    QGridLayout *gridLayout_10;
    QLabel *label_21;
    QDoubleSpinBox *mcconfLimMaxErpmBox;
    QDoubleSpinBox *mcconfLimMaxErpmFbrakeBox;
    QDoubleSpinBox *mcconfLimMinErpmBox;
    QLabel *label_22;
    QLabel *label_23;
    QCheckBox *mcconfLimErpmLimitNegTorqueBox;
    QSpacerItem *verticalSpacer_11;
    QLabel *label_62;
    QDoubleSpinBox *mcconfLimMaxErpmFbrakeCcBox;
    QGroupBox *groupBox_27;
    QGridLayout *gridLayout_23;
    QLabel *label_57;
    QDoubleSpinBox *mcconfLimTempFetStartBox;
    QLabel *label_58;
    QDoubleSpinBox *mcconfLimTempFetEndBox;
    QLabel *label_59;
    QDoubleSpinBox *mcconfLimTempMotorStartBox;
    QLabel *label_60;
    QDoubleSpinBox *mcconfLimTempMotorEndBox;
    QGroupBox *groupBox_10;
    QHBoxLayout *horizontalLayout_20;
    QGridLayout *gridLayout_11;
    QLabel *label_86;
    QLabel *label_25;
    QLabel *label_24;
    QDoubleSpinBox *mcconfLimMinVinBox;
    QDoubleSpinBox *mcconfLimMaxVinBox;
    QLabel *label_87;
    QDoubleSpinBox *mcconfLimBatteryCutStartBox;
    QDoubleSpinBox *mcconfLimBatteryCutEndBox;
    QGroupBox *groupBox_38;
    QGridLayout *gridLayout_36;
    QLabel *label_83;
    QLabel *label_84;
    QDoubleSpinBox *mcconfLimMaxDutyBox;
    QDoubleSpinBox *mcconfLimMinDutyBox;
    QSpacerItem *verticalSpacer_4;
    QWidget *tab_13;
    QVBoxLayout *verticalLayout_23;
    QGroupBox *groupBox_34;
    QHBoxLayout *horizontalLayout_43;
    QRadioButton *mcconfSensorModeSensorlessButton;
    QRadioButton *mcconfSensorModeSensoredButton;
    QRadioButton *mcconfSensorModeHybridButton;
    QSpacerItem *horizontalSpacer_20;
    QHBoxLayout *horizontalLayout_21;
    QGroupBox *mcconfSlBox;
    QGridLayout *gridLayout_12;
    QLabel *label_26;
    QDoubleSpinBox *mcconfSlMinErpmBox;
    QLabel *label_30;
    QDoubleSpinBox *mcconfSlBrErpmBox;
    QLabel *label_29;
    QDoubleSpinBox *mcconfSlIntLimScaleBrBox;
    QLabel *label_61;
    QDoubleSpinBox *mcconfSlMaxFbCurrBox;
    QGroupBox *groupBox_16;
    QGridLayout *gridLayout_46;
    QLabel *label_100;
    QRadioButton *mcconfCommIntButton;
    QRadioButton *mcconfCommDelayButton;
    QLabel *label_28;
    QDoubleSpinBox *mcconfSlIntLimBox;
    QLabel *label_27;
    QDoubleSpinBox *mcconfSlMinErpmIlBox;
    QLabel *label_41;
    QDoubleSpinBox *mcconfSlBemfKBox;
    QGroupBox *groupBox_12;
    QVBoxLayout *verticalLayout_20;
    QHBoxLayout *horizontalLayout_22;
    QLabel *label_31;
    QSpinBox *mcconfHallTab0Box;
    QSpinBox *mcconfHallTab1Box;
    QSpinBox *mcconfHallTab2Box;
    QSpinBox *mcconfHallTab3Box;
    QSpinBox *mcconfHallTab4Box;
    QSpinBox *mcconfHallTab5Box;
    QSpinBox *mcconfHallTab6Box;
    QSpinBox *mcconfHallTab7Box;
    QLabel *label_32;
    QDoubleSpinBox *mcconfHallSlErpmBox;
    QSpacerItem *horizontalSpacer_8;
    QSpacerItem *verticalSpacer_7;
    QGroupBox *groupBox_11;
    QHBoxLayout *horizontalLayout_24;
    QGridLayout *gridLayout_47;
    QPushButton *mcconfDetectMotorParamButton;
    QSpacerItem *verticalSpacer_5;
    QPushButton *mcconfDetectApplyButton;
    QGridLayout *gridLayout_7;
    QDoubleSpinBox *mcconfDetectCurrentBox;
    QLabel *label_44;
    QDoubleSpinBox *mcconfDetectErpmBox;
    QLabel *label_42;
    QDoubleSpinBox *mcconfDetectLowDutyBox;
    QLabel *label_43;
    QTextBrowser *mcconfDetectResultBrowser;
    QWidget *tab_24;
    QVBoxLayout *verticalLayout_29;
    QGridLayout *gridLayout_42;
    QGroupBox *groupBox_39;
    QGridLayout *gridLayout_39;
    QDoubleSpinBox *mcconfFocEncoderRatioBox;
    QLabel *label_89;
    QDoubleSpinBox *mcconfFocCurrKpBox;
    QDoubleSpinBox *mcconfFocCurrKiBox;
    QLabel *label_92;
    QDoubleSpinBox *mcconfFocEncoderOffsetBox;
    QLabel *label_101;
    QCheckBox *mcconfFocEncoderInvertedBox;
    QHBoxLayout *horizontalLayout_26;
    QRadioButton *mcconfFocModeEncoderButton;
    QRadioButton *mcconfFocModeHallButton;
    QRadioButton *mcconfFocModeSensorlessButton;
    QDoubleSpinBox *mcconfFocSlErpmBox;
    QLabel *label_96;
    QGroupBox *groupBox_41;
    QGridLayout *gridLayout_40;
    QLabel *label_104;
    QDoubleSpinBox *mcconfFocPllKpBox;
    QDoubleSpinBox *mcconfFocDutyDownrampKiBox;
    QLabel *label_103;
    QDoubleSpinBox *mcconfFocPllKiBox;
    QLabel *label_90;
    QDoubleSpinBox *mcconfFocOpenloopRpmBox;
    QDoubleSpinBox *mcconfFocDutyDownrampKpBox;
    QSpinBox *mcconfFocFSwBox;
    QLabel *label_94;
    QDoubleSpinBox *mcconfFocDtCompBox;
    QGroupBox *groupBox_40;
    QGridLayout *gridLayout_41;
    QDoubleSpinBox *mcconfFocObserverGainBox;
    QLabel *label_98;
    QPushButton *mcconfFocObserverGainCalcButton;
    QDoubleSpinBox *mcconfFocMotorRBox;
    QDoubleSpinBox *mcconfFocMotorLBox;
    QDoubleSpinBox *mcconfFocMotorLinkageBox;
    QGroupBox *groupBox_43;
    QGridLayout *gridLayout_44;
    QDoubleSpinBox *mcconfFocDCurrentFactorBox;
    QDoubleSpinBox *mcconfFocSlOpenloopHystBox;
    QLabel *label_105;
    QLabel *label_107;
    QDoubleSpinBox *mcconfFocDCurrentDutyBox;
    QDoubleSpinBox *mcconfFocSlOpenloopTimeBox;
    QGroupBox *groupBox_46;
    QHBoxLayout *horizontalLayout_45;
    QLabel *label_95;
    QSpinBox *mcconfFocHallTab0Box;
    QSpinBox *mcconfFocHallTab1Box;
    QSpinBox *mcconfFocHallTab2Box;
    QSpinBox *mcconfFocHallTab3Box;
    QSpinBox *mcconfFocHallTab4Box;
    QSpinBox *mcconfFocHallTab5Box;
    QSpinBox *mcconfFocHallTab6Box;
    QSpinBox *mcconfFocHallTab7Box;
    QSpacerItem *horizontalSpacer_23;
    QSpacerItem *verticalSpacer_17;
    QGroupBox *groupBox_44;
    QGridLayout *gridLayout_45;
    QSpacerItem *horizontalSpacer_29;
    QDoubleSpinBox *mcconfFocCalcCCTcBox;
    QPushButton *mcconfFocMeasureLinkageButton;
    QPushButton *mcconfFocMeasureRLButton;
    QDoubleSpinBox *mcconfFocDetectRBox;
    QDoubleSpinBox *mcconfFocDetectLBox;
    QPushButton *mcconfFocApplyRLLambdaButton;
    QPushButton *mcconfFocCalcCCButton;
    QPushButton *mcconfFocCalcCCApplyButton;
    QDoubleSpinBox *mcconfFocDetectLinkageBox;
    QDoubleSpinBox *mcconfFocCalcKiBox;
    QDoubleSpinBox *mcconfFocCalcKpBox;
    QDoubleSpinBox *mcconfFocDetectCurrentBox;
    QDoubleSpinBox *mcconfFocDetectDutyBox;
    QDoubleSpinBox *mcconfFocDetectMinRpmBox;
    QLabel *label_93;
    QGroupBox *groupBox_42;
    QHBoxLayout *horizontalLayout_25;
    QPushButton *mcconfFocMeasureEncoderButton;
    QDoubleSpinBox *mcconfFocMeasureEncoderCurrentBox;
    QSpacerItem *horizontalSpacer_26;
    QDoubleSpinBox *mcconfFocMeasureEncoderOffsetBox;
    QDoubleSpinBox *mcconfFocMeasureEncoderRatioBox;
    QCheckBox *mcconfFocMeasureEncoderInvertedBox;
    QSpacerItem *horizontalSpacer_27;
    QPushButton *mcconfFocMeasureEncoderApplyButton;
    QGroupBox *groupBox_45;
    QHBoxLayout *horizontalLayout_38;
    QPushButton *mcconfFocMeasureHallButton;
    QDoubleSpinBox *mcconfFocMeasureHallCurrentBox;
    QSpacerItem *horizontalSpacer_25;
    QSpinBox *mcconfFocMeasureHallTab0Box;
    QSpinBox *mcconfFocMeasureHallTab1Box;
    QSpinBox *mcconfFocMeasureHallTab2Box;
    QSpinBox *mcconfFocMeasureHallTab3Box;
    QSpinBox *mcconfFocMeasureHallTab4Box;
    QSpinBox *mcconfFocMeasureHallTab5Box;
    QSpinBox *mcconfFocMeasureHallTab6Box;
    QSpinBox *mcconfFocMeasureHallTab7Box;
    QSpacerItem *horizontalSpacer_24;
    QPushButton *mcconfFocMeasureHallApplyButton;
    QWidget *tab_14;
    QVBoxLayout *verticalLayout_27;
    QGroupBox *groupBox_13;
    QHBoxLayout *horizontalLayout_44;
    QRadioButton *mcconfPwmModeSyncButton;
    QRadioButton *mcconfPwmModeBipolarButton;
    QRadioButton *mcconfPwmModeNonsyncHiswButton;
    QSpacerItem *horizontalSpacer_21;
    QHBoxLayout *horizontalLayout_23;
    QGroupBox *groupBox_14;
    QGridLayout *gridLayout_14;
    QLabel *label_34;
    QDoubleSpinBox *mcconfCcBoostBox;
    QLabel *label_35;
    QDoubleSpinBox *mcconfCcMinBox;
    QLabel *label_36;
    QDoubleSpinBox *mcconfCcGainBox;
    QSpacerItem *verticalSpacer_16;
    QGroupBox *groupBox_37;
    QGridLayout *gridLayout_37;
    QLabel *label_3;
    QDoubleSpinBox *mcconfMDutyRampStepBox;
    QLabel *label_69;
    QDoubleSpinBox *mcconfCcMaxRampStepBox;
    QLabel *label_85;
    QDoubleSpinBox *mcconfMCurrentBackoffGainBox;
    QLabel *label_33;
    QDoubleSpinBox *mcconfMDutyRampStepSpeedLimBox;
    QHBoxLayout *horizontalLayout_39;
    QGroupBox *groupBox_15;
    QGridLayout *gridLayout_15;
    QLabel *label_37;
    QDoubleSpinBox *mcconfSpidKpBox;
    QLabel *label_38;
    QDoubleSpinBox *mcconfSpidKiBox;
    QLabel *label_39;
    QDoubleSpinBox *mcconfSpidKdBox;
    QLabel *label_40;
    QDoubleSpinBox *mcconfSpidMinRpmBox;
    QGroupBox *groupBox_30;
    QGridLayout *gridLayout_26;
    QLabel *label_68;
    QDoubleSpinBox *mcconfPpidKiBox;
    QLabel *label_70;
    QDoubleSpinBox *mcconfPpidKdBox;
    QLabel *label_71;
    QDoubleSpinBox *mcconfPpidKpBox;
    QLabel *label_11;
    QDoubleSpinBox *mcconfPpidAngDivBox;
    QHBoxLayout *horizontalLayout_53;
    QGroupBox *groupBox_17;
    QGridLayout *gridLayout_38;
    QLabel *label_4;
    QSpinBox *mcconfMEncoderCountBox;
    QSpinBox *mcconfMFaultStopTimeBox;
    QLabel *label_91;
    QGroupBox *groupBox_3;
    QGridLayout *gridLayout_43;
    QRadioButton *mcconfMSensorHallButton;
    QRadioButton *mcconfMSensorAsSpiButton;
    QRadioButton *mcconfMSensorAbiButton;
    QSpacerItem *horizontalSpacer_22;
    QSpacerItem *verticalSpacer_8;
    QWidget *tab_4;
    QVBoxLayout *verticalLayout_25;
    MRichTextEdit *mcconfDescEdit;
    QHBoxLayout *horizontalLayout_17;
    QPushButton *mcconfReadButton;
    QPushButton *mcconfReadDefaultButton;
    QPushButton *mcconfWriteButton;
    QSpacerItem *horizontalSpacer_6;
    QPushButton *mcconfLoadXmlButton;
    QPushButton *mcconfSaveXmlButton;
    QWidget *tab_5;
    QVBoxLayout *verticalLayout_33;
    QTabWidget *tabWidget_3;
    QWidget *tab_16;
    QVBoxLayout *verticalLayout_3;
    QHBoxLayout *horizontalLayout_5;
    QGroupBox *groupBox_28;
    QGridLayout *gridLayout_29;
    QLabel *label_65;
    QSpinBox *appconfControllerIdBox;
    QGroupBox *appconfSendCanStatusBox;
    QGridLayout *gridLayout_25;
    QLabel *label_12;
    QSpinBox *appconfSendCanStatusRateBox;
    QGroupBox *groupBox_18;
    QHBoxLayout *horizontalLayout_33;
    QGridLayout *gridLayout_22;
    QRadioButton *appconfUseUartButton;
    QRadioButton *appconfUsePpmUartButton;
    QRadioButton *appconfUseCustomButton;
    QRadioButton *appconfUseNoAppButton;
    QRadioButton *appconfUseNrfButton;
    QRadioButton *appconfUseNunchukButton;
    QRadioButton *appconfUsePpmButton;
    QRadioButton *appconfUseAdcButton;
    QRadioButton *appconfUseAdcUartButton;
    QSpacerItem *horizontalSpacer_12;
    QGroupBox *groupBox_22;
    QGridLayout *gridLayout_18;
    QLabel *label_52;
    QSpinBox *appconfTimeoutBox;
    QLabel *label_53;
    QDoubleSpinBox *appconfTimeoutBrakeCurrentBox;
    QSpacerItem *verticalSpacer_3;
    QWidget *tab_17;
    QVBoxLayout *verticalLayout_35;
    QGroupBox *groupBox_19;
    QHBoxLayout *horizontalLayout_28;
    QGridLayout *gridLayout_13;
    QRadioButton *appconfPpmDutyNorevButton;
    QRadioButton *appconfPpmDutyButton;
    QRadioButton *appconfPpmDisabledButton;
    QRadioButton *appconfPpmPidNorevButton;
    QRadioButton *appconfPpmCurrentNorevBrakeButton;
    QRadioButton *appconfPpmCurrentButton;
    QRadioButton *appconfPpmCurrentNorevButton;
    QRadioButton *appconfPpmPidButton;
    QSpacerItem *horizontalSpacer_10;
    QGroupBox *groupBox_20;
    QGridLayout *gridLayout_17;
    QCheckBox *appconfPpmMedianFilterBox;
    QLabel *label_51;
    QDoubleSpinBox *appconfPpmPidMaxErpmBox;
    QLabel *label_49;
    QDoubleSpinBox *appconfPpmPulseStartBox;
    QLabel *label_50;
    QDoubleSpinBox *appconfPpmPulseWidthBox;
    QLabel *label_45;
    QDoubleSpinBox *appconfPpmHystBox;
    QCheckBox *appconfPpmSafeStartBox;
    QGroupBox *appconfPpmRpmLimBox;
    QGridLayout *gridLayout_20;
    QDoubleSpinBox *appconfPpmRpmLimStartBox;
    QLabel *label_47;
    QLabel *label_48;
    QDoubleSpinBox *appconfPpmRpmLimEndBox;
    QGroupBox *appconfPpmMultiGroup;
    QHBoxLayout *horizontalLayout_37;
    QCheckBox *appconfPpmTcBox;
    QSpacerItem *horizontalSpacer_14;
    QLabel *label_67;
    QDoubleSpinBox *appconfPpmTcErpmBox;
    QGroupBox *appconfUpdatePpmBox;
    QGridLayout *gridLayout_19;
    QProgressBar *appconfDecodedPpmBar;
    QLCDNumber *appconfPpmPulsewidthNumber;
    QLabel *label_80;
    QSpacerItem *verticalSpacer_6;
    QWidget *tab_22;
    QVBoxLayout *verticalLayout_16;
    QGroupBox *groupBox_31;
    QHBoxLayout *horizontalLayout_40;
    QGridLayout *gridLayout_30;
    QRadioButton *appconfAdcCurrentButtonButton;
    QRadioButton *appconfAdcDisabledButton;
    QRadioButton *appconfAdcCurrentNorevCenterButton;
    QRadioButton *appconfAdcCurrentNorevButtonButton;
    QRadioButton *appconfAdcCurrentButton;
    QRadioButton *appconfAdcCurrentCenterButton;
    QRadioButton *appconfAdcDutyCycleButtonButton;
    QRadioButton *appconfAdcDutyCycleCenterButton;
    QRadioButton *appconfAdcDutyCycleButton;
    QRadioButton *appconfAdcCurrentNorevAdcButton;
    QSpacerItem *horizontalSpacer_16;
    QGroupBox *groupBox_33;
    QGridLayout *gridLayout_33;
    QSpinBox *appconfAdcUpdateRateBox;
    QDoubleSpinBox *appconfAdcHystBox;
    QLabel *label_78;
    QCheckBox *appconfAdcFilterBox;
    QLabel *label_76;
    QCheckBox *appconfAdcSafeStartBox;
    QWidget *widget;
    QSpacerItem *horizontalSpacer_18;
    QDoubleSpinBox *appconfAdcVoltageStartBox;
    QLabel *label_77;
    QLabel *label_75;
    QDoubleSpinBox *appconfAdcVoltageEndBox;
    QCheckBox *appconfAdcInvertVoltageBox;
    QGroupBox *groupBox_36;
    QGridLayout *gridLayout_35;
    QCheckBox *appconfAdcInvertRevButtonBox;
    QCheckBox *appconfAdcInvertCcButtonBox;
    QSpacerItem *verticalSpacer_12;
    QTextBrowser *textBrowser_2;
    QGroupBox *appconfAdcRpmLimBox;
    QGridLayout *gridLayout_32;
    QDoubleSpinBox *appconfAdcRpmLimStartBox;
    QLabel *label_73;
    QDoubleSpinBox *appconfAdcRpmLimEndBox;
    QLabel *label_74;
    QSpacerItem *horizontalSpacer_28;
    QGroupBox *appconfAdcMultiGroup;
    QHBoxLayout *horizontalLayout_41;
    QCheckBox *appconfAdcTcBox;
    QSpacerItem *horizontalSpacer_17;
    QLabel *label_72;
    QDoubleSpinBox *appconfAdcTcErpmBox;
    QGroupBox *appconfAdcUpdateBox;
    QGridLayout *gridLayout_31;
    QProgressBar *appconfAdcDecodedBar;
    QLCDNumber *appconfAdcVoltageNumber;
    QLabel *label_79;
    QProgressBar *appconfAdcDecodedBar2;
    QLabel *lblVoltage2;
    QLCDNumber *appconfAdcVoltageNumber2;
    QSpacerItem *verticalSpacer_14;
    QWidget *tab_18;
    QVBoxLayout *verticalLayout_36;
    QGroupBox *groupBox_21;
    QGridLayout *gridLayout_16;
    QLabel *label_46;
    QSpinBox *appconfUartBaudBox;
    QSpacerItem *verticalSpacer_10;
    QWidget *tab_21;
    QVBoxLayout *verticalLayout_32;
    QGroupBox *groupBox_24;
    QHBoxLayout *horizontalLayout_31;
    QHBoxLayout *horizontalLayout_35;
    QRadioButton *appconfChukDisabledButton;
    QRadioButton *appconfChukCurrentNorevButton;
    QRadioButton *appconfChukCurrentButton;
    QSpacerItem *horizontalSpacer_11;
    QGroupBox *groupBox_25;
    QGridLayout *gridLayout_21;
    QLabel *label_54;
    QDoubleSpinBox *appconfChukHystBox;
    QLabel *label_63;
    QDoubleSpinBox *appconfChukRampTimePosBox;
    QLabel *label_56;
    QDoubleSpinBox *appconfChukRpmLimStartBox;
    QLabel *label_64;
    QDoubleSpinBox *appconfChukRampTimeNegBox;
    QLabel *label_55;
    QDoubleSpinBox *appconfChukRpmLimEndBox;
    QLabel *label_88;
    QDoubleSpinBox *appconfChukErpmPerSBox;
    QGroupBox *appconfChukMultiGroup;
    QHBoxLayout *horizontalLayout_36;
    QCheckBox *appconfChukTcBox;
    QSpacerItem *horizontalSpacer_13;
    QLabel *label_66;
    QDoubleSpinBox *appconfChukTcErpmBox;
    QGroupBox *appconfUpdateChukBox;
    QHBoxLayout *horizontalLayout_32;
    QProgressBar *appconfDecodedChukBar;
    QTextBrowser *textBrowser;
    QWidget *tab_25;
    QVBoxLayout *verticalLayout_37;
    QGroupBox *groupBox_47;
    QHBoxLayout *horizontalLayout_46;
    QRadioButton *appconfNrfSpeed250kButton;
    QRadioButton *appconfNrfSpeed1mButton;
    QRadioButton *appconfNrfSpeed2mButton;
    QSpacerItem *horizontalSpacer_33;
    QGroupBox *groupBox_48;
    QHBoxLayout *horizontalLayout_47;
    QRadioButton *appconfNrfPowerM18Button;
    QRadioButton *appconfNrfPowerM12Button;
    QRadioButton *appconfNrfPowerM6Button;
    QRadioButton *appconfNrfPower0Button;
    QSpacerItem *horizontalSpacer_31;
    QGroupBox *groupBox_50;
    QHBoxLayout *horizontalLayout_49;
    QRadioButton *appconfNrfCrc1BButton;
    QRadioButton *appconfNrfCrc2BButton;
    QSpacerItem *horizontalSpacer_32;
    QGroupBox *groupBox_49;
    QHBoxLayout *horizontalLayout_48;
    QCheckBox *appconfNrfUseAckBox;
    QLabel *label_97;
    QSpinBox *appconfNrfRetrBox;
    QLabel *label_99;
    QComboBox *appconfNrfRetrDelayBox;
    QSpacerItem *horizontalSpacer_30;
    QGroupBox *groupBox_51;
    QHBoxLayout *horizontalLayout_50;
    QSpinBox *appconfNrfChannelBox;
    QSpacerItem *horizontalSpacer_34;
    QGroupBox *groupBox_52;
    QHBoxLayout *horizontalLayout_51;
    QSpinBox *appconfNrfAddrB0Box;
    QSpinBox *appconfNrfAddrB1Box;
    QSpinBox *appconfNrfAddrB2Box;
    QSpacerItem *horizontalSpacer_35;
    QSpacerItem *verticalSpacer_18;
    QHBoxLayout *horizontalLayout_27;
    QPushButton *appconfReadButton;
    QPushButton *appconfReadDefaultButton;
    QPushButton *appconfWriteButton;
    QSpacerItem *horizontalSpacer_9;
    QWidget *tab_6;
    QVBoxLayout *verticalLayout_17;
    QTabWidget *tabWidget_5;
    QWidget *tab_19;
    QHBoxLayout *horizontalLayout_29;
    QCustomPlot *realtimePlotRest;
    QWidget *tab_20;
    QHBoxLayout *horizontalLayout_30;
    QCustomPlot *realtimePlotTemperature;
    QWidget *tab_28;
    QHBoxLayout *horizontalLayout_52;
    QCustomPlot *realtimePlotRpm;
    RtDataWidget *rtDataWidget;
    QHBoxLayout *horizontalLayout_16;
    QCheckBox *realtimeAutoScaleBox;
    QCheckBox *realtimeActivateBox;
    QSpacerItem *horizontalSpacer_7;
    QWidget *tab_2;
    QVBoxLayout *verticalLayout_10;
    QCustomPlot *voltagePlot;
    QHBoxLayout *horizontalLayout_4;
    QCheckBox *showPh1Box;
    QCheckBox *showPh2Box;
    QCheckBox *showPh3Box;
    QCheckBox *showVirtualGndBox;
    QCheckBox *showPosVoltageBox;
    QSpacerItem *horizontalSpacer_2;
    QCheckBox *truncateBox;
    QWidget *tab;
    QVBoxLayout *verticalLayout_19;
    QTabWidget *tabWidget_2;
    QWidget *tab_7;
    QVBoxLayout *verticalLayout_8;
    QCustomPlot *currentPlot;
    QHBoxLayout *horizontalLayout_14;
    QCheckBox *showCurrent1Box;
    QCheckBox *showCurrent2Box;
    QCheckBox *showCurrent3Box;
    QCheckBox *showTotalCurrentBox;
    QCheckBox *showMcTotalCurrentBox;
    QCheckBox *showPosCurrentBox;
    QSpacerItem *horizontalSpacer_3;
    QRadioButton *currentTimeButton;
    QRadioButton *currentSpectrumButton;
    QWidget *tab_8;
    QVBoxLayout *verticalLayout_12;
    QSplitter *splitter;
    QWidget *layoutWidget;
    QVBoxLayout *verticalLayout_7;
    QCustomPlot *filterResponsePlot;
    QCheckBox *filterLogScaleBox;
    QWidget *layoutWidget_12;
    QVBoxLayout *verticalLayout_9;
    QCustomPlot *filterPlot;
    QCheckBox *filterScatterBox;
    QWidget *tab_9;
    QVBoxLayout *verticalLayout_15;
    QSplitter *splitter_2;
    QWidget *layoutWidget_10;
    QVBoxLayout *verticalLayout_13;
    QCustomPlot *filterResponsePlot2;
    QCheckBox *filterLogScaleBox2;
    QWidget *layoutWidget2_2;
    QVBoxLayout *verticalLayout_14;
    QCustomPlot *filterPlot2;
    QCheckBox *filterScatterBox2;
    QHBoxLayout *horizontalLayout_3;
    QGroupBox *groupBox_4;
    QGridLayout *gridLayout_4;
    QCheckBox *currentFilterActiveBox;
    QHBoxLayout *horizontalLayout_6;
    QRadioButton *firRadioButton;
    QRadioButton *meanRadioButton;
    QCheckBox *compDelayBox;
    QGridLayout *gridLayout_3;
    QLabel *label_6;
    QDoubleSpinBox *currentFilterFreqBox;
    QLabel *label_7;
    QSpinBox *currentFilterTapBox;
    QCheckBox *hammingBox;
    QGroupBox *groupBox_7;
    QGridLayout *gridLayout_5;
    QCheckBox *currentFilterActiveBox2;
    QHBoxLayout *horizontalLayout_11;
    QRadioButton *firRadioButton2;
    QRadioButton *meanRadioButton2;
    QGridLayout *gridLayout_6;
    QLabel *label_8;
    QDoubleSpinBox *currentFilterFreqBox2;
    QLabel *label_9;
    QSpinBox *currentFilterTapBox2;
    QCheckBox *hammingBox2;
    QHBoxLayout *horizontalLayout_12;
    QLabel *label_10;
    QSpinBox *decimationSpinBox;
    QHBoxLayout *horizontalLayout_10;
    QSpacerItem *horizontalSpacer;
    QWidget *tab_15;
    QVBoxLayout *verticalLayout_21;
    QWidget *widget_2;
    QVBoxLayout *verticalLayout_4;
    QTextBrowser *terminalBrowser;
    QHBoxLayout *horizontalLayout_15;
    QLineEdit *terminalEdit;
    QPushButton *sendTerminalButton;
    QPushButton *clearTerminalButton;
    QWidget *tab_23;
    QVBoxLayout *verticalLayout_18;
    QGroupBox *groupBox_23;
    QGridLayout *gridLayout_34;
    QLabel *label_81;
    QPushButton *firmwareUploadButton;
    QLabel *firmwareUploadStatusLabel;
    QProgressBar *firmwareBar;
    QLineEdit *firmwareEdit;
    QPushButton *firmwareCancelButton;
    QPushButton *firmwareChooseButton;
    QGroupBox *groupBox_26;
    QHBoxLayout *horizontalLayout_9;
    QLabel *label_82;
    QLabel *firmwareVersionLabel;
    QSpacerItem *horizontalSpacer_19;
    QPushButton *firmwareVersionReadButton;
    QGroupBox *groupBox_32;
    QHBoxLayout *horizontalLayout_42;
    QLabel *firmwareSupportedLabel;
    QSpacerItem *verticalSpacer_15;
    QWidget *tab_3;
    QVBoxLayout *verticalLayout_5;
    QGridLayout *gridLayout_8;
    QPushButton *detectButton;
    QPushButton *stopDetectButton;
    QPushButton *detectPidPosErrorButton;
    QPushButton *detectEncoderButton;
    QPushButton *detectObserverButton;
    QPushButton *detectEncoderObserverErrorButton;
    QSpacerItem *horizontalSpacer_36;
    QPushButton *detectPidPosButton;
    QProgressBar *rotorPosBar;
    QCustomPlot *realtimePlotPosition;
    QWidget *tab_10;
    QVBoxLayout *verticalLayout_22;
    QHBoxLayout *horizontalLayout_7;
    QLabel *experimentSampleLabel;
    QSpacerItem *horizontalSpacer_4;
    QPushButton *experimentClearSamplesButton;
    QPushButton *experimentSaveSamplesButton;
    QTextBrowser *experimentBrowser;
    QGroupBox *groupBox_6;
    QVBoxLayout *verticalLayout_11;
    QHBoxLayout *horizontalLayout_13;
    QLabel *label_14;
    QLineEdit *experimentPathEdit;
    QHBoxLayout *horizontalLayout_8;
    QCheckBox *experimentAutosaveBox;
    QSpacerItem *horizontalSpacer_5;
    QLabel *label_13;
    QSpinBox *experimentAutosaveIntervalBox;
    QLabel *label_15;
    QGroupBox *groupBox_35;
    QHBoxLayout *horizontalLayout_2;
    QSlider *servoOutputSlider;
    QLCDNumber *servoOutputNumber;
    QWidget *widget2;
    QVBoxLayout *verticalLayout_26;
    QToolBox *toolBox;
    QWidget *page;
    QGridLayout *gridLayout_49;
    QComboBox *serialCombobox;
    QPushButton *refreshButton;
    QPushButton *serialConnectButton;
    QWidget *page_2;
    QGridLayout *gridLayout_50;
    QLineEdit *udpIpEdit;
    QPushButton *udpConnectButton;
    QGridLayout *gridLayout_28;
    QPushButton *disconnectButton;
    QPushButton *appconfRebootButton;
    QSpinBox *canIdBox;
    QCheckBox *canFwdBox;
    QSpacerItem *verticalSpacer;
    QTabWidget *tabWidget_6;
    QWidget *tab_26;
    QVBoxLayout *verticalLayout_2;
    QGroupBox *groupBox_2;
    QGridLayout *gridLayout_2;
    QDoubleSpinBox *dutyBox;
    QPushButton *dutyButton;
    QSpinBox *rpmBox;
    QPushButton *rpmButton;
    QDoubleSpinBox *currentBox;
    QPushButton *currentButton;
    QPushButton *currentBrakeButton;
    QPushButton *posCtrlButton;
    QDoubleSpinBox *currentBrakeBox;
    QDoubleSpinBox *posCtrlBox;
    QCheckBox *overrideKbBox;
    QDoubleSpinBox *arrowCurrentBox;
    QPushButton *offBrakeButton;
    QWidget *tab_27;
    QVBoxLayout *verticalLayout_38;
    QGroupBox *groupBox;
    QVBoxLayout *verticalLayout;
    QGridLayout *gridLayout;
    QLabel *label;
    QLabel *label_2;
    QSpinBox *sampleNumBox;
    QSpinBox *sampleFreqBox;
    QSpinBox *sampleIntBox;
    QLabel *label_5;
    QPushButton *getDataButton;
    QPushButton *getDataStartButton;
    QGroupBox *groupBox_5;
    QGridLayout *gridLayout_27;
    QCheckBox *horizontalZoomBox;
    QCheckBox *verticalZoomBox;
    QPushButton *rescaleButton;
    QPushButton *replotButton;
    QSpacerItem *verticalSpacer_19;
    QPushButton *offButton;
    QStatusBar *statusBar;

    void setupUi(QMainWindow *MainWindow)
    {
        if (MainWindow->objectName().isEmpty())
            MainWindow->setObjectName(QStringLiteral("MainWindow"));
        MainWindow->resize(1340, 795);
        QSizePolicy sizePolicy(QSizePolicy::Preferred, QSizePolicy::Preferred);
        sizePolicy.setHorizontalStretch(0);
        sizePolicy.setVerticalStretch(0);
        sizePolicy.setHeightForWidth(MainWindow->sizePolicy().hasHeightForWidth());
        MainWindow->setSizePolicy(sizePolicy);
        centralWidget = new QWidget(MainWindow);
        centralWidget->setObjectName(QStringLiteral("centralWidget"));
        horizontalLayout = new QHBoxLayout(centralWidget);
        horizontalLayout->setSpacing(6);
        horizontalLayout->setContentsMargins(11, 11, 11, 11);
        horizontalLayout->setObjectName(QStringLiteral("horizontalLayout"));
        verticalLayout_6 = new QVBoxLayout();
        verticalLayout_6->setSpacing(6);
        verticalLayout_6->setObjectName(QStringLiteral("verticalLayout_6"));
        tabWidget = new QTabWidget(centralWidget);
        tabWidget->setObjectName(QStringLiteral("tabWidget"));
        QSizePolicy sizePolicy1(QSizePolicy::Expanding, QSizePolicy::Expanding);
        sizePolicy1.setHorizontalStretch(0);
        sizePolicy1.setVerticalStretch(1);
        sizePolicy1.setHeightForWidth(tabWidget->sizePolicy().hasHeightForWidth());
        tabWidget->setSizePolicy(sizePolicy1);
        tabWidget->setTabPosition(QTabWidget::North);
        tab_11 = new QWidget();
        tab_11->setObjectName(QStringLiteral("tab_11"));
        verticalLayout_31 = new QVBoxLayout(tab_11);
        verticalLayout_31->setSpacing(6);
        verticalLayout_31->setContentsMargins(11, 11, 11, 11);
        verticalLayout_31->setObjectName(QStringLiteral("verticalLayout_31"));
        tabWidget_4 = new QTabWidget(tab_11);
        tabWidget_4->setObjectName(QStringLiteral("tabWidget_4"));
        tabWidget_4->setTabPosition(QTabWidget::West);
        tab_12 = new QWidget();
        tab_12->setObjectName(QStringLiteral("tab_12"));
        verticalLayout_24 = new QVBoxLayout(tab_12);
        verticalLayout_24->setSpacing(6);
        verticalLayout_24->setContentsMargins(11, 11, 11, 11);
        verticalLayout_24->setObjectName(QStringLiteral("verticalLayout_24"));
        groupBox_29 = new QGroupBox(tab_12);
        groupBox_29->setObjectName(QStringLiteral("groupBox_29"));
        horizontalLayout_34 = new QHBoxLayout(groupBox_29);
        horizontalLayout_34->setSpacing(6);
        horizontalLayout_34->setContentsMargins(11, 11, 11, 11);
        horizontalLayout_34->setObjectName(QStringLiteral("horizontalLayout_34"));
        mcconfTypeBldcButton = new QRadioButton(groupBox_29);
        mcconfTypeBldcButton->setObjectName(QStringLiteral("mcconfTypeBldcButton"));
        mcconfTypeBldcButton->setChecked(true);

        horizontalLayout_34->addWidget(mcconfTypeBldcButton);

        mcconfTypeDcButton = new QRadioButton(groupBox_29);
        mcconfTypeDcButton->setObjectName(QStringLiteral("mcconfTypeDcButton"));

        horizontalLayout_34->addWidget(mcconfTypeDcButton);

        mcconfTypeFocButton = new QRadioButton(groupBox_29);
        mcconfTypeFocButton->setObjectName(QStringLiteral("mcconfTypeFocButton"));

        horizontalLayout_34->addWidget(mcconfTypeFocButton);

        horizontalSpacer_15 = new QSpacerItem(40, 20, QSizePolicy::Expanding, QSizePolicy::Minimum);

        horizontalLayout_34->addItem(horizontalSpacer_15);


        verticalLayout_24->addWidget(groupBox_29);

        gridLayout_24 = new QGridLayout();
        gridLayout_24->setSpacing(6);
        gridLayout_24->setObjectName(QStringLiteral("gridLayout_24"));
        groupBox_8 = new QGroupBox(tab_12);
        groupBox_8->setObjectName(QStringLiteral("groupBox_8"));
        QSizePolicy sizePolicy2(QSizePolicy::Preferred, QSizePolicy::MinimumExpanding);
        sizePolicy2.setHorizontalStretch(0);
        sizePolicy2.setVerticalStretch(0);
        sizePolicy2.setHeightForWidth(groupBox_8->sizePolicy().hasHeightForWidth());
        groupBox_8->setSizePolicy(sizePolicy2);
        horizontalLayout_18 = new QHBoxLayout(groupBox_8);
        horizontalLayout_18->setSpacing(6);
        horizontalLayout_18->setContentsMargins(11, 11, 11, 11);
        horizontalLayout_18->setObjectName(QStringLiteral("horizontalLayout_18"));
        gridLayout_9 = new QGridLayout();
        gridLayout_9->setSpacing(6);
        gridLayout_9->setObjectName(QStringLiteral("gridLayout_9"));
        label_19 = new QLabel(groupBox_8);
        label_19->setObjectName(QStringLiteral("label_19"));

        gridLayout_9->addWidget(label_19, 3, 0, 1, 1);

        label_20 = new QLabel(groupBox_8);
        label_20->setObjectName(QStringLiteral("label_20"));

        gridLayout_9->addWidget(label_20, 4, 0, 1, 1);

        mcconfLimCurrentInMinBox = new QDoubleSpinBox(groupBox_8);
        mcconfLimCurrentInMinBox->setObjectName(QStringLiteral("mcconfLimCurrentInMinBox"));
        mcconfLimCurrentInMinBox->setMinimum(-200);
        mcconfLimCurrentInMinBox->setMaximum(0);

        gridLayout_9->addWidget(mcconfLimCurrentInMinBox, 3, 1, 1, 1);

        label_18 = new QLabel(groupBox_8);
        label_18->setObjectName(QStringLiteral("label_18"));

        gridLayout_9->addWidget(label_18, 2, 0, 1, 1);

        label_17 = new QLabel(groupBox_8);
        label_17->setObjectName(QStringLiteral("label_17"));

        gridLayout_9->addWidget(label_17, 1, 0, 1, 1);

        mcconfLimCurrentAbsMaxBox = new QDoubleSpinBox(groupBox_8);
        mcconfLimCurrentAbsMaxBox->setObjectName(QStringLiteral("mcconfLimCurrentAbsMaxBox"));
        mcconfLimCurrentAbsMaxBox->setMaximum(240);

        gridLayout_9->addWidget(mcconfLimCurrentAbsMaxBox, 4, 1, 1, 1);

        mcconfLimCurrentMinBox = new QDoubleSpinBox(groupBox_8);
        mcconfLimCurrentMinBox->setObjectName(QStringLiteral("mcconfLimCurrentMinBox"));
        mcconfLimCurrentMinBox->setMinimum(-200);
        mcconfLimCurrentMinBox->setMaximum(0);

        gridLayout_9->addWidget(mcconfLimCurrentMinBox, 1, 1, 1, 1);

        mcconfLimCurrentInMaxBox = new QDoubleSpinBox(groupBox_8);
        mcconfLimCurrentInMaxBox->setObjectName(QStringLiteral("mcconfLimCurrentInMaxBox"));
        mcconfLimCurrentInMaxBox->setMaximum(200);

        gridLayout_9->addWidget(mcconfLimCurrentInMaxBox, 2, 1, 1, 1);

        label_16 = new QLabel(groupBox_8);
        label_16->setObjectName(QStringLiteral("label_16"));

        gridLayout_9->addWidget(label_16, 0, 0, 1, 1);

        mcconfLimCurrentMaxBox = new QDoubleSpinBox(groupBox_8);
        mcconfLimCurrentMaxBox->setObjectName(QStringLiteral("mcconfLimCurrentMaxBox"));
        mcconfLimCurrentMaxBox->setMaximum(200);

        gridLayout_9->addWidget(mcconfLimCurrentMaxBox, 0, 1, 1, 1);

        mcconfLimCurrentSlowAbsMaxBox = new QCheckBox(groupBox_8);
        mcconfLimCurrentSlowAbsMaxBox->setObjectName(QStringLiteral("mcconfLimCurrentSlowAbsMaxBox"));

        gridLayout_9->addWidget(mcconfLimCurrentSlowAbsMaxBox, 5, 0, 1, 1);


        horizontalLayout_18->addLayout(gridLayout_9);


        gridLayout_24->addWidget(groupBox_8, 0, 0, 1, 1);

        groupBox_9 = new QGroupBox(tab_12);
        groupBox_9->setObjectName(QStringLiteral("groupBox_9"));
        sizePolicy2.setHeightForWidth(groupBox_9->sizePolicy().hasHeightForWidth());
        groupBox_9->setSizePolicy(sizePolicy2);
        horizontalLayout_19 = new QHBoxLayout(groupBox_9);
        horizontalLayout_19->setSpacing(6);
        horizontalLayout_19->setContentsMargins(11, 11, 11, 11);
        horizontalLayout_19->setObjectName(QStringLiteral("horizontalLayout_19"));
        gridLayout_10 = new QGridLayout();
        gridLayout_10->setSpacing(6);
        gridLayout_10->setObjectName(QStringLiteral("gridLayout_10"));
        label_21 = new QLabel(groupBox_9);
        label_21->setObjectName(QStringLiteral("label_21"));

        gridLayout_10->addWidget(label_21, 1, 0, 1, 1);

        mcconfLimMaxErpmBox = new QDoubleSpinBox(groupBox_9);
        mcconfLimMaxErpmBox->setObjectName(QStringLiteral("mcconfLimMaxErpmBox"));
        mcconfLimMaxErpmBox->setMaximum(200000);
        mcconfLimMaxErpmBox->setSingleStep(100);

        gridLayout_10->addWidget(mcconfLimMaxErpmBox, 2, 1, 1, 1);

        mcconfLimMaxErpmFbrakeBox = new QDoubleSpinBox(groupBox_9);
        mcconfLimMaxErpmFbrakeBox->setObjectName(QStringLiteral("mcconfLimMaxErpmFbrakeBox"));
        mcconfLimMaxErpmFbrakeBox->setMaximum(100000);
        mcconfLimMaxErpmFbrakeBox->setSingleStep(100);

        gridLayout_10->addWidget(mcconfLimMaxErpmFbrakeBox, 3, 1, 1, 1);

        mcconfLimMinErpmBox = new QDoubleSpinBox(groupBox_9);
        mcconfLimMinErpmBox->setObjectName(QStringLiteral("mcconfLimMinErpmBox"));
        mcconfLimMinErpmBox->setMinimum(-200000);
        mcconfLimMinErpmBox->setMaximum(0);
        mcconfLimMinErpmBox->setSingleStep(100);

        gridLayout_10->addWidget(mcconfLimMinErpmBox, 1, 1, 1, 1);

        label_22 = new QLabel(groupBox_9);
        label_22->setObjectName(QStringLiteral("label_22"));

        gridLayout_10->addWidget(label_22, 2, 0, 1, 1);

        label_23 = new QLabel(groupBox_9);
        label_23->setObjectName(QStringLiteral("label_23"));

        gridLayout_10->addWidget(label_23, 3, 0, 1, 1);

        mcconfLimErpmLimitNegTorqueBox = new QCheckBox(groupBox_9);
        mcconfLimErpmLimitNegTorqueBox->setObjectName(QStringLiteral("mcconfLimErpmLimitNegTorqueBox"));

        gridLayout_10->addWidget(mcconfLimErpmLimitNegTorqueBox, 0, 0, 1, 1);

        verticalSpacer_11 = new QSpacerItem(20, 40, QSizePolicy::Minimum, QSizePolicy::Expanding);

        gridLayout_10->addItem(verticalSpacer_11, 5, 0, 1, 1);

        label_62 = new QLabel(groupBox_9);
        label_62->setObjectName(QStringLiteral("label_62"));

        gridLayout_10->addWidget(label_62, 4, 0, 1, 1);

        mcconfLimMaxErpmFbrakeCcBox = new QDoubleSpinBox(groupBox_9);
        mcconfLimMaxErpmFbrakeCcBox->setObjectName(QStringLiteral("mcconfLimMaxErpmFbrakeCcBox"));
        mcconfLimMaxErpmFbrakeCcBox->setMaximum(100000);
        mcconfLimMaxErpmFbrakeCcBox->setSingleStep(100);

        gridLayout_10->addWidget(mcconfLimMaxErpmFbrakeCcBox, 4, 1, 1, 1);


        horizontalLayout_19->addLayout(gridLayout_10);


        gridLayout_24->addWidget(groupBox_9, 0, 1, 1, 1);

        groupBox_27 = new QGroupBox(tab_12);
        groupBox_27->setObjectName(QStringLiteral("groupBox_27"));
        gridLayout_23 = new QGridLayout(groupBox_27);
        gridLayout_23->setSpacing(6);
        gridLayout_23->setContentsMargins(11, 11, 11, 11);
        gridLayout_23->setObjectName(QStringLiteral("gridLayout_23"));
        label_57 = new QLabel(groupBox_27);
        label_57->setObjectName(QStringLiteral("label_57"));

        gridLayout_23->addWidget(label_57, 0, 0, 1, 1);

        mcconfLimTempFetStartBox = new QDoubleSpinBox(groupBox_27);
        mcconfLimTempFetStartBox->setObjectName(QStringLiteral("mcconfLimTempFetStartBox"));
        mcconfLimTempFetStartBox->setMinimum(-100);
        mcconfLimTempFetStartBox->setMaximum(300);
        mcconfLimTempFetStartBox->setSingleStep(5);

        gridLayout_23->addWidget(mcconfLimTempFetStartBox, 0, 1, 1, 1);

        label_58 = new QLabel(groupBox_27);
        label_58->setObjectName(QStringLiteral("label_58"));

        gridLayout_23->addWidget(label_58, 1, 0, 1, 1);

        mcconfLimTempFetEndBox = new QDoubleSpinBox(groupBox_27);
        mcconfLimTempFetEndBox->setObjectName(QStringLiteral("mcconfLimTempFetEndBox"));
        mcconfLimTempFetEndBox->setMinimum(-100);
        mcconfLimTempFetEndBox->setMaximum(300);
        mcconfLimTempFetEndBox->setSingleStep(5);

        gridLayout_23->addWidget(mcconfLimTempFetEndBox, 1, 1, 1, 1);

        label_59 = new QLabel(groupBox_27);
        label_59->setObjectName(QStringLiteral("label_59"));

        gridLayout_23->addWidget(label_59, 2, 0, 1, 1);

        mcconfLimTempMotorStartBox = new QDoubleSpinBox(groupBox_27);
        mcconfLimTempMotorStartBox->setObjectName(QStringLiteral("mcconfLimTempMotorStartBox"));
        mcconfLimTempMotorStartBox->setMinimum(-100);
        mcconfLimTempMotorStartBox->setMaximum(300);
        mcconfLimTempMotorStartBox->setSingleStep(5);

        gridLayout_23->addWidget(mcconfLimTempMotorStartBox, 2, 1, 1, 1);

        label_60 = new QLabel(groupBox_27);
        label_60->setObjectName(QStringLiteral("label_60"));

        gridLayout_23->addWidget(label_60, 3, 0, 1, 1);

        mcconfLimTempMotorEndBox = new QDoubleSpinBox(groupBox_27);
        mcconfLimTempMotorEndBox->setObjectName(QStringLiteral("mcconfLimTempMotorEndBox"));
        mcconfLimTempMotorEndBox->setMinimum(-100);
        mcconfLimTempMotorEndBox->setMaximum(300);
        mcconfLimTempMotorEndBox->setSingleStep(5);

        gridLayout_23->addWidget(mcconfLimTempMotorEndBox, 3, 1, 1, 1);


        gridLayout_24->addWidget(groupBox_27, 1, 0, 1, 1);

        groupBox_10 = new QGroupBox(tab_12);
        groupBox_10->setObjectName(QStringLiteral("groupBox_10"));
        horizontalLayout_20 = new QHBoxLayout(groupBox_10);
        horizontalLayout_20->setSpacing(6);
        horizontalLayout_20->setContentsMargins(11, 11, 11, 11);
        horizontalLayout_20->setObjectName(QStringLiteral("horizontalLayout_20"));
        gridLayout_11 = new QGridLayout();
        gridLayout_11->setSpacing(6);
        gridLayout_11->setObjectName(QStringLiteral("gridLayout_11"));
        label_86 = new QLabel(groupBox_10);
        label_86->setObjectName(QStringLiteral("label_86"));

        gridLayout_11->addWidget(label_86, 2, 0, 1, 1);

        label_25 = new QLabel(groupBox_10);
        label_25->setObjectName(QStringLiteral("label_25"));

        gridLayout_11->addWidget(label_25, 1, 0, 1, 1);

        label_24 = new QLabel(groupBox_10);
        label_24->setObjectName(QStringLiteral("label_24"));

        gridLayout_11->addWidget(label_24, 0, 0, 1, 1);

        mcconfLimMinVinBox = new QDoubleSpinBox(groupBox_10);
        mcconfLimMinVinBox->setObjectName(QStringLiteral("mcconfLimMinVinBox"));
        mcconfLimMinVinBox->setMinimum(6);
        mcconfLimMinVinBox->setMaximum(60);

        gridLayout_11->addWidget(mcconfLimMinVinBox, 0, 1, 1, 1);

        mcconfLimMaxVinBox = new QDoubleSpinBox(groupBox_10);
        mcconfLimMaxVinBox->setObjectName(QStringLiteral("mcconfLimMaxVinBox"));
        mcconfLimMaxVinBox->setMinimum(6);
        mcconfLimMaxVinBox->setMaximum(60);

        gridLayout_11->addWidget(mcconfLimMaxVinBox, 1, 1, 1, 1);

        label_87 = new QLabel(groupBox_10);
        label_87->setObjectName(QStringLiteral("label_87"));

        gridLayout_11->addWidget(label_87, 3, 0, 1, 1);

        mcconfLimBatteryCutStartBox = new QDoubleSpinBox(groupBox_10);
        mcconfLimBatteryCutStartBox->setObjectName(QStringLiteral("mcconfLimBatteryCutStartBox"));

        gridLayout_11->addWidget(mcconfLimBatteryCutStartBox, 2, 1, 1, 1);

        mcconfLimBatteryCutEndBox = new QDoubleSpinBox(groupBox_10);
        mcconfLimBatteryCutEndBox->setObjectName(QStringLiteral("mcconfLimBatteryCutEndBox"));

        gridLayout_11->addWidget(mcconfLimBatteryCutEndBox, 3, 1, 1, 1);


        horizontalLayout_20->addLayout(gridLayout_11);


        gridLayout_24->addWidget(groupBox_10, 1, 1, 1, 1);


        verticalLayout_24->addLayout(gridLayout_24);

        groupBox_38 = new QGroupBox(tab_12);
        groupBox_38->setObjectName(QStringLiteral("groupBox_38"));
        gridLayout_36 = new QGridLayout(groupBox_38);
        gridLayout_36->setSpacing(6);
        gridLayout_36->setContentsMargins(11, 11, 11, 11);
        gridLayout_36->setObjectName(QStringLiteral("gridLayout_36"));
        label_83 = new QLabel(groupBox_38);
        label_83->setObjectName(QStringLiteral("label_83"));

        gridLayout_36->addWidget(label_83, 0, 0, 2, 2);

        label_84 = new QLabel(groupBox_38);
        label_84->setObjectName(QStringLiteral("label_84"));

        gridLayout_36->addWidget(label_84, 0, 2, 2, 1);

        mcconfLimMaxDutyBox = new QDoubleSpinBox(groupBox_38);
        mcconfLimMaxDutyBox->setObjectName(QStringLiteral("mcconfLimMaxDutyBox"));
        mcconfLimMaxDutyBox->setDecimals(3);
        mcconfLimMaxDutyBox->setMinimum(0.01);
        mcconfLimMaxDutyBox->setMaximum(0.95);
        mcconfLimMaxDutyBox->setSingleStep(0.01);
        mcconfLimMaxDutyBox->setValue(0.95);

        gridLayout_36->addWidget(mcconfLimMaxDutyBox, 0, 3, 2, 1);

        mcconfLimMinDutyBox = new QDoubleSpinBox(groupBox_38);
        mcconfLimMinDutyBox->setObjectName(QStringLiteral("mcconfLimMinDutyBox"));
        mcconfLimMinDutyBox->setDecimals(3);
        mcconfLimMinDutyBox->setMinimum(0.005);
        mcconfLimMinDutyBox->setMaximum(0.5);
        mcconfLimMinDutyBox->setSingleStep(0.005);

        gridLayout_36->addWidget(mcconfLimMinDutyBox, 1, 1, 1, 1);


        verticalLayout_24->addWidget(groupBox_38);

        verticalSpacer_4 = new QSpacerItem(17, 172, QSizePolicy::Minimum, QSizePolicy::Expanding);

        verticalLayout_24->addItem(verticalSpacer_4);

        tabWidget_4->addTab(tab_12, QString());
        tab_13 = new QWidget();
        tab_13->setObjectName(QStringLiteral("tab_13"));
        verticalLayout_23 = new QVBoxLayout(tab_13);
        verticalLayout_23->setSpacing(6);
        verticalLayout_23->setContentsMargins(11, 11, 11, 11);
        verticalLayout_23->setObjectName(QStringLiteral("verticalLayout_23"));
        groupBox_34 = new QGroupBox(tab_13);
        groupBox_34->setObjectName(QStringLiteral("groupBox_34"));
        horizontalLayout_43 = new QHBoxLayout(groupBox_34);
        horizontalLayout_43->setSpacing(6);
        horizontalLayout_43->setContentsMargins(11, 11, 11, 11);
        horizontalLayout_43->setObjectName(QStringLiteral("horizontalLayout_43"));
        mcconfSensorModeSensorlessButton = new QRadioButton(groupBox_34);
        mcconfSensorModeSensorlessButton->setObjectName(QStringLiteral("mcconfSensorModeSensorlessButton"));
        mcconfSensorModeSensorlessButton->setChecked(true);

        horizontalLayout_43->addWidget(mcconfSensorModeSensorlessButton);

        mcconfSensorModeSensoredButton = new QRadioButton(groupBox_34);
        mcconfSensorModeSensoredButton->setObjectName(QStringLiteral("mcconfSensorModeSensoredButton"));

        horizontalLayout_43->addWidget(mcconfSensorModeSensoredButton);

        mcconfSensorModeHybridButton = new QRadioButton(groupBox_34);
        mcconfSensorModeHybridButton->setObjectName(QStringLiteral("mcconfSensorModeHybridButton"));

        horizontalLayout_43->addWidget(mcconfSensorModeHybridButton);

        horizontalSpacer_20 = new QSpacerItem(40, 20, QSizePolicy::Expanding, QSizePolicy::Minimum);

        horizontalLayout_43->addItem(horizontalSpacer_20);


        verticalLayout_23->addWidget(groupBox_34);

        horizontalLayout_21 = new QHBoxLayout();
        horizontalLayout_21->setSpacing(6);
        horizontalLayout_21->setObjectName(QStringLiteral("horizontalLayout_21"));
        mcconfSlBox = new QGroupBox(tab_13);
        mcconfSlBox->setObjectName(QStringLiteral("mcconfSlBox"));
        QSizePolicy sizePolicy3(QSizePolicy::Preferred, QSizePolicy::Fixed);
        sizePolicy3.setHorizontalStretch(0);
        sizePolicy3.setVerticalStretch(0);
        sizePolicy3.setHeightForWidth(mcconfSlBox->sizePolicy().hasHeightForWidth());
        mcconfSlBox->setSizePolicy(sizePolicy3);
        mcconfSlBox->setCheckable(false);
        mcconfSlBox->setChecked(false);
        gridLayout_12 = new QGridLayout(mcconfSlBox);
        gridLayout_12->setSpacing(6);
        gridLayout_12->setContentsMargins(11, 11, 11, 11);
        gridLayout_12->setObjectName(QStringLiteral("gridLayout_12"));
        label_26 = new QLabel(mcconfSlBox);
        label_26->setObjectName(QStringLiteral("label_26"));

        gridLayout_12->addWidget(label_26, 0, 0, 1, 1);

        mcconfSlMinErpmBox = new QDoubleSpinBox(mcconfSlBox);
        mcconfSlMinErpmBox->setObjectName(QStringLiteral("mcconfSlMinErpmBox"));
        mcconfSlMinErpmBox->setMaximum(100000);
        mcconfSlMinErpmBox->setSingleStep(10);

        gridLayout_12->addWidget(mcconfSlMinErpmBox, 0, 1, 1, 1);

        label_30 = new QLabel(mcconfSlBox);
        label_30->setObjectName(QStringLiteral("label_30"));

        gridLayout_12->addWidget(label_30, 1, 0, 1, 1);

        mcconfSlBrErpmBox = new QDoubleSpinBox(mcconfSlBox);
        mcconfSlBrErpmBox->setObjectName(QStringLiteral("mcconfSlBrErpmBox"));
        mcconfSlBrErpmBox->setMaximum(200000);
        mcconfSlBrErpmBox->setSingleStep(100);

        gridLayout_12->addWidget(mcconfSlBrErpmBox, 1, 1, 1, 1);

        label_29 = new QLabel(mcconfSlBox);
        label_29->setObjectName(QStringLiteral("label_29"));

        gridLayout_12->addWidget(label_29, 2, 0, 1, 1);

        mcconfSlIntLimScaleBrBox = new QDoubleSpinBox(mcconfSlBox);
        mcconfSlIntLimScaleBrBox->setObjectName(QStringLiteral("mcconfSlIntLimScaleBrBox"));
        mcconfSlIntLimScaleBrBox->setMaximum(1);
        mcconfSlIntLimScaleBrBox->setSingleStep(0.1);

        gridLayout_12->addWidget(mcconfSlIntLimScaleBrBox, 2, 1, 1, 1);

        label_61 = new QLabel(mcconfSlBox);
        label_61->setObjectName(QStringLiteral("label_61"));

        gridLayout_12->addWidget(label_61, 3, 0, 1, 1);

        mcconfSlMaxFbCurrBox = new QDoubleSpinBox(mcconfSlBox);
        mcconfSlMaxFbCurrBox->setObjectName(QStringLiteral("mcconfSlMaxFbCurrBox"));
        mcconfSlMaxFbCurrBox->setMaximum(300);

        gridLayout_12->addWidget(mcconfSlMaxFbCurrBox, 3, 1, 1, 1);


        horizontalLayout_21->addWidget(mcconfSlBox);

        groupBox_16 = new QGroupBox(tab_13);
        groupBox_16->setObjectName(QStringLiteral("groupBox_16"));
        gridLayout_46 = new QGridLayout(groupBox_16);
        gridLayout_46->setSpacing(6);
        gridLayout_46->setContentsMargins(11, 11, 11, 11);
        gridLayout_46->setObjectName(QStringLiteral("gridLayout_46"));
        label_100 = new QLabel(groupBox_16);
        label_100->setObjectName(QStringLiteral("label_100"));

        gridLayout_46->addWidget(label_100, 0, 0, 1, 1);

        mcconfCommIntButton = new QRadioButton(groupBox_16);
        mcconfCommIntButton->setObjectName(QStringLiteral("mcconfCommIntButton"));
        mcconfCommIntButton->setChecked(true);

        gridLayout_46->addWidget(mcconfCommIntButton, 0, 1, 1, 1);

        mcconfCommDelayButton = new QRadioButton(groupBox_16);
        mcconfCommDelayButton->setObjectName(QStringLiteral("mcconfCommDelayButton"));

        gridLayout_46->addWidget(mcconfCommDelayButton, 0, 2, 1, 1);

        label_28 = new QLabel(groupBox_16);
        label_28->setObjectName(QStringLiteral("label_28"));

        gridLayout_46->addWidget(label_28, 1, 0, 1, 1);

        mcconfSlIntLimBox = new QDoubleSpinBox(groupBox_16);
        mcconfSlIntLimBox->setObjectName(QStringLiteral("mcconfSlIntLimBox"));
        mcconfSlIntLimBox->setMaximum(2000);
        mcconfSlIntLimBox->setSingleStep(1);

        gridLayout_46->addWidget(mcconfSlIntLimBox, 1, 1, 1, 2);

        label_27 = new QLabel(groupBox_16);
        label_27->setObjectName(QStringLiteral("label_27"));

        gridLayout_46->addWidget(label_27, 2, 0, 1, 1);

        mcconfSlMinErpmIlBox = new QDoubleSpinBox(groupBox_16);
        mcconfSlMinErpmIlBox->setObjectName(QStringLiteral("mcconfSlMinErpmIlBox"));
        mcconfSlMinErpmIlBox->setMaximum(10000);
        mcconfSlMinErpmIlBox->setSingleStep(10);

        gridLayout_46->addWidget(mcconfSlMinErpmIlBox, 2, 1, 1, 2);

        label_41 = new QLabel(groupBox_16);
        label_41->setObjectName(QStringLiteral("label_41"));

        gridLayout_46->addWidget(label_41, 3, 0, 1, 1);

        mcconfSlBemfKBox = new QDoubleSpinBox(groupBox_16);
        mcconfSlBemfKBox->setObjectName(QStringLiteral("mcconfSlBemfKBox"));
        mcconfSlBemfKBox->setMaximum(5000);
        mcconfSlBemfKBox->setSingleStep(10);

        gridLayout_46->addWidget(mcconfSlBemfKBox, 3, 1, 1, 2);


        horizontalLayout_21->addWidget(groupBox_16);


        verticalLayout_23->addLayout(horizontalLayout_21);

        groupBox_12 = new QGroupBox(tab_13);
        groupBox_12->setObjectName(QStringLiteral("groupBox_12"));
        verticalLayout_20 = new QVBoxLayout(groupBox_12);
        verticalLayout_20->setSpacing(6);
        verticalLayout_20->setContentsMargins(11, 11, 11, 11);
        verticalLayout_20->setObjectName(QStringLiteral("verticalLayout_20"));
        horizontalLayout_22 = new QHBoxLayout();
        horizontalLayout_22->setSpacing(6);
        horizontalLayout_22->setObjectName(QStringLiteral("horizontalLayout_22"));
        label_31 = new QLabel(groupBox_12);
        label_31->setObjectName(QStringLiteral("label_31"));

        horizontalLayout_22->addWidget(label_31);

        mcconfHallTab0Box = new QSpinBox(groupBox_12);
        mcconfHallTab0Box->setObjectName(QStringLiteral("mcconfHallTab0Box"));
        mcconfHallTab0Box->setMinimum(-1);
        mcconfHallTab0Box->setMaximum(6);

        horizontalLayout_22->addWidget(mcconfHallTab0Box);

        mcconfHallTab1Box = new QSpinBox(groupBox_12);
        mcconfHallTab1Box->setObjectName(QStringLiteral("mcconfHallTab1Box"));
        mcconfHallTab1Box->setMinimum(-1);
        mcconfHallTab1Box->setMaximum(6);

        horizontalLayout_22->addWidget(mcconfHallTab1Box);

        mcconfHallTab2Box = new QSpinBox(groupBox_12);
        mcconfHallTab2Box->setObjectName(QStringLiteral("mcconfHallTab2Box"));
        mcconfHallTab2Box->setMinimum(-1);
        mcconfHallTab2Box->setMaximum(6);

        horizontalLayout_22->addWidget(mcconfHallTab2Box);

        mcconfHallTab3Box = new QSpinBox(groupBox_12);
        mcconfHallTab3Box->setObjectName(QStringLiteral("mcconfHallTab3Box"));
        mcconfHallTab3Box->setMinimum(-1);
        mcconfHallTab3Box->setMaximum(6);

        horizontalLayout_22->addWidget(mcconfHallTab3Box);

        mcconfHallTab4Box = new QSpinBox(groupBox_12);
        mcconfHallTab4Box->setObjectName(QStringLiteral("mcconfHallTab4Box"));
        mcconfHallTab4Box->setMinimum(-1);
        mcconfHallTab4Box->setMaximum(6);

        horizontalLayout_22->addWidget(mcconfHallTab4Box);

        mcconfHallTab5Box = new QSpinBox(groupBox_12);
        mcconfHallTab5Box->setObjectName(QStringLiteral("mcconfHallTab5Box"));
        mcconfHallTab5Box->setMinimum(-1);
        mcconfHallTab5Box->setMaximum(6);

        horizontalLayout_22->addWidget(mcconfHallTab5Box);

        mcconfHallTab6Box = new QSpinBox(groupBox_12);
        mcconfHallTab6Box->setObjectName(QStringLiteral("mcconfHallTab6Box"));
        mcconfHallTab6Box->setMinimum(-1);
        mcconfHallTab6Box->setMaximum(6);

        horizontalLayout_22->addWidget(mcconfHallTab6Box);

        mcconfHallTab7Box = new QSpinBox(groupBox_12);
        mcconfHallTab7Box->setObjectName(QStringLiteral("mcconfHallTab7Box"));
        mcconfHallTab7Box->setMinimum(-1);
        mcconfHallTab7Box->setMaximum(6);

        horizontalLayout_22->addWidget(mcconfHallTab7Box);

        label_32 = new QLabel(groupBox_12);
        label_32->setObjectName(QStringLiteral("label_32"));

        horizontalLayout_22->addWidget(label_32);

        mcconfHallSlErpmBox = new QDoubleSpinBox(groupBox_12);
        mcconfHallSlErpmBox->setObjectName(QStringLiteral("mcconfHallSlErpmBox"));
        mcconfHallSlErpmBox->setMaximum(200000);
        mcconfHallSlErpmBox->setSingleStep(10);
        mcconfHallSlErpmBox->setValue(0);

        horizontalLayout_22->addWidget(mcconfHallSlErpmBox);

        horizontalSpacer_8 = new QSpacerItem(40, 20, QSizePolicy::Expanding, QSizePolicy::Minimum);

        horizontalLayout_22->addItem(horizontalSpacer_8);


        verticalLayout_20->addLayout(horizontalLayout_22);


        verticalLayout_23->addWidget(groupBox_12);

        verticalSpacer_7 = new QSpacerItem(20, 209, QSizePolicy::Minimum, QSizePolicy::Expanding);

        verticalLayout_23->addItem(verticalSpacer_7);

        groupBox_11 = new QGroupBox(tab_13);
        groupBox_11->setObjectName(QStringLiteral("groupBox_11"));
        sizePolicy.setHeightForWidth(groupBox_11->sizePolicy().hasHeightForWidth());
        groupBox_11->setSizePolicy(sizePolicy);
        horizontalLayout_24 = new QHBoxLayout(groupBox_11);
        horizontalLayout_24->setSpacing(6);
        horizontalLayout_24->setContentsMargins(11, 11, 11, 11);
        horizontalLayout_24->setObjectName(QStringLiteral("horizontalLayout_24"));
        gridLayout_47 = new QGridLayout();
        gridLayout_47->setSpacing(6);
        gridLayout_47->setObjectName(QStringLiteral("gridLayout_47"));
        mcconfDetectMotorParamButton = new QPushButton(groupBox_11);
        mcconfDetectMotorParamButton->setObjectName(QStringLiteral("mcconfDetectMotorParamButton"));

        gridLayout_47->addWidget(mcconfDetectMotorParamButton, 0, 0, 1, 1);

        verticalSpacer_5 = new QSpacerItem(20, 13, QSizePolicy::Minimum, QSizePolicy::Preferred);

        gridLayout_47->addItem(verticalSpacer_5, 1, 0, 1, 1);

        mcconfDetectApplyButton = new QPushButton(groupBox_11);
        mcconfDetectApplyButton->setObjectName(QStringLiteral("mcconfDetectApplyButton"));

        gridLayout_47->addWidget(mcconfDetectApplyButton, 2, 0, 1, 1);


        horizontalLayout_24->addLayout(gridLayout_47);

        gridLayout_7 = new QGridLayout();
        gridLayout_7->setSpacing(6);
        gridLayout_7->setObjectName(QStringLiteral("gridLayout_7"));
        mcconfDetectCurrentBox = new QDoubleSpinBox(groupBox_11);
        mcconfDetectCurrentBox->setObjectName(QStringLiteral("mcconfDetectCurrentBox"));
        mcconfDetectCurrentBox->setValue(6);

        gridLayout_7->addWidget(mcconfDetectCurrentBox, 0, 1, 1, 1);

        label_44 = new QLabel(groupBox_11);
        label_44->setObjectName(QStringLiteral("label_44"));

        gridLayout_7->addWidget(label_44, 1, 0, 1, 1);

        mcconfDetectErpmBox = new QDoubleSpinBox(groupBox_11);
        mcconfDetectErpmBox->setObjectName(QStringLiteral("mcconfDetectErpmBox"));
        mcconfDetectErpmBox->setDecimals(1);
        mcconfDetectErpmBox->setMinimum(10);
        mcconfDetectErpmBox->setMaximum(10000);
        mcconfDetectErpmBox->setSingleStep(10);
        mcconfDetectErpmBox->setValue(600);

        gridLayout_7->addWidget(mcconfDetectErpmBox, 1, 1, 1, 1);

        label_42 = new QLabel(groupBox_11);
        label_42->setObjectName(QStringLiteral("label_42"));

        gridLayout_7->addWidget(label_42, 2, 0, 1, 1);

        mcconfDetectLowDutyBox = new QDoubleSpinBox(groupBox_11);
        mcconfDetectLowDutyBox->setObjectName(QStringLiteral("mcconfDetectLowDutyBox"));
        mcconfDetectLowDutyBox->setMaximum(0.4);
        mcconfDetectLowDutyBox->setSingleStep(0.01);
        mcconfDetectLowDutyBox->setValue(0.05);

        gridLayout_7->addWidget(mcconfDetectLowDutyBox, 2, 1, 1, 1);

        label_43 = new QLabel(groupBox_11);
        label_43->setObjectName(QStringLiteral("label_43"));

        gridLayout_7->addWidget(label_43, 0, 0, 1, 1);


        horizontalLayout_24->addLayout(gridLayout_7);

        mcconfDetectResultBrowser = new QTextBrowser(groupBox_11);
        mcconfDetectResultBrowser->setObjectName(QStringLiteral("mcconfDetectResultBrowser"));
        QSizePolicy sizePolicy4(QSizePolicy::Expanding, QSizePolicy::Ignored);
        sizePolicy4.setHorizontalStretch(0);
        sizePolicy4.setVerticalStretch(0);
        sizePolicy4.setHeightForWidth(mcconfDetectResultBrowser->sizePolicy().hasHeightForWidth());
        mcconfDetectResultBrowser->setSizePolicy(sizePolicy4);

        horizontalLayout_24->addWidget(mcconfDetectResultBrowser);


        verticalLayout_23->addWidget(groupBox_11);

        tabWidget_4->addTab(tab_13, QString());
        tab_24 = new QWidget();
        tab_24->setObjectName(QStringLiteral("tab_24"));
        verticalLayout_29 = new QVBoxLayout(tab_24);
        verticalLayout_29->setSpacing(6);
        verticalLayout_29->setContentsMargins(11, 11, 11, 11);
        verticalLayout_29->setObjectName(QStringLiteral("verticalLayout_29"));
        gridLayout_42 = new QGridLayout();
        gridLayout_42->setSpacing(6);
        gridLayout_42->setObjectName(QStringLiteral("gridLayout_42"));
        groupBox_39 = new QGroupBox(tab_24);
        groupBox_39->setObjectName(QStringLiteral("groupBox_39"));
        gridLayout_39 = new QGridLayout(groupBox_39);
        gridLayout_39->setSpacing(6);
        gridLayout_39->setContentsMargins(11, 11, 11, 11);
        gridLayout_39->setObjectName(QStringLiteral("gridLayout_39"));
        mcconfFocEncoderRatioBox = new QDoubleSpinBox(groupBox_39);
        mcconfFocEncoderRatioBox->setObjectName(QStringLiteral("mcconfFocEncoderRatioBox"));
        mcconfFocEncoderRatioBox->setMaximum(500);

        gridLayout_39->addWidget(mcconfFocEncoderRatioBox, 4, 3, 1, 1);

        label_89 = new QLabel(groupBox_39);
        label_89->setObjectName(QStringLiteral("label_89"));

        gridLayout_39->addWidget(label_89, 2, 0, 1, 1);

        mcconfFocCurrKpBox = new QDoubleSpinBox(groupBox_39);
        mcconfFocCurrKpBox->setObjectName(QStringLiteral("mcconfFocCurrKpBox"));
        mcconfFocCurrKpBox->setDecimals(4);
        mcconfFocCurrKpBox->setMaximum(1000);
        mcconfFocCurrKpBox->setSingleStep(0.01);

        gridLayout_39->addWidget(mcconfFocCurrKpBox, 2, 2, 1, 1);

        mcconfFocCurrKiBox = new QDoubleSpinBox(groupBox_39);
        mcconfFocCurrKiBox->setObjectName(QStringLiteral("mcconfFocCurrKiBox"));
        mcconfFocCurrKiBox->setMaximum(100000);

        gridLayout_39->addWidget(mcconfFocCurrKiBox, 2, 3, 1, 1);

        label_92 = new QLabel(groupBox_39);
        label_92->setObjectName(QStringLiteral("label_92"));

        gridLayout_39->addWidget(label_92, 4, 0, 1, 1);

        mcconfFocEncoderOffsetBox = new QDoubleSpinBox(groupBox_39);
        mcconfFocEncoderOffsetBox->setObjectName(QStringLiteral("mcconfFocEncoderOffsetBox"));
        mcconfFocEncoderOffsetBox->setMaximum(360);

        gridLayout_39->addWidget(mcconfFocEncoderOffsetBox, 4, 2, 1, 1);

        label_101 = new QLabel(groupBox_39);
        label_101->setObjectName(QStringLiteral("label_101"));

        gridLayout_39->addWidget(label_101, 0, 0, 1, 1);

        mcconfFocEncoderInvertedBox = new QCheckBox(groupBox_39);
        mcconfFocEncoderInvertedBox->setObjectName(QStringLiteral("mcconfFocEncoderInvertedBox"));

        gridLayout_39->addWidget(mcconfFocEncoderInvertedBox, 5, 3, 1, 1);

        horizontalLayout_26 = new QHBoxLayout();
        horizontalLayout_26->setSpacing(6);
        horizontalLayout_26->setObjectName(QStringLiteral("horizontalLayout_26"));
        mcconfFocModeEncoderButton = new QRadioButton(groupBox_39);
        mcconfFocModeEncoderButton->setObjectName(QStringLiteral("mcconfFocModeEncoderButton"));
        mcconfFocModeEncoderButton->setChecked(true);

        horizontalLayout_26->addWidget(mcconfFocModeEncoderButton);

        mcconfFocModeHallButton = new QRadioButton(groupBox_39);
        mcconfFocModeHallButton->setObjectName(QStringLiteral("mcconfFocModeHallButton"));

        horizontalLayout_26->addWidget(mcconfFocModeHallButton);

        mcconfFocModeSensorlessButton = new QRadioButton(groupBox_39);
        mcconfFocModeSensorlessButton->setObjectName(QStringLiteral("mcconfFocModeSensorlessButton"));

        horizontalLayout_26->addWidget(mcconfFocModeSensorlessButton);


        gridLayout_39->addLayout(horizontalLayout_26, 0, 2, 1, 2);

        mcconfFocSlErpmBox = new QDoubleSpinBox(groupBox_39);
        mcconfFocSlErpmBox->setObjectName(QStringLiteral("mcconfFocSlErpmBox"));
        mcconfFocSlErpmBox->setMaximum(200000);
        mcconfFocSlErpmBox->setSingleStep(10);

        gridLayout_39->addWidget(mcconfFocSlErpmBox, 5, 2, 1, 1);

        label_96 = new QLabel(groupBox_39);
        label_96->setObjectName(QStringLiteral("label_96"));

        gridLayout_39->addWidget(label_96, 5, 0, 1, 1);


        gridLayout_42->addWidget(groupBox_39, 0, 0, 1, 1);

        groupBox_41 = new QGroupBox(tab_24);
        groupBox_41->setObjectName(QStringLiteral("groupBox_41"));
        gridLayout_40 = new QGridLayout(groupBox_41);
        gridLayout_40->setSpacing(6);
        gridLayout_40->setContentsMargins(11, 11, 11, 11);
        gridLayout_40->setObjectName(QStringLiteral("gridLayout_40"));
        label_104 = new QLabel(groupBox_41);
        label_104->setObjectName(QStringLiteral("label_104"));

        gridLayout_40->addWidget(label_104, 7, 0, 1, 1);

        mcconfFocPllKpBox = new QDoubleSpinBox(groupBox_41);
        mcconfFocPllKpBox->setObjectName(QStringLiteral("mcconfFocPllKpBox"));
        mcconfFocPllKpBox->setMaximum(100000);

        gridLayout_40->addWidget(mcconfFocPllKpBox, 5, 1, 1, 1);

        mcconfFocDutyDownrampKiBox = new QDoubleSpinBox(groupBox_41);
        mcconfFocDutyDownrampKiBox->setObjectName(QStringLiteral("mcconfFocDutyDownrampKiBox"));
        mcconfFocDutyDownrampKiBox->setMaximum(100000);

        gridLayout_40->addWidget(mcconfFocDutyDownrampKiBox, 6, 2, 1, 1);

        label_103 = new QLabel(groupBox_41);
        label_103->setObjectName(QStringLiteral("label_103"));

        gridLayout_40->addWidget(label_103, 6, 0, 1, 1);

        mcconfFocPllKiBox = new QDoubleSpinBox(groupBox_41);
        mcconfFocPllKiBox->setObjectName(QStringLiteral("mcconfFocPllKiBox"));
        mcconfFocPllKiBox->setDecimals(2);
        mcconfFocPllKiBox->setMaximum(1e+06);
        mcconfFocPllKiBox->setSingleStep(1000);

        gridLayout_40->addWidget(mcconfFocPllKiBox, 5, 2, 1, 1);

        label_90 = new QLabel(groupBox_41);
        label_90->setObjectName(QStringLiteral("label_90"));

        gridLayout_40->addWidget(label_90, 5, 0, 1, 1);

        mcconfFocOpenloopRpmBox = new QDoubleSpinBox(groupBox_41);
        mcconfFocOpenloopRpmBox->setObjectName(QStringLiteral("mcconfFocOpenloopRpmBox"));
        mcconfFocOpenloopRpmBox->setKeyboardTracking(false);
        mcconfFocOpenloopRpmBox->setMaximum(100000);
        mcconfFocOpenloopRpmBox->setSingleStep(10);

        gridLayout_40->addWidget(mcconfFocOpenloopRpmBox, 7, 1, 1, 2);

        mcconfFocDutyDownrampKpBox = new QDoubleSpinBox(groupBox_41);
        mcconfFocDutyDownrampKpBox->setObjectName(QStringLiteral("mcconfFocDutyDownrampKpBox"));
        mcconfFocDutyDownrampKpBox->setMaximum(10000);

        gridLayout_40->addWidget(mcconfFocDutyDownrampKpBox, 6, 1, 1, 1);

        mcconfFocFSwBox = new QSpinBox(groupBox_41);
        mcconfFocFSwBox->setObjectName(QStringLiteral("mcconfFocFSwBox"));
        mcconfFocFSwBox->setMaximum(100000);
        mcconfFocFSwBox->setSingleStep(100);

        gridLayout_40->addWidget(mcconfFocFSwBox, 4, 1, 1, 1);

        label_94 = new QLabel(groupBox_41);
        label_94->setObjectName(QStringLiteral("label_94"));

        gridLayout_40->addWidget(label_94, 4, 0, 1, 1);

        mcconfFocDtCompBox = new QDoubleSpinBox(groupBox_41);
        mcconfFocDtCompBox->setObjectName(QStringLiteral("mcconfFocDtCompBox"));
        mcconfFocDtCompBox->setDecimals(3);
        mcconfFocDtCompBox->setMaximum(10000);
        mcconfFocDtCompBox->setSingleStep(0.01);

        gridLayout_40->addWidget(mcconfFocDtCompBox, 4, 2, 1, 1);


        gridLayout_42->addWidget(groupBox_41, 0, 1, 1, 1);

        groupBox_40 = new QGroupBox(tab_24);
        groupBox_40->setObjectName(QStringLiteral("groupBox_40"));
        gridLayout_41 = new QGridLayout(groupBox_40);
        gridLayout_41->setSpacing(6);
        gridLayout_41->setContentsMargins(11, 11, 11, 11);
        gridLayout_41->setObjectName(QStringLiteral("gridLayout_41"));
        mcconfFocObserverGainBox = new QDoubleSpinBox(groupBox_40);
        mcconfFocObserverGainBox->setObjectName(QStringLiteral("mcconfFocObserverGainBox"));
        mcconfFocObserverGainBox->setMaximum(100000);
        mcconfFocObserverGainBox->setSingleStep(1);

        gridLayout_41->addWidget(mcconfFocObserverGainBox, 4, 1, 1, 1);

        label_98 = new QLabel(groupBox_40);
        label_98->setObjectName(QStringLiteral("label_98"));

        gridLayout_41->addWidget(label_98, 4, 0, 1, 1);

        mcconfFocObserverGainCalcButton = new QPushButton(groupBox_40);
        mcconfFocObserverGainCalcButton->setObjectName(QStringLiteral("mcconfFocObserverGainCalcButton"));

        gridLayout_41->addWidget(mcconfFocObserverGainCalcButton, 4, 2, 1, 1);

        mcconfFocMotorRBox = new QDoubleSpinBox(groupBox_40);
        mcconfFocMotorRBox->setObjectName(QStringLiteral("mcconfFocMotorRBox"));
        mcconfFocMotorRBox->setDecimals(5);
        mcconfFocMotorRBox->setMaximum(1000);
        mcconfFocMotorRBox->setSingleStep(0.001);

        gridLayout_41->addWidget(mcconfFocMotorRBox, 1, 0, 1, 1);

        mcconfFocMotorLBox = new QDoubleSpinBox(groupBox_40);
        mcconfFocMotorLBox->setObjectName(QStringLiteral("mcconfFocMotorLBox"));
        mcconfFocMotorLBox->setDecimals(2);
        mcconfFocMotorLBox->setMaximum(1e+06);

        gridLayout_41->addWidget(mcconfFocMotorLBox, 1, 1, 1, 1);

        mcconfFocMotorLinkageBox = new QDoubleSpinBox(groupBox_40);
        mcconfFocMotorLinkageBox->setObjectName(QStringLiteral("mcconfFocMotorLinkageBox"));
        mcconfFocMotorLinkageBox->setDecimals(6);
        mcconfFocMotorLinkageBox->setMaximum(1000);
        mcconfFocMotorLinkageBox->setSingleStep(0.0001);

        gridLayout_41->addWidget(mcconfFocMotorLinkageBox, 1, 2, 1, 1);


        gridLayout_42->addWidget(groupBox_40, 1, 0, 1, 1);

        groupBox_43 = new QGroupBox(tab_24);
        groupBox_43->setObjectName(QStringLiteral("groupBox_43"));
        gridLayout_44 = new QGridLayout(groupBox_43);
        gridLayout_44->setSpacing(6);
        gridLayout_44->setContentsMargins(11, 11, 11, 11);
        gridLayout_44->setObjectName(QStringLiteral("gridLayout_44"));
        mcconfFocDCurrentFactorBox = new QDoubleSpinBox(groupBox_43);
        mcconfFocDCurrentFactorBox->setObjectName(QStringLiteral("mcconfFocDCurrentFactorBox"));
        mcconfFocDCurrentFactorBox->setSingleStep(0.1);

        gridLayout_44->addWidget(mcconfFocDCurrentFactorBox, 1, 2, 1, 1);

        mcconfFocSlOpenloopHystBox = new QDoubleSpinBox(groupBox_43);
        mcconfFocSlOpenloopHystBox->setObjectName(QStringLiteral("mcconfFocSlOpenloopHystBox"));
        mcconfFocSlOpenloopHystBox->setDecimals(3);
        mcconfFocSlOpenloopHystBox->setMaximum(200);
        mcconfFocSlOpenloopHystBox->setSingleStep(0.1);

        gridLayout_44->addWidget(mcconfFocSlOpenloopHystBox, 0, 1, 1, 1);

        label_105 = new QLabel(groupBox_43);
        label_105->setObjectName(QStringLiteral("label_105"));

        gridLayout_44->addWidget(label_105, 0, 0, 1, 1);

        label_107 = new QLabel(groupBox_43);
        label_107->setObjectName(QStringLiteral("label_107"));

        gridLayout_44->addWidget(label_107, 1, 0, 1, 1);

        mcconfFocDCurrentDutyBox = new QDoubleSpinBox(groupBox_43);
        mcconfFocDCurrentDutyBox->setObjectName(QStringLiteral("mcconfFocDCurrentDutyBox"));
        mcconfFocDCurrentDutyBox->setDecimals(3);
        mcconfFocDCurrentDutyBox->setMaximum(1);
        mcconfFocDCurrentDutyBox->setSingleStep(0.01);

        gridLayout_44->addWidget(mcconfFocDCurrentDutyBox, 1, 1, 1, 1);

        mcconfFocSlOpenloopTimeBox = new QDoubleSpinBox(groupBox_43);
        mcconfFocSlOpenloopTimeBox->setObjectName(QStringLiteral("mcconfFocSlOpenloopTimeBox"));
        mcconfFocSlOpenloopTimeBox->setDecimals(3);
        mcconfFocSlOpenloopTimeBox->setMaximum(200);
        mcconfFocSlOpenloopTimeBox->setSingleStep(0.1);

        gridLayout_44->addWidget(mcconfFocSlOpenloopTimeBox, 0, 2, 1, 1);


        gridLayout_42->addWidget(groupBox_43, 1, 1, 1, 1);


        verticalLayout_29->addLayout(gridLayout_42);

        groupBox_46 = new QGroupBox(tab_24);
        groupBox_46->setObjectName(QStringLiteral("groupBox_46"));
        horizontalLayout_45 = new QHBoxLayout(groupBox_46);
        horizontalLayout_45->setSpacing(6);
        horizontalLayout_45->setContentsMargins(11, 11, 11, 11);
        horizontalLayout_45->setObjectName(QStringLiteral("horizontalLayout_45"));
        label_95 = new QLabel(groupBox_46);
        label_95->setObjectName(QStringLiteral("label_95"));

        horizontalLayout_45->addWidget(label_95);

        mcconfFocHallTab0Box = new QSpinBox(groupBox_46);
        mcconfFocHallTab0Box->setObjectName(QStringLiteral("mcconfFocHallTab0Box"));
        mcconfFocHallTab0Box->setMaximum(255);

        horizontalLayout_45->addWidget(mcconfFocHallTab0Box);

        mcconfFocHallTab1Box = new QSpinBox(groupBox_46);
        mcconfFocHallTab1Box->setObjectName(QStringLiteral("mcconfFocHallTab1Box"));
        mcconfFocHallTab1Box->setMaximum(255);

        horizontalLayout_45->addWidget(mcconfFocHallTab1Box);

        mcconfFocHallTab2Box = new QSpinBox(groupBox_46);
        mcconfFocHallTab2Box->setObjectName(QStringLiteral("mcconfFocHallTab2Box"));
        mcconfFocHallTab2Box->setMaximum(255);

        horizontalLayout_45->addWidget(mcconfFocHallTab2Box);

        mcconfFocHallTab3Box = new QSpinBox(groupBox_46);
        mcconfFocHallTab3Box->setObjectName(QStringLiteral("mcconfFocHallTab3Box"));
        mcconfFocHallTab3Box->setMaximum(255);

        horizontalLayout_45->addWidget(mcconfFocHallTab3Box);

        mcconfFocHallTab4Box = new QSpinBox(groupBox_46);
        mcconfFocHallTab4Box->setObjectName(QStringLiteral("mcconfFocHallTab4Box"));
        mcconfFocHallTab4Box->setMaximum(255);

        horizontalLayout_45->addWidget(mcconfFocHallTab4Box);

        mcconfFocHallTab5Box = new QSpinBox(groupBox_46);
        mcconfFocHallTab5Box->setObjectName(QStringLiteral("mcconfFocHallTab5Box"));
        mcconfFocHallTab5Box->setMaximum(255);

        horizontalLayout_45->addWidget(mcconfFocHallTab5Box);

        mcconfFocHallTab6Box = new QSpinBox(groupBox_46);
        mcconfFocHallTab6Box->setObjectName(QStringLiteral("mcconfFocHallTab6Box"));
        mcconfFocHallTab6Box->setMaximum(255);

        horizontalLayout_45->addWidget(mcconfFocHallTab6Box);

        mcconfFocHallTab7Box = new QSpinBox(groupBox_46);
        mcconfFocHallTab7Box->setObjectName(QStringLiteral("mcconfFocHallTab7Box"));
        mcconfFocHallTab7Box->setMaximum(255);

        horizontalLayout_45->addWidget(mcconfFocHallTab7Box);

        horizontalSpacer_23 = new QSpacerItem(40, 20, QSizePolicy::Expanding, QSizePolicy::Minimum);

        horizontalLayout_45->addItem(horizontalSpacer_23);


        verticalLayout_29->addWidget(groupBox_46);

        verticalSpacer_17 = new QSpacerItem(20, 20, QSizePolicy::Minimum, QSizePolicy::Expanding);

        verticalLayout_29->addItem(verticalSpacer_17);

        groupBox_44 = new QGroupBox(tab_24);
        groupBox_44->setObjectName(QStringLiteral("groupBox_44"));
        gridLayout_45 = new QGridLayout(groupBox_44);
        gridLayout_45->setSpacing(6);
        gridLayout_45->setContentsMargins(11, 11, 11, 11);
        gridLayout_45->setObjectName(QStringLiteral("gridLayout_45"));
        horizontalSpacer_29 = new QSpacerItem(40, 20, QSizePolicy::Expanding, QSizePolicy::Minimum);

        gridLayout_45->addItem(horizontalSpacer_29, 0, 4, 1, 1);

        mcconfFocCalcCCTcBox = new QDoubleSpinBox(groupBox_44);
        mcconfFocCalcCCTcBox->setObjectName(QStringLiteral("mcconfFocCalcCCTcBox"));
        mcconfFocCalcCCTcBox->setDecimals(1);
        mcconfFocCalcCCTcBox->setMaximum(100000);
        mcconfFocCalcCCTcBox->setSingleStep(10);
        mcconfFocCalcCCTcBox->setValue(1000);

        gridLayout_45->addWidget(mcconfFocCalcCCTcBox, 3, 1, 1, 1);

        mcconfFocMeasureLinkageButton = new QPushButton(groupBox_44);
        mcconfFocMeasureLinkageButton->setObjectName(QStringLiteral("mcconfFocMeasureLinkageButton"));

        gridLayout_45->addWidget(mcconfFocMeasureLinkageButton, 2, 0, 1, 1);

        mcconfFocMeasureRLButton = new QPushButton(groupBox_44);
        mcconfFocMeasureRLButton->setObjectName(QStringLiteral("mcconfFocMeasureRLButton"));

        gridLayout_45->addWidget(mcconfFocMeasureRLButton, 0, 0, 1, 1);

        mcconfFocDetectRBox = new QDoubleSpinBox(groupBox_44);
        mcconfFocDetectRBox->setObjectName(QStringLiteral("mcconfFocDetectRBox"));
        mcconfFocDetectRBox->setDecimals(5);
        mcconfFocDetectRBox->setMaximum(1000);
        mcconfFocDetectRBox->setSingleStep(0.001);

        gridLayout_45->addWidget(mcconfFocDetectRBox, 0, 1, 1, 1);

        mcconfFocDetectLBox = new QDoubleSpinBox(groupBox_44);
        mcconfFocDetectLBox->setObjectName(QStringLiteral("mcconfFocDetectLBox"));
        mcconfFocDetectLBox->setMaximum(100000);

        gridLayout_45->addWidget(mcconfFocDetectLBox, 0, 2, 1, 1);

        mcconfFocApplyRLLambdaButton = new QPushButton(groupBox_44);
        mcconfFocApplyRLLambdaButton->setObjectName(QStringLiteral("mcconfFocApplyRLLambdaButton"));

        gridLayout_45->addWidget(mcconfFocApplyRLLambdaButton, 0, 5, 1, 1);

        mcconfFocCalcCCButton = new QPushButton(groupBox_44);
        mcconfFocCalcCCButton->setObjectName(QStringLiteral("mcconfFocCalcCCButton"));

        gridLayout_45->addWidget(mcconfFocCalcCCButton, 3, 0, 1, 1);

        mcconfFocCalcCCApplyButton = new QPushButton(groupBox_44);
        mcconfFocCalcCCApplyButton->setObjectName(QStringLiteral("mcconfFocCalcCCApplyButton"));

        gridLayout_45->addWidget(mcconfFocCalcCCApplyButton, 3, 5, 1, 1);

        mcconfFocDetectLinkageBox = new QDoubleSpinBox(groupBox_44);
        mcconfFocDetectLinkageBox->setObjectName(QStringLiteral("mcconfFocDetectLinkageBox"));
        mcconfFocDetectLinkageBox->setReadOnly(true);
        mcconfFocDetectLinkageBox->setDecimals(8);
        mcconfFocDetectLinkageBox->setMaximum(100);
        mcconfFocDetectLinkageBox->setSingleStep(0.0001);
        mcconfFocDetectLinkageBox->setValue(0);

        gridLayout_45->addWidget(mcconfFocDetectLinkageBox, 0, 3, 1, 1);

        mcconfFocCalcKiBox = new QDoubleSpinBox(groupBox_44);
        mcconfFocCalcKiBox->setObjectName(QStringLiteral("mcconfFocCalcKiBox"));
        mcconfFocCalcKiBox->setReadOnly(true);
        mcconfFocCalcKiBox->setMaximum(100000);

        gridLayout_45->addWidget(mcconfFocCalcKiBox, 3, 3, 1, 1);

        mcconfFocCalcKpBox = new QDoubleSpinBox(groupBox_44);
        mcconfFocCalcKpBox->setObjectName(QStringLiteral("mcconfFocCalcKpBox"));
        mcconfFocCalcKpBox->setReadOnly(true);
        mcconfFocCalcKpBox->setDecimals(4);
        mcconfFocCalcKpBox->setMaximum(1000);
        mcconfFocCalcKpBox->setSingleStep(0.01);

        gridLayout_45->addWidget(mcconfFocCalcKpBox, 3, 2, 1, 1);

        mcconfFocDetectCurrentBox = new QDoubleSpinBox(groupBox_44);
        mcconfFocDetectCurrentBox->setObjectName(QStringLiteral("mcconfFocDetectCurrentBox"));
        mcconfFocDetectCurrentBox->setMaximum(150);
        mcconfFocDetectCurrentBox->setValue(6);

        gridLayout_45->addWidget(mcconfFocDetectCurrentBox, 2, 1, 1, 1);

        mcconfFocDetectDutyBox = new QDoubleSpinBox(groupBox_44);
        mcconfFocDetectDutyBox->setObjectName(QStringLiteral("mcconfFocDetectDutyBox"));
        mcconfFocDetectDutyBox->setMaximum(1);
        mcconfFocDetectDutyBox->setSingleStep(0.01);
        mcconfFocDetectDutyBox->setValue(0.5);

        gridLayout_45->addWidget(mcconfFocDetectDutyBox, 2, 2, 1, 1);

        mcconfFocDetectMinRpmBox = new QDoubleSpinBox(groupBox_44);
        mcconfFocDetectMinRpmBox->setObjectName(QStringLiteral("mcconfFocDetectMinRpmBox"));
        mcconfFocDetectMinRpmBox->setDecimals(1);
        mcconfFocDetectMinRpmBox->setMaximum(10000);
        mcconfFocDetectMinRpmBox->setSingleStep(10);
        mcconfFocDetectMinRpmBox->setValue(700);

        gridLayout_45->addWidget(mcconfFocDetectMinRpmBox, 2, 3, 1, 1);

        label_93 = new QLabel(groupBox_44);
        label_93->setObjectName(QStringLiteral("label_93"));

        gridLayout_45->addWidget(label_93, 2, 4, 1, 2);


        verticalLayout_29->addWidget(groupBox_44);

        groupBox_42 = new QGroupBox(tab_24);
        groupBox_42->setObjectName(QStringLiteral("groupBox_42"));
        horizontalLayout_25 = new QHBoxLayout(groupBox_42);
        horizontalLayout_25->setSpacing(6);
        horizontalLayout_25->setContentsMargins(11, 11, 11, 11);
        horizontalLayout_25->setObjectName(QStringLiteral("horizontalLayout_25"));
        mcconfFocMeasureEncoderButton = new QPushButton(groupBox_42);
        mcconfFocMeasureEncoderButton->setObjectName(QStringLiteral("mcconfFocMeasureEncoderButton"));

        horizontalLayout_25->addWidget(mcconfFocMeasureEncoderButton);

        mcconfFocMeasureEncoderCurrentBox = new QDoubleSpinBox(groupBox_42);
        mcconfFocMeasureEncoderCurrentBox->setObjectName(QStringLiteral("mcconfFocMeasureEncoderCurrentBox"));
        mcconfFocMeasureEncoderCurrentBox->setValue(15);

        horizontalLayout_25->addWidget(mcconfFocMeasureEncoderCurrentBox);

        horizontalSpacer_26 = new QSpacerItem(40, 20, QSizePolicy::Expanding, QSizePolicy::Minimum);

        horizontalLayout_25->addItem(horizontalSpacer_26);

        mcconfFocMeasureEncoderOffsetBox = new QDoubleSpinBox(groupBox_42);
        mcconfFocMeasureEncoderOffsetBox->setObjectName(QStringLiteral("mcconfFocMeasureEncoderOffsetBox"));
        mcconfFocMeasureEncoderOffsetBox->setReadOnly(true);
        mcconfFocMeasureEncoderOffsetBox->setMaximum(360);

        horizontalLayout_25->addWidget(mcconfFocMeasureEncoderOffsetBox);

        mcconfFocMeasureEncoderRatioBox = new QDoubleSpinBox(groupBox_42);
        mcconfFocMeasureEncoderRatioBox->setObjectName(QStringLiteral("mcconfFocMeasureEncoderRatioBox"));
        mcconfFocMeasureEncoderRatioBox->setReadOnly(true);
        mcconfFocMeasureEncoderRatioBox->setMaximum(500);

        horizontalLayout_25->addWidget(mcconfFocMeasureEncoderRatioBox);

        mcconfFocMeasureEncoderInvertedBox = new QCheckBox(groupBox_42);
        mcconfFocMeasureEncoderInvertedBox->setObjectName(QStringLiteral("mcconfFocMeasureEncoderInvertedBox"));

        horizontalLayout_25->addWidget(mcconfFocMeasureEncoderInvertedBox);

        horizontalSpacer_27 = new QSpacerItem(40, 20, QSizePolicy::Expanding, QSizePolicy::Minimum);

        horizontalLayout_25->addItem(horizontalSpacer_27);

        mcconfFocMeasureEncoderApplyButton = new QPushButton(groupBox_42);
        mcconfFocMeasureEncoderApplyButton->setObjectName(QStringLiteral("mcconfFocMeasureEncoderApplyButton"));

        horizontalLayout_25->addWidget(mcconfFocMeasureEncoderApplyButton);


        verticalLayout_29->addWidget(groupBox_42);

        groupBox_45 = new QGroupBox(tab_24);
        groupBox_45->setObjectName(QStringLiteral("groupBox_45"));
        horizontalLayout_38 = new QHBoxLayout(groupBox_45);
        horizontalLayout_38->setSpacing(6);
        horizontalLayout_38->setContentsMargins(11, 11, 11, 11);
        horizontalLayout_38->setObjectName(QStringLiteral("horizontalLayout_38"));
        mcconfFocMeasureHallButton = new QPushButton(groupBox_45);
        mcconfFocMeasureHallButton->setObjectName(QStringLiteral("mcconfFocMeasureHallButton"));

        horizontalLayout_38->addWidget(mcconfFocMeasureHallButton);

        mcconfFocMeasureHallCurrentBox = new QDoubleSpinBox(groupBox_45);
        mcconfFocMeasureHallCurrentBox->setObjectName(QStringLiteral("mcconfFocMeasureHallCurrentBox"));
        mcconfFocMeasureHallCurrentBox->setValue(15);

        horizontalLayout_38->addWidget(mcconfFocMeasureHallCurrentBox);

        horizontalSpacer_25 = new QSpacerItem(40, 20, QSizePolicy::Expanding, QSizePolicy::Minimum);

        horizontalLayout_38->addItem(horizontalSpacer_25);

        mcconfFocMeasureHallTab0Box = new QSpinBox(groupBox_45);
        mcconfFocMeasureHallTab0Box->setObjectName(QStringLiteral("mcconfFocMeasureHallTab0Box"));
        mcconfFocMeasureHallTab0Box->setMaximum(255);

        horizontalLayout_38->addWidget(mcconfFocMeasureHallTab0Box);

        mcconfFocMeasureHallTab1Box = new QSpinBox(groupBox_45);
        mcconfFocMeasureHallTab1Box->setObjectName(QStringLiteral("mcconfFocMeasureHallTab1Box"));
        mcconfFocMeasureHallTab1Box->setMaximum(255);

        horizontalLayout_38->addWidget(mcconfFocMeasureHallTab1Box);

        mcconfFocMeasureHallTab2Box = new QSpinBox(groupBox_45);
        mcconfFocMeasureHallTab2Box->setObjectName(QStringLiteral("mcconfFocMeasureHallTab2Box"));
        mcconfFocMeasureHallTab2Box->setMaximum(255);

        horizontalLayout_38->addWidget(mcconfFocMeasureHallTab2Box);

        mcconfFocMeasureHallTab3Box = new QSpinBox(groupBox_45);
        mcconfFocMeasureHallTab3Box->setObjectName(QStringLiteral("mcconfFocMeasureHallTab3Box"));
        mcconfFocMeasureHallTab3Box->setMaximum(255);

        horizontalLayout_38->addWidget(mcconfFocMeasureHallTab3Box);

        mcconfFocMeasureHallTab4Box = new QSpinBox(groupBox_45);
        mcconfFocMeasureHallTab4Box->setObjectName(QStringLiteral("mcconfFocMeasureHallTab4Box"));
        mcconfFocMeasureHallTab4Box->setMaximum(255);

        horizontalLayout_38->addWidget(mcconfFocMeasureHallTab4Box);

        mcconfFocMeasureHallTab5Box = new QSpinBox(groupBox_45);
        mcconfFocMeasureHallTab5Box->setObjectName(QStringLiteral("mcconfFocMeasureHallTab5Box"));
        mcconfFocMeasureHallTab5Box->setMaximum(255);

        horizontalLayout_38->addWidget(mcconfFocMeasureHallTab5Box);

        mcconfFocMeasureHallTab6Box = new QSpinBox(groupBox_45);
        mcconfFocMeasureHallTab6Box->setObjectName(QStringLiteral("mcconfFocMeasureHallTab6Box"));
        mcconfFocMeasureHallTab6Box->setMaximum(255);

        horizontalLayout_38->addWidget(mcconfFocMeasureHallTab6Box);

        mcconfFocMeasureHallTab7Box = new QSpinBox(groupBox_45);
        mcconfFocMeasureHallTab7Box->setObjectName(QStringLiteral("mcconfFocMeasureHallTab7Box"));
        mcconfFocMeasureHallTab7Box->setMaximum(255);

        horizontalLayout_38->addWidget(mcconfFocMeasureHallTab7Box);

        horizontalSpacer_24 = new QSpacerItem(40, 20, QSizePolicy::Expanding, QSizePolicy::Minimum);

        horizontalLayout_38->addItem(horizontalSpacer_24);

        mcconfFocMeasureHallApplyButton = new QPushButton(groupBox_45);
        mcconfFocMeasureHallApplyButton->setObjectName(QStringLiteral("mcconfFocMeasureHallApplyButton"));

        horizontalLayout_38->addWidget(mcconfFocMeasureHallApplyButton);


        verticalLayout_29->addWidget(groupBox_45);

        tabWidget_4->addTab(tab_24, QString());
        tab_14 = new QWidget();
        tab_14->setObjectName(QStringLiteral("tab_14"));
        verticalLayout_27 = new QVBoxLayout(tab_14);
        verticalLayout_27->setSpacing(6);
        verticalLayout_27->setContentsMargins(11, 11, 11, 11);
        verticalLayout_27->setObjectName(QStringLiteral("verticalLayout_27"));
        groupBox_13 = new QGroupBox(tab_14);
        groupBox_13->setObjectName(QStringLiteral("groupBox_13"));
        horizontalLayout_44 = new QHBoxLayout(groupBox_13);
        horizontalLayout_44->setSpacing(6);
        horizontalLayout_44->setContentsMargins(11, 11, 11, 11);
        horizontalLayout_44->setObjectName(QStringLiteral("horizontalLayout_44"));
        mcconfPwmModeSyncButton = new QRadioButton(groupBox_13);
        mcconfPwmModeSyncButton->setObjectName(QStringLiteral("mcconfPwmModeSyncButton"));
        mcconfPwmModeSyncButton->setChecked(true);

        horizontalLayout_44->addWidget(mcconfPwmModeSyncButton);

        mcconfPwmModeBipolarButton = new QRadioButton(groupBox_13);
        mcconfPwmModeBipolarButton->setObjectName(QStringLiteral("mcconfPwmModeBipolarButton"));

        horizontalLayout_44->addWidget(mcconfPwmModeBipolarButton);

        mcconfPwmModeNonsyncHiswButton = new QRadioButton(groupBox_13);
        mcconfPwmModeNonsyncHiswButton->setObjectName(QStringLiteral("mcconfPwmModeNonsyncHiswButton"));

        horizontalLayout_44->addWidget(mcconfPwmModeNonsyncHiswButton);

        horizontalSpacer_21 = new QSpacerItem(40, 20, QSizePolicy::Expanding, QSizePolicy::Minimum);

        horizontalLayout_44->addItem(horizontalSpacer_21);


        verticalLayout_27->addWidget(groupBox_13);

        horizontalLayout_23 = new QHBoxLayout();
        horizontalLayout_23->setSpacing(6);
        horizontalLayout_23->setObjectName(QStringLiteral("horizontalLayout_23"));
        groupBox_14 = new QGroupBox(tab_14);
        groupBox_14->setObjectName(QStringLiteral("groupBox_14"));
        sizePolicy3.setHeightForWidth(groupBox_14->sizePolicy().hasHeightForWidth());
        groupBox_14->setSizePolicy(sizePolicy3);
        gridLayout_14 = new QGridLayout(groupBox_14);
        gridLayout_14->setSpacing(6);
        gridLayout_14->setContentsMargins(11, 11, 11, 11);
        gridLayout_14->setObjectName(QStringLiteral("gridLayout_14"));
        label_34 = new QLabel(groupBox_14);
        label_34->setObjectName(QStringLiteral("label_34"));

        gridLayout_14->addWidget(label_34, 0, 0, 1, 1);

        mcconfCcBoostBox = new QDoubleSpinBox(groupBox_14);
        mcconfCcBoostBox->setObjectName(QStringLiteral("mcconfCcBoostBox"));
        mcconfCcBoostBox->setDecimals(3);
        mcconfCcBoostBox->setMaximum(1);
        mcconfCcBoostBox->setSingleStep(0.01);

        gridLayout_14->addWidget(mcconfCcBoostBox, 0, 1, 1, 1);

        label_35 = new QLabel(groupBox_14);
        label_35->setObjectName(QStringLiteral("label_35"));

        gridLayout_14->addWidget(label_35, 1, 0, 1, 1);

        mcconfCcMinBox = new QDoubleSpinBox(groupBox_14);
        mcconfCcMinBox->setObjectName(QStringLiteral("mcconfCcMinBox"));

        gridLayout_14->addWidget(mcconfCcMinBox, 1, 1, 1, 1);

        label_36 = new QLabel(groupBox_14);
        label_36->setObjectName(QStringLiteral("label_36"));

        gridLayout_14->addWidget(label_36, 2, 0, 1, 1);

        mcconfCcGainBox = new QDoubleSpinBox(groupBox_14);
        mcconfCcGainBox->setObjectName(QStringLiteral("mcconfCcGainBox"));
        mcconfCcGainBox->setDecimals(5);
        mcconfCcGainBox->setMaximum(50);
        mcconfCcGainBox->setSingleStep(0.0001);

        gridLayout_14->addWidget(mcconfCcGainBox, 2, 1, 1, 1);

        verticalSpacer_16 = new QSpacerItem(20, 25, QSizePolicy::Minimum, QSizePolicy::Preferred);

        gridLayout_14->addItem(verticalSpacer_16, 3, 1, 1, 1);


        horizontalLayout_23->addWidget(groupBox_14);

        groupBox_37 = new QGroupBox(tab_14);
        groupBox_37->setObjectName(QStringLiteral("groupBox_37"));
        groupBox_37->setFlat(false);
        groupBox_37->setCheckable(false);
        gridLayout_37 = new QGridLayout(groupBox_37);
        gridLayout_37->setSpacing(6);
        gridLayout_37->setContentsMargins(11, 11, 11, 11);
        gridLayout_37->setObjectName(QStringLiteral("gridLayout_37"));
        label_3 = new QLabel(groupBox_37);
        label_3->setObjectName(QStringLiteral("label_3"));

        gridLayout_37->addWidget(label_3, 0, 0, 1, 1);

        mcconfMDutyRampStepBox = new QDoubleSpinBox(groupBox_37);
        mcconfMDutyRampStepBox->setObjectName(QStringLiteral("mcconfMDutyRampStepBox"));
        mcconfMDutyRampStepBox->setDecimals(4);
        mcconfMDutyRampStepBox->setSingleStep(0.01);

        gridLayout_37->addWidget(mcconfMDutyRampStepBox, 0, 1, 1, 1);

        label_69 = new QLabel(groupBox_37);
        label_69->setObjectName(QStringLiteral("label_69"));

        gridLayout_37->addWidget(label_69, 1, 0, 1, 1);

        mcconfCcMaxRampStepBox = new QDoubleSpinBox(groupBox_37);
        mcconfCcMaxRampStepBox->setObjectName(QStringLiteral("mcconfCcMaxRampStepBox"));
        mcconfCcMaxRampStepBox->setDecimals(4);
        mcconfCcMaxRampStepBox->setMaximum(50);
        mcconfCcMaxRampStepBox->setSingleStep(0.01);

        gridLayout_37->addWidget(mcconfCcMaxRampStepBox, 1, 1, 1, 1);

        label_85 = new QLabel(groupBox_37);
        label_85->setObjectName(QStringLiteral("label_85"));

        gridLayout_37->addWidget(label_85, 2, 0, 1, 1);

        mcconfMCurrentBackoffGainBox = new QDoubleSpinBox(groupBox_37);
        mcconfMCurrentBackoffGainBox->setObjectName(QStringLiteral("mcconfMCurrentBackoffGainBox"));
        mcconfMCurrentBackoffGainBox->setDecimals(4);
        mcconfMCurrentBackoffGainBox->setSingleStep(0.01);

        gridLayout_37->addWidget(mcconfMCurrentBackoffGainBox, 2, 1, 1, 1);

        label_33 = new QLabel(groupBox_37);
        label_33->setObjectName(QStringLiteral("label_33"));

        gridLayout_37->addWidget(label_33, 3, 0, 1, 1);

        mcconfMDutyRampStepSpeedLimBox = new QDoubleSpinBox(groupBox_37);
        mcconfMDutyRampStepSpeedLimBox->setObjectName(QStringLiteral("mcconfMDutyRampStepSpeedLimBox"));
        mcconfMDutyRampStepSpeedLimBox->setDecimals(5);
        mcconfMDutyRampStepSpeedLimBox->setSingleStep(0.0001);

        gridLayout_37->addWidget(mcconfMDutyRampStepSpeedLimBox, 3, 1, 1, 1);


        horizontalLayout_23->addWidget(groupBox_37);


        verticalLayout_27->addLayout(horizontalLayout_23);

        horizontalLayout_39 = new QHBoxLayout();
        horizontalLayout_39->setSpacing(6);
        horizontalLayout_39->setObjectName(QStringLiteral("horizontalLayout_39"));
        groupBox_15 = new QGroupBox(tab_14);
        groupBox_15->setObjectName(QStringLiteral("groupBox_15"));
        sizePolicy3.setHeightForWidth(groupBox_15->sizePolicy().hasHeightForWidth());
        groupBox_15->setSizePolicy(sizePolicy3);
        gridLayout_15 = new QGridLayout(groupBox_15);
        gridLayout_15->setSpacing(6);
        gridLayout_15->setContentsMargins(11, 11, 11, 11);
        gridLayout_15->setObjectName(QStringLiteral("gridLayout_15"));
        label_37 = new QLabel(groupBox_15);
        label_37->setObjectName(QStringLiteral("label_37"));

        gridLayout_15->addWidget(label_37, 0, 0, 1, 1);

        mcconfSpidKpBox = new QDoubleSpinBox(groupBox_15);
        mcconfSpidKpBox->setObjectName(QStringLiteral("mcconfSpidKpBox"));
        mcconfSpidKpBox->setDecimals(5);
        mcconfSpidKpBox->setSingleStep(0.0001);

        gridLayout_15->addWidget(mcconfSpidKpBox, 0, 1, 1, 1);

        label_38 = new QLabel(groupBox_15);
        label_38->setObjectName(QStringLiteral("label_38"));

        gridLayout_15->addWidget(label_38, 1, 0, 1, 1);

        mcconfSpidKiBox = new QDoubleSpinBox(groupBox_15);
        mcconfSpidKiBox->setObjectName(QStringLiteral("mcconfSpidKiBox"));
        mcconfSpidKiBox->setDecimals(5);
        mcconfSpidKiBox->setSingleStep(0.0001);

        gridLayout_15->addWidget(mcconfSpidKiBox, 1, 1, 1, 1);

        label_39 = new QLabel(groupBox_15);
        label_39->setObjectName(QStringLiteral("label_39"));

        gridLayout_15->addWidget(label_39, 2, 0, 1, 1);

        mcconfSpidKdBox = new QDoubleSpinBox(groupBox_15);
        mcconfSpidKdBox->setObjectName(QStringLiteral("mcconfSpidKdBox"));
        mcconfSpidKdBox->setDecimals(5);
        mcconfSpidKdBox->setSingleStep(0.0001);

        gridLayout_15->addWidget(mcconfSpidKdBox, 2, 1, 1, 1);

        label_40 = new QLabel(groupBox_15);
        label_40->setObjectName(QStringLiteral("label_40"));

        gridLayout_15->addWidget(label_40, 3, 0, 1, 1);

        mcconfSpidMinRpmBox = new QDoubleSpinBox(groupBox_15);
        mcconfSpidMinRpmBox->setObjectName(QStringLiteral("mcconfSpidMinRpmBox"));
        mcconfSpidMinRpmBox->setMaximum(200000);
        mcconfSpidMinRpmBox->setSingleStep(100);

        gridLayout_15->addWidget(mcconfSpidMinRpmBox, 3, 1, 1, 1);


        horizontalLayout_39->addWidget(groupBox_15);

        groupBox_30 = new QGroupBox(tab_14);
        groupBox_30->setObjectName(QStringLiteral("groupBox_30"));
        sizePolicy.setHeightForWidth(groupBox_30->sizePolicy().hasHeightForWidth());
        groupBox_30->setSizePolicy(sizePolicy);
        gridLayout_26 = new QGridLayout(groupBox_30);
        gridLayout_26->setSpacing(6);
        gridLayout_26->setContentsMargins(11, 11, 11, 11);
        gridLayout_26->setObjectName(QStringLiteral("gridLayout_26"));
        label_68 = new QLabel(groupBox_30);
        label_68->setObjectName(QStringLiteral("label_68"));

        gridLayout_26->addWidget(label_68, 0, 0, 1, 1);

        mcconfPpidKiBox = new QDoubleSpinBox(groupBox_30);
        mcconfPpidKiBox->setObjectName(QStringLiteral("mcconfPpidKiBox"));
        mcconfPpidKiBox->setDecimals(5);
        mcconfPpidKiBox->setSingleStep(0.0001);

        gridLayout_26->addWidget(mcconfPpidKiBox, 1, 1, 1, 1);

        label_70 = new QLabel(groupBox_30);
        label_70->setObjectName(QStringLiteral("label_70"));

        gridLayout_26->addWidget(label_70, 1, 0, 1, 1);

        mcconfPpidKdBox = new QDoubleSpinBox(groupBox_30);
        mcconfPpidKdBox->setObjectName(QStringLiteral("mcconfPpidKdBox"));
        mcconfPpidKdBox->setDecimals(5);
        mcconfPpidKdBox->setSingleStep(0.0001);

        gridLayout_26->addWidget(mcconfPpidKdBox, 2, 1, 1, 1);

        label_71 = new QLabel(groupBox_30);
        label_71->setObjectName(QStringLiteral("label_71"));

        gridLayout_26->addWidget(label_71, 2, 0, 1, 1);

        mcconfPpidKpBox = new QDoubleSpinBox(groupBox_30);
        mcconfPpidKpBox->setObjectName(QStringLiteral("mcconfPpidKpBox"));
        mcconfPpidKpBox->setDecimals(5);
        mcconfPpidKpBox->setSingleStep(0.0001);

        gridLayout_26->addWidget(mcconfPpidKpBox, 0, 1, 1, 1);

        label_11 = new QLabel(groupBox_30);
        label_11->setObjectName(QStringLiteral("label_11"));

        gridLayout_26->addWidget(label_11, 3, 0, 1, 1);

        mcconfPpidAngDivBox = new QDoubleSpinBox(groupBox_30);
        mcconfPpidAngDivBox->setObjectName(QStringLiteral("mcconfPpidAngDivBox"));
        mcconfPpidAngDivBox->setMinimum(0.01);
        mcconfPpidAngDivBox->setMaximum(10000);

        gridLayout_26->addWidget(mcconfPpidAngDivBox, 3, 1, 1, 1);


        horizontalLayout_39->addWidget(groupBox_30);


        verticalLayout_27->addLayout(horizontalLayout_39);

        horizontalLayout_53 = new QHBoxLayout();
        horizontalLayout_53->setSpacing(6);
        horizontalLayout_53->setObjectName(QStringLiteral("horizontalLayout_53"));
        groupBox_17 = new QGroupBox(tab_14);
        groupBox_17->setObjectName(QStringLiteral("groupBox_17"));
        gridLayout_38 = new QGridLayout(groupBox_17);
        gridLayout_38->setSpacing(6);
        gridLayout_38->setContentsMargins(11, 11, 11, 11);
        gridLayout_38->setObjectName(QStringLiteral("gridLayout_38"));
        label_4 = new QLabel(groupBox_17);
        label_4->setObjectName(QStringLiteral("label_4"));

        gridLayout_38->addWidget(label_4, 0, 1, 1, 1);

        mcconfMEncoderCountBox = new QSpinBox(groupBox_17);
        mcconfMEncoderCountBox->setObjectName(QStringLiteral("mcconfMEncoderCountBox"));
        mcconfMEncoderCountBox->setMaximum(1000000);
        mcconfMEncoderCountBox->setSingleStep(100);

        gridLayout_38->addWidget(mcconfMEncoderCountBox, 1, 2, 1, 1);

        mcconfMFaultStopTimeBox = new QSpinBox(groupBox_17);
        mcconfMFaultStopTimeBox->setObjectName(QStringLiteral("mcconfMFaultStopTimeBox"));
        mcconfMFaultStopTimeBox->setMinimum(-1);
        mcconfMFaultStopTimeBox->setMaximum(40000000);
        mcconfMFaultStopTimeBox->setSingleStep(500);

        gridLayout_38->addWidget(mcconfMFaultStopTimeBox, 0, 2, 1, 1);

        label_91 = new QLabel(groupBox_17);
        label_91->setObjectName(QStringLiteral("label_91"));

        gridLayout_38->addWidget(label_91, 1, 1, 1, 1);


        horizontalLayout_53->addWidget(groupBox_17);

        groupBox_3 = new QGroupBox(tab_14);
        groupBox_3->setObjectName(QStringLiteral("groupBox_3"));
        gridLayout_43 = new QGridLayout(groupBox_3);
        gridLayout_43->setSpacing(6);
        gridLayout_43->setContentsMargins(11, 11, 11, 11);
        gridLayout_43->setObjectName(QStringLiteral("gridLayout_43"));
        mcconfMSensorHallButton = new QRadioButton(groupBox_3);
        mcconfMSensorHallButton->setObjectName(QStringLiteral("mcconfMSensorHallButton"));
        mcconfMSensorHallButton->setChecked(true);

        gridLayout_43->addWidget(mcconfMSensorHallButton, 0, 0, 1, 1);

        mcconfMSensorAsSpiButton = new QRadioButton(groupBox_3);
        mcconfMSensorAsSpiButton->setObjectName(QStringLiteral("mcconfMSensorAsSpiButton"));

        gridLayout_43->addWidget(mcconfMSensorAsSpiButton, 0, 1, 1, 1);

        mcconfMSensorAbiButton = new QRadioButton(groupBox_3);
        mcconfMSensorAbiButton->setObjectName(QStringLiteral("mcconfMSensorAbiButton"));

        gridLayout_43->addWidget(mcconfMSensorAbiButton, 1, 0, 1, 1);


        horizontalLayout_53->addWidget(groupBox_3);

        horizontalSpacer_22 = new QSpacerItem(40, 20, QSizePolicy::Expanding, QSizePolicy::Minimum);

        horizontalLayout_53->addItem(horizontalSpacer_22);


        verticalLayout_27->addLayout(horizontalLayout_53);

        verticalSpacer_8 = new QSpacerItem(20, 40, QSizePolicy::Minimum, QSizePolicy::Expanding);

        verticalLayout_27->addItem(verticalSpacer_8);

        tabWidget_4->addTab(tab_14, QString());
        tab_4 = new QWidget();
        tab_4->setObjectName(QStringLiteral("tab_4"));
        verticalLayout_25 = new QVBoxLayout(tab_4);
        verticalLayout_25->setSpacing(6);
        verticalLayout_25->setContentsMargins(11, 11, 11, 11);
        verticalLayout_25->setObjectName(QStringLiteral("verticalLayout_25"));
        mcconfDescEdit = new MRichTextEdit(tab_4);
        mcconfDescEdit->setObjectName(QStringLiteral("mcconfDescEdit"));

        verticalLayout_25->addWidget(mcconfDescEdit);

        tabWidget_4->addTab(tab_4, QString());

        verticalLayout_31->addWidget(tabWidget_4);

        horizontalLayout_17 = new QHBoxLayout();
        horizontalLayout_17->setSpacing(6);
        horizontalLayout_17->setObjectName(QStringLiteral("horizontalLayout_17"));
        mcconfReadButton = new QPushButton(tab_11);
        mcconfReadButton->setObjectName(QStringLiteral("mcconfReadButton"));

        horizontalLayout_17->addWidget(mcconfReadButton);

        mcconfReadDefaultButton = new QPushButton(tab_11);
        mcconfReadDefaultButton->setObjectName(QStringLiteral("mcconfReadDefaultButton"));

        horizontalLayout_17->addWidget(mcconfReadDefaultButton);

        mcconfWriteButton = new QPushButton(tab_11);
        mcconfWriteButton->setObjectName(QStringLiteral("mcconfWriteButton"));

        horizontalLayout_17->addWidget(mcconfWriteButton);

        horizontalSpacer_6 = new QSpacerItem(40, 20, QSizePolicy::Expanding, QSizePolicy::Minimum);

        horizontalLayout_17->addItem(horizontalSpacer_6);

        mcconfLoadXmlButton = new QPushButton(tab_11);
        mcconfLoadXmlButton->setObjectName(QStringLiteral("mcconfLoadXmlButton"));

        horizontalLayout_17->addWidget(mcconfLoadXmlButton);

        mcconfSaveXmlButton = new QPushButton(tab_11);
        mcconfSaveXmlButton->setObjectName(QStringLiteral("mcconfSaveXmlButton"));

        horizontalLayout_17->addWidget(mcconfSaveXmlButton);


        verticalLayout_31->addLayout(horizontalLayout_17);

        tabWidget->addTab(tab_11, QString());
        tab_5 = new QWidget();
        tab_5->setObjectName(QStringLiteral("tab_5"));
        verticalLayout_33 = new QVBoxLayout(tab_5);
        verticalLayout_33->setSpacing(6);
        verticalLayout_33->setContentsMargins(11, 11, 11, 11);
        verticalLayout_33->setObjectName(QStringLiteral("verticalLayout_33"));
        tabWidget_3 = new QTabWidget(tab_5);
        tabWidget_3->setObjectName(QStringLiteral("tabWidget_3"));
        tabWidget_3->setTabPosition(QTabWidget::West);
        tab_16 = new QWidget();
        tab_16->setObjectName(QStringLiteral("tab_16"));
        verticalLayout_3 = new QVBoxLayout(tab_16);
        verticalLayout_3->setSpacing(6);
        verticalLayout_3->setContentsMargins(11, 11, 11, 11);
        verticalLayout_3->setObjectName(QStringLiteral("verticalLayout_3"));
        horizontalLayout_5 = new QHBoxLayout();
        horizontalLayout_5->setSpacing(6);
        horizontalLayout_5->setObjectName(QStringLiteral("horizontalLayout_5"));
        groupBox_28 = new QGroupBox(tab_16);
        groupBox_28->setObjectName(QStringLiteral("groupBox_28"));
        gridLayout_29 = new QGridLayout(groupBox_28);
        gridLayout_29->setSpacing(6);
        gridLayout_29->setContentsMargins(11, 11, 11, 11);
        gridLayout_29->setObjectName(QStringLiteral("gridLayout_29"));
        label_65 = new QLabel(groupBox_28);
        label_65->setObjectName(QStringLiteral("label_65"));

        gridLayout_29->addWidget(label_65, 0, 0, 1, 1);

        appconfControllerIdBox = new QSpinBox(groupBox_28);
        appconfControllerIdBox->setObjectName(QStringLiteral("appconfControllerIdBox"));
        appconfControllerIdBox->setMaximum(255);

        gridLayout_29->addWidget(appconfControllerIdBox, 0, 1, 1, 1);


        horizontalLayout_5->addWidget(groupBox_28);

        appconfSendCanStatusBox = new QGroupBox(tab_16);
        appconfSendCanStatusBox->setObjectName(QStringLiteral("appconfSendCanStatusBox"));
        appconfSendCanStatusBox->setCheckable(true);
        appconfSendCanStatusBox->setChecked(false);
        gridLayout_25 = new QGridLayout(appconfSendCanStatusBox);
        gridLayout_25->setSpacing(6);
        gridLayout_25->setContentsMargins(11, 11, 11, 11);
        gridLayout_25->setObjectName(QStringLiteral("gridLayout_25"));
        label_12 = new QLabel(appconfSendCanStatusBox);
        label_12->setObjectName(QStringLiteral("label_12"));

        gridLayout_25->addWidget(label_12, 0, 0, 1, 1);

        appconfSendCanStatusRateBox = new QSpinBox(appconfSendCanStatusBox);
        appconfSendCanStatusRateBox->setObjectName(QStringLiteral("appconfSendCanStatusRateBox"));
        appconfSendCanStatusRateBox->setMaximum(1000);

        gridLayout_25->addWidget(appconfSendCanStatusRateBox, 0, 1, 1, 1);


        horizontalLayout_5->addWidget(appconfSendCanStatusBox);


        verticalLayout_3->addLayout(horizontalLayout_5);

        groupBox_18 = new QGroupBox(tab_16);
        groupBox_18->setObjectName(QStringLiteral("groupBox_18"));
        horizontalLayout_33 = new QHBoxLayout(groupBox_18);
        horizontalLayout_33->setSpacing(6);
        horizontalLayout_33->setContentsMargins(11, 11, 11, 11);
        horizontalLayout_33->setObjectName(QStringLiteral("horizontalLayout_33"));
        gridLayout_22 = new QGridLayout();
        gridLayout_22->setSpacing(6);
        gridLayout_22->setObjectName(QStringLiteral("gridLayout_22"));
        appconfUseUartButton = new QRadioButton(groupBox_18);
        appconfUseUartButton->setObjectName(QStringLiteral("appconfUseUartButton"));

        gridLayout_22->addWidget(appconfUseUartButton, 1, 0, 1, 1);

        appconfUsePpmUartButton = new QRadioButton(groupBox_18);
        appconfUsePpmUartButton->setObjectName(QStringLiteral("appconfUsePpmUartButton"));

        gridLayout_22->addWidget(appconfUsePpmUartButton, 1, 1, 1, 1);

        appconfUseCustomButton = new QRadioButton(groupBox_18);
        appconfUseCustomButton->setObjectName(QStringLiteral("appconfUseCustomButton"));

        gridLayout_22->addWidget(appconfUseCustomButton, 2, 2, 1, 1);

        appconfUseNoAppButton = new QRadioButton(groupBox_18);
        appconfUseNoAppButton->setObjectName(QStringLiteral("appconfUseNoAppButton"));
        appconfUseNoAppButton->setChecked(true);

        gridLayout_22->addWidget(appconfUseNoAppButton, 0, 0, 1, 1);

        appconfUseNrfButton = new QRadioButton(groupBox_18);
        appconfUseNrfButton->setObjectName(QStringLiteral("appconfUseNrfButton"));

        gridLayout_22->addWidget(appconfUseNrfButton, 2, 1, 1, 1);

        appconfUseNunchukButton = new QRadioButton(groupBox_18);
        appconfUseNunchukButton->setObjectName(QStringLiteral("appconfUseNunchukButton"));

        gridLayout_22->addWidget(appconfUseNunchukButton, 2, 0, 1, 1);

        appconfUsePpmButton = new QRadioButton(groupBox_18);
        appconfUsePpmButton->setObjectName(QStringLiteral("appconfUsePpmButton"));

        gridLayout_22->addWidget(appconfUsePpmButton, 0, 1, 1, 1);

        appconfUseAdcButton = new QRadioButton(groupBox_18);
        appconfUseAdcButton->setObjectName(QStringLiteral("appconfUseAdcButton"));

        gridLayout_22->addWidget(appconfUseAdcButton, 0, 2, 1, 1);

        appconfUseAdcUartButton = new QRadioButton(groupBox_18);
        appconfUseAdcUartButton->setObjectName(QStringLiteral("appconfUseAdcUartButton"));

        gridLayout_22->addWidget(appconfUseAdcUartButton, 1, 2, 1, 1);


        horizontalLayout_33->addLayout(gridLayout_22);

        horizontalSpacer_12 = new QSpacerItem(561, 20, QSizePolicy::Expanding, QSizePolicy::Minimum);

        horizontalLayout_33->addItem(horizontalSpacer_12);


        verticalLayout_3->addWidget(groupBox_18);

        groupBox_22 = new QGroupBox(tab_16);
        groupBox_22->setObjectName(QStringLiteral("groupBox_22"));
        gridLayout_18 = new QGridLayout(groupBox_22);
        gridLayout_18->setSpacing(6);
        gridLayout_18->setContentsMargins(11, 11, 11, 11);
        gridLayout_18->setObjectName(QStringLiteral("gridLayout_18"));
        label_52 = new QLabel(groupBox_22);
        label_52->setObjectName(QStringLiteral("label_52"));

        gridLayout_18->addWidget(label_52, 0, 0, 1, 1);

        appconfTimeoutBox = new QSpinBox(groupBox_22);
        appconfTimeoutBox->setObjectName(QStringLiteral("appconfTimeoutBox"));
        appconfTimeoutBox->setMaximum(30000);
        appconfTimeoutBox->setSingleStep(500);

        gridLayout_18->addWidget(appconfTimeoutBox, 0, 1, 1, 1);

        label_53 = new QLabel(groupBox_22);
        label_53->setObjectName(QStringLiteral("label_53"));

        gridLayout_18->addWidget(label_53, 1, 0, 1, 1);

        appconfTimeoutBrakeCurrentBox = new QDoubleSpinBox(groupBox_22);
        appconfTimeoutBrakeCurrentBox->setObjectName(QStringLiteral("appconfTimeoutBrakeCurrentBox"));
        appconfTimeoutBrakeCurrentBox->setMaximum(200);

        gridLayout_18->addWidget(appconfTimeoutBrakeCurrentBox, 1, 1, 1, 1);


        verticalLayout_3->addWidget(groupBox_22);

        verticalSpacer_3 = new QSpacerItem(20, 396, QSizePolicy::Minimum, QSizePolicy::Expanding);

        verticalLayout_3->addItem(verticalSpacer_3);

        tabWidget_3->addTab(tab_16, QString());
        tab_17 = new QWidget();
        tab_17->setObjectName(QStringLiteral("tab_17"));
        verticalLayout_35 = new QVBoxLayout(tab_17);
        verticalLayout_35->setSpacing(6);
        verticalLayout_35->setContentsMargins(11, 11, 11, 11);
        verticalLayout_35->setObjectName(QStringLiteral("verticalLayout_35"));
        groupBox_19 = new QGroupBox(tab_17);
        groupBox_19->setObjectName(QStringLiteral("groupBox_19"));
        horizontalLayout_28 = new QHBoxLayout(groupBox_19);
        horizontalLayout_28->setSpacing(6);
        horizontalLayout_28->setContentsMargins(11, 11, 11, 11);
        horizontalLayout_28->setObjectName(QStringLiteral("horizontalLayout_28"));
        gridLayout_13 = new QGridLayout();
        gridLayout_13->setSpacing(6);
        gridLayout_13->setObjectName(QStringLiteral("gridLayout_13"));
        appconfPpmDutyNorevButton = new QRadioButton(groupBox_19);
        appconfPpmDutyNorevButton->setObjectName(QStringLiteral("appconfPpmDutyNorevButton"));

        gridLayout_13->addWidget(appconfPpmDutyNorevButton, 0, 2, 1, 1);

        appconfPpmDutyButton = new QRadioButton(groupBox_19);
        appconfPpmDutyButton->setObjectName(QStringLiteral("appconfPpmDutyButton"));

        gridLayout_13->addWidget(appconfPpmDutyButton, 0, 1, 1, 1);

        appconfPpmDisabledButton = new QRadioButton(groupBox_19);
        appconfPpmDisabledButton->setObjectName(QStringLiteral("appconfPpmDisabledButton"));
        appconfPpmDisabledButton->setChecked(true);

        gridLayout_13->addWidget(appconfPpmDisabledButton, 0, 0, 1, 1);

        appconfPpmPidNorevButton = new QRadioButton(groupBox_19);
        appconfPpmPidNorevButton->setObjectName(QStringLiteral("appconfPpmPidNorevButton"));

        gridLayout_13->addWidget(appconfPpmPidNorevButton, 1, 3, 1, 1);

        appconfPpmCurrentNorevBrakeButton = new QRadioButton(groupBox_19);
        appconfPpmCurrentNorevBrakeButton->setObjectName(QStringLiteral("appconfPpmCurrentNorevBrakeButton"));

        gridLayout_13->addWidget(appconfPpmCurrentNorevBrakeButton, 1, 1, 1, 1);

        appconfPpmCurrentButton = new QRadioButton(groupBox_19);
        appconfPpmCurrentButton->setObjectName(QStringLiteral("appconfPpmCurrentButton"));
        appconfPpmCurrentButton->setChecked(false);

        gridLayout_13->addWidget(appconfPpmCurrentButton, 0, 3, 1, 1);

        appconfPpmCurrentNorevButton = new QRadioButton(groupBox_19);
        appconfPpmCurrentNorevButton->setObjectName(QStringLiteral("appconfPpmCurrentNorevButton"));

        gridLayout_13->addWidget(appconfPpmCurrentNorevButton, 1, 0, 1, 1);

        appconfPpmPidButton = new QRadioButton(groupBox_19);
        appconfPpmPidButton->setObjectName(QStringLiteral("appconfPpmPidButton"));

        gridLayout_13->addWidget(appconfPpmPidButton, 1, 2, 1, 1);


        horizontalLayout_28->addLayout(gridLayout_13);

        horizontalSpacer_10 = new QSpacerItem(411, 20, QSizePolicy::Expanding, QSizePolicy::Minimum);

        horizontalLayout_28->addItem(horizontalSpacer_10);


        verticalLayout_35->addWidget(groupBox_19);

        groupBox_20 = new QGroupBox(tab_17);
        groupBox_20->setObjectName(QStringLiteral("groupBox_20"));
        gridLayout_17 = new QGridLayout(groupBox_20);
        gridLayout_17->setSpacing(6);
        gridLayout_17->setContentsMargins(11, 11, 11, 11);
        gridLayout_17->setObjectName(QStringLiteral("gridLayout_17"));
        appconfPpmMedianFilterBox = new QCheckBox(groupBox_20);
        appconfPpmMedianFilterBox->setObjectName(QStringLiteral("appconfPpmMedianFilterBox"));

        gridLayout_17->addWidget(appconfPpmMedianFilterBox, 4, 0, 1, 1);

        label_51 = new QLabel(groupBox_20);
        label_51->setObjectName(QStringLiteral("label_51"));

        gridLayout_17->addWidget(label_51, 3, 0, 1, 1);

        appconfPpmPidMaxErpmBox = new QDoubleSpinBox(groupBox_20);
        appconfPpmPidMaxErpmBox->setObjectName(QStringLiteral("appconfPpmPidMaxErpmBox"));
        appconfPpmPidMaxErpmBox->setMaximum(200000);
        appconfPpmPidMaxErpmBox->setSingleStep(100);

        gridLayout_17->addWidget(appconfPpmPidMaxErpmBox, 0, 1, 1, 1);

        label_49 = new QLabel(groupBox_20);
        label_49->setObjectName(QStringLiteral("label_49"));

        gridLayout_17->addWidget(label_49, 1, 0, 1, 1);

        appconfPpmPulseStartBox = new QDoubleSpinBox(groupBox_20);
        appconfPpmPulseStartBox->setObjectName(QStringLiteral("appconfPpmPulseStartBox"));
        appconfPpmPulseStartBox->setMaximum(10);
        appconfPpmPulseStartBox->setSingleStep(0.1);

        gridLayout_17->addWidget(appconfPpmPulseStartBox, 2, 1, 1, 1);

        label_50 = new QLabel(groupBox_20);
        label_50->setObjectName(QStringLiteral("label_50"));

        gridLayout_17->addWidget(label_50, 2, 0, 1, 1);

        appconfPpmPulseWidthBox = new QDoubleSpinBox(groupBox_20);
        appconfPpmPulseWidthBox->setObjectName(QStringLiteral("appconfPpmPulseWidthBox"));
        appconfPpmPulseWidthBox->setMaximum(20);
        appconfPpmPulseWidthBox->setSingleStep(0.1);

        gridLayout_17->addWidget(appconfPpmPulseWidthBox, 3, 1, 1, 1);

        label_45 = new QLabel(groupBox_20);
        label_45->setObjectName(QStringLiteral("label_45"));

        gridLayout_17->addWidget(label_45, 0, 0, 1, 1);

        appconfPpmHystBox = new QDoubleSpinBox(groupBox_20);
        appconfPpmHystBox->setObjectName(QStringLiteral("appconfPpmHystBox"));
        appconfPpmHystBox->setMaximum(1);
        appconfPpmHystBox->setSingleStep(0.05);

        gridLayout_17->addWidget(appconfPpmHystBox, 1, 1, 1, 1);

        appconfPpmSafeStartBox = new QCheckBox(groupBox_20);
        appconfPpmSafeStartBox->setObjectName(QStringLiteral("appconfPpmSafeStartBox"));

        gridLayout_17->addWidget(appconfPpmSafeStartBox, 5, 0, 1, 1);


        verticalLayout_35->addWidget(groupBox_20);

        appconfPpmRpmLimBox = new QGroupBox(tab_17);
        appconfPpmRpmLimBox->setObjectName(QStringLiteral("appconfPpmRpmLimBox"));
        appconfPpmRpmLimBox->setCheckable(true);
        appconfPpmRpmLimBox->setChecked(false);
        gridLayout_20 = new QGridLayout(appconfPpmRpmLimBox);
        gridLayout_20->setSpacing(6);
        gridLayout_20->setContentsMargins(11, 11, 11, 11);
        gridLayout_20->setObjectName(QStringLiteral("gridLayout_20"));
        appconfPpmRpmLimStartBox = new QDoubleSpinBox(appconfPpmRpmLimBox);
        appconfPpmRpmLimStartBox->setObjectName(QStringLiteral("appconfPpmRpmLimStartBox"));
        appconfPpmRpmLimStartBox->setMaximum(200000);
        appconfPpmRpmLimStartBox->setSingleStep(100);

        gridLayout_20->addWidget(appconfPpmRpmLimStartBox, 0, 1, 1, 1);

        label_47 = new QLabel(appconfPpmRpmLimBox);
        label_47->setObjectName(QStringLiteral("label_47"));

        gridLayout_20->addWidget(label_47, 0, 0, 1, 1);

        label_48 = new QLabel(appconfPpmRpmLimBox);
        label_48->setObjectName(QStringLiteral("label_48"));

        gridLayout_20->addWidget(label_48, 1, 0, 1, 1);

        appconfPpmRpmLimEndBox = new QDoubleSpinBox(appconfPpmRpmLimBox);
        appconfPpmRpmLimEndBox->setObjectName(QStringLiteral("appconfPpmRpmLimEndBox"));
        appconfPpmRpmLimEndBox->setMaximum(200000);
        appconfPpmRpmLimEndBox->setSingleStep(100);

        gridLayout_20->addWidget(appconfPpmRpmLimEndBox, 1, 1, 1, 1);


        verticalLayout_35->addWidget(appconfPpmRpmLimBox);

        appconfPpmMultiGroup = new QGroupBox(tab_17);
        appconfPpmMultiGroup->setObjectName(QStringLiteral("appconfPpmMultiGroup"));
        appconfPpmMultiGroup->setCheckable(true);
        appconfPpmMultiGroup->setChecked(false);
        horizontalLayout_37 = new QHBoxLayout(appconfPpmMultiGroup);
        horizontalLayout_37->setSpacing(6);
        horizontalLayout_37->setContentsMargins(11, 11, 11, 11);
        horizontalLayout_37->setObjectName(QStringLiteral("horizontalLayout_37"));
        appconfPpmTcBox = new QCheckBox(appconfPpmMultiGroup);
        appconfPpmTcBox->setObjectName(QStringLiteral("appconfPpmTcBox"));
        appconfPpmTcBox->setChecked(false);

        horizontalLayout_37->addWidget(appconfPpmTcBox);

        horizontalSpacer_14 = new QSpacerItem(40, 20, QSizePolicy::Expanding, QSizePolicy::Minimum);

        horizontalLayout_37->addItem(horizontalSpacer_14);

        label_67 = new QLabel(appconfPpmMultiGroup);
        label_67->setObjectName(QStringLiteral("label_67"));

        horizontalLayout_37->addWidget(label_67);

        appconfPpmTcErpmBox = new QDoubleSpinBox(appconfPpmMultiGroup);
        appconfPpmTcErpmBox->setObjectName(QStringLiteral("appconfPpmTcErpmBox"));
        appconfPpmTcErpmBox->setMaximum(100000);
        appconfPpmTcErpmBox->setValue(3000);

        horizontalLayout_37->addWidget(appconfPpmTcErpmBox);


        verticalLayout_35->addWidget(appconfPpmMultiGroup);

        appconfUpdatePpmBox = new QGroupBox(tab_17);
        appconfUpdatePpmBox->setObjectName(QStringLiteral("appconfUpdatePpmBox"));
        appconfUpdatePpmBox->setCheckable(true);
        appconfUpdatePpmBox->setChecked(false);
        gridLayout_19 = new QGridLayout(appconfUpdatePpmBox);
        gridLayout_19->setSpacing(6);
        gridLayout_19->setContentsMargins(11, 11, 11, 11);
        gridLayout_19->setObjectName(QStringLiteral("gridLayout_19"));
        appconfDecodedPpmBar = new QProgressBar(appconfUpdatePpmBox);
        appconfDecodedPpmBar->setObjectName(QStringLiteral("appconfDecodedPpmBar"));
        appconfDecodedPpmBar->setMinimum(0);
        appconfDecodedPpmBar->setMaximum(1000);
        appconfDecodedPpmBar->setValue(0);

        gridLayout_19->addWidget(appconfDecodedPpmBar, 0, 0, 1, 1);

        appconfPpmPulsewidthNumber = new QLCDNumber(appconfUpdatePpmBox);
        appconfPpmPulsewidthNumber->setObjectName(QStringLiteral("appconfPpmPulsewidthNumber"));

        gridLayout_19->addWidget(appconfPpmPulsewidthNumber, 0, 2, 1, 1);

        label_80 = new QLabel(appconfUpdatePpmBox);
        label_80->setObjectName(QStringLiteral("label_80"));

        gridLayout_19->addWidget(label_80, 0, 1, 1, 1);


        verticalLayout_35->addWidget(appconfUpdatePpmBox);

        verticalSpacer_6 = new QSpacerItem(20, 221, QSizePolicy::Minimum, QSizePolicy::Expanding);

        verticalLayout_35->addItem(verticalSpacer_6);
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
