psas/lv3.0-recovery/Control_System/bldc-tool/qrc_resources.cpp

/****************************************************************************
** Resource object code
**
** Created by: The Resource Compiler for Qt version 5.5.1
**
** WARNING! All changes made in this file will be lost!
*****************************************************************************/

static const unsigned char qt_resource_data[] = {
  // /home/e/BLDC/bldc-tool/res/refresh.png
  0x0,0x0,0x8,0x99,
  0x89,
  0x50,0x4e,0x47,0xd,0xa,0x1a,0xa,0x0,0x0,0x0,0xd,0x49,0x48,0x44,0x52,0x0,
  0x0,0x0,0x80,0x0,0x0,0x0,0x80,0x8,0x6,0x0,0x0,0x0,0xc3,0x3e,0x61,0xcb,
  0x0,0x0,0x0,0x4,0x73,0x42,0x49,0x54,0x8,0x8,0x8,0x8,0x7c,0x8,0x64,0x88,
  0x0,0x0,0x0,0x9,0x70,0x48,0x59,0x73,0x0,0x0,0xb,0x13,0x0,0x0,0xb,0x13,
  0x1,0x0,0x9a,0x9c,0x18,0x0,0x0,0x8,0x3b,0x49,0x44,0x41,0x54,0x78,0x9c,0xed,
  0x9d,0x59,0x8c,0x55,0x45,0x10,0x40,0x8f,0xc8,0xea,0x20,0xc1,0x38,0x18,0xb6,0xb8,
  0x22,0xb8,0x81,0xb8,0xa1,0xa8,0x4,0x11,0x35,0x42,0x24,0xa0,0xa2,0x2,0x41,0x25,
  0x11,0xe2,0xbe,0x83,0x91,0xf,0x35,0x68,0x48,0xfc,0x30,0x46,0x3f,0xdc,0xc1,0x85,
  0x4,0x62,0xdc,0x89,0x1a,0x36,0x17,0x40,0x9,0x12,0xc5,0x28,0x28,0xb8,0x21,0x20,
  0x88,0x80,0x20,0x32,0x33,0x88,0xc,0x9b,0x1f,0x35,0x24,0x3,0xbc,0xf1,0xdd,0x79,
  0x5d,0xdd,0x7d,0xef,0xbb,0x75,0x92,0xfa,0x82,0xfb,0x6e,0x55,0x75,0x4d,0xf7,0xed,
  0xee,0xea,0x6a,0x30,0xc,0xc3,0x30,0xc,0xc3,0x30,0xc,0xc3,0x30,0xc,0xc3,0x30,
  0xc,0xc3,0x30,0xc,0xc3,0x30,0xc,0xc3,0x30,0xc,0xa3,0xdc,0x38,0x24,0xb6,0x2,
  0xe,0x1c,0x5,0xf4,0x0,0x4e,0x3,0x4e,0x0,0x8e,0x5,0x3a,0x2,0x95,0x40,0x5b,
  0xa0,0x25,0xd0,0xc,0xd8,0x3,0xd4,0x2,0xdb,0x80,0x2d,0xc0,0x26,0x60,0xd,0xb0,
  0x1a,0xf8,0x11,0xf8,0x1e,0x58,0x5a,0xf7,0xef,0xb9,0x23,0x4b,0x1,0xd0,0x9,0xb8,
  0x1c,0xe8,0x7,0x5c,0x80,0x34,0xb8,0x16,0xbb,0x81,0xef,0x80,0x5,0xc0,0x47,0xc0,
  0x27,0xc0,0x56,0xc5,0xdf,0x37,0x4a,0xe4,0x78,0x60,0x3c,0xf0,0x35,0xb0,0x37,0xa0,
  0xd4,0x2,0xb3,0x80,0x31,0x48,0x6f,0x62,0x4,0xa4,0x19,0x30,0xc,0xf8,0x14,0xe9,
  0xbe,0x43,0x36,0x7c,0x21,0xf9,0x17,0x78,0x1d,0xe8,0xeb,0xd3,0x68,0x3,0xe,0x7,
  0xc6,0x1,0x6b,0x89,0xdf,0xe8,0xd,0xc9,0x37,0xc0,0x8,0xe0,0x50,0x4f,0x3e,0xc8,
  0x25,0x2d,0x81,0xb1,0xc0,0x9f,0xc4,0x6f,0xe0,0xa4,0xf2,0x13,0x70,0x1d,0xd9,0xfa,
  0x86,0x4a,0x25,0x43,0x81,0x95,0xc4,0x6f,0xd0,0x52,0x65,0x11,0x70,0x8e,0xba,0x57,
  0x72,0xc0,0xd1,0xc0,0xc,0xe2,0x37,0xa0,0x86,0xec,0x6,0x9e,0x45,0x86,0x30,0x23,
  0x1,0x37,0x1,0xd5,0xc4,0x6f,0x38,0x6d,0x59,0x85,0x4c,0x51,0x8d,0x6,0x68,0x3,
  0xbc,0x49,0xfc,0x86,0xf2,0xdd,0x1b,0x3c,0x8a,0x7d,0x24,0x1e,0xc4,0xc9,0xc0,0xf,
  0xc4,0x6f,0xa0,0x50,0x32,0x7,0x38,0x42,0xc5,0x73,0x65,0xc0,0xa5,0xc8,0xaa,0x5a,
  0xec,0x46,0x9,0x2d,0x3f,0x3,0x27,0x2a,0xf8,0x2f,0xd3,0x5c,0x8f,0xac,0xaa,0xc5,
  0x6e,0x8c,0x58,0xb2,0x91,0x1c,0xcf,0x12,0x6e,0x21,0x1d,0x2b,0x79,0xb1,0xa5,0xa,
  0xd9,0xbb,0xc8,0x15,0x37,0x13,0xdf,0xf1,0x69,0x92,0x6a,0xa0,0xb7,0x93,0x47,0x3d,
  0xe1,0x63,0x25,0x6b,0x24,0x30,0xc5,0xd3,0x6f,0x27,0x61,0x27,0xb2,0xe5,0xbb,0x15,
  0x19,0x7e,0x5a,0x0,0x15,0x40,0x6b,0xe2,0x6e,0xec,0x6c,0x41,0xf6,0x13,0x96,0x46,
  0xd4,0xe1,0x20,0xb4,0x1b,0xa9,0x3f,0xb2,0xc0,0xd3,0x4c,0xf9,0x77,0x1b,0x62,0x3d,
  0x30,0xf,0xf8,0x2,0xf8,0x16,0xd9,0xdf,0xff,0x3,0xf9,0xab,0x2b,0x44,0x5,0xd0,
  0xa5,0x4e,0xce,0x1,0xfa,0x0,0x67,0x3,0xcd,0xbd,0x6b,0x2a,0xfc,0xe,0xf4,0x2,
  0xd6,0x5,0x7a,0x5f,0x50,0xba,0x1,0x7f,0xe3,0xbf,0x3b,0x5d,0x9,0x4c,0x4,0xce,
  0x44,0x27,0x80,0x5b,0x1,0x57,0x3,0x6f,0x20,0x49,0x21,0xbe,0xf5,0xff,0xaa,0xee,
  0x9d,0x65,0x45,0x6b,0x60,0x19,0x7e,0x1d,0x37,0x13,0x49,0x8,0xf1,0x39,0xb4,0xb4,
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
  
};

static const unsigned char qt_resource_name[] = {
  // res
  0x0,0x3,
  0x0,0x0,0x78,0xc3,
  0x0,0x72,
  0x0,0x65,0x0,0x73,
    // refresh.png
  0x0,0xb,
  0xc,0x6a,0x2c,0x47,
  0x0,0x72,
  0x0,0x65,0x0,0x66,0x0,0x72,0x0,0x65,0x0,0x73,0x0,0x68,0x0,0x2e,0x0,0x70,0x0,0x6e,0x0,0x67,
  
};

static const unsigned char qt_resource_struct[] = {
  // :
  0x0,0x0,0x0,0x0,0x0,0x2,0x0,0x0,0x0,0x1,0x0,0x0,0x0,0x1,
  // :/res
  0x0,0x0,0x0,0x0,0x0,0x2,0x0,0x0,0x0,0x1,0x0,0x0,0x0,0x2,
  // :/res/refresh.png
  0x0,0x0,0x0,0xc,0x0,0x0,0x0,0x0,0x0,0x1,0x0,0x0,0x0,0x0,

};

#ifdef QT_NAMESPACE
#  define QT_RCC_PREPEND_NAMESPACE(name) ::QT_NAMESPACE::name
#  define QT_RCC_MANGLE_NAMESPACE0(x) x
#  define QT_RCC_MANGLE_NAMESPACE1(a, b) a##_##b
#  define QT_RCC_MANGLE_NAMESPACE2(a, b) QT_RCC_MANGLE_NAMESPACE1(a,b)
#  define QT_RCC_MANGLE_NAMESPACE(name) QT_RCC_MANGLE_NAMESPACE2( \
        QT_RCC_MANGLE_NAMESPACE0(name), QT_RCC_MANGLE_NAMESPACE0(QT_NAMESPACE))
#else
#   define QT_RCC_PREPEND_NAMESPACE(name) name
#   define QT_RCC_MANGLE_NAMESPACE(name) name
#endif

#ifdef QT_NAMESPACE
namespace QT_NAMESPACE {
#endif

bool qRegisterResourceData(int, const unsigned char *, const unsigned char *, const unsigned char *);

bool qUnregisterResourceData(int, const unsigned char *, const unsigned char *, const unsigned char *);

#ifdef QT_NAMESPACE
}
#endif

int QT_RCC_MANGLE_NAMESPACE(qInitResources_resources)();
int QT_RCC_MANGLE_NAMESPACE(qInitResources_resources)()
{
    QT_RCC_PREPEND_NAMESPACE(qRegisterResourceData)
        (0x01, qt_resource_struct, qt_resource_name, qt_resource_data);
    return 1;
}

int QT_RCC_MANGLE_NAMESPACE(qCleanupResources_resources)();
int QT_RCC_MANGLE_NAMESPACE(qCleanupResources_resources)()
{
    QT_RCC_PREPEND_NAMESPACE(qUnregisterResourceData)
       (0x01, qt_resource_struct, qt_resource_name, qt_resource_data);
    return 1;
}

namespace {
   struct initializer {
       initializer() { QT_RCC_MANGLE_NAMESPACE(qInitResources_resources)(); }
       ~initializer() { QT_RCC_MANGLE_NAMESPACE(qCleanupResources_resources)(); }
   } dummy;
}
