psas/lv3.0-recovery/(commit log)

2016-07-29 First additions to the repo
    [Telemetry_data.csv]
2016-07-31 Having troubles with telemetry data. Need to find LV2 terminal velocity.
2016-08-24 Organizing, adding pics..why are a couple of pics automatically rotated?????? >:(
2016-09-06 Adding SW drawing of attachment ring
2016-09-06 Added Spring Ring CAD and Drawing
    [Spring_Ring_r4.dwg, Spring_Ring_r4.stp]
2016-09-06 Updated ring; removed v-band notch per Jorden
    [Spring_Ring_r5.dwg, Spring_Ring_r5.stp]
2016-09-07 The SW files are actually in here this time..
    [Ring_lv3.0-recovery.SLDPRT, Ring_lv3.0-recovery.STEP]
2016-10-17 Added tech drawing for ring r5; Still needed: tubing hole dimensioning, selection of tolerances, slip fit definition
    [Ring_Spring_r5.sldprt, Spring_Ring_r5.SLDASM, Spring_Ring_r5.SLDPRT, Spring_Ring_r5_TechDrawing.SLDDRW]
2016-10-18 Added prelim drawing of spring ring r5
    [Spring_Ring_r5_TechDrawing.SLDDRW, Spring_Ring_r5_TechDrawingB.SLDDRW]
2016-11-07 Yay made the spring ring simpler and easier and more reliable
    [Spring_Ring_r6.stp]
2017-01-10 Start of overview notebook. Cropped some photos
    [Ring_lv3.0-recovery_drw.SLDDRW]
2017-01-10 worked on overview notebook
    [Ring_lv3.0-recovery.SLDPRT]
2017-01-29 main line finished, error feedback set up, fail-safe created
    [eNSR_Control_code.c]
2017-06-17 Started line cutter model in SW
    [Line_Cutter.SLDPRT]
2017-09-02 made a nice chart of the system's trajectory
    Assuming there are no cross winds, you can input the wind velocity at
    the start, run the notebook, and get a chart of the trajectory (relative
    to the drop point) at the bottom of the notebook.
2017-09-02 added cross-wind and compass coordinate stuff
    Input the aircraft and wind bearing at the top of the notebook. Restart
    the kernel and run all cells. look a the charts at the end of the
    notebook. That will tell you the predicted trajectory of the system.
2017-09-04 Add files via upload
    Linux GUI interface for VESC
    [separation_motor.xml, separation_motor_BLDC.xml, separation_motor_FOC.xml, separation_motor_advanced.xml]
2017-09-04 Allows you to update firmware from bldc GUI in linux
2017-09-04 Firmware for VESC +custom application
2017-09-22 Just making sure everything is up-to-date
    [To_Do_List.xlsx]
2018-02-14 Added plate for the VESC motor controller. Originally lasercut out of acrylic, but then realized we wanted an FR4 board so that's what we did! Made on the A4 with Haneef's help.
    [vesc-plate.brd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]
2018-02-24 Adding eNSR Cap (CAD by John and Marie)
    [eNSR_cap.3.SLDPRT, eNSR_cap.3.STEP, eNSR_cap.3.STL]
2018-02-24 Spring ring update from 2016... never pushed
    [Ring_Spring_r5.sldprt, Spring_Ring_r4.dwg, Spring_Ring_r4.stp, Spring_Ring_r5.SLDASM, Spring_Ring_r5.SLDPRT, Spring_Ring_r5.dwg, Spring_Ring_r5.stp, Spring_Ring_r5_TechDrawing.SLDDRW]
2018-04-12 Added LV2C Line cutter documentation from old PSAS archive. Markdown probably broken, so somebody please go and clean it up.
    [LineCutterSheildPlate_Lv2c.dxf, PlugLineCutter-v2c.dxf]
2018-12-27 Organizing in prep for Capstone 2018-19
    [LineCutterSheildPlate_Lv2c.dxf, PlugLineCutter-v2c.dxf, Ring_lv3.0-recovery.SLDPRT, Ring_lv3.0-recovery.STEP, Ring_lv3.0-recovery_drw.SLDDRW, Telemetry_data.csv, To_Do_List.xlsx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]
2019-01-26 rocket recovery prototype
    [ball baring.SLDPRT, inner ring Rocket Shute deployment.SLDPRT, keeper ring2.SLDPRT, outer ring rocket shute deployment.SLDPRT, proto for capstone.SLDASM]
2019-02-17 Uploading CAD files and Surgical Tubing Pull Test
    [Alignment_Pins.SLDPRT, Assem1.SLDASM, Assem1.SLDPRT, Carriage.SLDPRT, Clamp_Ring_Concept.SLDPRT, Concept_Assem_2.SLDASM, Concept_Lower.SLDPRT, Concept_Ring.SLDASM]
2019-02-17 Created Assembly for 2nd Concept, deleted files non needed
    [Assem1.SLDASM, Assem1.SLDPRT, Bearing_RMA.SLDPRT, Clamp_Ring_Concept.SLDPRT, Concept_Assem_2.SLDASM, Dowell_Pin_1.SLDPRT, Inner_Arc.SLDPRT, Linkage.sldprt]
2019-02-17 Updated assembly with motor based on old eNSR
    [Complete_Assembly.SLDASM, Concept_Assem_2.SLDASM, Lower_Ring.SLDPRT, Lower_Ring_REF_Assem.SLDASM, Motor1_small.SLDPRT, Upper_Ring_Carriage_Clamps.SLDASM]
2019-02-18 started drogue release/main deployment folder
    [Complete_Assembly.SLDASM, Motor1_small.SLDPRT]
2019-02-18 added drogue release/main deployment folder
    [92141A029_TYPE 18-8 STAINLESS STEEL FLAT WASHER.SLDPRT, 92620A540_HIGH-STRENGTH GRADE 8 STEEL CAP SCREW.SLDPRT, 92620A542_HIGH-STRENGTH GRADE 8 STEEL CAP SCREW.SLDPRT, 92620A544_HIGH-STRENGTH GRADE 8 STEEL CAP SCREW.SLDPRT, 9657K319_STEEL COMPRESSION SPRING.SLDPRT, 9657K486_COMPRESSION SPRING.SLDPRT, 9657K528_COMPRESSION SPRING.SLDPRT, Proto1.SLDASM]
2019-02-19 adding chute cups
    [Cup_Chute_Drogue^eNSR_v2.2.SLDPRT, Cylinder_Chute_Main^eNSR_v2.2.SLDPRT]
2019-02-22 updated nose cone seperation rings
    [Bottom_ring.SLDPRT, Top_ring.SLDPRT, ball baring.SLDPRT, full_size_proto.SLDASM, inner ring Rocket Shute deployment.SLDPRT, inner_ring_rsd2.SLDPRT, keeper ring2.SLDPRT, kepper ring.SLDPRT]
2019-02-26 adding CAD files mainly for 3 ring release design
    [3-ring_assy.SLDASM, 3-ring_dimensions.SLDDRW, 3-ring_ratio.SLDDRW, 6873K110_COMPACT LINEAR SOLENOID.SLDPRT, 6873K310_COMPACT LINEAR SOLENOID.SLDPRT, 6873K610_COMPACT LINEAR SOLENOID.SLDPRT, 69905K110_SEALED LINEAR SOLENOID.SLDPRT, 91292A122_TYPE 18-8 SS SOCKET HEAD CAP SCREW.SLDPRT]
2019-02-27 changing place of nose cone files
    [Nose_cone_bot.SLDPRT, Nose_cone_bot.STL, Nose_cone_mid.SLDPRT, Nose_cone_mid.STL, Nose_cone_top.1.SLDPRT, Nose_cone_top.1.STL, Nose_cone_top.2.SLDPRT, Nose_cone_top.2.STL]
2019-03-05 Added CFD simulations for screw profiles
2019-03-07 Added Gabe's latest CAD
    [Assem2.SLDASM, Bottom_ring.SLDPRT, Top_ring.SLDPRT, kepper ring.SLDPRT, moduleRing_flat.SLDPRT, twist_coupling.SLDPRT]
2019-03-17 Worked on system architecture assembly for Base 11 report
    [2994T410_FORGED STL HOIST RING FOR LIFTING.SLDPRT, 2994T630_FORGED STL HOIST RING FOR LIFTING.SLDPRT, 3-ring_assy.SLDASM, 3-ring_ratio.SLDDRW, 3014T510_STEEL EYEBOLT WITH SHOULDER - FOR LIFTING.SLDPRT, 7880K450_HT-LOAD MTL GEAR--20 DEG PRESSURE ANGLE.SLDPRT, 9434K154_MUSIC-WIRE STEEL COMPRESSION SPRINGS.SLDPRT, 94895A827_ZINC YELLOW-CHROMATE PLATED STEEL HEX NUT.SLDPRT]
2019-03-18 CFD for Camera Ring + Updated assembly
    [7880K450_HT-LOAD MTL GEAR--20 DEG PRESSURE ANGLE.SLDPRT, 7880K450_HT-LOAD MTL GEAR--20 DEG PRESSURE ANGLE.STL, Assem2.SLDASM, Bottom_ring.SLDPRT, Bottom_ring.STL, Bottom_ring_1.SLDPRT, Current_NCSR.SLDASM, Motor1_small.SLDPRT]
2019-03-19 Update ST ring
    [ST_Ring.SLDPRT]
2019-04-02 Made changes to bottom ring and ST ring
    [Base11_NCSR.SLDASM, Bottom_ring.SLDPRT, Cup_Chute_Drogue^eNSR_v2.2.SLDPRT, Current_NCSR.SLDASM, ST_Ring.SLDPRT, Sys_architecture.SLDASM, drogue_chute.SLDPRT, kepper ring - Base 11.SLDPRT]
2019-04-04 Mainly changes to the 3-ring CAD, little bit of change within the NCSR assembly
    [3-ring_assy.SLDASM, Base11_NCSR.SLDASM, Current_NCSR.SLDASM, Sys_architecture.SLDASM, Webbing_mid.SLDPRT, Webbing_top.SLDPRT, grommet_webbing.SLDPRT, nylon_loop.1.SLDPRT]
2019-04-04 added motor and base assymbly
    [Assem2.SLDASM, Base11_NCSR.SLDASM, Bottom_ring.SLDDRW, Bottom_ring.STEP, Current_NCSR.SLDASM, Top_ring.SLDDRW, Top_ring.STEP, keeper ring A.SLDPRT]
2019-04-04 Made edits to 3 ring CAD
    [3-ring_assy.SLDASM, grommet_webbing.SLDPRT, nylon_loop.1.SLDPRT]
2019-04-04 Inserted motor mount brkt into current_ncsr assy
    [Current_NCSR.SLDASM]
2019-04-04 Making sure any new CAD updates are pushed
    [Bottom_ring.SLDDRW, Bottom_ring.SLDPRT, Bottom_ring.STEP, Current_NCSR.SLDASM, Top_ring.SLDPRT, Top_ring.STEP, keeper ring_toMachine.SLDPRT, keeper ring_toMachine.STEP]
2019-04-05 added drawings and part edits per machine shop request
    [Bottom_ring.SLDDRW, Bottom_ring.SLDPRT, Top_ring.SLDDRW, Top_ring.SLDPRT, keeper ring A.SLDDRW, twist_coupling.SLDDRW, twist_coupling.SLDPRT, twist_coupling_toMachine.SLDPRT]
2019-04-05 Modeled the BLDC motor, modified the motor mounting bracket and updated assemblies
    [BLDC_Gear_Motor_100rpm.SLDPRT, Current_NCSR.SLDASM, motor base plate assembly.SLDASM, motor bracket.SLDPRT]
2019-04-05 Changed bottom ring and ST ring to be two parts again. This MUST happen so that the parts may be machined!
    [Base11_NCSR.SLDASM, Bottom_ring_2.SLDPRT, Bottom_ring_assy.SLDASM, Current_NCSR.SLDASM, ST_Ring.SLDPRT, Sys_architecture.SLDASM, Top_ring.SLDPRT]
2019-04-05 Made bottom ring and ST ring separate parts again. This is needed for machining.
    [Sys_architecture.SLDASM]
2019-04-05 making sure all CAD is up-to-date
    [Bottom_ring_2.STEP, Current_NCSR.SLDASM, motor base plate assembly.SLDASM]
2019-04-06 File organizing
    [2994T410_FORGED STL HOIST RING FOR LIFTING.SLDPRT, 2994T630_FORGED STL HOIST RING FOR LIFTING.SLDPRT, 3-ring_assy.SLDASM, 3-ring_dimensions.SLDDRW, 3-ring_ratio.SLDDRW, 3014T510_STEEL EYEBOLT WITH SHOULDER - FOR LIFTING.SLDPRT, 6873K110_COMPACT LINEAR SOLENOID.SLDPRT, 6873K310_COMPACT LINEAR SOLENOID.SLDPRT]
2019-04-07 File organizing and drawing finalizing
    [3-ring_assy.SLDASM, 3-ring_dimensions.SLDDRW, 3-ring_ratio.SLDDRW, 6873K110_COMPACT LINEAR SOLENOID.SLDPRT, 6873K310_COMPACT LINEAR SOLENOID.SLDPRT, 6873K610_COMPACT LINEAR SOLENOID.SLDPRT, 69905K110_SEALED LINEAR SOLENOID.SLDPRT, 91292A122_TYPE 18-8 SS SOCKET HEAD CAP SCREW.SLDPRT]
2019-04-11 making sure everything is up-to-date
    [3-ring_assy.SLDASM, Complete_Assembly.SLDASM, Lower_Ring.SLDPRT, Lower_Ring_REF_Assem.SLDASM, Motor1_small.SLDPRT, NCS_V3.SLDASM, Sys_architecture.SLDASM, Upper_Ring_Carriage_Clamps.SLDASM]
2019-04-12 Added pizza table and files for testing DCR
    [3-ring_dimensions.SLDDRW, NCS_V3.SLDASM, Sys_architecture.SLDASM, keeper_assy_V3.SLDASM, lower_ring_V3.SLDPRT, motor_bracket_sheetmetal_V3.SLDPRT, motor_bracket_small_V3.SLDPRT, motor_housing.SLDPRT]
2019-04-12 getting up-to-date
    [95610A330_NYLON FLAT WASHER.SLDPRT, NCS_V3.SLDASM, Sys_architecture.SLDASM, keeper_assy_V3.SLDASM, motor_assy.SLDASM, motor_brkt.SLDPRT, nose.SLDASM, spindle.SLDPRT]
2019-04-12 motor mount work for NCS and DCR
    [NCS_V3.SLDASM, Sys_architecture.SLDASM, keeper_assy_V3.SLDASM, motor_bracket_sheetmetal_V3.SLDPRT, motor_bracket_small_V3.SLDPRT, motor_housing.SLDPRT, pizza_table.1.SLDPRT]
2019-04-14 motor mnt design, pizza table design, 3 ring design edits
    [2949T380_316 SS HOIST RING FOR LIFTING.SLDPRT, 3-ring_assy.1.SLDASM, 3-ring_assy.SLDASM, 8891T790_316 STAINLESS STEEL EYEBOLT.SLDPRT, NCS_V3.SLDASM, No.10_ring.SLDPRT, No.3_ring.SLDPRT, No.4_ring.SLDPRT]
2019-04-16 Added radii to nubs due to interference
    [NCS_V3.SLDASM, keeper_assy_V3.SLDASM, motor_assy.SLDASM, spindle_small.SLDPRT, spindle_small.STL, upper_ring_V3.SLDPRT, upper_ring_assy.SLDASM]
2019-04-27 working on DCR
    [3-ring_assy.SLDASM, 3-ring_assy_V1.SLDASM, 3014T520_STEEL EYEBOLT WITH SHOULDER - FOR LIFTING.SLDPRT, 3026T110_SHACKLE HOIST RING FOR LIFTING.SLDPRT, 7691T250_NYLON-COATED EYEBOLT.SLDPRT, H3860S_NO3_Ring.SLDPRT, H3880S_NO4_Ring.SLDPRT, NCS_V3.SLDASM]
2019-04-28 Added mockup with fasteners + ST_CAP
    [4-40x0.3125_82degCSK_flatHex_91253A107_ALLOY STEEL FLAT-HEAD SOCKET CAP SCREW.SLDPRT, 7880K450_HT-LOAD MTL GEAR--20 DEG PRESSURE ANGLE.SLDPRT, 90585A358_TYPE 316 SS FLAT-HEAD SOCKET CAP SCREW.SLDPRT, 91253A112_ALLOY STEEL FLAT-HEAD SOCKET CAP SCREW.SLDPRT, 91263A556_ZINC-PLATED ALLOY STEEL FLAT-HEAD CAP SCREW.SLDPRT, 95610A330_NYLON FLAT WASHER.SLDPRT, BLDC_Gear_Motor_100rpm.SLDPRT, Cup_Chute_Dro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]
2019-04-30 updates to 3 ring assembly
    [3-ring_assy.SLDASM, 3-ring_assy_V1.SLDASM, H3860S_NO3_Ring.SLDPRT, H3880S_NO4_Ring.SLDPRT, Webbing_main.SLDPRT, Webbing_mid.SLDPRT, grommet.SLDPRT, grommet_V1.SLDPRT]
2019-05-02 Arduino code files added for parachute testing
2019-05-03 Added new datalogger code for ground testing
2019-05-04 Added 2 files for ST_CAP
    [ST_Bottom.STL, ST_Cap.STL]
2019-05-11 Updated assembly with new layout
    [Linear_actuator.SLDPRT, NCS_V3.SLDASM, anchor_rod.SLDPRT, battery.SLDPRT, electronics.SLDPRT, keeper_assy_V3.SLDASM]
2019-05-16 New keeper ring layout for webbing passthrough
    [NCS_V3.SLDASM, anchor_rod.SLDPRT, keeper_assy_V3.SLDASM, keeper_ring_V3.SLDPRT, keeper_ring_slots.SLDDRW, motor_bracket_sheetmetal_V3.SLDPRT]
2019-05-19 added files, including chute data
    [ST_Bottom.SLDPRT, ST_Bottom.STL, ST_CAP_ASSEM.SLDASM, ST_CAP_ASSEMBLY.SLDASM, ST_Cap.SLDPRT, ST_Cap.STL]
2019-05-19 Changed ST CAP
    [ST_Bottom.SLDPRT, ST_Bottom.STL, ST_CAP_ASSEMBLY.SLDASM, ST_Cap.SLDPRT, ST_Cap.STL]
2019-05-22 add new 3 ring assembly
    [3-ring_assy_V1.SLDASM, H3840B_NO2_Ring.SLDPRT, H3860S_NO3_Ring.SLDPRT, H3880S_NO4_Ring.SLDPRT, grommet_V1.SLDPRT, grommet_assy.SLDASM, nylon_loop_V1.SLDPRT, webbing_base_V1.SLDPRT]
2019-05-23 added assembly V3.2 CAD
    [3-ring_assy_V1.SLDASM, 7880K450_HT-LOAD MTL GEAR--20 DEG PRESSURE ANGLE.SLDPRT, Assem3.2.SLDASM, BLDC_Gear_Motor_100rpm.SLDPRT, Cup_Chute_Drogue^ERS_v0.2.SLDPRT, Cylinder_Chute_Main^ERS_v0.3.SLDPRT, H3840B_NO2_Ring.SLDPRT, H3860S_NO3_Ring.SLDPRT]
2019-06-13 added final assembly V3.2
    [Cup_Chute_Drogue^ERS_v1.0.SLDPRT, Cup_Chute_Drogue^ERS_v1.0.STL, Cylinder_Chute_Main^ERS_v1.0.SLDPRT, Cylinder_Chute_Main^ERS_v1.0.STL, PIZZA_v3.1.SLDPRT, PIZZA_v3.1.STL]
2019-08-06 added parachute cups v3.0 & PIZZA Table v4
    [Assem3.2.SLDASM, Assem_Parachute_Cups.SLDASM, Cup_Chute_Drogue^ERS_v3.0.SLDPRT, Cup_Chute_Drogue^ERS_v3.0.STL, Cylinder_Chute_Main^ERS_v3.0.SLDPRT, Cylinder_Chute_Main^ERS_v3.0.STL, Nose_cone_whole.SLDPRT, PIZZA_v4.0.SLDPRT]
2019-08-14 updated trajectory simulation and new monte carlo analysis with some sample data for the impatient ones
    [best_data.csv, best_data_A.csv, best_data_B.csv, best_data_C.csv, neut_data.csv, neut_data_A.csv, neut_data_B.csv, neut_data_C.csv]
2019-09-17 Updated twist coupling to tighten up system
    [twist_coupling_V4.SLDPRT]
2019-09-17 Added drawing to submit to WPP for new twist coupling
    [twist_coupling_V3.SLDDRW, twist_coupling_V4.SLDDRW]
2019-09-18 Added pdf and step file fore machining
    [twist_coupling_V4.STEP]
2019-10-02 still need to document code but this is almost presentable
    [data_A.csv, data_B.csv, data_C.csv, succ_data.csv]
2019-10-14 got plots to work right, slight visual bug still, but not debilitating
    [best_data.csv, best_data_A.csv, best_data_B.csv, best_data_C.csv, neut_data.csv, neut_data_A.csv, neut_data_B.csv, neut_data_C.csv]
2019-11-09 added skirt to twist coupleing for machining and standoff legs for pizza table
    [standoff_nomount.SLDPRT, standoff_withmount.SLDPRT, twist_coupling_V3_skirt.SLDPRT, twist_coupling_skirt_noteeth.SLDPRT]
2019-11-11 fixed drawing files, added step files, removed standoffs w/o mount
    [7880K450_HT-LOAD MTL GEAR--20 DEG PRESSURE ANGLE.SLDPRT, standoff_withmount.SLDDRW, standoff_withmount.SLDPRT, standoff_withmount.STEP, twist_coupling_V4.SLDDRW, twist_coupling_V4.SLDPRT, twist_coupling_V4_skirt.SLDDRW, twist_coupling_V4_skirt.SLDPRT]
2019-11-19 Designed new motor housing, added revised spacer ring, organized parts to be machined and 3d printed
    [94414A108_ALLOY STL TORX DRIVE FLAT-HEAD SCKT CAP SCREW.SLDPRT, LinAct_Bracket_Back.SLDPRT, LinAct_Bracket_Back.STEP, LinAct_Bracket_Front.SLDPRT, LinAct_Bracket_Front.STEP, Motor Housing Assembly.SLDASM, MotorHousingClamshell.SLDPRT, MotorHousingClamshell.STEP]
2019-12-06 Remade pizza table, modified motor mount, craeted circuit board mock up an drawing, modified new motor gear and drawing
    [2662N400_PLASTIC GEAR - 20 DEGREE PRESSURE ANGLE.SLDPRT, 3-ring_assy_V1.SLDASM, 7880K450_HT-LOAD MTL GEAR--20 DEG PRESSURE ANGLE.SLDPRT, Assem3.2.SLDASM, Assem3.2rev1.SLDASM, BLDC_Gear_Motor_100rpm.SLDPRT, Cup_Chute_Drogue^ERS_v0.2.SLDPRT, Cylinder_Chute_Main^ERS_v0.3.SLDPRT]
2019-12-06 changed gear filename to MotorGear-rev2 and added .pdf of drawing
    [MotorGear-rev2.SLDPRT, motorgear-drawing.SLDDRW]
2019-12-07 updated linear actuator bracket, added STL files for Adam to print in ../cad/formachining/STLfiles
    [Assem3.2rev1.SLDASM, LinAct_Bracket_Back.SLDPRT, LinAct_Bracket_Back_rev1.SLDPRT, LinAct_Bracket_Back_rev1.STL, LinAct_Bracket_Front.SLDPRT, LinAct_Bracket_Front_rev1.SLDPRT, LinAct_Bracket_Front_rev1.STL, MotorHousingClamshellrev1.STL]
2019-12-18 adding EAGLE files for recovery board
    [BPR-301 Circuit.sch, LiPo Charger.sch, MotorControl.sch, RecoveryBoard.sch]
2019-12-18 updating lipo charging model
    [LiPo Charger.sch]
2019-12-18 adding files for sensors
    [BPR-301 Circuit.sch]
2019-12-18 wiring f0
    [LiPo Charger.sch]
2019-12-18 adding terminal block
    [RecoveryBoard.sch]
2019-12-18 added resistance for sensors
2019-12-19 handing off to dandrew
    [RecoveryBoard.sch]
2019-12-20 implementing David's suggestions
    [RecoveryBoard.sch]
2020-01-08 Removed old schematics, and drastically simplified overall system. See design review notes from today.
    [BPR-301 Circuit.sch, LiPo Charger.sch, MotorControl.sch, RecoveryBoard.sch]
2020-01-09 created LiPo Library
2020-01-09 updated gitignore finally working
    [RecoveryBoard.sch]
2020-01-09 updated board to include LiPo charger, and the changes discussed after first design review
    [RecoveryBoard.sch]
2020-01-10 updating STM32F0 pins
    [RecoveryBoard.sch]
2020-01-10 added buzzer
    [RecoveryBoard.sch]
2020-01-13 Fixed some power issues with Ben.
    [RecoveryBoard.sch]
2020-01-13 Microcontroller and sensor board cleanup; added more to the outside world.
    [RecoveryBoard.sch]
2020-01-13 board creation
    [RecoveryBoard.brd]
2020-01-13 adding board and second design review
2020-01-14 starting grouping board components for layout
    [RecoveryBoard.brd, RecoveryBoard.sch]
2020-01-15 beginning routing
    [RecoveryBoard.brd, RecoveryBoard.sch]
2020-01-15 edited circuit board dimensions to fit sensor leads
    [erspcb.DXF]
2020-01-15 Some fixes and polish.
    [RecoveryBoard.brd, RecoveryBoard.sch]
2020-01-15 OCD moving around to put things in the right places and right names.
    [RecoveryBoard-BOM.xlsx, RecoveryBoard.brd, RecoveryBoard.sch]
2020-01-15 OCD on package sizes 0603 for normal caps and resistors; 0805 for large caps, and larger yet for larger caps.
    [RecoveryBoard.brd, RecoveryBoard.sch]
2020-01-15 beginning routing and placement
    [RecoveryBoard.brd, RecoveryBoard.sch]
2020-01-15 finished routing
    [RecoveryBoard.brd, RecoveryBoard.sch]
2020-01-15 finished routing and added TODO list
    [RecoveryBoard.brd, RecoveryBoard.sch]
2020-01-16 More destruction on Ben's nice board. Good job Ben for putting up with Andrew.
    [RecoveryBoard.brd, RecoveryBoard.sch]
2020-01-16 edited board after design meeting on 1/15
    [RecoveryBoard.brd, RecoveryBoard.sch]
2020-01-22 adding new hbridge schematic
    [RecoveryBoard.brd, RecoveryBoard.sch]
2020-01-22 adding libraries to repo and notes from design review
    [RecoveryBoard.brd, RecoveryBoard.sch]
2020-01-22 implementing design changes from 1/21/2020
    [RecoveryBoard.brd, RecoveryBoard.sch]
2020-01-22 created BOM
    [RecoveryBoard.brd, RecoveryBoard.sch, RecoveryBoardBOM.csv]
2020-01-23 completed BOM except for a couple pin head connectors
    [RecoveryBoard.brd, RecoveryBoard.sch, RecoveryBoardBOM.csv]
2020-01-25 updated bom
    [RecoveryBoard-BOM.xlsx]
2020-01-25 creating digikey cart, but without pin connectors and jtag
    [RecoveryBoard-BOM.xlsx]
2020-01-25 finished bom without jtag and connectors
    [RecoveryBoard-BOM.xlsx, RecoveryBoard.brd, RecoveryBoard.sch]
2020-01-25 DRC after BOM update
    [RecoveryBoard.brd]
2020-01-26 found samtec connector for jtag; still need pin connectors
    [RecoveryBoard-BOM.xlsx]
